tabdallah/capstone/1_Planning/Receipts/2018-02-15_CSI_3D_Printing.JPG

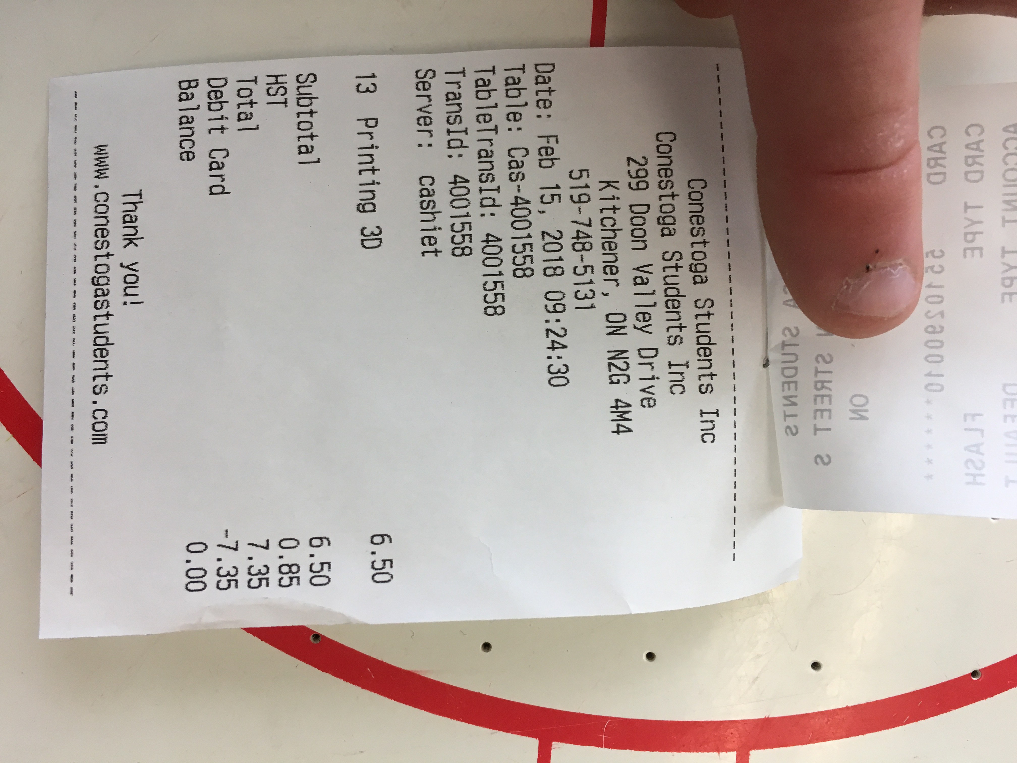
1_Planning/Receipts/2018-02-15_CSI_3D_Printing.JPG
