tabdallah/capstone/1_Planning/Receipts/2018-04-03_Sayal_Wiring_Terminals.JPG

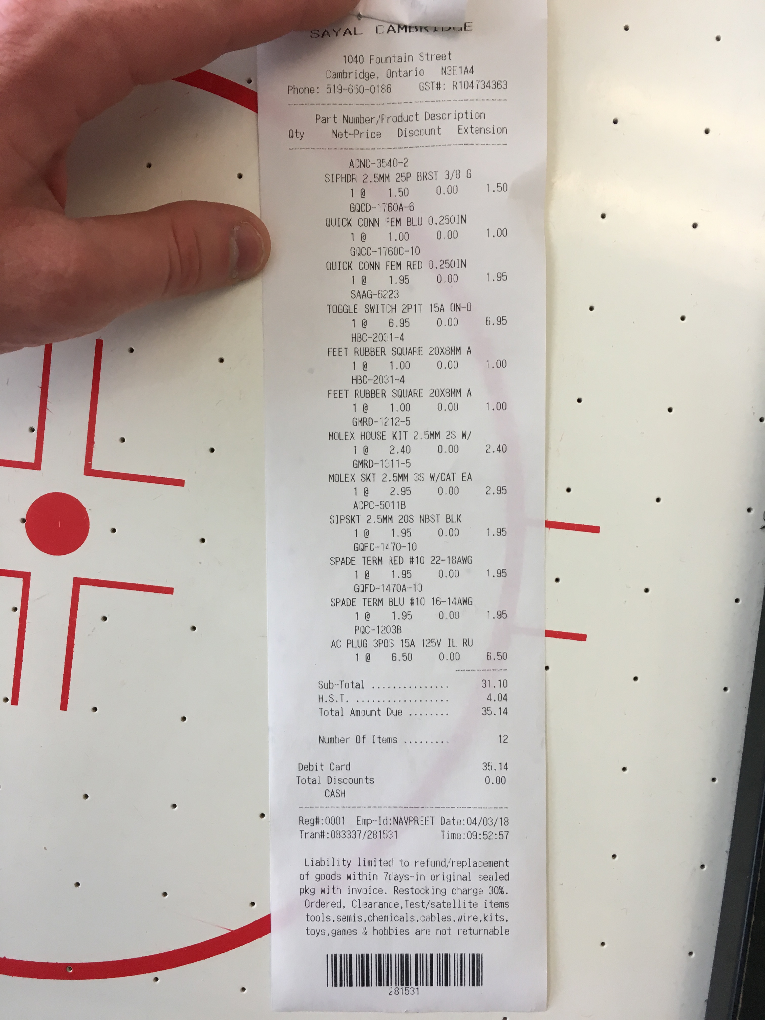
1_Planning/Receipts/2018-04-03_Sayal_Wiring_Terminals.JPG
