tabdallah/capstone/1_Planning/Week 30 Status Report.docx

Project Status Report – Week 30

2018-07-30

Project Name: ESE Capstone II Team Members: David Eelman, Stanislav Rashevskyi, Thomas Abdallah

Project Overall Status: Green

Status Overview:

Activity Title | Status (Last Week) | Status (This Week) | | Plan (Next Week)
| | Plan | Actual
Paddle Controller Prototyping Responsible: Thomas Due: Ongoing | Green | IR sensors installed. | IR sensors installed. | Install 24V-to-5V DCDC to replace 5V regulator
Puck Tracker Prototyping Responsible: David Due: Ongoing | Green | No activity planned | No activity | No activity planned
UI Prototyping Responsible: David Due: Ongoing | Yellow | Implement “Demo” for paddle controller. | Code cleanup | Implement “Demo” for paddle controller.
Master Controller Prototyping Responsible: Stan Due: Ongoing | Green | Refine new control strategies. | Refined new control strategies. | Code cleanup and full system testing.
