tabdallah/capstone/1_Planning/Week 26 Status Report.docx

Project Status Report – Week 26

2018-06-25

Project Name: ESE Capstone II Team Members: David Eelman, Stanislav Rashevskyi, Thomas Abdallah

Project Overall Status: Green

Status Overview:

Activity Title | Status (Last Week) | Status (This Week) | | Plan (Next Week)
| | Plan | Actual
Paddle Controller Prototyping Responsible: Thomas Due: Ongoing | Green | Finish PCB assembly Prototype motor control | Finished PCB assembly and prototyped motor control | Closed loop motor control
Puck Tracker Prototyping Responsible: David Due: Ongoing | Green | No activity planned | No activity | No activity planned
UI Prototyping Responsible: David Due: Ongoing | Green | Continue refinements to GUI “Goal Light” schematics & layout | Ordered mounting bracket for UI, completed goal light schematics, layout, and board soldered | Mount UI display, make second board for goal light
Master Controller Prototyping Responsible: Stan Due: Ongoing | Green | Finish supervisory control in the master controller | Almost finished supervisory control in the master controller | Error handling, PC communication
