tabdallah/capstone/1_Planning/Week 25 Status Report.docx

Project Status Report – Week 25

2018-06-18

Project Name: ESE Capstone II Team Members: David Eelman, Stanislav Rashevskyi, Thomas Abdallah

Project Overall Status: Green

Status Overview:

Activity Title | Status (Last Week) | Status (This Week) | | Plan (Next Week)
| | Plan | Actual
Paddle Controller Prototyping Responsible: Thomas Due: Ongoing | Yellow | Bring-up of PCB | One of each circuit tested | Finish PCB assembly Prototype motor control
Puck Tracker Prototyping Responsible: David Due: Ongoing | Green | Optimize calibration routine and mount fiducials | Optimized calibration routine | No activity planned
UI Prototyping Responsible: David Due: Ongoing | Green | Continue developing UI and investigated mounting solution for the touchscreen | Continued refinements to GUI Started “Goal Light” prototyping | Continue refinements to GUI “Goal Light” schematics & layout
Master Controller Prototyping Responsible: Stan Due: Ongoing | Yellow | Finish supervisory control in the master controller | Worked on supervisory control | Finish supervisory control in the master controller
