tabdallah/capstone/1_Planning/Week 20 Status Report.docx

Project Status Report – Week 20

2018-05-14

Project Name: ESE Capstone II Team Members: David Eelman, Stanislav Rashevskyi, Thomas Abdallah

Project Overall Status: Green

Status Overview:

Activity Title | Status (Last Week) | Status (This Week) | | Plan (Next Week)
| | Plan | Actual
Paddle Controller Prototyping Responsible: Thomas Due: Ongoing | Green | High power H-Bridge design. | Green | High power H-Bridge prototype spinning a motor. New encoder mounted.
Puck Tracker Prototyping Responsible: David Due: Ongoing | Green | No activity planned. | Green | No activity planned.
UI Prototyping Responsible: David Due: Ongoing | Green | Research touch screens. | Green | UI prototype bring-up.
Master Controller Prototyping Responsible: Stan Due: Ongoing | Green | Defense strategy implementation. | Green | Design state machines and error handling logic.
