tabdallah/capstone/1_Planning/Week 5 Status Report.docx

Project Status Report – Week 5

2018-02-16

Project Name: ESE Capstone I Team Members: David Eelman, Stanislav Rashevskyi, Thomas Abdallah

Project Overall Status: Green

Status Overview:

Activity Title | Status (Last Week) | Status (This Week) | | Plan (Next Week)
| | Plan | Actual
Specification and Plan Document Due: 2018-02-23 | Green | First draft of document complete. | Green | Final document complete.
Paddle Control Mechanical Prototyping Due: Ongoing Responsible: Thomas | Green | Start assembly | Yellow | All parts received. Assembly underway.
Puck Tracker Prototyping Due: Ongoing Responsible: All | Green | No activity planned | Green | No activity planned
