tabdallah/capstone/1_Planning/Semester 8 Capstone Final Presentation.pdf

# Capstone Project Final Presentation

# August 7, 2018 Electronic Systems Engineering (B.Eng) Conestoga College - Class of 2018

# Team

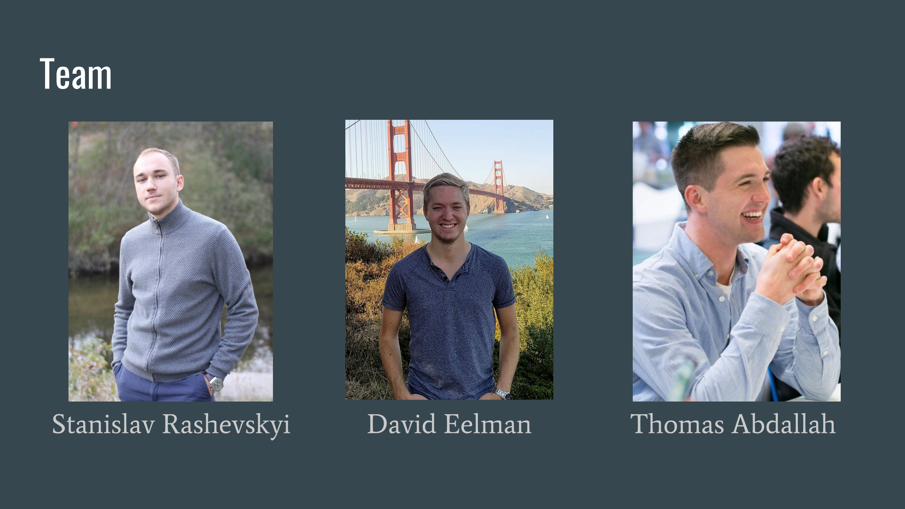
[picture p33: page 2]

Stanislav Rashevskyi | David Eelman | Thomas Abdallah

# Overview

# 1. Review Project Proposal 2. Project Status 3. Future Development 4. Demonstration

5. Q&A

# Project Proposal

# Project objective: Develop a robotic system capable of playing air hockey

against a human player.

# Air Hockey Robot Block Diagram - Proposal

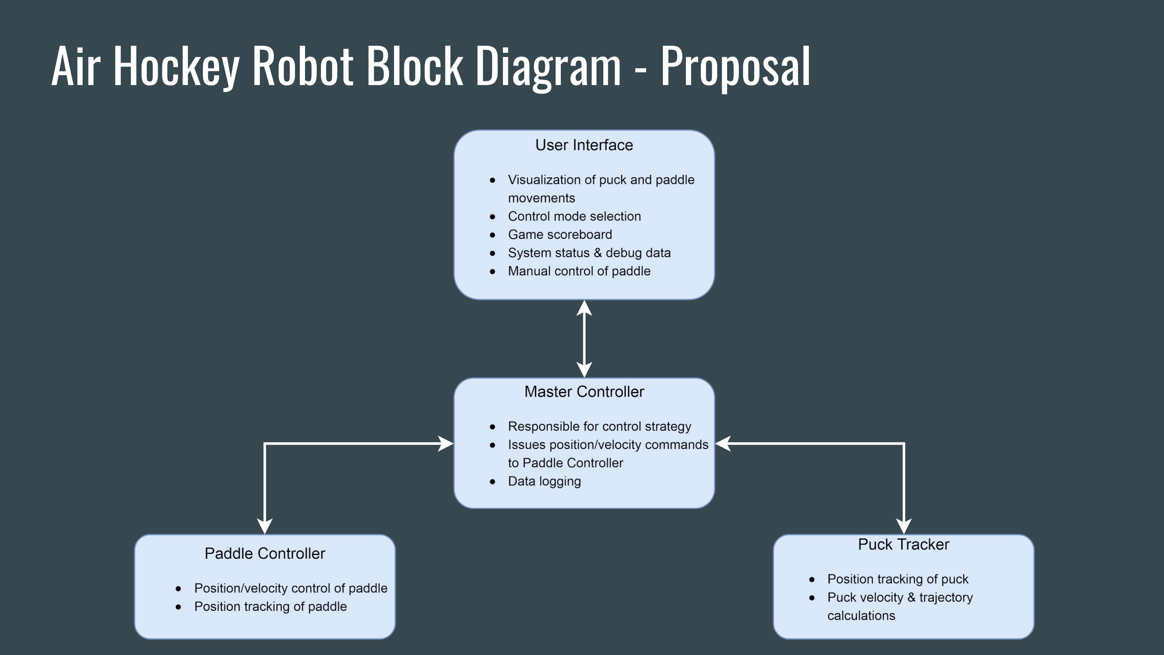
[picture p34: page 6]

# Project Plan

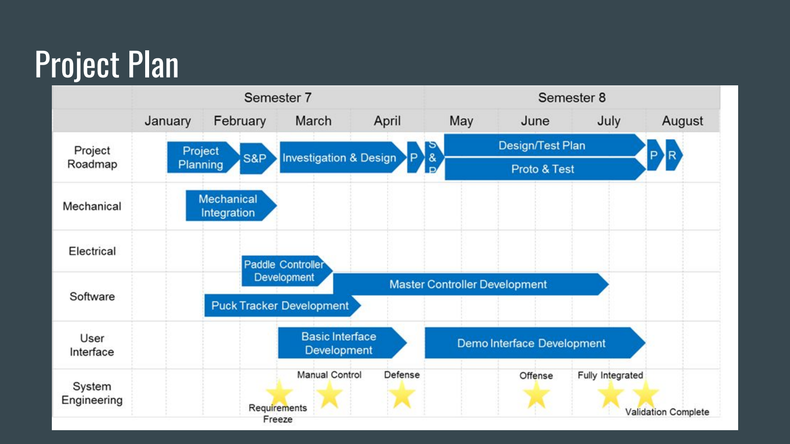
[picture p35: page 7]

# Project Status

# Project Status - Puck Tracker

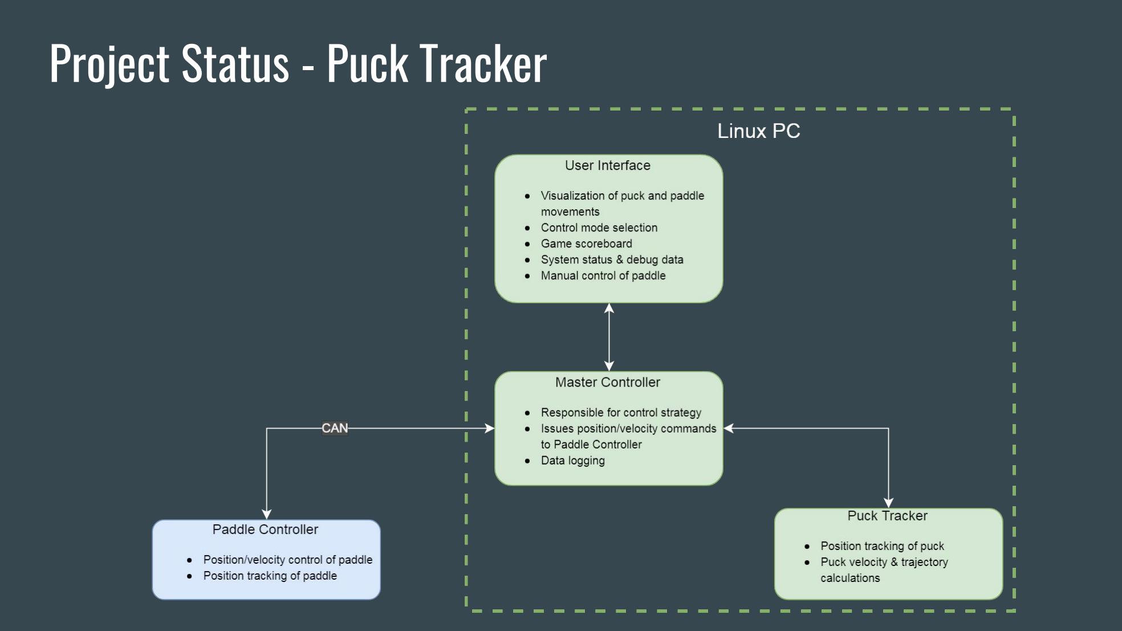
[picture p36: page 9]

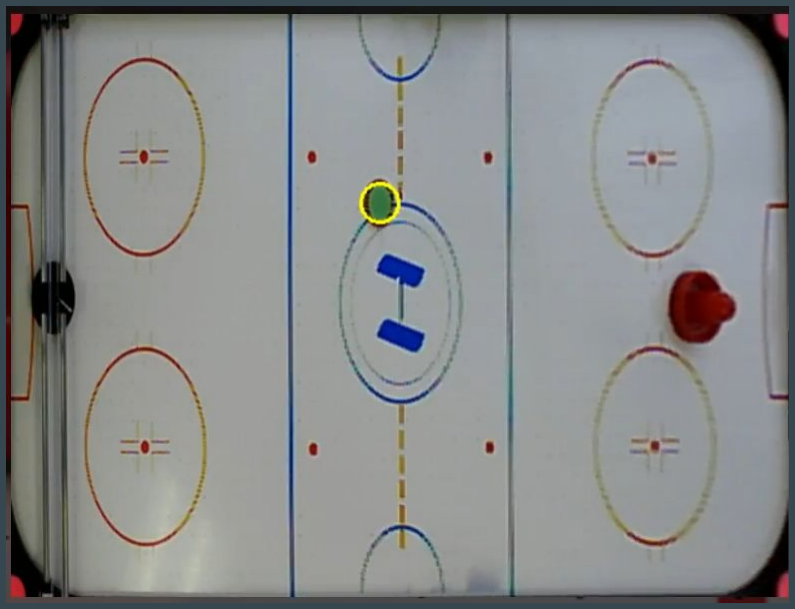
[picture p37: figure]

### - Vision based position tracking with OpenCV - Investigated alternatives (Magnets, Ultrasonic Sensors, etc.) - Key attributes for puck detection

- Color
- Area
- Radius

# Puck Tracker Implementation

# Puck Localization & Perspective Correction

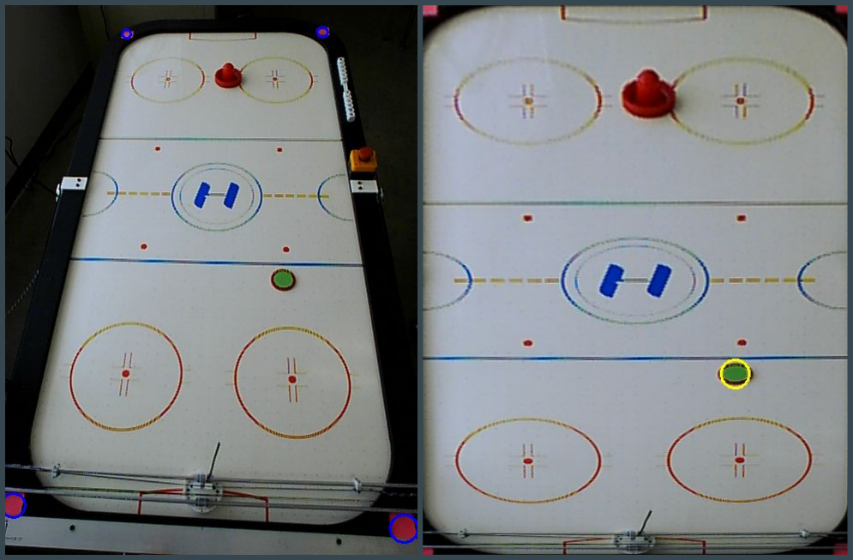
[picture p38: figure]

Goal

- Provide a “top down” view for consistent relative position detection
- Frame the playing surface

Methodology

- Identify 4 fiducials
- Calculate transformation matrix
- Warp image perspective
- Apply pixel to mm scaling factors for puck position
- Puck velocity = distance/time

# Adjusting for Varying Lighting Conditions

### - Ability to calibrate the computer vision system using UI sliders - Values saved to JSON file

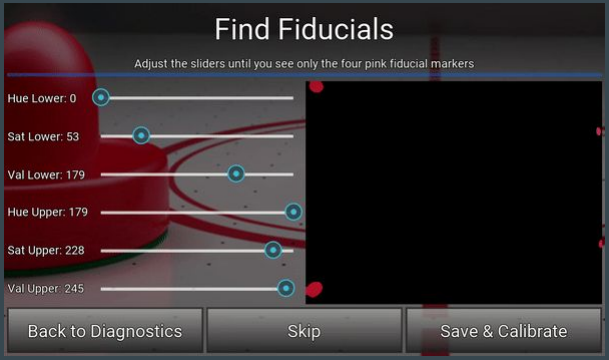
[picture p39: figure]

# Project Status - Paddle Controller

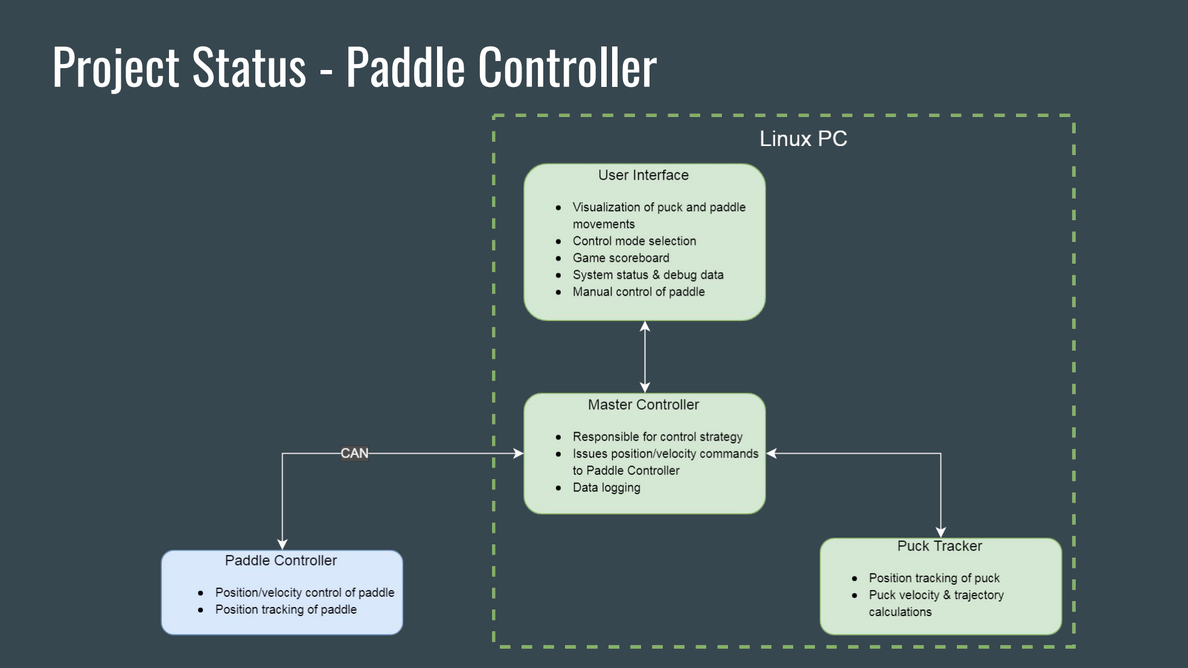
[picture p40: page 13]

# Paddle Controller High-Level Requirements

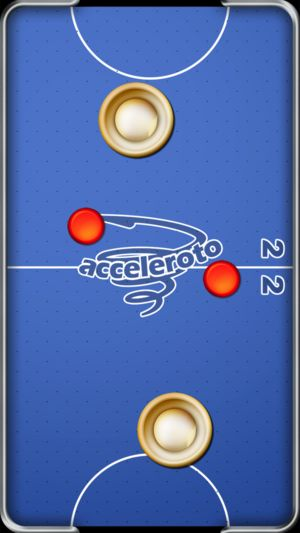
[picture p41: figure]

### 1. Accelerate the paddle to human-level speeds

### 2. Control paddle position to +/-5mm in two dimensions

### 3. Operate safely at high speeds in close proximity to humans

# System Modelling

### Step Response for High-Speed Prototype

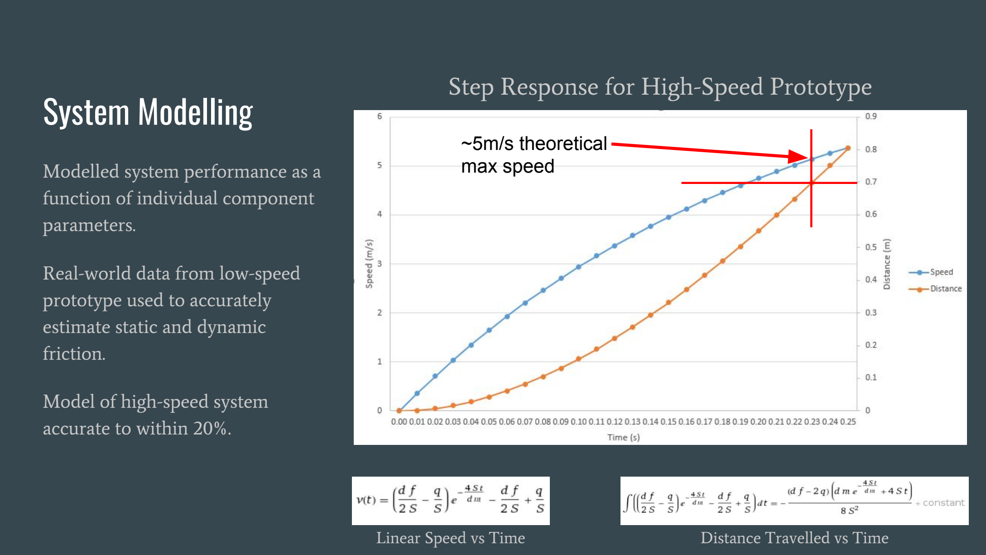
[picture p42: page 15]

Modelled system performance as a function of individual component parameters.

Real-world data from low-speed prototype used to accurately estimate static and dynamic friction.

Model of high-speed system accurate to within 20%.

Linear Speed vs Time | Distance Travelled vs Time

~5m/s theoretical
max speed

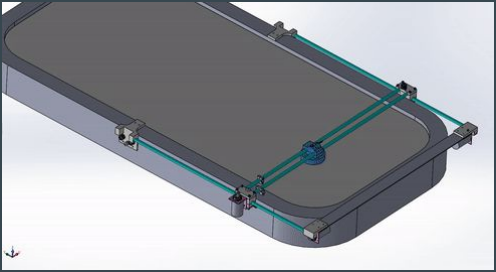
[picture p43: figure]

X-Axis Mechanism:

- 230W DC motor + encoder
- Linear rail + timing belt drive

Y-Axis Mechanism:

- 2 x 230W DC motors +
encoders
- Linear rail + timing belt drive
- Connecting rod to mechanically link left/right movement

# Mechanical Design

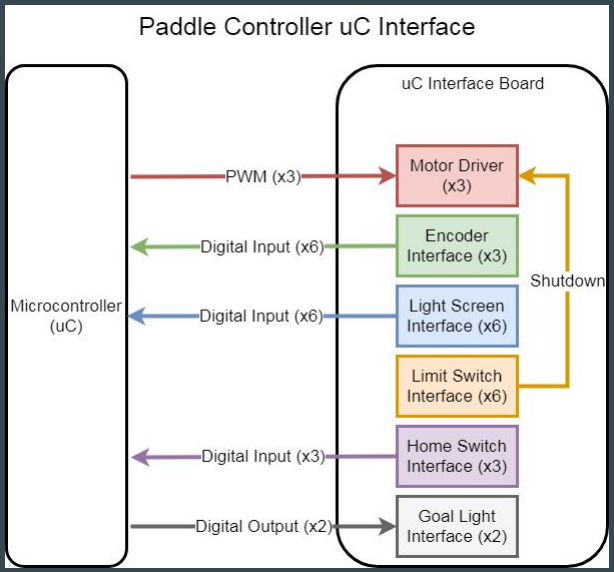
[picture p44: figure]

Off-the-shelf MicroController (HCS12)

- Communicates with Master Controller via CAN
- Closed-loop motor control with quadrature encoder feedback

Custom Circuit Board

- High-power motor drivers
- Sensor interfaces
- Hardware-based motor safety shutoff

# Electrical Design

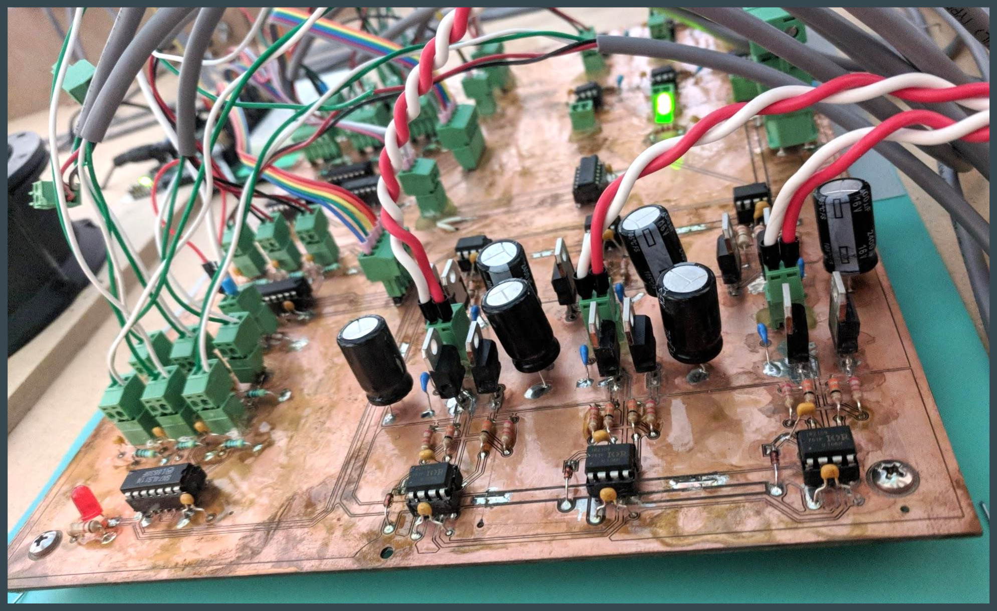
[picture p45: figure]

Off-the-shelf MicroController (HCS12)

- Communicates with Master Controller via CAN
- Closed-loop motor control with quadrature encoder feedback

Custom Circuit Board

- High-power motor drivers
- Sensor interfaces
- Hardware-based motor safety shutoff

# Electrical Design

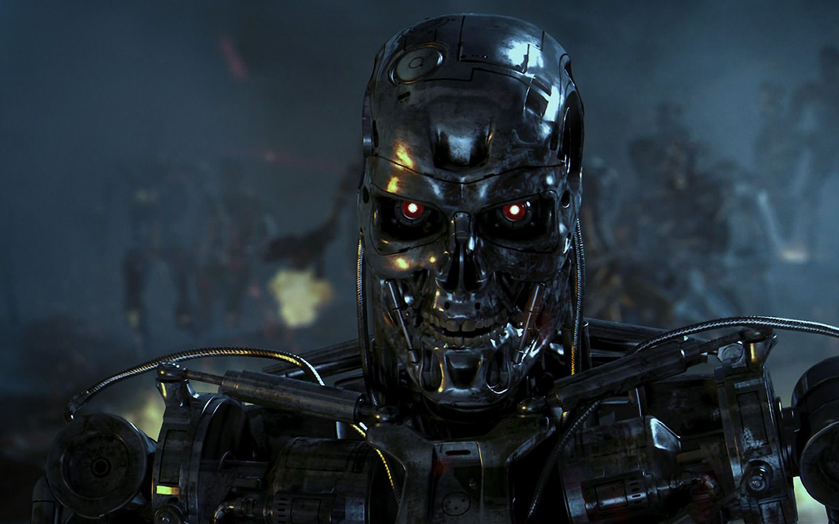
[picture p46: figure]

1. Software monitoring of motor torque
- Motors disabled if excessive resistance is detected
2. Light-screens surrounding robot
- Motors disabled if human enters robots playing area
3. Limit switches placed at end of robot travel
- Motors disabled in hardware if any limit switch pressed
4. Emergency-Stop mounted on human side of table
- Removes power to robot when pressed

# Safety Systems Design

# Implementation & Results

### Prototype constructed that meets

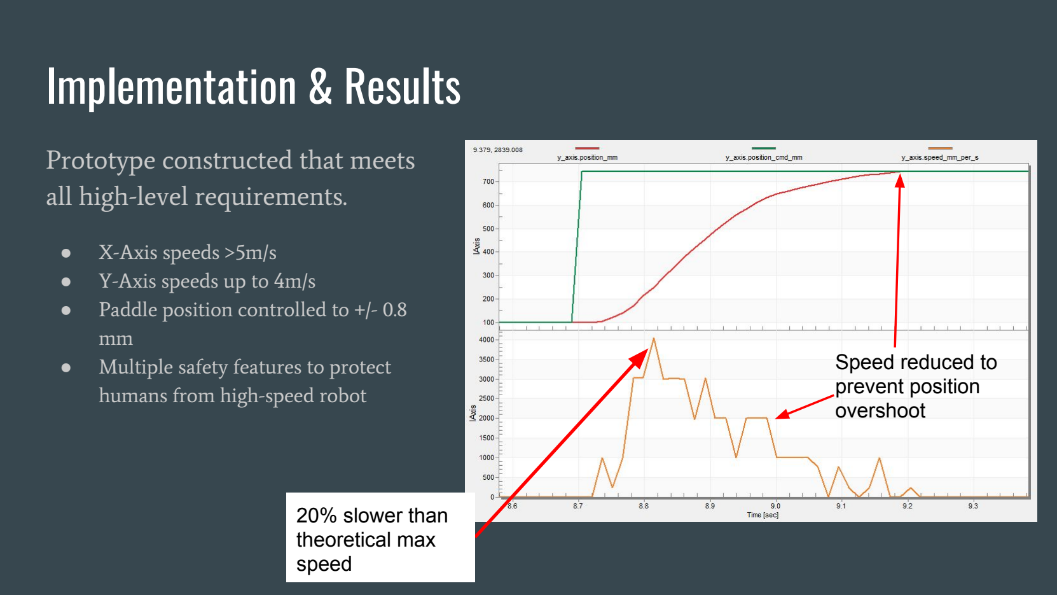
[picture p47: page 20]

all high-level requirements.

- X-Axis speeds >5m/s
- Y-Axis speeds up to 4m/s
- Paddle position controlled to +/- 0.8 mm
- Multiple safety features to protect humans from high-speed robot

20% slower than
theoretical max
speed

Speed reduced to
prevent position
overshoot

# Implementation & Results

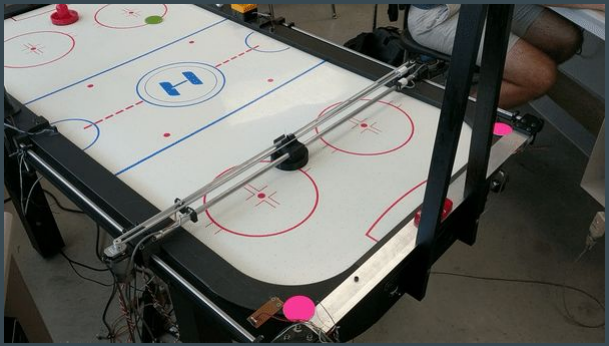
[picture p48: figure]

### Prototype constructed that meets

all high-level requirements.

- X-Axis speeds >5m/s
- Y-Axis speeds up to 4m/s
- Paddle position controlled to +/- 0.8 mm
- Multiple safety features to protect humans from high-speed robot

# Project Status - Master Controller

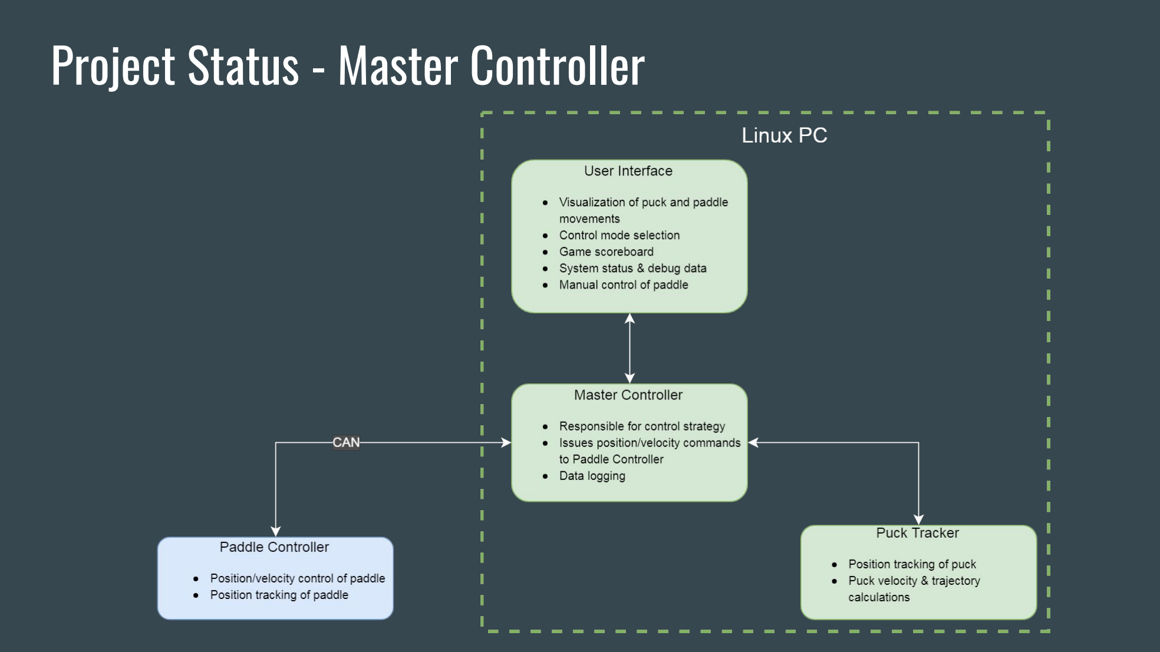
[picture p49: page 22]

# Master Controller Implementation

### - Central “brain” of the system

- Makes control decisions based on data from all other modules
- Issues movement commands to the robot

### - Multiple control strategies implemented

- User can select what strategy to play against

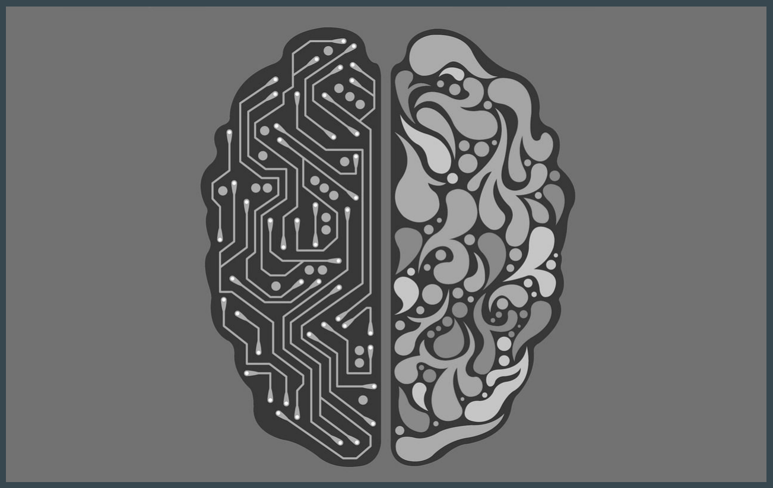
[picture p50: figure]

# Defense Control Strategy

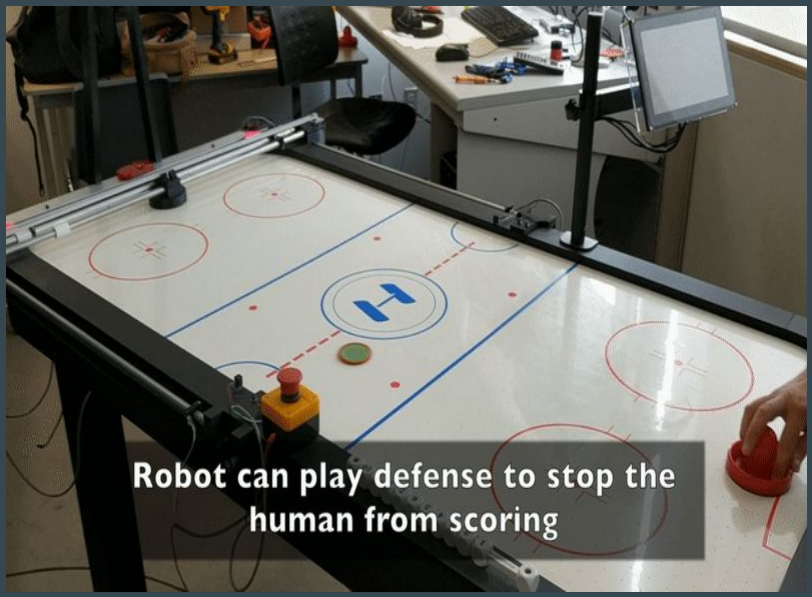
[picture p51: figure]

### - Objective: Do not let the human

score goals.

### - Puck trajectory calculated from position measurements

- Final position of puck predicted including bounces

### - Robot blocks puck at Y=0

- Returns puck to human if necessary

# Offense Control Strategy

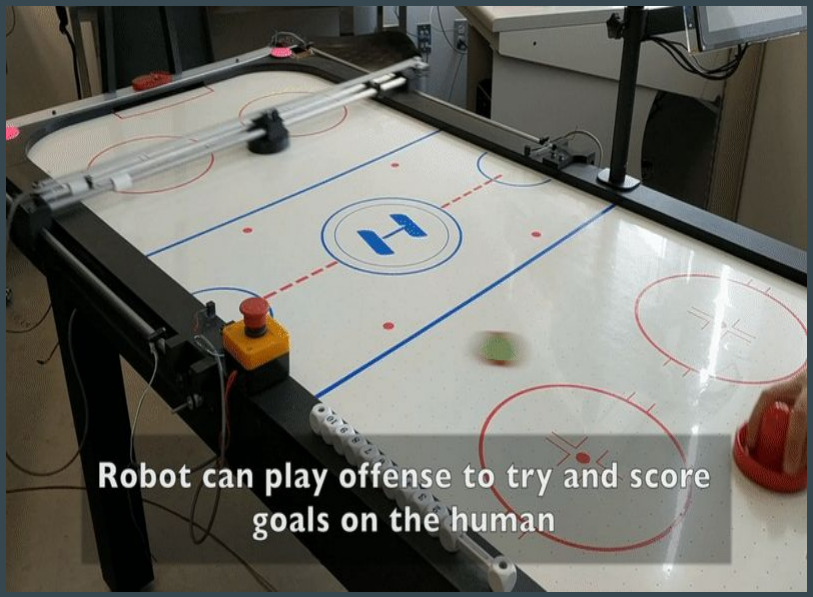
[picture p52: figure]

### - Objectives:

- Score goals on the human.
- Do not let the human score goals.

### - Robot attempts to hit the puck near the middle of the table

- Attempts to hit puck with max speed

### - Reverts to defensive movements if attack is not possible

# Master Controller Results

### - Robot can compete against human players - Robot is highly competent at defense

- Nearly impossible for humans to score when robot plays pure defense

### - Robot is capable of scoring goals

- More vulnerable on defense due to large distances travelled to attack puck

# Project Status - User Interface

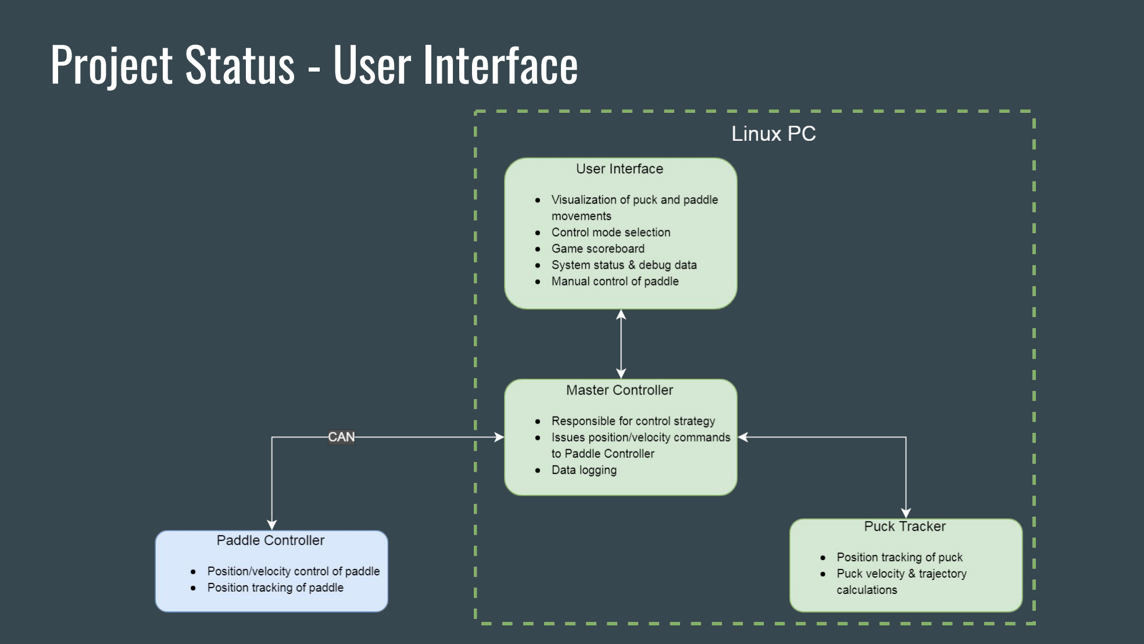
[picture p53: page 27]

# User Interface

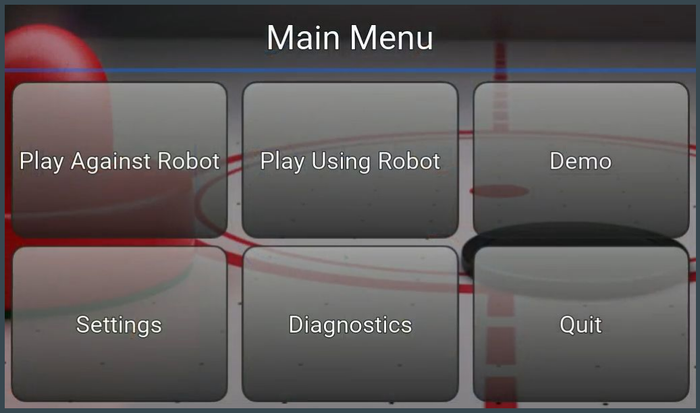
[picture p54: figure]

### - Kivy - Open source Python library - Implemented on 10.1” capacitive touchscreen - Provides user ability to:

- Control settings
- View system diagnostics
- Manually control robot
- Play against autonomous robot

# Visualizing the Robot

### - Provides a real time view of

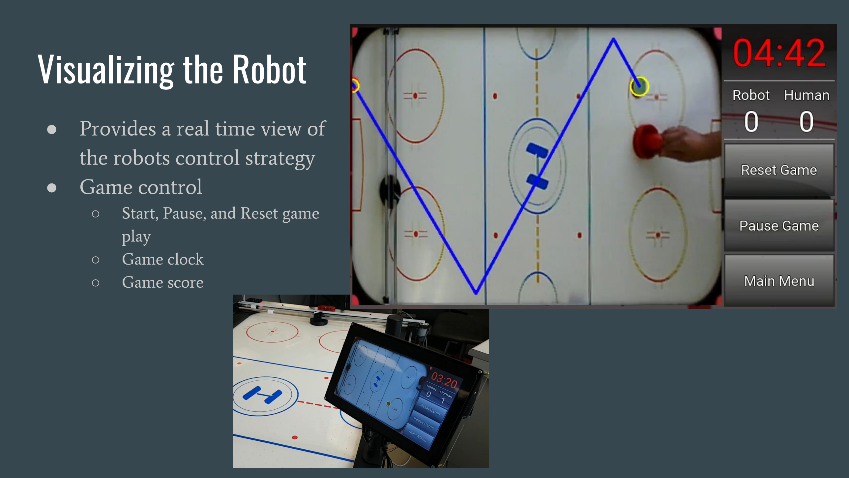
[picture p55: page 29]

### the robots control strategy - Game control

- Start, Pause, and Reset game play
- Game clock
- Game score

# Future Development

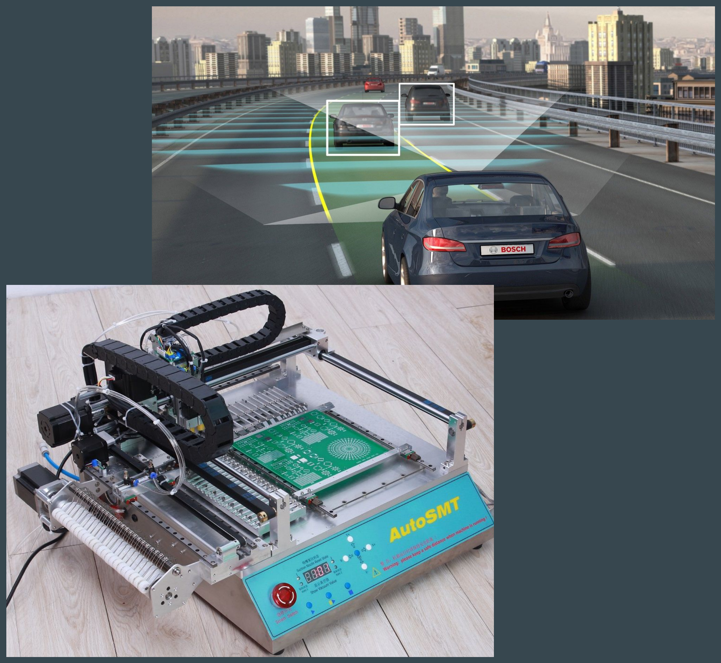
[picture p56: figure]

### - Autonomous vehicles

- Vision-based object detection and path prediction

### - Military defense

- Tracking and intercepting objects in motion

### - Advanced manufacturing

- High-speed position control
■ | Pick and place machines
■ | CNC machining
■ | 3D printing

# Future Development - Other Applications

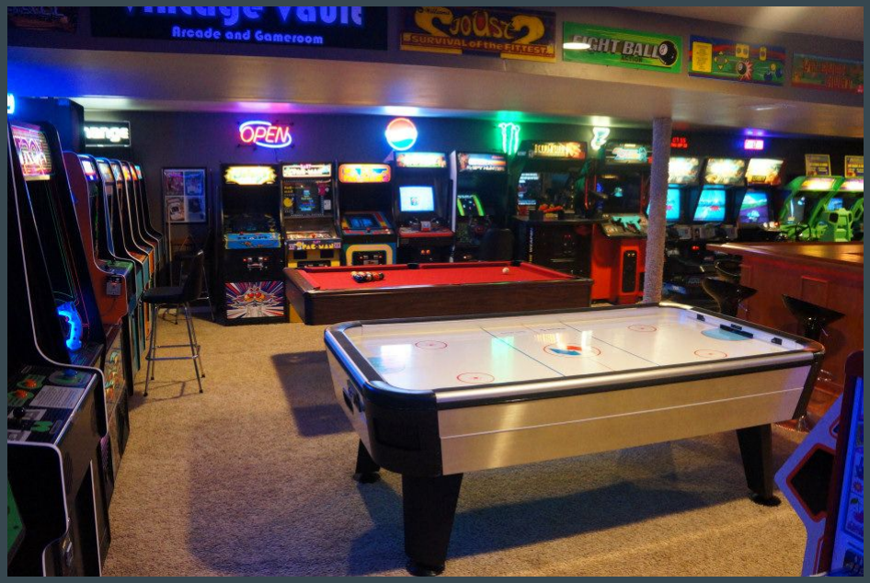
[picture p57: figure]

### - Prototype not designed for mass production

- Redesign needed reduce costs and further improve safety

### - Could be a popular game for arcades and bars

# Future Development - Air Hockey Robot

### Control strategy development:

# Future Development - AI

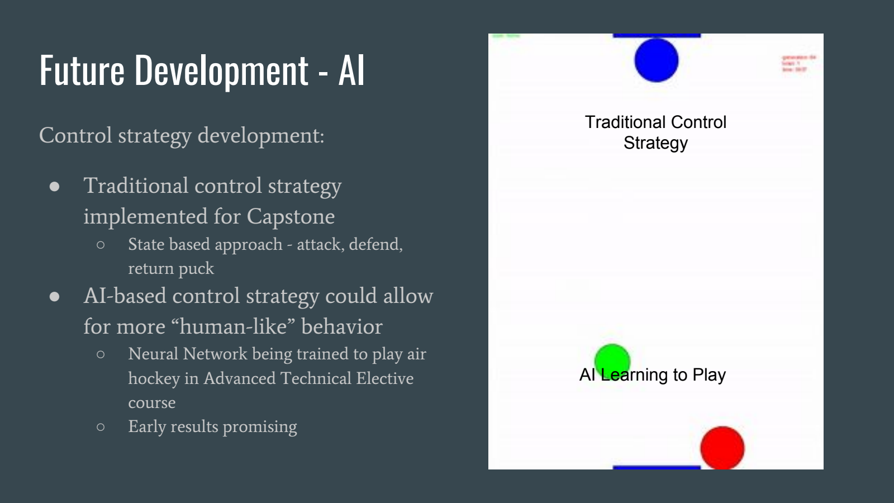
[picture p58: page 33]

### - Traditional control strategy implemented for Capstone

- State based approach - attack, defend, return puck

### - AI-based control strategy could allow for more “human-like” behavior

- Neural Network being trained to play air hockey in Advanced Technical Elective course
- Early results promising

Traditional Control
Strategy

AI Learning to Play

### Control strategy development:

# Future Development - AI

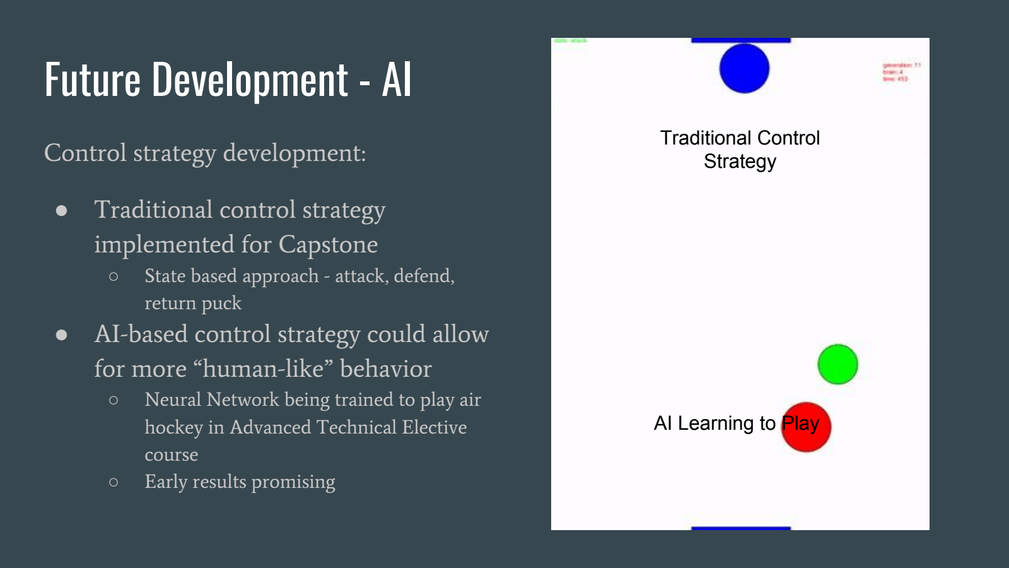
[picture p59: page 34]

### - Traditional control strategy implemented for Capstone

- State based approach - attack, defend, return puck

### - AI-based control strategy could allow for more “human-like” behavior

- Neural Network being trained to play air hockey in Advanced Technical Elective course
- Early results promising

Traditional Control
Strategy

AI Learning to Play

# Demonstration

# Project Demonstration Video

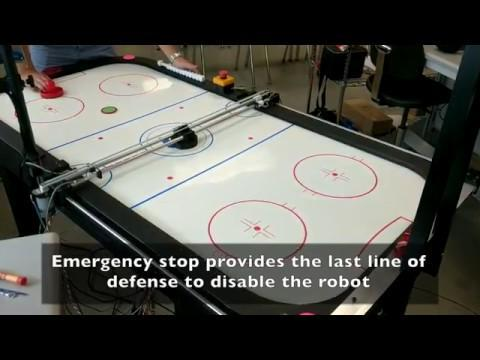
[picture p60: figure]

# Thank You!
