tabdallah/capstone/1_Planning/System_Interface_Design.xlsx

Sheet: Signal List
System Interface Design
PC = Paddle Controller |  | Note: MC receives all signals for logging purposes.
MC = Master Controller |  | All communication is routed through MC as a gateway. PC, PT, and UI do not directly communicate to each other.
PT = Puck Tracker
UI = User Interface
Signal | Transmitter | Receiver(s) | Comment
puck_position_mm_x | PT | MC, UI
puck_position_mm_y | PT | MC, UI
puck_velocity_mmps_x | PT | MC, UI
puck_velocity_mmps_y | PT | MC, UI
diagnostic_response | PT | MC, UI
pt_state_enum | PT | MC, UI
pt_error_enum | PT | MC, UI
signal_qualifier_placeholder | PT | MC, UI | i.e. confidence in signal accuracy
settings_placeholder | PT | MC, UI | Debug only
paddle_position_mm_x | PC | MC, UI
paddle_position_mm_y | PC | MC, UI
paddle_velocity_mmps_x | PC | MC, UI
paddle_velocity_mmps_y | PC | MC, UI
diagnostic_response | PC | MC, UI
motor_torque_units_x | PC | MC, UI | Debug only
motor_torque_units_y1 | PC | MC, UI | Debug only
motor_torque_units_y2 | PC | MC, UI | Debug only
limit_switch_state_x1 | PC | MC, UI | Debug only
limit_switch_state_x2 | PC | MC, UI | Debug only
limit_switch_state_y1 | PC | MC, UI | Debug only
limit_switch_state_y2 | PC | MC, UI | Debug only
limit_switch_state_y3 | PC | MC, UI | Debug only
limit_switch_state_y4 | PC | MC, UI | Debug only
light_screen_state_1 | PC | MC, UI | Debug only
light_screen_state_2 | PC | MC, UI | Debug only
light_screen_state_3 | PC | MC, UI | Debug only
light_screen_state_4 | PC | MC, UI | Debug only
pc_state_enum | PC | MC, UI
pc_error_enum | PC | MC, UI
settings_placeholder | PC | MC, UI | Debug only
manual_position_mm_x | UI | MC, PC | Direct position command to paddle controller
manual_position_mm_y | UI | MC, PC
control_mode_cmd_enum | UI | MC | Defense, offense, etc.
difficulty_cmd_enum | UI | MC | Easy, medium, hard.
diagnostic_request_pt | UI | MC, PT
diagnostic_request_pc | UI | MC, PC
diagnostic_request_mc | UI | MC
ui_state_enum | UI | MC
ui_error_enum | UI | MC
settings_placeholder | UI | MC | Debug only
mc_state_enum | MC | UI
mc_error_enum | MC | UI
settings_placeholder | MC | UI | Debug only
control_mode_enum | MC | UI | Defense, offense, etc.
difficulty_enum | MC | UI | Easy, medium, hard.
pc_state_cmd_enum | MC | PC
pt_state_cmd_enum | MC | PT
ui_state_cmd_enum | MC | UI
paddle_position_cmd_mm_x | MC | PC
paddle_position_cmd_mm_y | MC | PC
paddle_velocity_cmd_mmps_x | MC | PC
paddle_velocity_cmd_mmps_y | MC | PC

Sheet: CAN Messages
CAN Message Layout
Message Name | Transmitter | Receiver | Message ID (Hex) | DLC | Byte 7 |  |  |  |  |  |  |  | Byte 6 |  |  |  |  |  |  |  | Byte 5 |  |  |  |  |  |  |  | Byte 4 |  |  |  |  |  |  |  | Byte 3 |  |  |  |  |  |  |  | Byte 2 |  |  |  |  |  |  |  | Byte 1
 |  |  |  |  | 7 | 6 | 5 | 4 | 3 | 2 | 1 | 0 | 7 | 6 | 5 | 4 | 3 | 2 | 1 | 0 | 7 | 6 | 5 | 4 | 3 | 2 | 1 | 0 | 7 | 6 | 5 | 4 | 3 | 2 | 1 | 0 | 7 | 6 | 5 | 4 | 3 | 2 | 1 | 0 | 7 | 6 | 5 | 4 | 3 | 2 | 1 | 0 | 7 | 6 | 5 | 4 | 3 | 2 | 1
MC_Cmd_PC | MC | PC | 0x100 | 8 | mc_cmd_pc_debug |  |  |  |  |  |  |  | *(empty)* |  |  |  |  |  |  |  | state_cmd |  |  |  |  |  |  |  |  |  |  |  | motor_speed_cmd_y |  | motor_speed_cmd_x |  | pos_cmd_y_mm |  |  |  |  |  |  |  |  |  |  |  |  |  |  |  | pos_cmd_x_mm
PC_Status | PC | MC | 0x101 | 8 | pc_status_debug |  |  |  |  |  |  |  | error |  |  |  |  |  |  |  | state |  |  |  |  |  |  |  | goal_scored |  |  |  | motor_speed_y |  | motor_speed_x |  | pos_y_mm |  |  |  |  |  |  |  |  |  |  |  |  |  |  |  | pos_x_mm
 |  |  |  |  |  | NOTE: If you edit Messages/Signals here, make sure the changes match Enums in settings.JSON file \capstone\6_User_Interface\1_Software\4_Json\settings.json

Sheet: MC_Cmd_PC Signals
MC_Cmd_PC - Signal Descriptions
Signal Name | Length (Bits) | Values | Description
pos_cmd_x_mm | 16 | 0 to 65536 | MC signal that commands PC to change X-axis paddle position in mm
pos_cmd_x_mm | 16 | 0 to 65536 | MC signal that commands PC to change Y-axis paddle position in mm
motor_speed_cmd_x | 2 | 0 = Slow 1 = Medium 2 = Fast | MC signal that commands PC to change X-axis motor speed
motor_speed_cmd_y | 2 | 0 = Slow 1 = Medium 2 = Fast | MC signal that commands PC to change Y-axis motor speed
state_cmd | 4 | 0 = OFF 1 = Calibration 2 = ON 3 = Clear_Error | MC signal that commands PC to change state
NOTE: If you edit Messages/Signals here, make sure the changes match Enums in settings.JSON file \capstone\6_User_Interface\1_Software\4_Json\settings.json

Sheet: PC_Status Signals
PC_Status - Signal Descriptions
Signal Name | Length (Bits) | Values | Description
pos_x_mm | 16 | 0 to 65536 | PC signal with current X-axis paddle position in mm
pos_y_mm | 16 | 0 to 65536 | PC signal with current Y-axis paddle position in mm
motor_speed_x | 2 | 0 = Slow 1 = Medium 2 = Fast | PC signal with current X-axis motor speed
motor_speed_y | 2 | 0 = Slow 1 = Medium 2 = Fast | PC signal with current PC Y-axis motor speed
goal_scored | 4 | 0 = None 1 = Human scored 2 = Robot scored | PC signal describing who scored the goal
state | 4 | 0 = OFF 1 = Calibration 2 = ON 3 = Error | PC signal with its current state
error | 4 | 0 = none 1 = … | PC signal with its current error (if any)
NOTE: If you edit Messages/Signals here, make sure the changes match Enums in settings.JSON file \capstone\6_User_Interface\1_Software\4_Json\settings.json
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
