tabdallah/capstone/5_Master_Controller/2_Reference_Material/Shared_CAN_Protocol_Proposal.xlsx

Sheet: Network Nodes
Shared CAN Protocol - Network Nodes
ECU Name | Acronym | Functions
Supervisory Controller | SC | 1. Process messages from all nodes. 2. Command EC to move car to specific floor.
Elevator Controller | EC | 1. Process command from SC & move car to specific floor. 2. Report current car position to all nodes.
Car Controller | CC | 1. Report state of elevator car door. 2. Report requested floor from elevator car. 3. Display current elevator position.
Floor 1 Controller | F1 | 1. Request elevator car. 2. Display current elevator position.
Floor 2 Controller | F2 | 1. Request elevator car. 2. Display current elevator position.
Floor 3 Controller | F3 | 1. Request elevator car. 2. Display current elevator position.

Sheet: Message Layout
Shared CAN Protocol - Message Layout
Message Name | Transmitter | Receiver(s) | Message ID (Hex) | DLC
SC_Cmd_To_EC | SC | EC | 0x100 | 1
EC_Status | EC | All | 0x101 | 1
CC_Status | CC | SC | 0x200 | 1
F1_Status | F1 | SC | 0x201 | 1
F2_Status | F2 | SC | 0x202 | 1
F3_Status | F3 | SC | 0x203 | 1

Sheet: Signal Descriptions
Shared CAN Protocol - Signal Descriptions |  |  |  | Convention: All signal names start with the Transmitting node's acronymn.
Signal Name | # of Bits | Value Descriptions | Comment
SC_Enable | 1 | 0 = Disable Elevator 1 = Enable Elevator | SC command to enable/disable elevator.
SC_Floor_Cmd | 2 | 0 = Request None 1 = Request Floor 1 2 = Request Floor 2 3 = Request Floor 3 | SC command to EC for requested floor. Always init to 0 so elevator doesn't start moving right away.
EC_Status | 1 | 0 = Disable Elevator 1 = Enable Elevator | EC reporting to SC it's state (enabled/disabled).
EC_Car_Pos | 2 | 0 = Car is moving 1 = Floor 1 2 = Floor 2 3 = Floor 3 | EC reporting to all modules the current location of the elevator car.
CC_Door_State | 1 | 0 = Door Open 1 = Door Closed | CC reporting state of the elevator car door to the SC.
CC_Floor_Req | 2 | 0 = Request None 1 = Request Floor 1 2 = Request Floor 2 3 = Request Floor 3 | CC request to SC for desired floor.
F1_Call_Req | 1 | 0 = Door Open 1 = Request Car | Floor 1 requesting the elevator car.
F2_Call_Req | 1 | 0 = Door Open 1 = Request Car | Floor 2 requesting the elevator car.
F3_Call_Req | 1 | 0 = Door Open 1 = Request Car | Floor 3 requesting the elevator car.
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
