tabdallah/capstone/1_Planning/Week 29 Status Report.docx

Project Status Report – Week 29

2018-07-23

Project Name: ESE Capstone II Team Members: David Eelman, Stanislav Rashevskyi, Thomas Abdallah

Project Overall Status: Green

Status Overview:

Activity Title | Status (Last Week) | Status (This Week) | | Plan (Next Week)
| | Plan | Actual
Paddle Controller Prototyping Responsible: Thomas Due: Ongoing | Green | Upgraded mechanical design. IR sensors installed. | Upgraded mechanical design. Implemented new paddle control method. | IR sensors installed.
Puck Tracker Prototyping Responsible: David Due: Ongoing | Green | No activity planned | No activity | No activity planned
UI Prototyping Responsible: David Due: Ongoing | Green | Implement “Demo” for paddle controller. Work on UI robustness. Install goal lights. | Improved UI code | Implement “Demo” for paddle controller.
Master Controller Prototyping Responsible: Stan Due: Ongoing | Green | Improve offense control strategy | New offense & defense control strategies implemented | Refine new control strategies.
