tabdallah/capstone/7_Not_Capstone/Engineering Economics Course Project.pdf

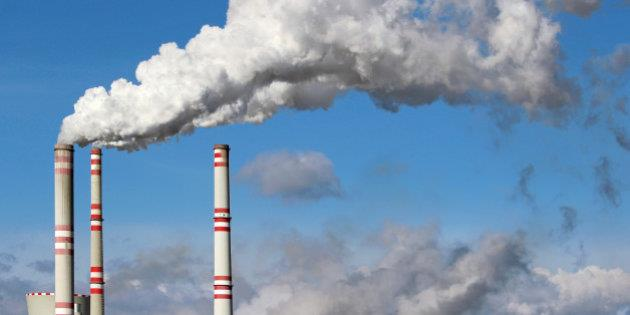
[picture p85: figure]

# Engineering Economics Course Project

### CARBON TAXES TO MINIMIZE CO2 EMISSIONS IN A MICRO-GRID

Prepared for ECON74000, Winter 2018 David Eelman (6365316)
Stanislav Rashevskyi (7028178) Thomas Abdallah (7141518)

ECON74000 Course Project | Eelman, Rashevskyi, Abdallah

## Contents

## Introduction

This report will identify the best energy production option and associated carbon

tax price to incent the adoption of renewable energy sources and minimize the use of

diesel fuel generation in a micro-grid application for a remote Northern Ontario

community. The analysis will consider four energy production options (Table 1) that

could be purchased and become operational in 2019. These options include a mix of wind,

solar, and diesel energy production. The analysis for this project will consider the present

worth, the incremental internal rate of return, and the equivalent annual cost for each

energy production option. A tax (dollar per kilogram of CO2 emissions) will be proposed

that shall minimize diesel fuel generation and increase the feasibility of the options that

include renewable energy sources. The same analysis will be performed using the tax rules

of the United Kingdom to provide comparison on the feasibility of the project in that

country.

Table 1 - Generation Options

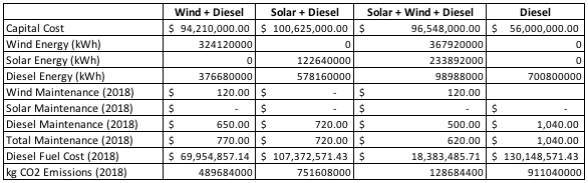
[picture p86: figure]

## Problem Statement

This report will determine an appropriate CO2 tax to be applied that will minimize

the use of diesel fuel generation in a theoretical micro-grid application in Northern

Ontario and compare the feasibility of this project to the same project if it were

undertaken in the United Kingdom.

Assumptions

1. Yearly maintenance cost increase is 5% of the previous year’s maintenance cost.
2. Yearly CO2 emissions increase is 2% of the previous year’s CO2 emissions.
3. Yearly diesel fuel cost increase is 2% of the previous year’s diesel fuel cost.
4. No tax credits or other government incentives for any generation option.
5. 100% utilization rate for all generation options, i.e. running at maximum power

output 24 hours a day, 365 days a year.

6. Same cost of financing for all generation options.

## Economic Analysis

Levelized Cost of Energy (LCOE)

The concept of LCOE represents the total cost per unit of energy of constructing

and operating a power plant over its lifetime (U.S. Energy Information Administration,

2018). LCOE provides a convenient mechanism for comparing the competitiveness of

different generation technologies. In this report we only consider the capital costs, fuel

costs, and maintenance costs when evaluating each generation option, although a full

LCOE analysis would include the cost of financing, operation, and utilization rates for

each generation option.

Present Worth Analysis

The present worth of each option from Table 1 was conducted utilizing the

corporate tax rate in Canada of 36.1% (Pearson Canada, Inc., 2017), a before-tax MARR of

20%, and a Capital Cost Allowance (CCA) of 20% (Class 8). After-tax MARR is calculated

to be 12.78% as shown below.

MARRafter−tax = MARRbefore−tax ∗ (1 − tax rate) = 20% ∗ (1 − 0.361) = 12.78%

The Capital Tax Factor (CTF) is calculated as shown below.

CTF = 1 −

(tax rate) ∗ (CCA) ∗ (1 +

MARRafter−tax
2

)

(MARRafter−tax + CCA) ∗ (1 + MARRafter−tax)

= 0.792

The present worth of the capital cost for each generation option is calculated as follows.

Present WortℎCapital Cost = CTF ∗ Capital Cost

Table 2 - Present worth of capital cost

The present worth for all annuities associated with each generation option are

calculated as follows. Table 3 shows the present worth of all annuities over a 20 year

period for each option. Appendix A shows the Excel calculations used to generate these

values.

Present WortℎAnnuities = (Income − Expenses) ∗ (1 − tax rate) ∗ (

P
F

, MARRafter−tax, 20)

| Wind + Diesel | Solar + Diesel | Solar + Wind + Diesel | Diesel
Capital Cost | $ (94,210,000.00) | $ (100,625,000.00) | $ (96,548,000.00) | $ (56,000,000.00)
CTF | 0.792 | 0.792 | 0.792 | 0.792
Present Worth | $ (74,614,320.00) | $ (79,695,000.00) | $ (76,466,016.00) | $ (44,352,000.00)

Table 3 - Present worth of annuities

The total present worth for each option is sum of the present worth of the

annuities and the present worth of the capital cost. Table 4 shows the total present worth

after taxes for each option with no carbon tax implemented.

Table 4 - Total Present Worth

The Wind + Solar + Diesel option as the highest total present worth even without

the inclusion of a carbon tax. When applying a carbon tax, the present worth of all

projects is reduced, but the Wind + Solar + Diesel project is still the most valuable.

Therefore, based on the present worth analysis no carbon tax is needed to incent the

adoption of a renewable energy project.

| Wind + Diesel | Solar + Diesel | Solar + Wind + Diesel | Diesel
Annuities Present Worth | $ 1,209,514,970.74 | $ 1,017,455,033.24 | $ 1,474,225,034.77 | $ 900,559,788.91

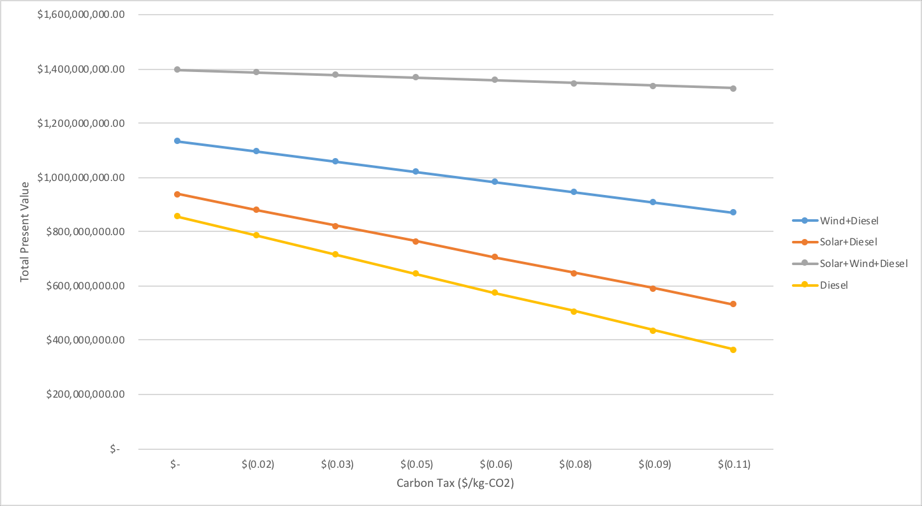
[picture p87: figure]

Figure 1 - Present Value vs Carbon Tax Rate

If we consider the same analysis conducted in the United Kingdom with a tax rate

of 28% (after-tax MARR of 14.4%) and using straight-line depreciation to determine the

tax savings on the capital investment we see the same results with no carbon tax being

required.

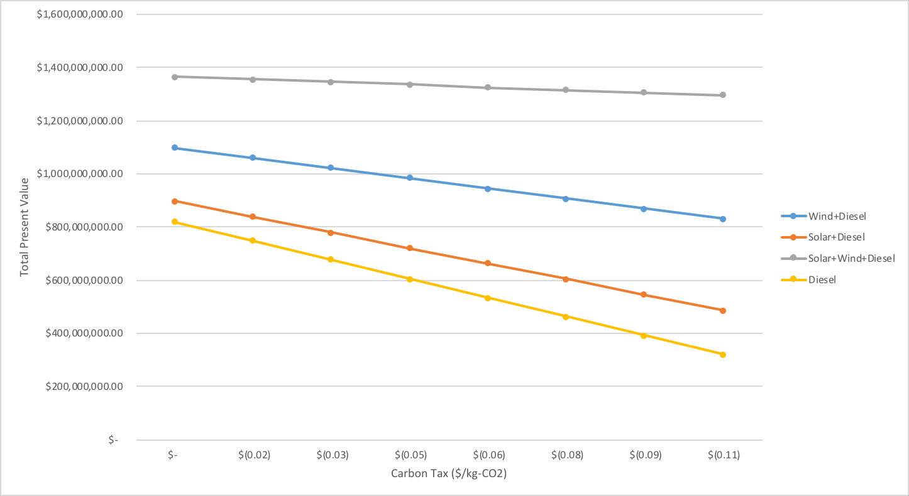
[picture p88: figure]

Figure 2 - Present Value versus Carbon Tax Rate in the United Kingdom

Incremental Internal Rate of Return Analysis

Analysis begins by calculating the incremental cash flows for each option without

a carbon tax implemented (Appendix B). The Diesel only option is selected to begin with

as it has the lowest capital cost. The option with the next lowest capital cost is Wind +

Diesel generation. The incremental IRR for this option over Diesel only is 200.9% which is

greater than the after-tax MARR so this option is chosen. The option with the next lowest

capital cost is Wind + Solar + Diesel generation. The incremental IRR for this option over

Wind + Diesel is $2787.10 which is much greater than the after-tax MARR so this option is chosen. The incremental cash flows for Solar + Diesel over Wind + Solar + Diesel are all

negative so this option is rejected. Therefore, by the incremental IRR method the Wind +

Solar + Diesel generation option should be selected and no carbon tax is necessary.

If we consider the same analysis conducted in the United Kingdom with a tax rate

of 28% (after-tax MARR of 14.4%) and using straight-line depreciation to determine the

tax savings on the capital investment we also find that no carbon tax is necessary to incent

the adoption of renewable generation options as the Wind + Solar + Diesel option is

chosen through the incremental IRR method with no carbon tax applied.

Equivalent Annual Cost Analysis

The equivalent annual cost (EAC) of each option from Table 1 was conducted

before-tax, with a MARR of 20%, for a 20-year period, including all assumptions stated

above in the Assumptions section of the report.

The general formula for EAC calculation is shown below.

EACtotal = EACcapital cost + EACmaintnance + EACdiesel cost + EACCO2 tax cost,

where:

EACcapital cost = Capital cost ∗ (A\P, MARR, 20)

EACmaintnance = Total maintnance + maintnance raise ∗ (A\G, MARR, 20)

EACdiesel cost = Diesel cost ∗ (P\A, diesel inflation, MARR, 20) ∗ (A\P, MARR, 20)

EACCO2 tax cost = CO2 tax cost ∗ (P\A, CO2 output raise, MARR, 20) ∗ (A\P, MARR, 20)

Table 5 shows the EAC results before taxes for each option with none and 0.20

$/kg of carbon tax. Appendix B shows the Excel calculations used to generate these values.

Table 5 - EAC calculations for each option

The Wind + Solar + Diesel option has the lowest equivalent annual cost even without the

inclusion of a carbon tax. When applying a carbon tax, the EACs of all projects is

increased, but the Wind + Solar + Diesel project is still the most valuable. Therefore,

based on the EAC analysis no carbon tax is needed to incent the adoption of a renewable

energy project.

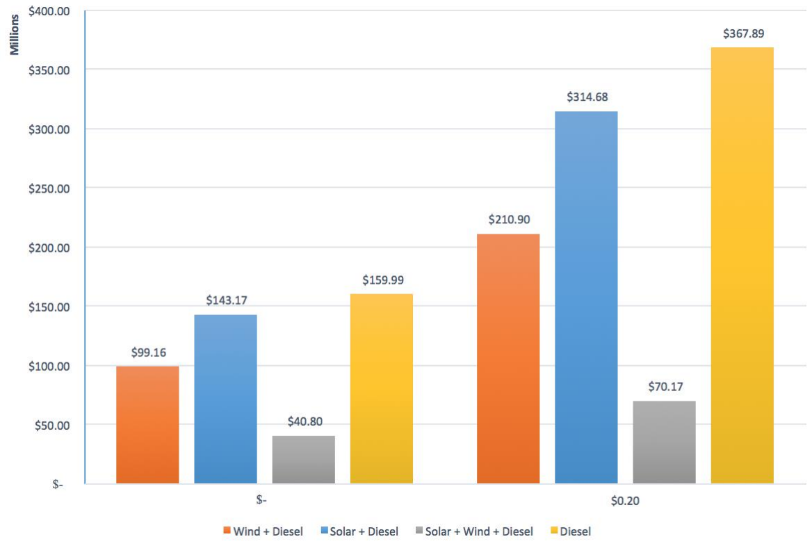
[picture p89: figure]

Figure 3 - EACs vs Carbon Tax

Factors Missing From Analysis

This analysis does not consider any government incentives for renewable projects

such as tax credits for renewable projects or discounted financing options which could

help to reduce the cost of the proposed carbon tax. This analysis only considers the

maintenance and fuel costs for each plant type but does not account for any other

operating costs which may impact the total cost of each plant. This analysis only

considers carbon produced during the operation of each plant type and does not account

for the carbon produced when manufacturing the plant.

## Recommendations & Conclusion

In conclusion, based on our analysis no carbon tax is necessary to incent the

adoption of renewable generation options for this project. Our assumptions of a 100%

utilization rate and no other government incentives simplify the analysis but may not be

representative of the conditions experienced during actual implementation.

## Appendix A – Present Worth Analysis Calculations

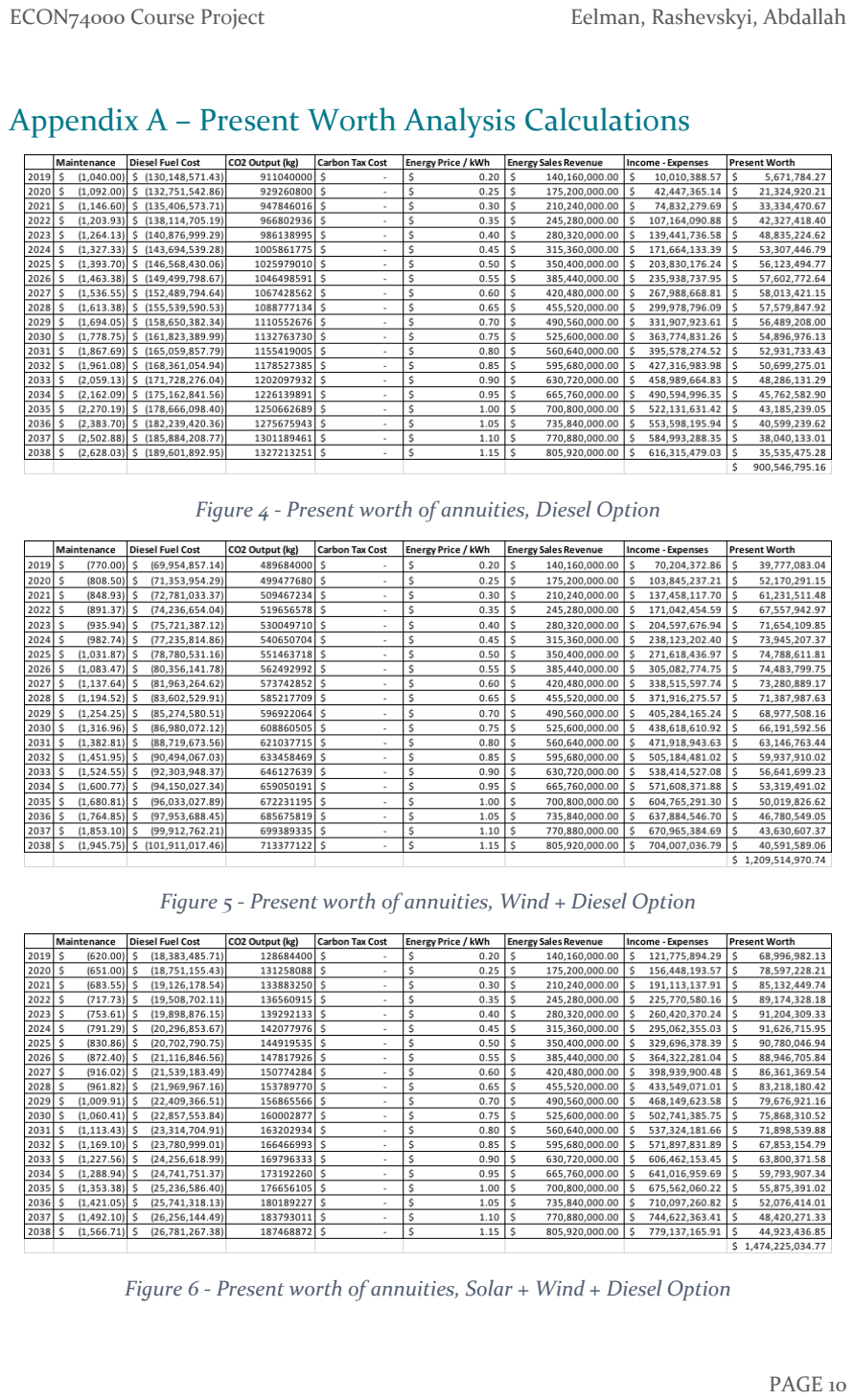
[picture p90: page 11]

Figure 4 - Present worth of annuities, Diesel Option

Figure 5 - Present worth of annuities, Wind + Diesel Option

Figure 6 - Present worth of annuities, Solar + Wind + Diesel Option

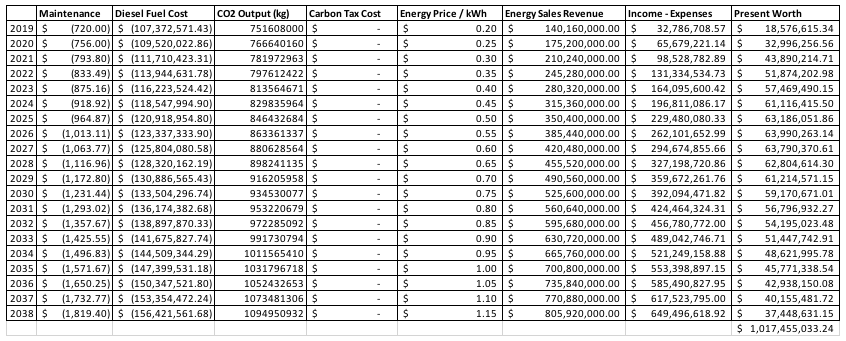
[picture p91: figure]

Figure 7 - Present worth of annuities, Solar + Diesel Option

## Appendix B – Equivalent Annual Cost Analysis Calculations

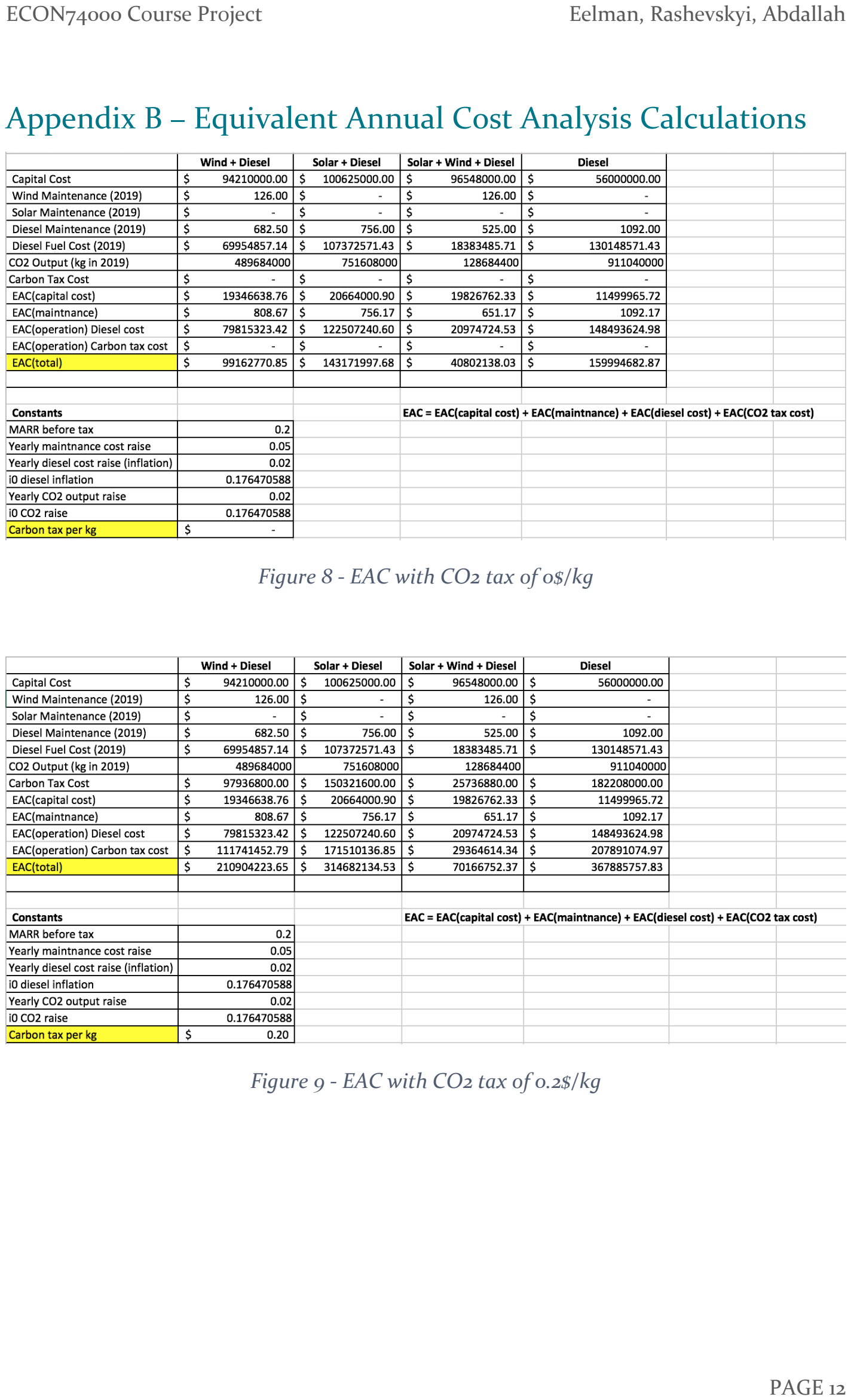
[picture p92: page 13]

Figure 8 - EAC with CO2 tax of 0$/kg

Figure 9 - EAC with CO2 tax of 0.2$/kg

## Appendix C – Incremental IRR Analysis Calculations

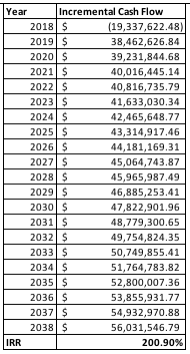
[picture p93: figure]

Figure 10 - Incremental IRR for Wind + Diesel vs. Diesel, No Carbon Tax

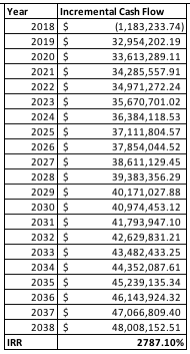
[picture p94: figure]

Figure 11 - Incremental IRR for Wind + Solar + Diesel vs. Wind + Diesel, No Carbon Tax

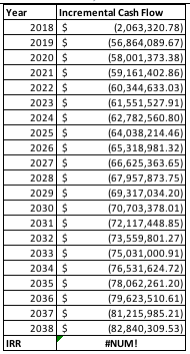
[picture p95: figure]

Figure 12 - Incremental IRR for Solar + Diesel vs. Wind + Solar + Diesel, No Carbon Tax

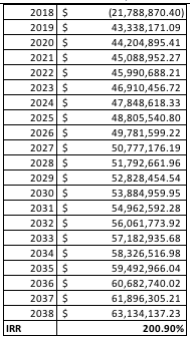
[picture p96: figure]

Figure 13 - Incremental IRR for Wind + Diesel vs. Diesel, No Carbon Tax, UK

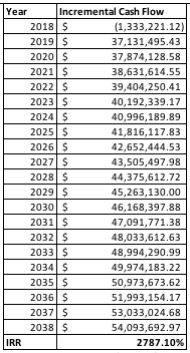
[picture p97: figure]

Figure 14 - Incremental IRR for Wind + Solar + Diesel vs. Wind + Diesel, No Carbon Tax, UK

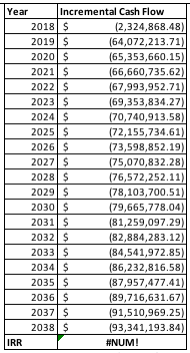
[picture p98: figure]

Figure 15 - Incremental IRR for Solar + Diesel vs Wind + Solar + Diesel, No Carbon Tax, UK

## Bibliography

Pearson Canada, Inc. (2017). Engineering Economics, Sixth Edition. Pearson Canada, Inc.

U.S. Energy Information Administration. (2018). Levelized Cost and Levelized Avoided Cost of New Generation Resources in the Annual Energy Outlook 2018. U.S. Energy Information Administration.
