tabdallah/capstone/1_Planning/Receipts/2018-03-26_Bolts_Plus_Low_Speed_Prototype_HW.JPG

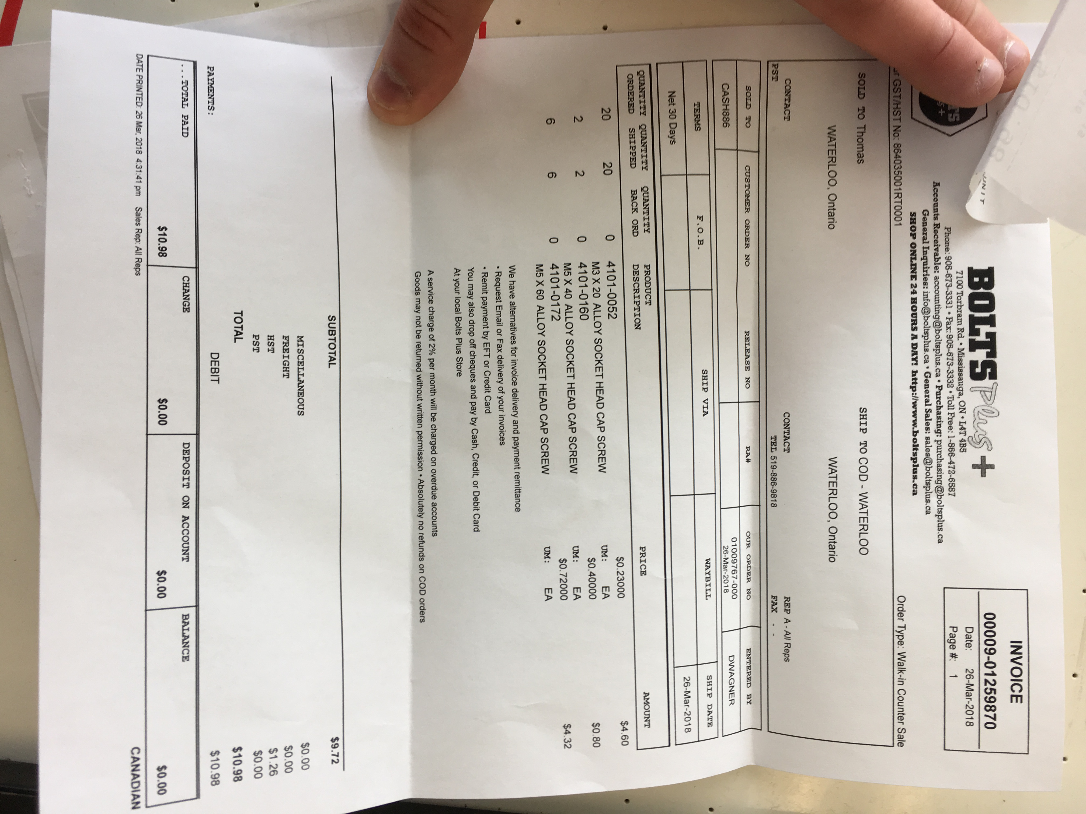
1_Planning/Receipts/2018-03-26_Bolts_Plus_Low_Speed_Prototype_HW.JPG
