tabdallah/capstone/1_Planning/Receipts/2018-04-03_Bolts_Plus_Limit_Switch_Mounting_HW.JPG

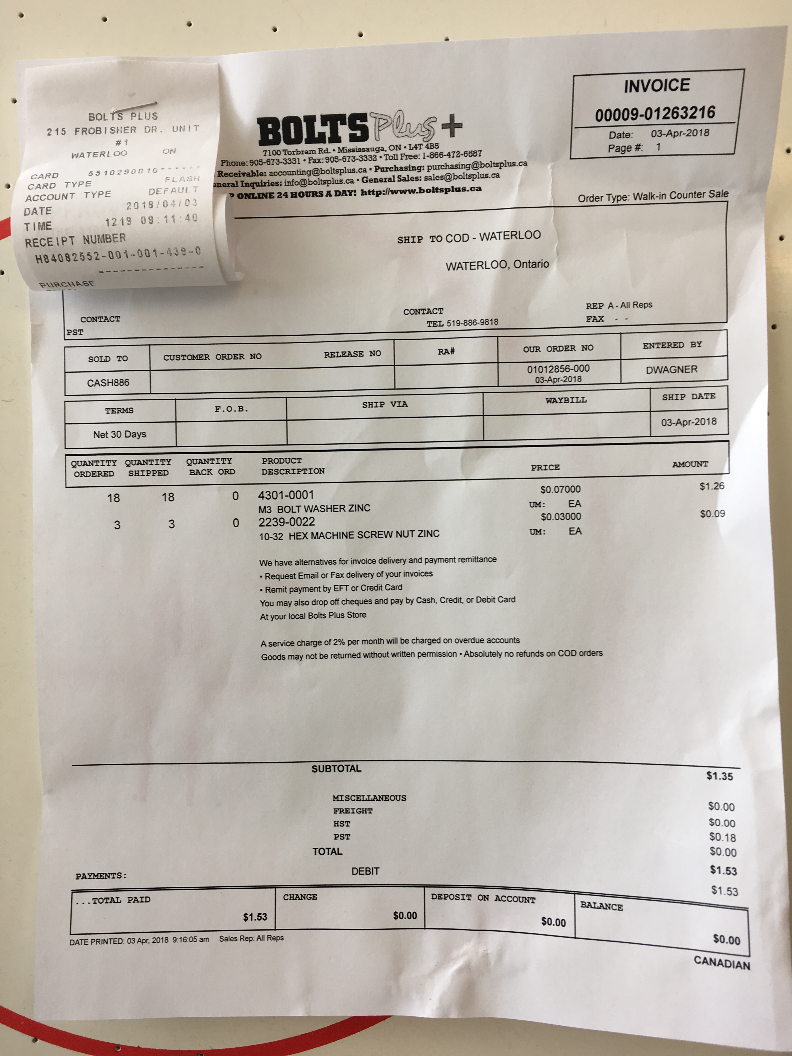
1_Planning/Receipts/2018-04-03_Bolts_Plus_Limit_Switch_Mounting_HW.JPG
