tabdallah/capstone/1_Planning/Receipts/2018-04-05_Sayal_Prototyping_Supplies.JPG

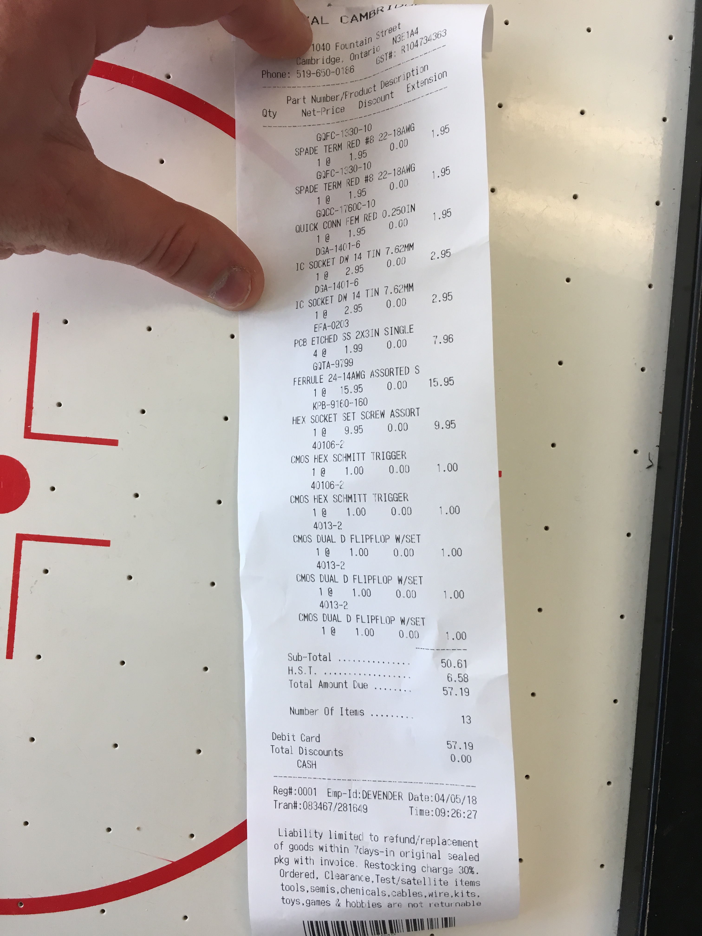
1_Planning/Receipts/2018-04-05_Sayal_Prototyping_Supplies.JPG
