tabdallah/capstone/1_Planning/System_Overview_Block_Diagram-Page-1.png

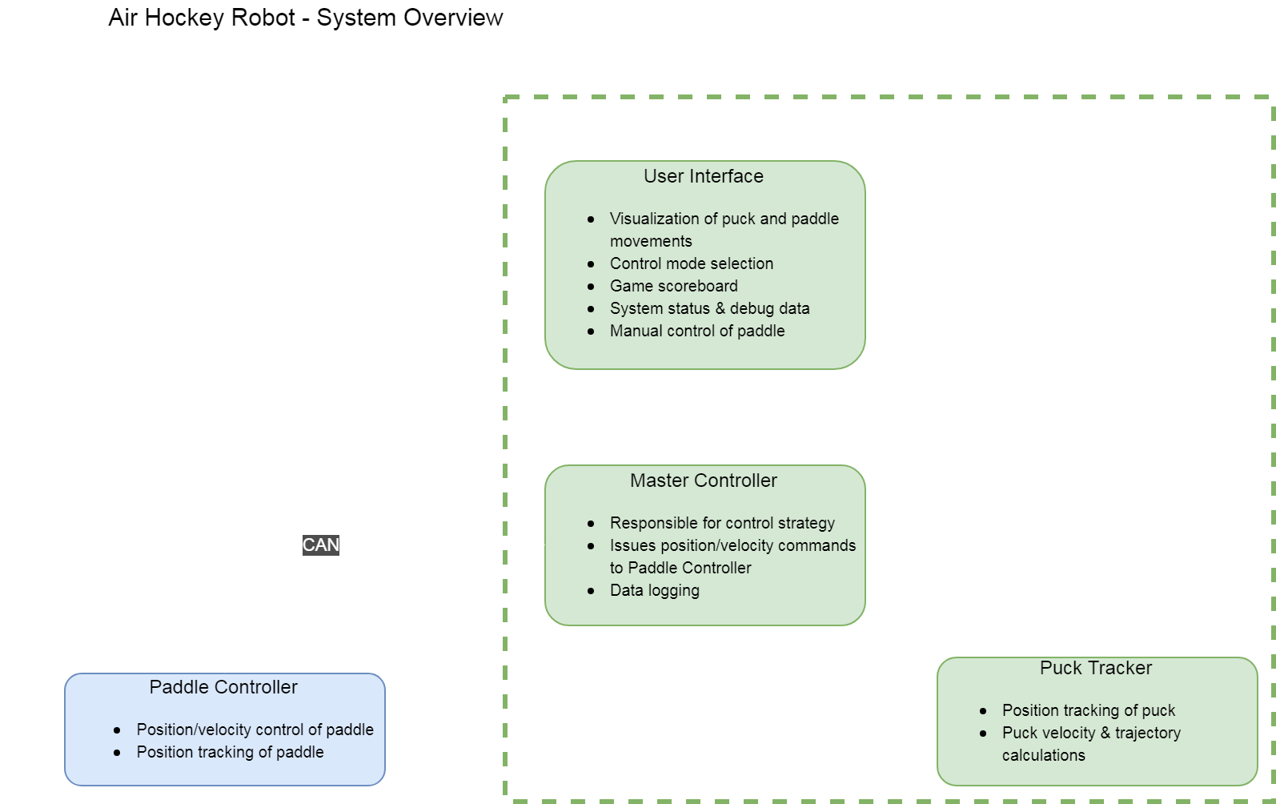
1_Planning/System_Overview_Block_Diagram-Page-1.png
