tabdallah/capstone/1_Planning/System_Overview_Block_Diagram.png

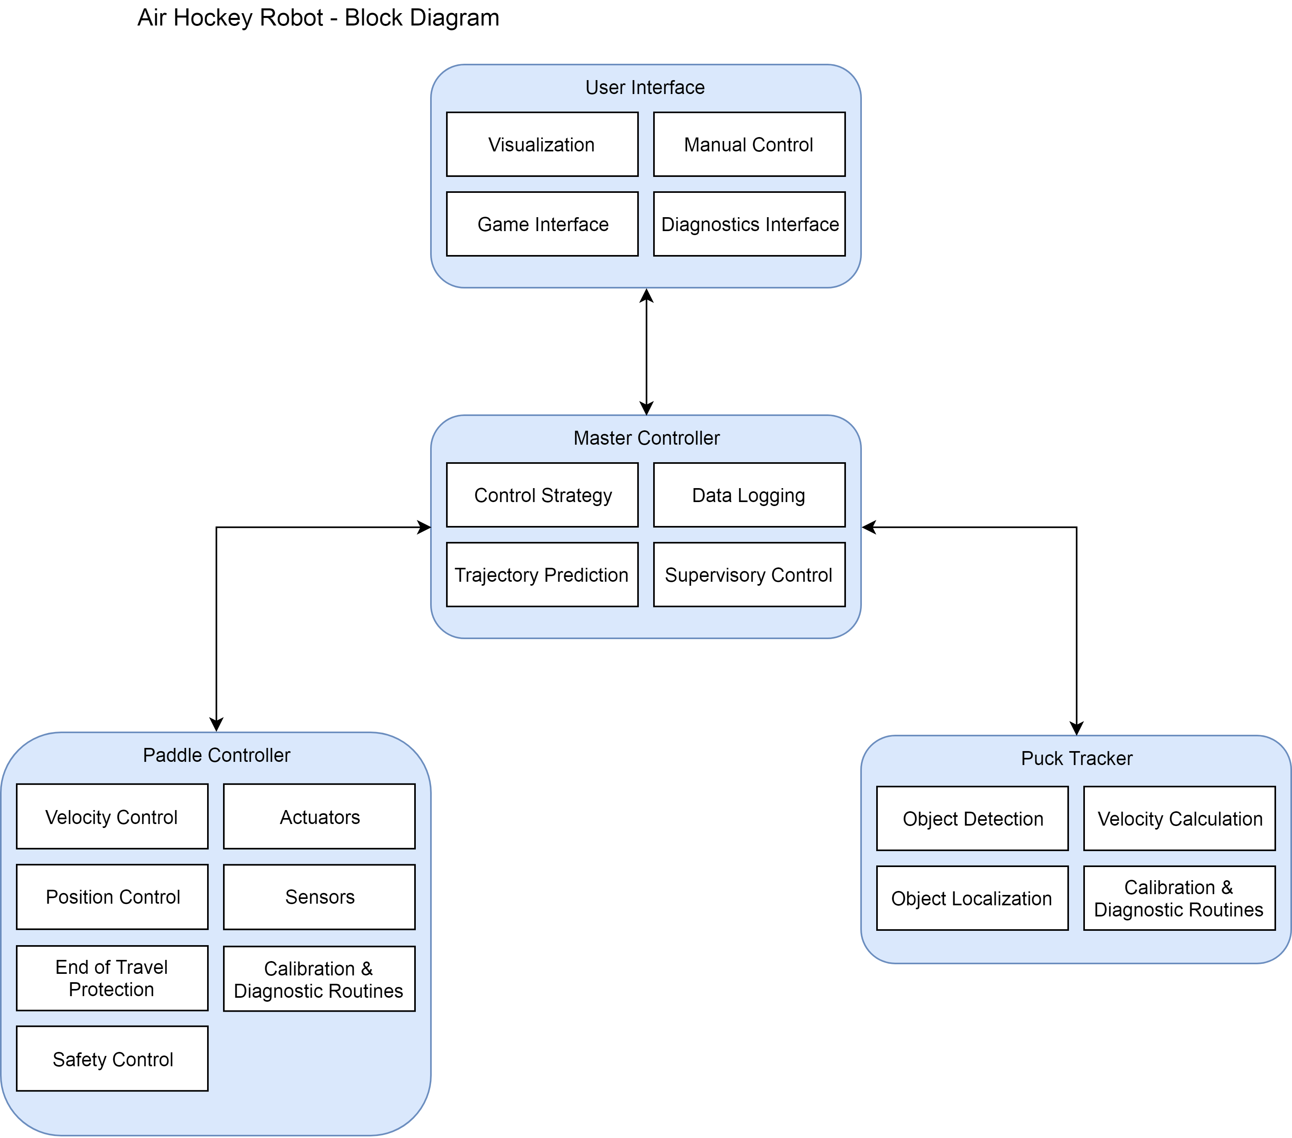
1_Planning/System_Overview_Block_Diagram.png
