tabdallah/capstone/3_Puck_Tracker/Puck_Tracker_Block_Diagram.png

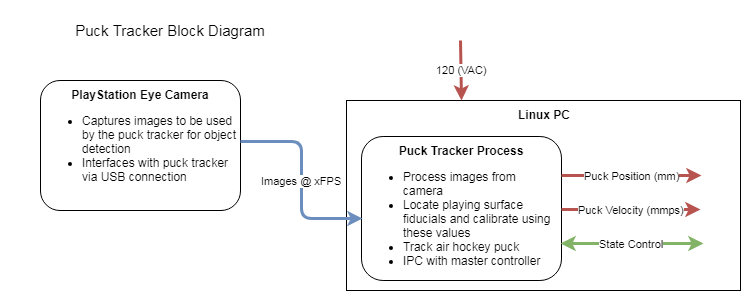
3_Puck_Tracker/Puck_Tracker_Block_Diagram.png
