tabdallah/capstone/4_Paddle_Controller/2_Software/motor_control_logic.png

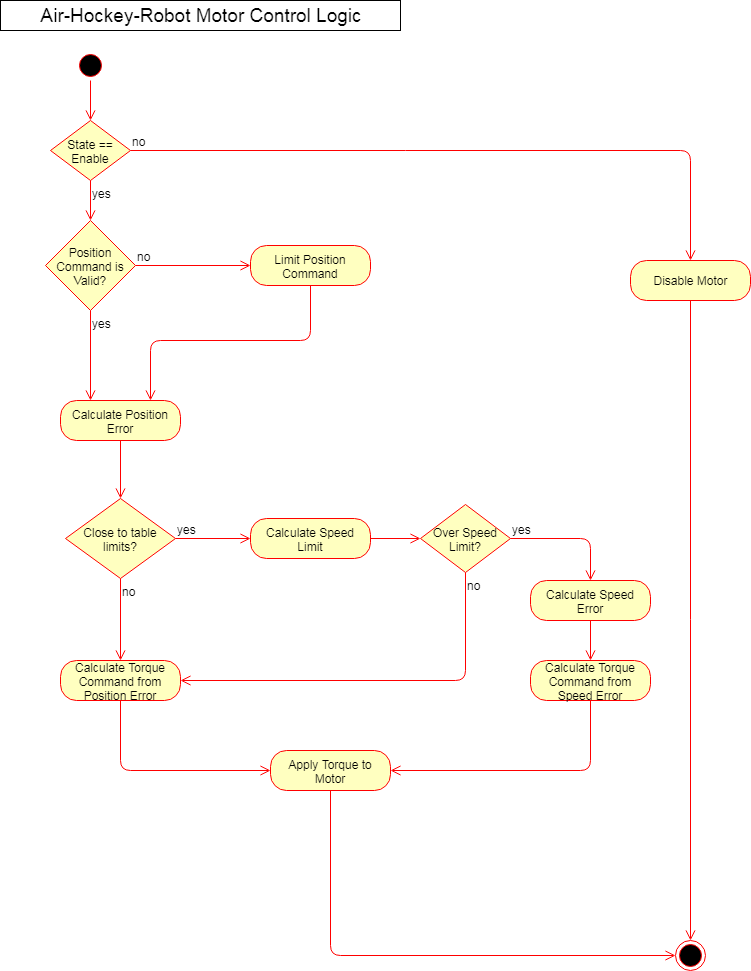
4_Paddle_Controller/2_Software/motor_control_logic.png
