tabdallah/capstone/4_Paddle_Controller/Paddle_Controller_Block_Diagram.png

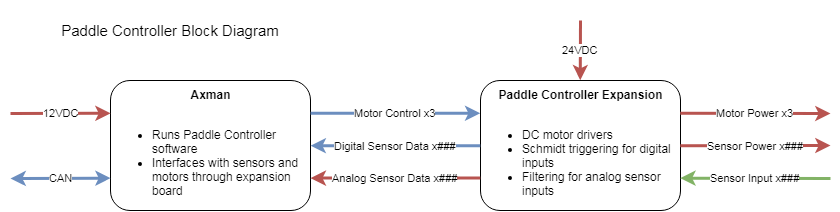
4_Paddle_Controller/Paddle_Controller_Block_Diagram.png
