tabdallah/capstone/5_Master_Controller/MC_Block_Diagram.png

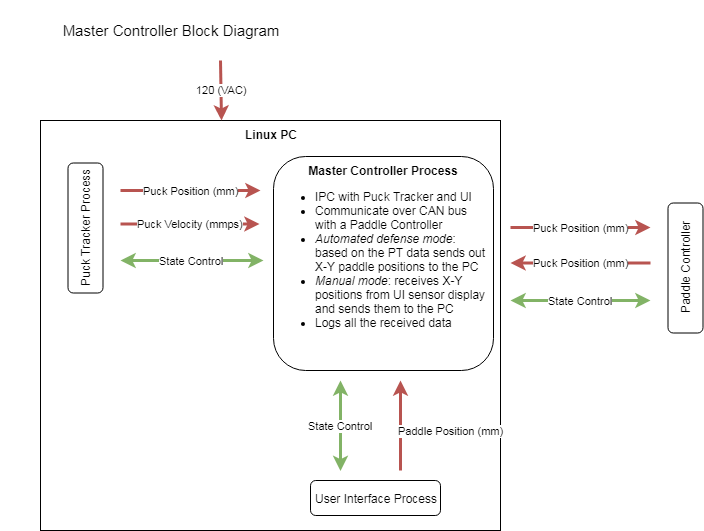
5_Master_Controller/MC_Block_Diagram.png
