tabdallah/capstone/5_Master_Controller/MC_Supervisory_algorithm.png

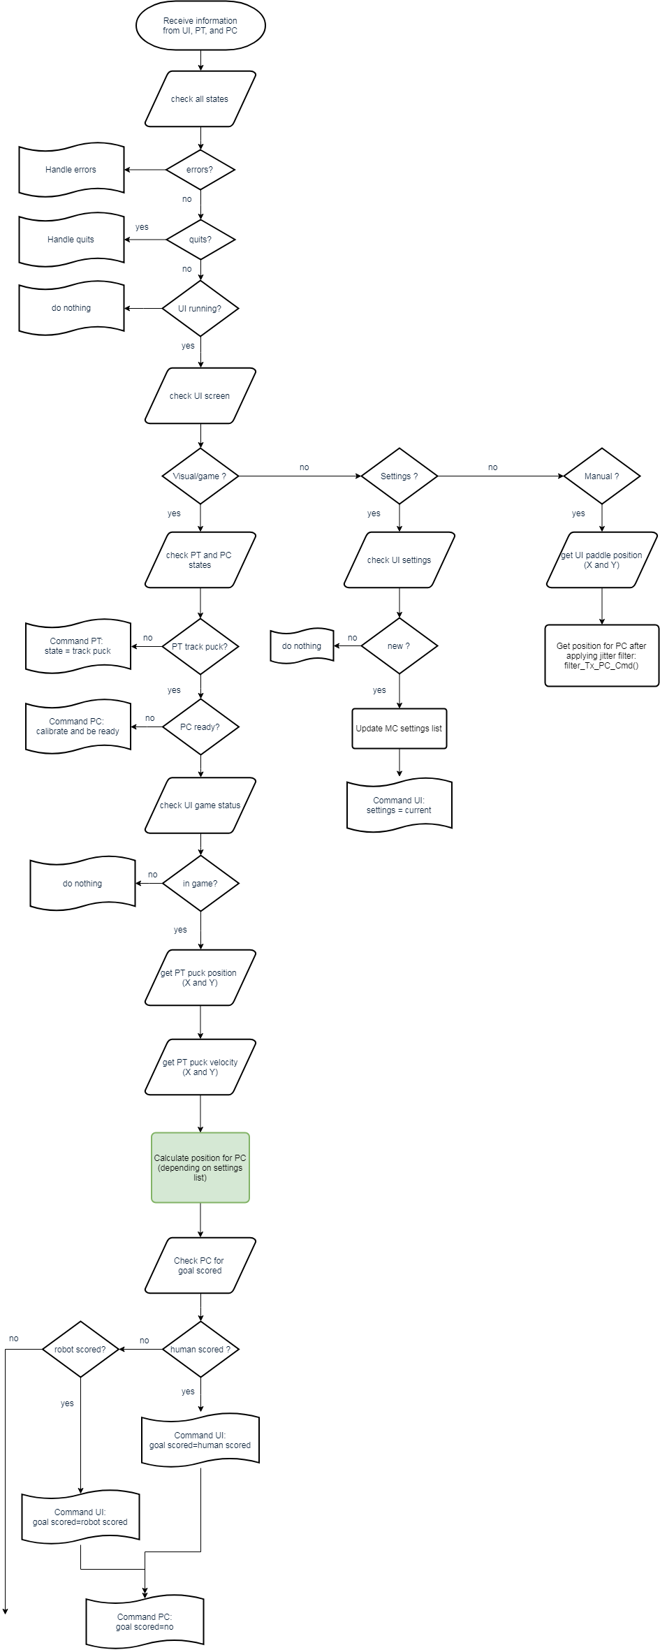
5_Master_Controller/MC_Supervisory_algorithm.png
