tabdallah/capstone/5_Master_Controller/Simple_Defense_Flowchart.png

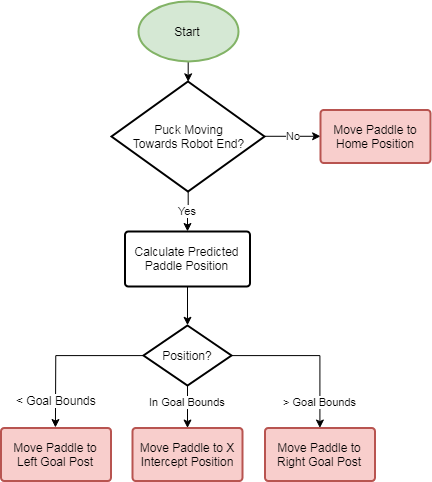
5_Master_Controller/Simple_Defense_Flowchart.png
