tabdallah/capstone/5_Master_Controller/Supervisory_Flowcharts/MC_init.jpg

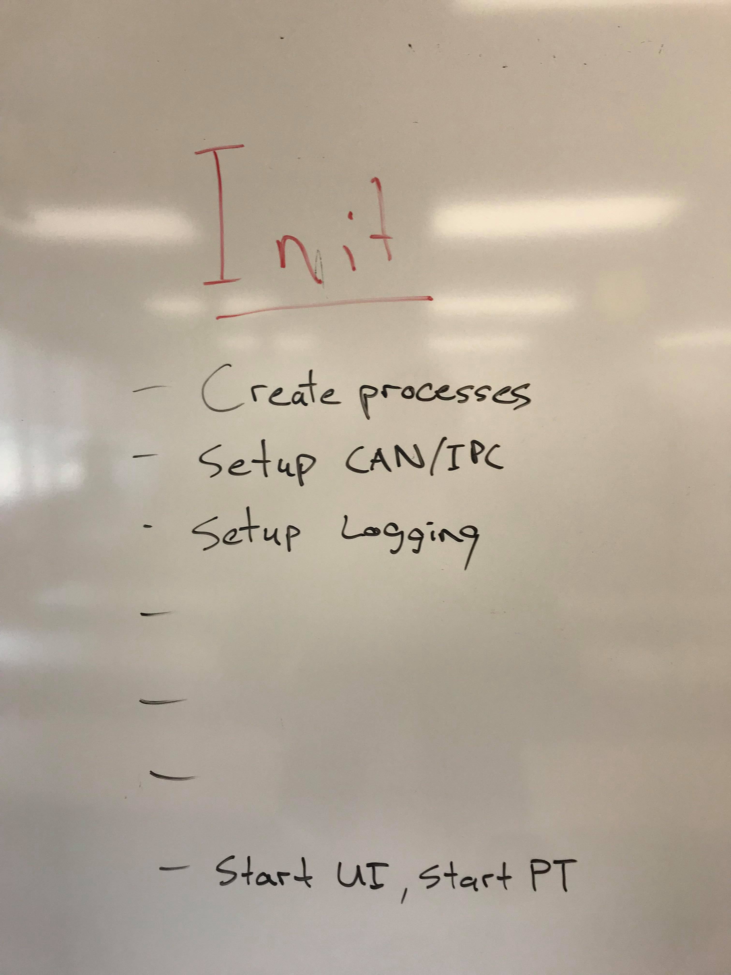
5_Master_Controller/Supervisory_Flowcharts/MC_init.jpg
