tabdallah/capstone/5_Master_Controller/Supervisory_Flowcharts/MC_Running_Flowchart.jpg

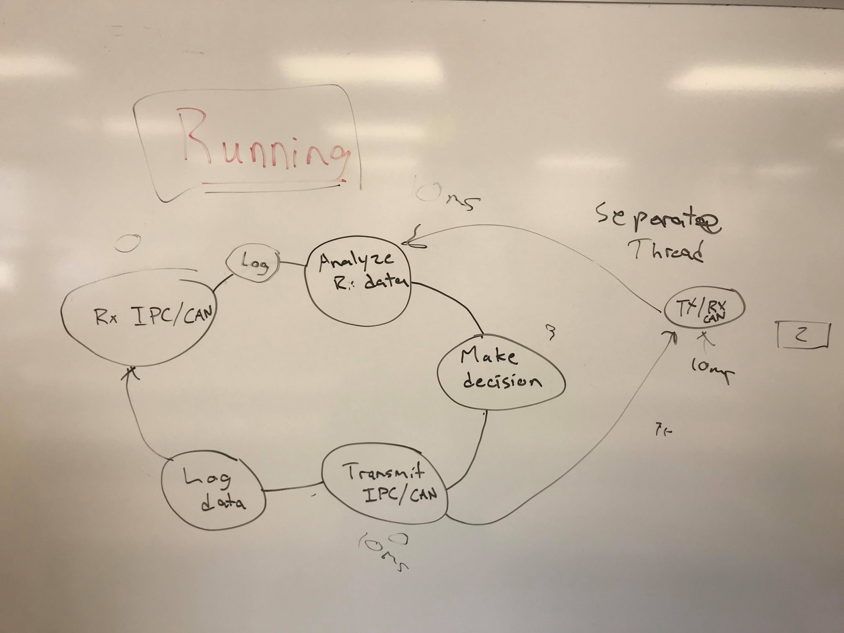
5_Master_Controller/Supervisory_Flowcharts/MC_Running_Flowchart.jpg
