tabdallah/capstone/5_Master_Controller/Supervisory_Flowcharts/PT_Tx_Rx_arrays.jpg

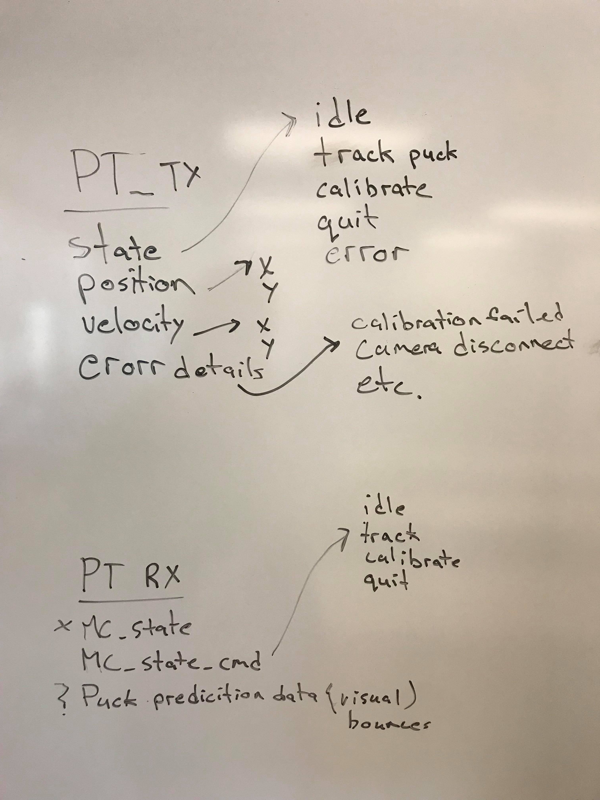
5_Master_Controller/Supervisory_Flowcharts/PT_Tx_Rx_arrays.jpg
