tabdallah/capstone/6_User_Interface/1_Software/2_Images/clicked.png

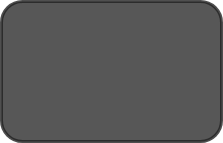
6_User_Interface/1_Software/2_Images/clicked.png
