tabdallah/capstone/6_User_Interface/1_Software/2_Images/hockeySurface.png

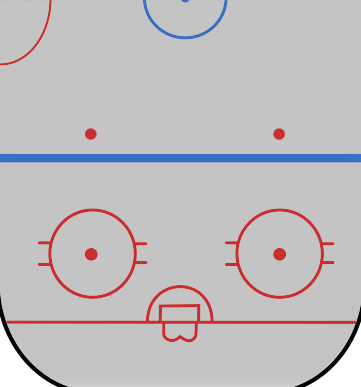
6_User_Interface/1_Software/2_Images/hockeySurface.png
