tabdallah/capstone/6_User_Interface/1_Software/2_Images/ice_background.jpg

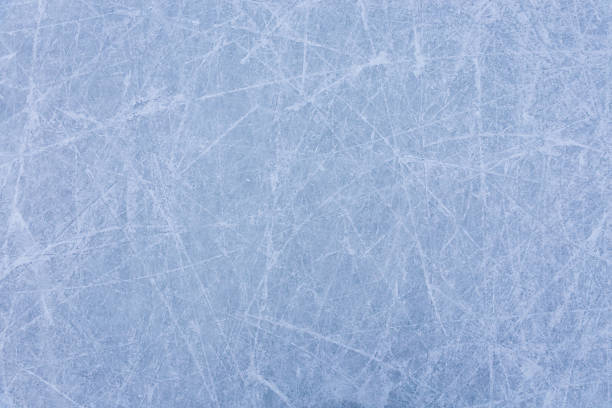
6_User_Interface/1_Software/2_Images/ice_background.jpg
