tabdallah/capstone/2_Mechanical/1_Solidworks_Model/Open_Source_Files/AMT103-V_Encoder/BOM.txt

3DX_CUI_Supplier: CUI, Inc
3DX_CUI_Description: AMT10 Axial, Adjustable Resolution, 512 PPR, Single Index Pulse, 5 mm Bore, Standard, Incremental, Capacitive Modular Encoder
3DX_CUI_Model Number: AMT103-D0512-I5000-S
