tabdallah/capstone/2_Mechanical/BOM_V1.0.xlsx

Bill of Materials
Project | Air Hockey Robot
Version | 1.0
Date | 2018-02-05
Author | Thomas Abdallah
Component Name | Part Number | Source | Quantity | Price | Total Price | Where Used
12V DC Motor 350rpm w/Encoder | FIT0493 | DFRobot (https://www.dfrobot.com/product-1462.html) | 3 | $29.00 | $87.00 | x-axis_motor_assy, y-axis_motor_assy_left, y-axis_motor_assy_right, spare
GT2 Timing Pulley - 30 Tooth | 200 | OpenBuilds Parts Store (http://openbuildspartstore.com/gt2-2m-timing-pulley-30-tooth/) | 3 | $8.57 | $25.71 | x-axis_motor_assy, y-axis_motor_assy_left, y-axis_motor_assy_right, spare
M3x8 Socket Head Cap Screw (Pack of 50) | 91274A103 | McMaster | 1 | $5.28 | $5.28 | x-axis_motor_assy, y-axis_motor_assy_left, y-axis_motor_assy_right, spare
M5x14 Socket Head Cap Screw (Pack of 25) | 95263A360 | McMaster | 1 | $5.22 | $5.22 | y-axis_motor_assy_left, y-axis_motor_assy_right, spare
M5 Wing Nut (Pack of 25) | 94300A320 | McMaster | 1 | $5.21 | $5.21 | x-axis_motor_assy, x-axis_idler_assy, y-axis_motor_assy_left, y-axis_motor_assy_right, spare
1/8" x 2" Aluminum Flat Bar (1inch) | AF6061/182 | Metal Supermarket | 1 | $20.94 | $20.94 | y-axis_motor_support
0.313" x 0.058 6061 Round Tube (146") |  | Metal Supermarket | 1 |  | $0.00 | 2 pcs 35.5", 2pcs 38"
Idler Pulley Wheel | 40 | OpenBuilds Parts Store (http://openbuildspartstore.com/smooth-idler-pulley-wheel/) | 3 | $3.29 | $9.87 | x-axis_idler_assy, y-axis_idler_assy_left, y-axis_idler_assy_right
Ball Bearing 5x16x5 | 30 | OpenBuilds Parts Store (http://openbuildspartstore.com/ball-bearing-625-2rs-5x16x5/) | 6 | $1.24 | $7.44 | x-axis_idler_assy, y-axis_idler_assy_left, y-axis_idler_assy_right
Slot Washer 15x2x2 | 185 | OpenBuilds Parts Store (http://openbuildspartstore.com/slot-washer-15x5x2mm/) | 6 | $0.25 | $1.50 | x-axis_idler_assy, y-axis_idler_assy_left, y-axis_idler_assy_right
M5x30 Socket Head Cap Screw (Pack of 50) | 91274A134 | McMaster | 1 | $6.15 | $6.15 | y-axis_idler_assy_left, y-axis_idler_assy_right
Tee Nut (Pack of 25) | 536 | OpenBuilds Parts Store (http://openbuildspartstore.com/tee-nuts-25-pack/) | 1 | $6.10 | $6.10 | y-axis_idler_assy_left, y-axis_idler_assy_right
M5x30 Low Profile Screws (Pack of 25) | 125 | OpenBuilds Parts Store (http://openbuildspartstore.com/low-profile-screws-m5/) | 1 | $4.97 | $4.97 | x-axis_motor_assy, x-axis_idler_assy
LM8UU Linear Bearing (Pack of 6) | LM8UU | Amazon (https://www.amazon.ca/HICTOP-Linear-Bearings-Printer-RepRap/dp/B01G5DG6JY) | 1 | $15.76 | $15.76 | x-axis_motor_assy, x-axis_idler_assy, pusher_assy
y-axis_motor_mount_left | Custom | 3D Printed | 1 |  | $0.00 | y-axis_motor_assy_left
y-axis_motor_mount_right | Custom | 3D Printed | 1 |  | $0.00 | y-axis_motor_assy_right
y-axis_idler_mount_left | Custom | 3D Printed | 1 |  | $0.00 | y-axis_idler_assy_left
y-axis_idler_mount_right | Custom | 3D Printed | 1 |  | $0.00 | y-axis_idler_assy_right
y-axis_carriage | Custom | 3D Printed | 2 |  | $0.00 | x-axis_motor_assy, x-axis_idler_assy
x-axis_motor_mount | Custom | 3D Printed | 1 |  | $0.00 | x-axis_motor_assy
x-axis_idler_spacer | Custom | 3D Printed | 1 |  | $0.00 | x-axis_idler_assy
AHR_x_carriage | Custom | 3D Printed | 1 |  | $0.00 | pusher_assy
AHR_x_carriage_belt | Custom | 3D Printed | 1 |  | $0.00 | pusher_assy
AHR_x_carriage_pusher | Custom | 3D Printed | 1 |  | $0.00 | pusher_assy
GT2 Timing Belt (1 foot) | 470 | OpenBuilds Parts Store (http://openbuildspartstore.com/gt2-2m-timing-belt/) | 14 | $3.08 | $43.12
 |  |  |  | Total | $244.27
