tabdallah/capstone/1_Planning/Receipts/Receipts.xlsx

Receipt | Description | Purchaser | Amount (CAD) | Notes
2018-02-05_Motors.pdf | Low speed prototype motors x3 | Thomas | $127.11
2018-02-05_OpenBuild_Parts_Store.pdf | Low speed prototype belts/pulleys/bearings | Thomas | $135.87
2018-02-06_Aluminum_Tube.pdf | Low speed ptototype 8mm aluminum tube | Thomas | $67.47
2018-02-08_DHL_Duty_Fees.pdf | Low speed prototype motors taxes and duty | Thomas | $33.36
2018-02-11_Amazon_LM8UU_Bearings.pdf | Low speed prototype 8mm linear bearings | Thomas | $16.38 | Removed cost of personal items (magnets)
2018-02-15_3D_Hubs.pdf | Low speed prototype 3D printing | Thomas | $20.53
2018-02-15_CSI_3D_Printing.JPG | Low speed prototype 3D printing | Thomas | $7.35
2018-02-21_Amazon_GT2_Belt.pdf | Extra GT2 belt | Thomas | $11.38
2018-03-19_AliExpress_Motors_x2.pdf | High speed motors x2 | Thomas | $49.09
2018-03-19_Amazon_Misc_Electrical.pdf | Power strip, e-stop, limit switches | Thomas | $41.24 | Removed cost of unnecessary butt connectors and personal items
2018-03-20_DelCity.pdf | Wiring and fusing | Thomas | $189.75
2018-03-26_Bolts_Plus_Low_Speed_Prototype_HW.JPG | Low speed prototype bolts | Thomas | $10.98
2018-03-26_Amazon_Power_Supply.pdf | 24V power supply | Thomas | $42.69
2018-04-02_AliExpress_60_tooth_pulleys.pdf | GT2 60 tooth pulleys | Thomas |  | Waiting for payment to hit account for CAD value
2018-04-03_Bolts_Plus_Limit_Switch_Mounting_HW.JPG | Limit switch mounting bolts | Thomas | $1.53
2018-04-03_Sayal_Wiring_Terminals.JPG | Wiring terminals, plugs, etc. | Thomas | $35.14
2018-04-05_Sayal_Prototyping_Supplies.JPG | Flip flops, schmidt triggers, protoboard, wire terminals | Thomas | $45.95 | Removed cost of unnecessary set screws
 | X-Axis high speed motor, more belt, more pulley | Thomas |  | Waiting for payment to hit account for CAD value
2018-06-07_Bearings_Canada.pdf | 1/2" Linear bearings for high speed system | Thomas | $99.99
2018-06-07_Metal_Supermarkets.pdf | 1/2" Linear rods for high speed system | Thomas | $40.91
2018-06-07_3D_Hubs.pdf | High speed system mounting brackets | Thomas | $72.15
 |  | Total | $1048.87
