tabdallah/capstone/4_Paddle_Controller/1_Electrical/uC_Interface_PCB/BOM_Digikey_uC_Interface_PCB.xlsx

MPN | PN | Quantity
PEC05SFAN | S1212E-05-ND | 1
5-146254-3 | A105155-ND | 1
UWX1H0R1MCL2GB | 493-2121-1-ND | 4
C0805C220J5GACTU | 399-1113-1-ND | 2
C0805C106K8PACTU | 399-4925-1-ND | 5
C0805C103K5RACTU | 399-1158-1-ND | 9
C0805C472K5RACTU | 399-1155-1-ND | 1
C0805C471K5RACTU | 399-1142-1-ND | 2
C1210C225K1RACTU | 399-5511-1-ND | 2
C1210C105K5RACTU | 399-3076-1-ND | 4
C0805C104K5RACTU | 399-1170-1-ND | 3
C0805C104K3RACTU | 399-1168-1-ND | 9
C0805C102J5RACTU | 399-1149-1-ND | 2
C1210C103J5GACTU | 399-1266-1-ND | 1
C0805C224K5RACTU | 399-3491-1-ND | 1
C0805C332K5RACTU | 399-1153-1-ND | 1
C0805C682K5RACTU | 399-1157-1-ND | 1
C1210C155K3RACTU | 399-3080-1-ND | 1
PPPC161LFBN-RC | S7049-ND | 2
ADF09A-KG-TASB3-R | AE10921-ND | 2
LTST-C191KGKT | 160-1446-1-ND | 5
1N4148WX-TP | 1N4148WXTPMSCT-ND | 3
B240A-13-F | B240A-FDICT-ND | 2
0022112032 | WM2701-ND | 2
PEC16SFAN | S1212E-16-ND | 1
SRN8040-330M | SRN8040-330MCT-ND | 2
SPM0408LE5H-TB | 423-1129-1-ND | 1
PEC02SFAN | S1212E-02-ND | 2
0022112022 | WM2700-ND | 2
BC846B,215 | 568-1632-1-ND | 2
CRCW0805464KFKEA | 541-464KCCT-ND | 1
3352T-1-103LF | 3352T-103LF-ND | 1
CRCW0805249RFKEA | 541-249CCT-ND | 7
CRCW08050000Z0EA | 541-0.0ACT-ND | 15
CRCW080510K0FKEA | 541-10.0KCCT-ND | 10
CRCW080510M0FKEA | 541-10.0MCCT-ND | 1
CRCW08055K11FKEA | 541-5.11KCCT-ND | 1
CRCW08051K00FKEA | 541-1.00KCCT-ND | 4
CRCW08052K87FKEA | 541-2.87KCCT-ND | 2
CRCW08054K64FKEA | 541-4.64KCCT-ND | 1
CRCW0805121RFKEA | 541-121CCT-ND | 1
CRCW08054K75FKEA | 541-4.75KCCT-ND | 4
CRCW0805100RFKEA | 541-100CCT-ND | 3
CRCW080535K7FKEA | 541-35.7KCCT-ND | 1
CRCW080524K3FKEA | 541-24.3KCCT-ND | 1
CRCW080520K0FKEA | 541-20.0KCCT-ND | 1
CRCW08059K09FKEA | 541-9.09KCCT-ND | 2
CRCW08058K87FKEA | 541-8.87KCCT-ND | 1
CRCW080522K1FKEA | 541-22.1KCCT-ND | 1
PTS645SH50SMTR92 LFS | CKN9085CT-ND | 1
PEC03SFAN | S1212E-03-ND | 1
PEC07SFAN | S1212E-07-ND | 1
74ACT14SCX | 74ACT14SCXCT-ND | 1
MC74AC00DR2G | MC74AC00DR2GOSCT-ND | 1
MC9S12C32CFUE25 | MC9S12C32CFUE25-ND | 1
DS1813R-5+T&R | DS1813R-5+CT-ND | 1
LM22675MRE-ADJ/NOPB | LM22675MRE-ADJ/NOPBCT-ND | 2
MAX3232CSE+ | MAX3232CSE+-ND | 1
MCP2551T-E/SN | MCP2551T-E/SNCT-ND | 1
L293DD013TR | 497-2937-1-ND | 1
L6225PDTR | 497-5345-1-ND | 1
MAX5513EUA+ | MAX5513EUA+-ND | 1
LMC6484IMX/NOPB | LMC6484IMX/NOPBCT-ND | 1
ECS-160-20-5PX-TR | XC1282CT-ND | 1
