tabdallah/capstone/2_Mechanical/1_Solidworks_Model/Open_Source_Files/OpenBuilds Library/Assemblies/Wheels/Delrin Mini V Wheel.SLDASM

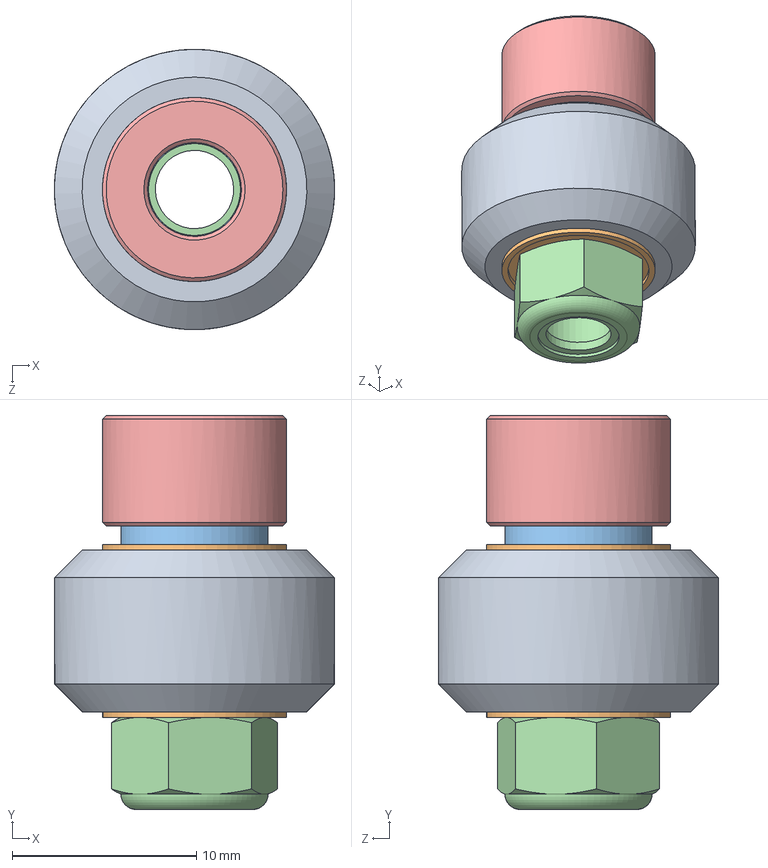
[picture p119: CAD file, 2018-03-15]
2_Mechanical/1_Solidworks_Model/Open_Source_Files/OpenBuilds Library/Assemblies/Wheels/Delrin Mini V Wheel.SLDASM
15.2 x 21.4 x 15.2 mm
Delrin Mini V Wheel
Ball Bearing 5 x 10 x 4.2 x 2
Precision Shim 8 x 5 x 1 x 2
Nylon Insert Lock Nut M5
Aluminum Spacer 6mm
