tabdallah/capstone/2_Mechanical/1_Solidworks_Model/V2.0_Design/2_Assemblies/Assembly_X-Axis_Carriage.SLDASM

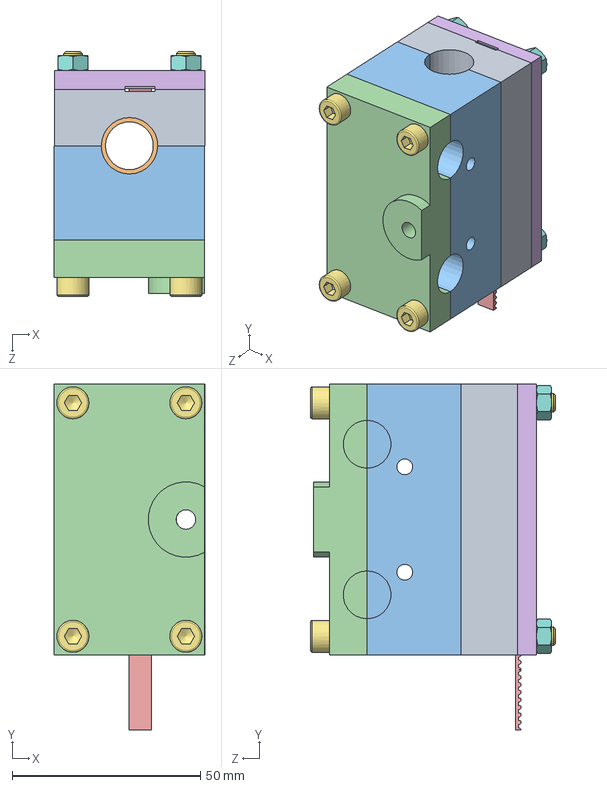
[picture p120: CAD file, 2018-07-24]
2_Mechanical/1_Solidworks_Model/V2.0_Design/2_Assemblies/Assembly_X-Axis_Carriage.SLDASM
40.0 x 91.9 x 65.0 mm
X-Axis_Carriage_Bottom
LBB8UU
X-Axis_Carriage_Middle
X-Axis_Carriage_Top
GT2 Belt 6mm x 40mm
X-Axis_Carriage_Belt_Clamp
M5x60_SKU_11103335 x 4
M5_Hex_Nut_SKU_40150 x 4
