tabdallah/capstone/2_Mechanical/1_Solidworks_Model/Open_Source_Files/OpenBuilds Library/Assemblies/Mini V Linear Actuator/Mini V Linear Actuator 500mm.SLDASM

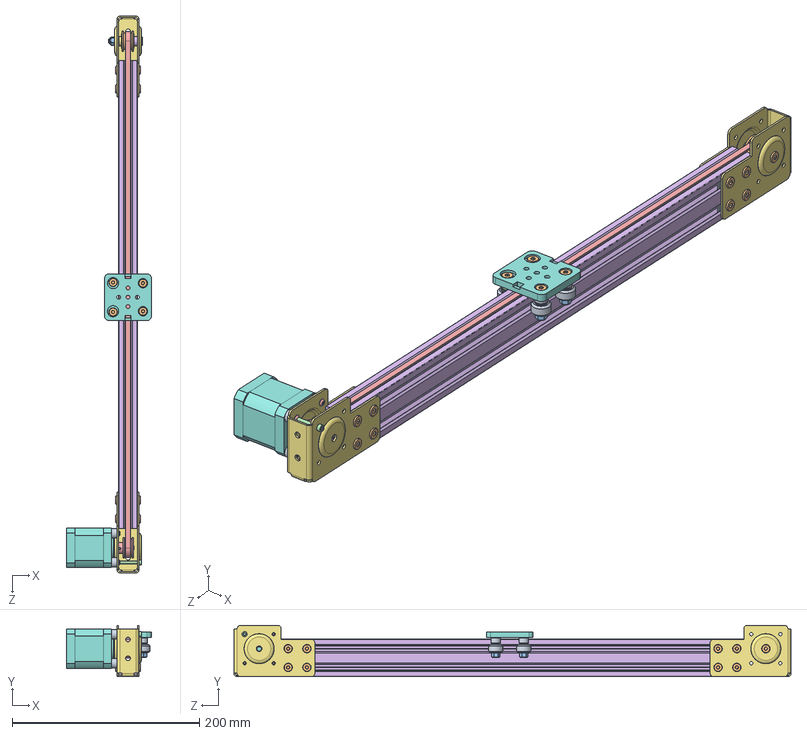
[picture p122: CAD file, 2018-02-02]
2_Mechanical/1_Solidworks_Model/Open_Source_Files/OpenBuilds Library/Assemblies/Mini V Linear Actuator/Mini V Linear Actuator 500mm.SLDASM
90.6 x 54.9 x 594.7 mm
Double Tee Nut x 8
Low Profile Screw M5 x 21
Nylon Insert Lock Nut M5 x 5
Button Head Socket Cap Screw M3 x 4
V-Slot 20x40x500 Linear Rail
Linear Actuator End Mount x 2
Nema 17 Stepper Motor
Aluminum Spacer 6mm x 6
Smooth Idler Pulley Wheel
Ball Bearing 5 x 16 x 5 x 2
Nylon Spacer 0.125in
GT2 Timing Pulley 30 Tooth
Aluminum Spacer .25in
Aluminum Spacer .125in
Mini V Wheel Plate
Delrin Mini V Wheel x 4
Ball Bearing 5 x 10 x 4.2 x 8
Precision Shim 8 x 5 x 1 x 8
Mini Eccentric Spacer 6mm x 2
GT2 Belt 1140mm
