tabdallah/capstone/2_Mechanical/1_Solidworks_Model/Open_Source_Files/OpenBuilds Library/Assemblies/Wheels/Smooth Idler.SLDASM

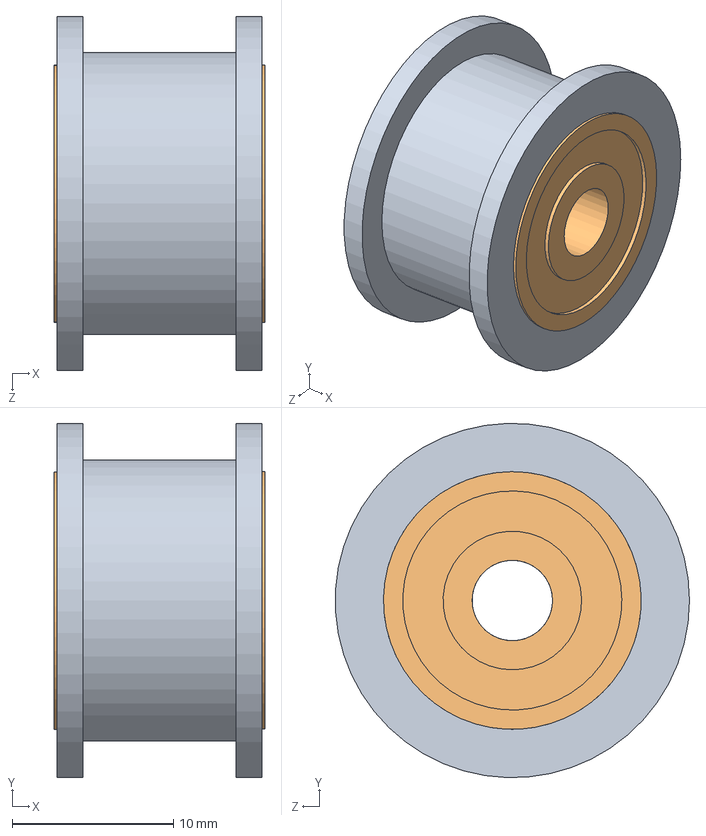
[picture p124: CAD file, 2018-03-15]
2_Mechanical/1_Solidworks_Model/Open_Source_Files/OpenBuilds Library/Assemblies/Wheels/Smooth Idler.SLDASM
13.1 x 22.0 x 22.0 mm
Smooth Idler Pulley Wheel
Ball Bearing 5 x 16 x 5 x 2
Nylon Spacer 0.125in
