tabdallah/capstone/2_Mechanical/1_Solidworks_Model/V2.0_Design/2_Assemblies/Assembly_X-Axis_Paddle.SLDASM

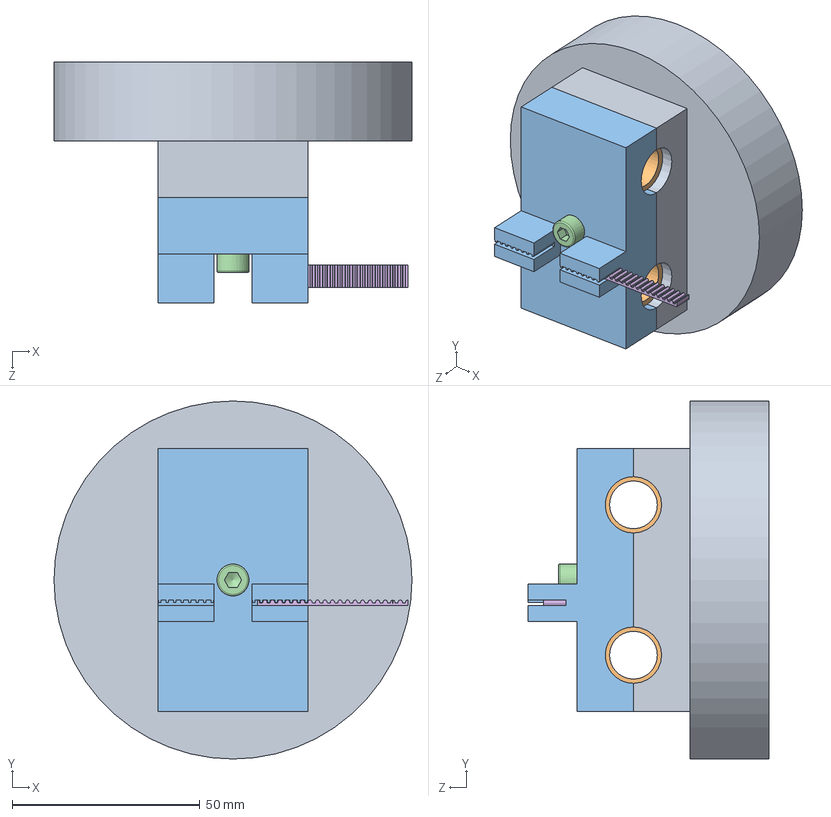
[picture p125: CAD file, 2018-07-24]
2_Mechanical/1_Solidworks_Model/V2.0_Design/2_Assemblies/Assembly_X-Axis_Paddle.SLDASM
95.2 x 95.2 x 64.0 mm
X-Axis_Paddle_Bottom
LBB8UU x 2
X-Axis_Paddle_Top
M5x50_SKU_1139553
M5_Hex_Nut_SKU_40150
GT2 Belt 6mm x 40mm
