tabdallah/capstone/2_Mechanical/1_Solidworks_Model/V2.0_Design/2_Assemblies/Assembly_Limit_Switch.SLDASM

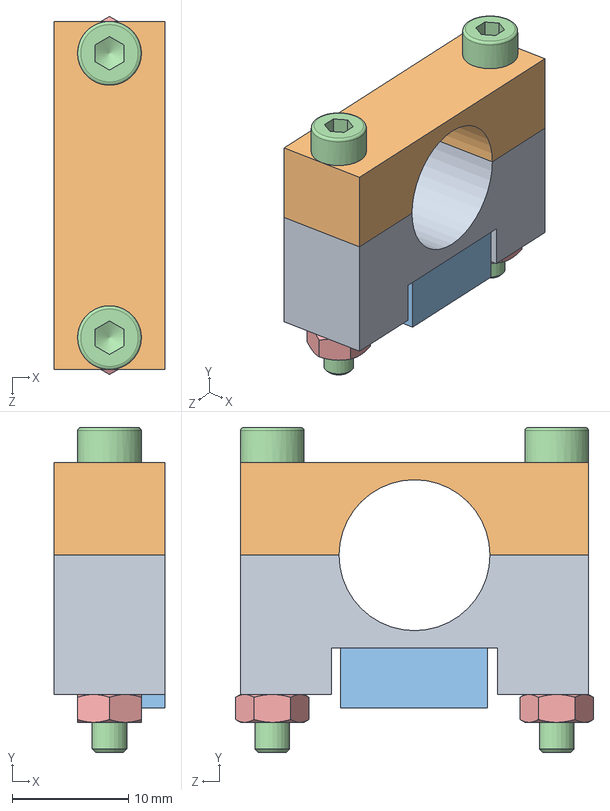
[picture p128: CAD file, 2018-07-24]
2_Mechanical/1_Solidworks_Model/V2.0_Design/2_Assemblies/Assembly_Limit_Switch.SLDASM
9.53 x 28.0 x 30.9 mm
limit_switch_mount_bottom
limit_switch_mount_top
limit_switch
M3x25_SKU_39508 x 2
M3_Hex_Nut_SKU_40326 x 2
