tabdallah/capstone/2_Mechanical/1_Solidworks_Model/Open_Source_Files/OpenBuilds Library/Assemblies/Wheels/Xtreme V Wheel.SLDASM

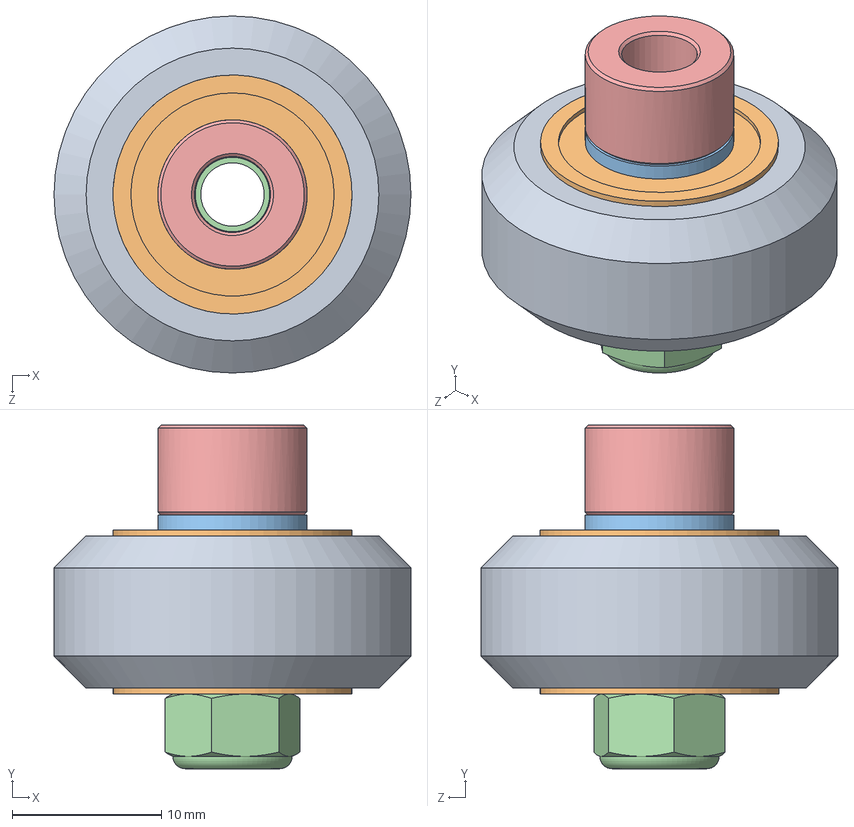
[picture p130: CAD file, 2018-02-02]
2_Mechanical/1_Solidworks_Model/Open_Source_Files/OpenBuilds Library/Assemblies/Wheels/Xtreme V Wheel.SLDASM
23.9 x 23.0 x 23.9 mm
Xtreme Solid V Wheel
Ball Bearing 5 x 16 x 5 x 2
Precision Shim 10 x 5 x 1 x 2
Nylon Insert Lock Nut M5
Aluminum Spacer 6mm
