tabdallah/capstone/2_Mechanical/1_Solidworks_Model/V2.0_Design/2_Assemblies/Assembly_Y-Axis_Connecting_Rod_Mount.SLDASM

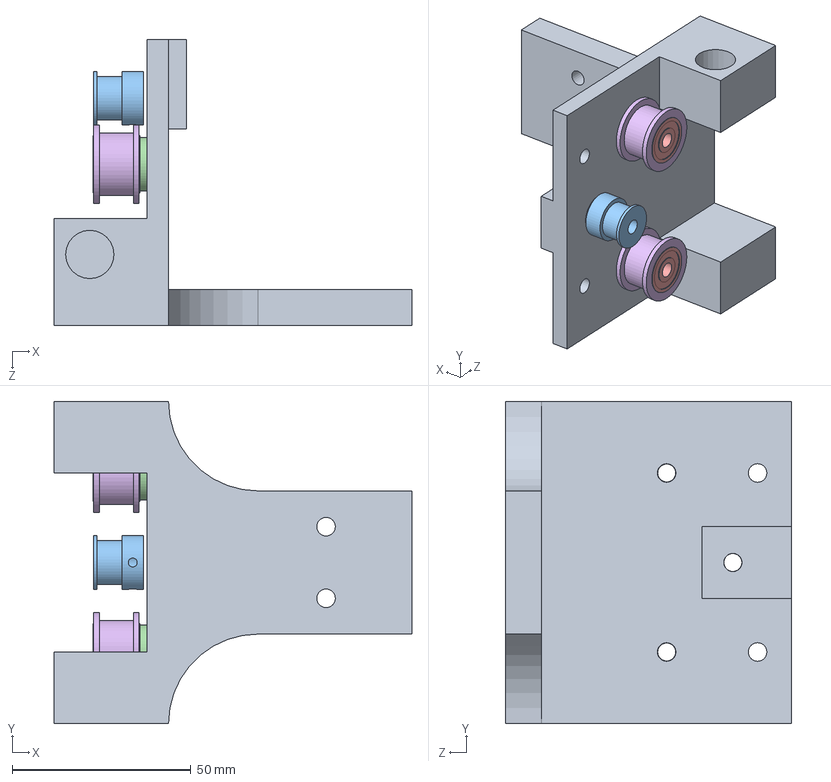
[picture p131: CAD file, 2018-07-24]
2_Mechanical/1_Solidworks_Model/V2.0_Design/2_Assemblies/Assembly_Y-Axis_Connecting_Rod_Mount.SLDASM
100.0 x 90.0 x 79.8 mm
Y-Axis_Connecting_Rod_Mount
Y-Axis_Connecting_Rod_Bearing
GT2 Timing Pulley 20 Tooth
Slot Washer 15 x 5 x 2 x 2
Ball Bearing 5 x 16 x 5 x 4
Smooth Idler Pulley Wheel x 2
