tabdallah/capstone/2_Mechanical/1_Solidworks_Model/V2.0_Design/2_Assemblies/Assembly_Table.SLDASM

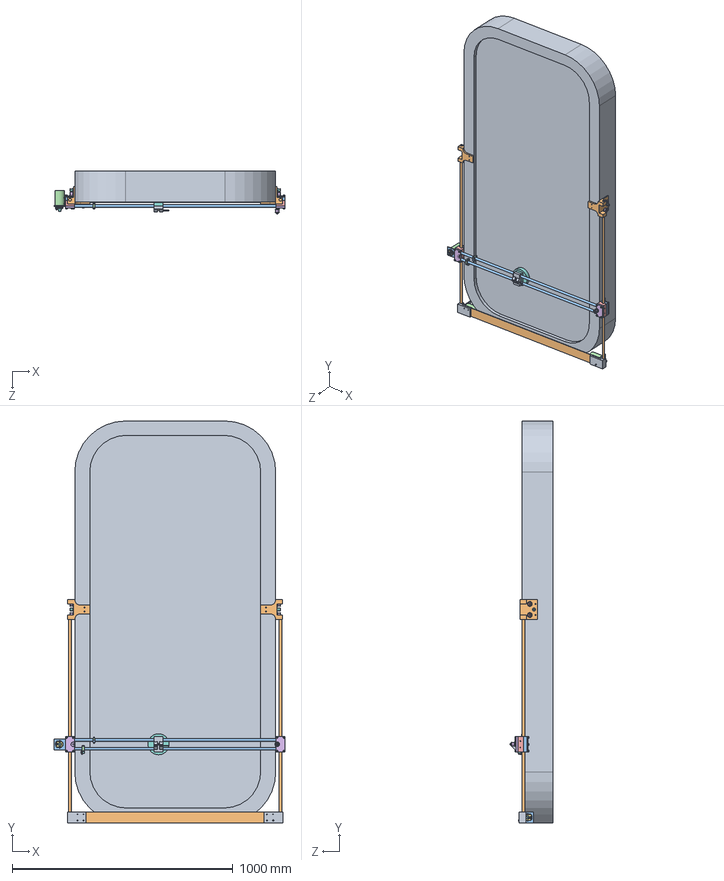
[picture p133: CAD file, 2018-07-24]
2_Mechanical/1_Solidworks_Model/V2.0_Design/2_Assemblies/Assembly_Table.SLDASM
1046.9 x 1822.3 x 194.2 mm
Table
y-axis_motor_support
Motor_Mount_795 x 3
Motor_795 x 3
M4_Hex_Nut x 12
M4x8_Low_Profile_SKU_90564 x 6
CUI_amt-sleeve-rev-d(5 mm) x 3
CUI_amt-hub-top-rev-d1 x 3
CUI_amt-hub-bottom-rev-b x 3
CUI_amt10x-shaft-adaptor-rev-e x 3
CUI_receiver-board x 3
CUI_rotor-board-rev f x 3
CUI_transmitter-board amt10(amt-103) x 3
CUI_amt-103-base-rev-k(default) x 3
CUI_amt-103-top-cover-rev-h x 3
GT2 Timing Pulley 20 Tooth x 5
Y-Axis_Rod_Mount x 2
Y-Axis_Rod x 2
X-Axis_Carriage_Bottom x 2
LBB8UU x 4
X-Axis_Carriage_Middle x 2
X-Axis_Carriage_Top x 2
GT2 Belt 6mm x 40mm x 3
X-Axis_Carriage_Belt_Clamp x 2
M5x60_SKU_11103335 x 8
M5_Hex_Nut_SKU_40150 x 10
X-Axis_Rod x 2
Slot Washer 15 x 5 x 2 x 6
Ball Bearing 5 x 16 x 5 x 10
Smooth Idler Pulley Wheel x 5
M5x80_SKU_0163627
X-Axis_Paddle_Bottom
X-Axis_Paddle_Top
M5x50_SKU_1139553
limit_switch_mount_bottom
limit_switch_mount_top x 2
limit_switch x 2
M3x25_SKU_39508 x 2
M3_Hex_Nut_SKU_40326 x 2
limit_switch_mount_alt_bottom
M4x18_SKU_39519
Y-Axis_Connecting_Rod_Mount x 2
Y-Axis_Connecting_Rod_Bearing x 2
