tabdallah/capstone/2_Mechanical/1_Solidworks_Model/Open_Source_Files/OpenBuilds Library/Assemblies/V Slot Belt and Pinion Actuator/Solid V Wheel assy.SLDASM

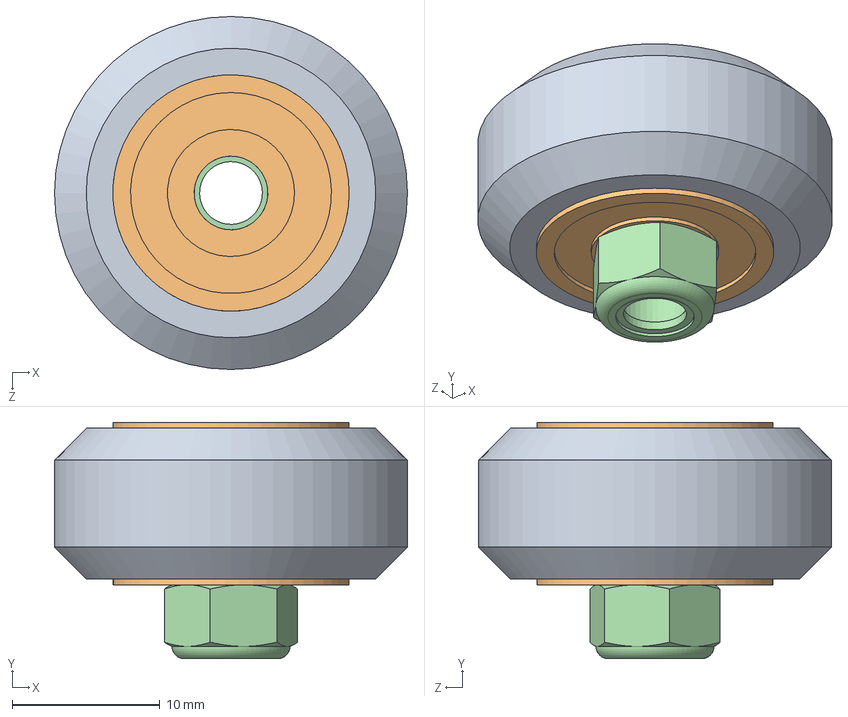
[picture p134: CAD file, 2018-02-02]
2_Mechanical/1_Solidworks_Model/Open_Source_Files/OpenBuilds Library/Assemblies/V Slot Belt and Pinion Actuator/Solid V Wheel assy.SLDASM
23.9 x 16.0 x 23.9 mm
Solid V Wheel
Ball Bearing 5 x 16 x 5 x 2
Precision Shim 10 x 5 x 1
Nylon Insert Lock Nut M5
