tabdallah/capstone/2_Mechanical/1_Solidworks_Model/V2.0_Design/2_Assemblies/Assembly_Limit_Switch_Alt.SLDASM

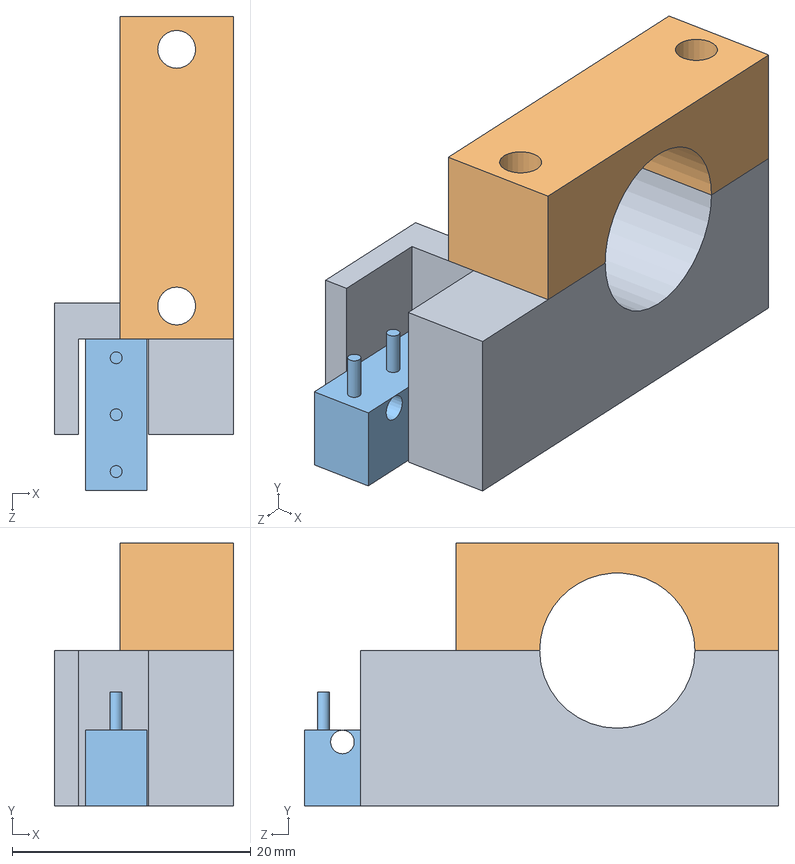
[picture p135: CAD file, 2018-07-24]
2_Mechanical/1_Solidworks_Model/V2.0_Design/2_Assemblies/Assembly_Limit_Switch_Alt.SLDASM
15.0 x 22.0 x 39.7 mm
limit_switch_mount_alt_bottom
limit_switch_mount_top
limit_switch
