tabdallah/capstone/2_Mechanical/1_Solidworks_Model/V2.0_Design/2_Assemblies/Assembly_Motor_795.SLDASM

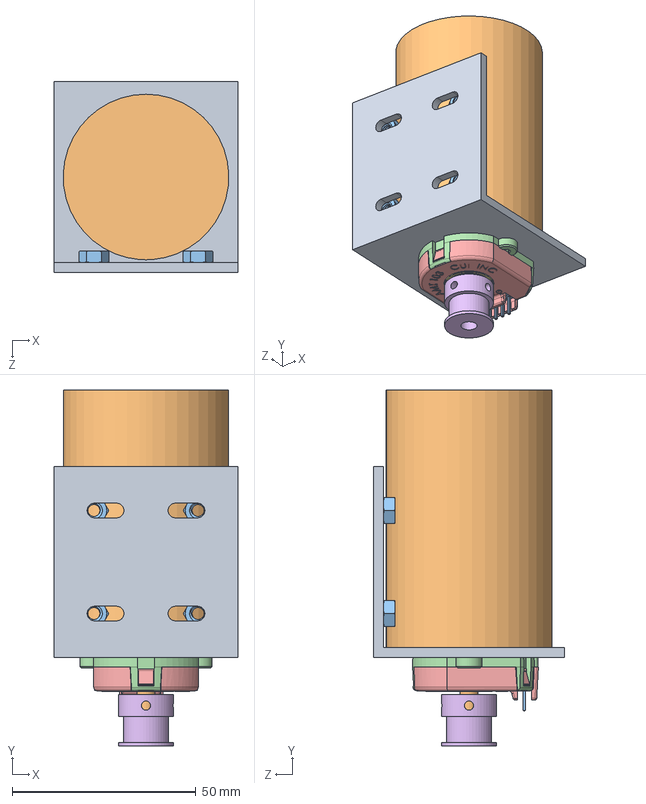
[picture p136: CAD file, 2018-06-01]
2_Mechanical/1_Solidworks_Model/V2.0_Design/2_Assemblies/Assembly_Motor_795.SLDASM
50.0 x 96.8 x 52.0 mm
Motor_Mount_795
Motor_795
M4_Hex_Nut x 4
M4x8_Low_Profile_SKU_90564 x 2
CUI_amt-sleeve-rev-d(5 mm)
CUI_amt-hub-top-rev-d1
CUI_amt-hub-bottom-rev-b
CUI_amt10x-shaft-adaptor-rev-e
CUI_receiver-board
CUI_rotor-board-rev f
CUI_transmitter-board amt10(amt-103)
CUI_amt-103-base-rev-k(default)
CUI_amt-103-top-cover-rev-h
GT2 Timing Pulley 20 Tooth
