tabdallah/capstone/2_Mechanical/1_Solidworks_Model/V2.0_Design/2_Assemblies/Assembly_IR_Sensor.SLDASM

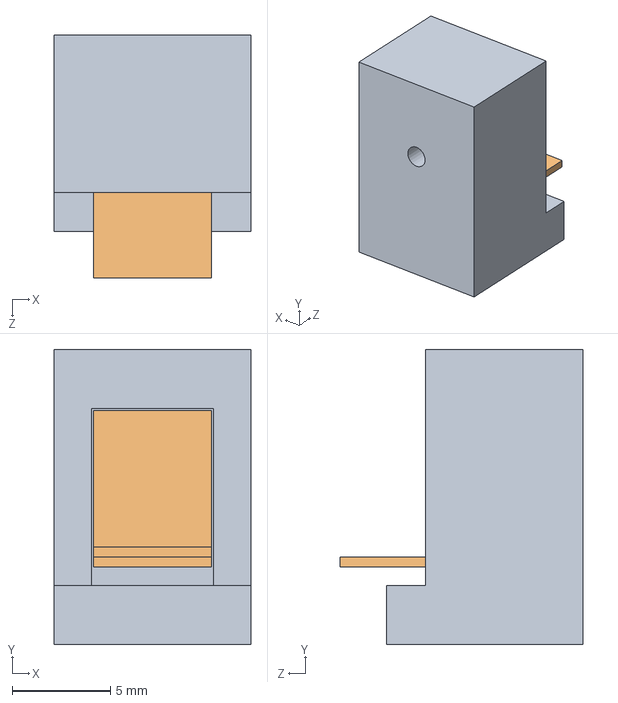
[picture p137: CAD file, 2018-06-01]
2_Mechanical/1_Solidworks_Model/V2.0_Design/2_Assemblies/Assembly_IR_Sensor.SLDASM
10.0 x 15.0 x 12.4 mm
tssp40_mount
TSSP40
