tabdallah/capstone/2_Mechanical/1_Solidworks_Model/V2.0_Design/2_Assemblies/Assembly_IR_LED.SLDASM

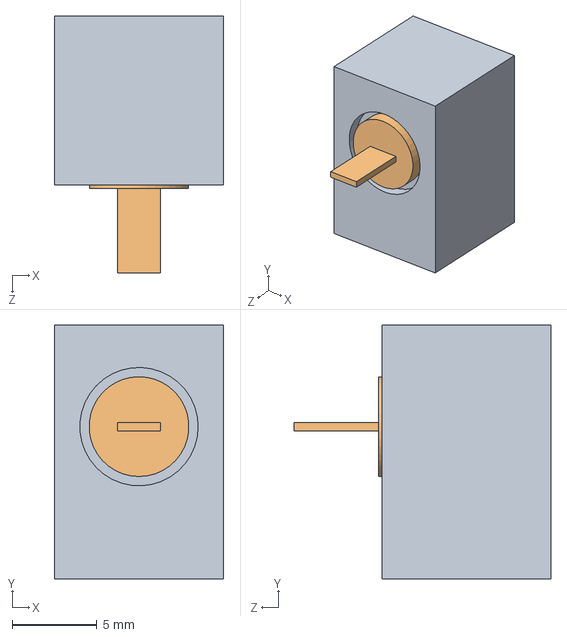
[picture p139: CAD file, 2018-06-01]
2_Mechanical/1_Solidworks_Model/V2.0_Design/2_Assemblies/Assembly_IR_LED.SLDASM
10.0 x 15.0 x 15.2 mm
tsal6200_mount
TSAL6200
