tabdallah/capstone/2_Mechanical/1_Solidworks_Model/V2.0_Design/2_Assemblies/Assembly_Y_Axis_Idler.SLDASM

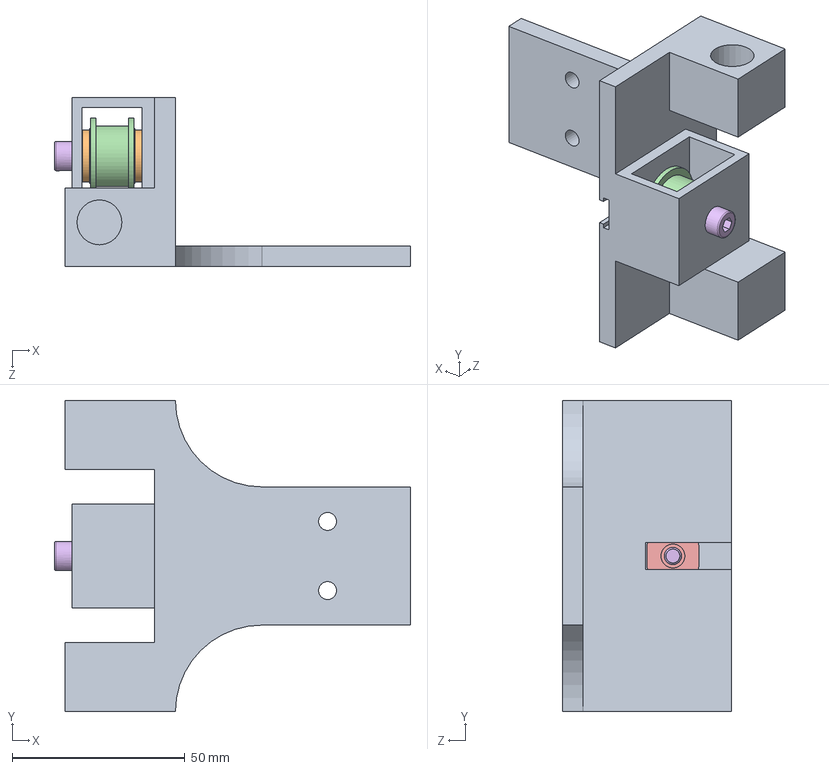
[picture p140: CAD file, 2018-06-01]
2_Mechanical/1_Solidworks_Model/V2.0_Design/2_Assemblies/Assembly_Y_Axis_Idler.SLDASM
103.0 x 90.0 x 49.0 mm
Y-Axis_Idler_Mount
Slot Washer 15 x 5 x 2 x 2
Ball Bearing 5 x 16 x 5 x 2
Smooth Idler Pulley Wheel
Tee Nut
M5x30_SKU_11103330
