tabdallah/capstone/2_Mechanical/1_Solidworks_Model/Open_Source_Files/AHR_x_carriage_pusher.SLDPRT

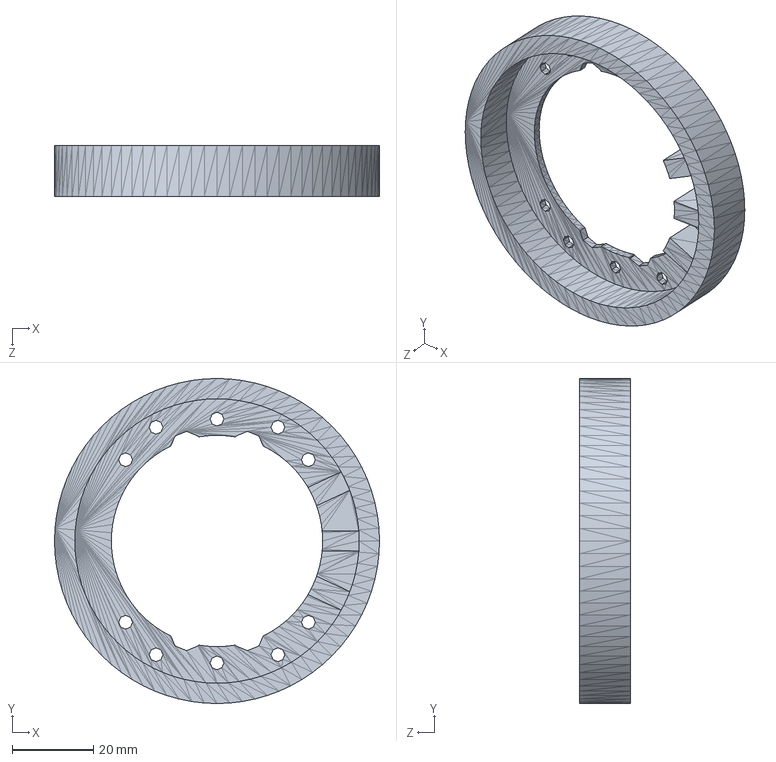
[picture p141: CAD file, 2018-03-15]
2_Mechanical/1_Solidworks_Model/Open_Source_Files/AHR_x_carriage_pusher.SLDPRT
80.0 x 80.0 x 12.5 mm
