tabdallah/capstone/2_Mechanical/1_Solidworks_Model/Open_Source_Files/OpenBuilds Library/1 - Linear Rail/Open Rail 1000mm.SLDPRT

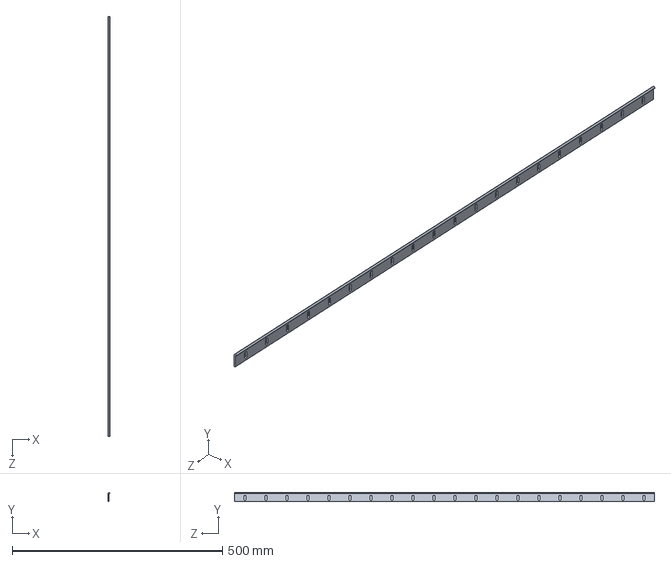
[picture p142: CAD file, 2018-03-28]
2_Mechanical/1_Solidworks_Model/Open_Source_Files/OpenBuilds Library/1 - Linear Rail/Open Rail 1000mm.SLDPRT
4.75 x 22.5 x 1000.0 mm
