tabdallah/capstone/2_Mechanical/1_Solidworks_Model/Open_Source_Files/OpenBuilds Library/2 - Wheels/Delrin Mini V Wheel.SLDPRT

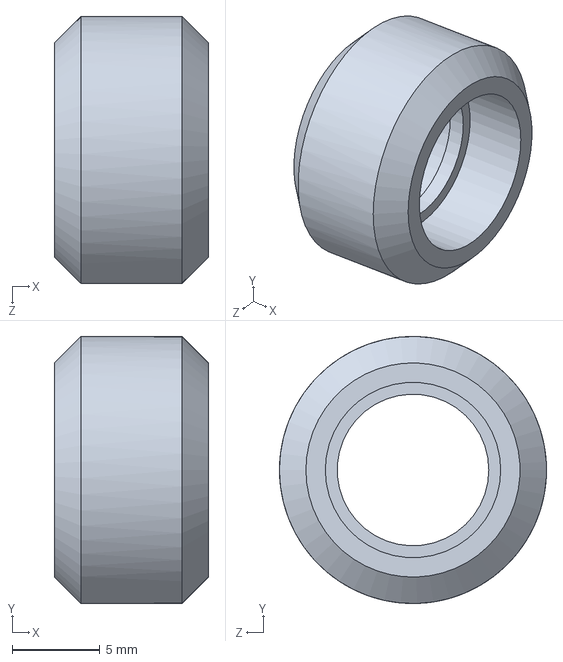
[picture p143: CAD file, 2018-03-15]
2_Mechanical/1_Solidworks_Model/Open_Source_Files/OpenBuilds Library/2 - Wheels/Delrin Mini V Wheel.SLDPRT
8.80 x 15.2 x 15.2 mm
