tabdallah/capstone/2_Mechanical/1_Solidworks_Model/Open_Source_Files/OpenBuilds Library/3 - Bearings/Ball Bearing 5 x 10 x 4.2.SLDPRT

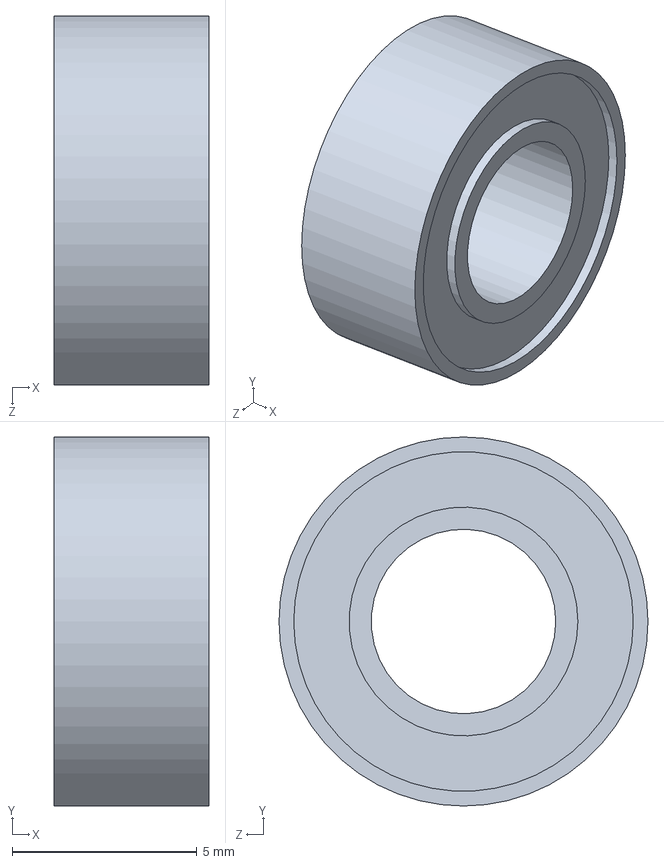
[picture p144: CAD file, 2018-03-15]
2_Mechanical/1_Solidworks_Model/Open_Source_Files/OpenBuilds Library/3 - Bearings/Ball Bearing 5 x 10 x 4.2.SLDPRT
4.20 x 10.0 x 10.0 mm
