tabdallah/capstone/2_Mechanical/1_Solidworks_Model/Open_Source_Files/OpenBuilds Library/4 - Pulleys/GT2 Timing Pulley 20 Tooth.SLDPRT

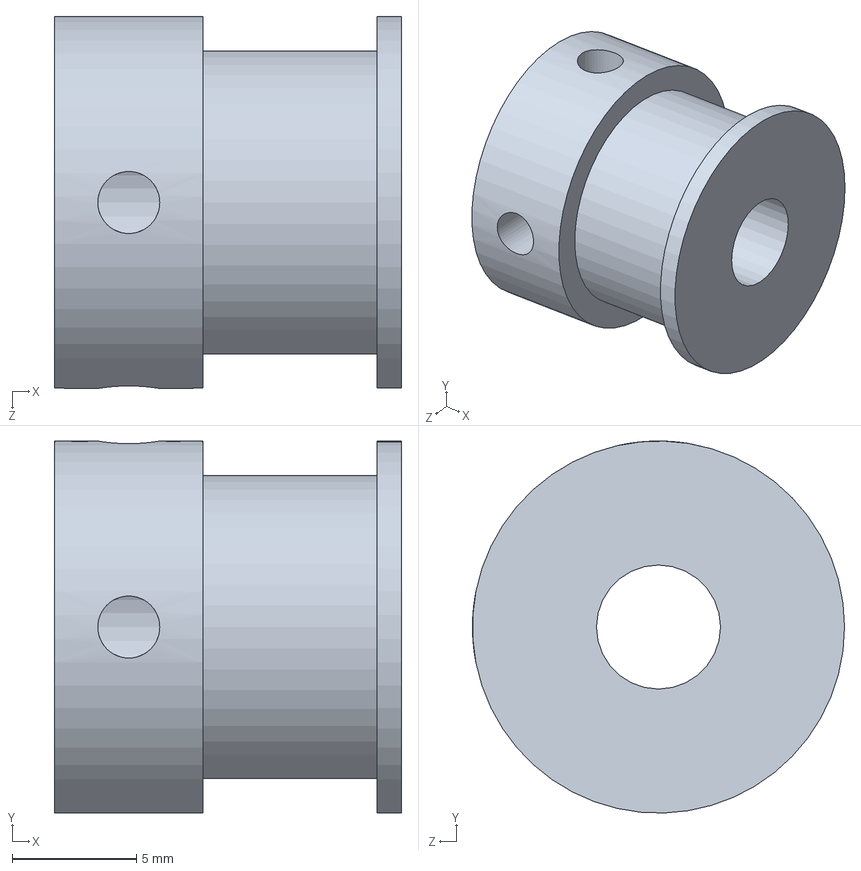
[picture p145: CAD file, 2018-04-12]
2_Mechanical/1_Solidworks_Model/Open_Source_Files/OpenBuilds Library/4 - Pulleys/GT2 Timing Pulley 20 Tooth.SLDPRT
14.0 x 15.0 x 15.0 mm
