tabdallah/capstone/2_Mechanical/1_Solidworks_Model/Open_Source_Files/OpenBuilds Library/5 - Brackets/Linear Actuator End Mount.SLDPRT

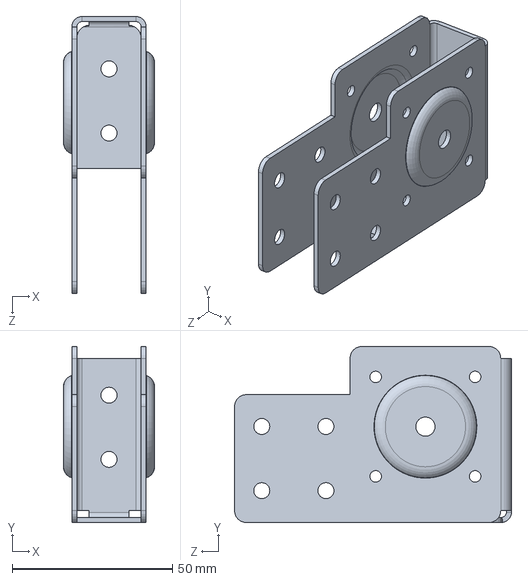
[picture p146: CAD file, 2018-03-15]
2_Mechanical/1_Solidworks_Model/Open_Source_Files/OpenBuilds Library/5 - Brackets/Linear Actuator End Mount.SLDPRT
28.4 x 54.9 x 86.3 mm
