tabdallah/capstone/2_Mechanical/1_Solidworks_Model/Open_Source_Files/OpenBuilds Library/6 - Electronics/Nema 17 Stepper Motor.SLDPRT

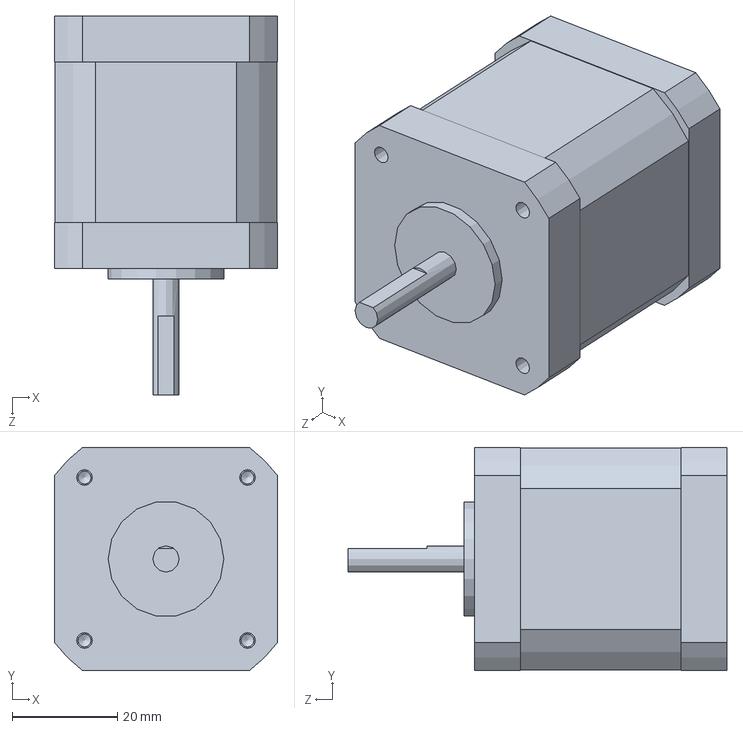
[picture p147: CAD file, 2018-03-15]
2_Mechanical/1_Solidworks_Model/Open_Source_Files/OpenBuilds Library/6 - Electronics/Nema 17 Stepper Motor.SLDPRT
42.4 x 42.4 x 72.0 mm
