tabdallah/capstone/2_Mechanical/1_Solidworks_Model/Open_Source_Files/OpenBuilds Library/8 - Plates/Idler Pulley Plate.SLDPRT

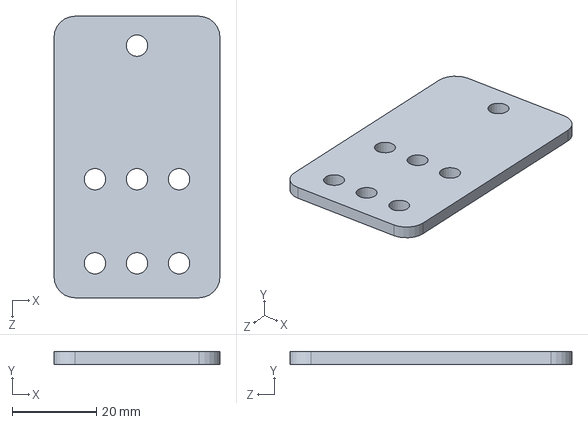
[picture p148: CAD file, 2018-03-28]
2_Mechanical/1_Solidworks_Model/Open_Source_Files/OpenBuilds Library/8 - Plates/Idler Pulley Plate.SLDPRT
39.5 x 3.00 x 67.0 mm
