tabdallah/capstone/2_Mechanical/1_Solidworks_Model/Open_Source_Files/OpenBuilds Library/Assemblies/Mini V Linear Actuator/GT2 Belt 1140mm.SLDPRT

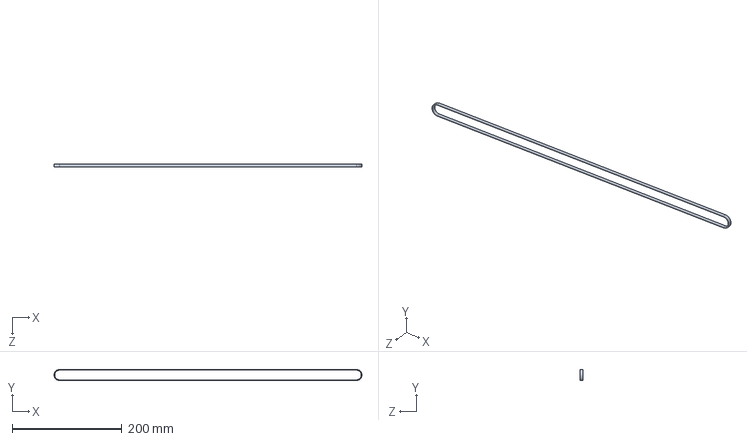
[picture p149: CAD file, 2018-03-15]
2_Mechanical/1_Solidworks_Model/Open_Source_Files/OpenBuilds Library/Assemblies/Mini V Linear Actuator/GT2 Belt 1140mm.SLDPRT
561.3 x 20.3 x 5.00 mm
