tabdallah/capstone/2_Mechanical/1_Solidworks_Model/Open_Source_Files/OpenBuilds Library/Assemblies/V Slot Belt and Pinion Actuator/GT2 Belt 530mm.SLDPRT

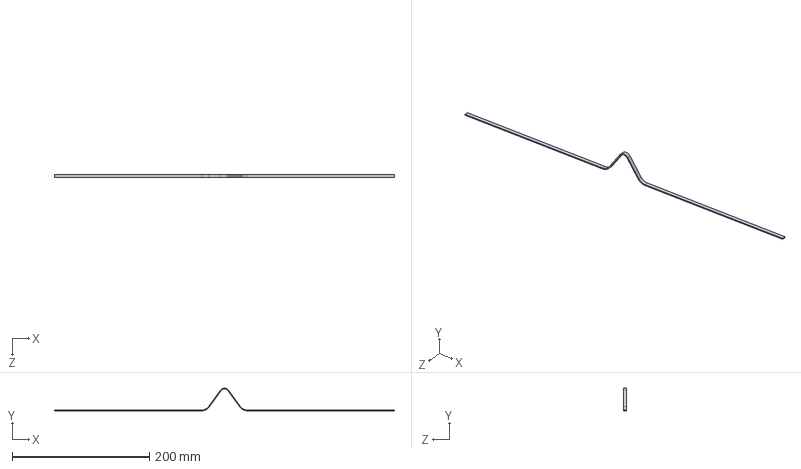
[picture p150: CAD file, 2018-02-02]
2_Mechanical/1_Solidworks_Model/Open_Source_Files/OpenBuilds Library/Assemblies/V Slot Belt and Pinion Actuator/GT2 Belt 530mm.SLDPRT
496.0 x 33.2 x 5.00 mm
