tabdallah/capstone/2_Mechanical/1_Solidworks_Model/V2.0_Design/1_Parts/Y-Axis_Connecting_Rod_Mount.SLDPRT

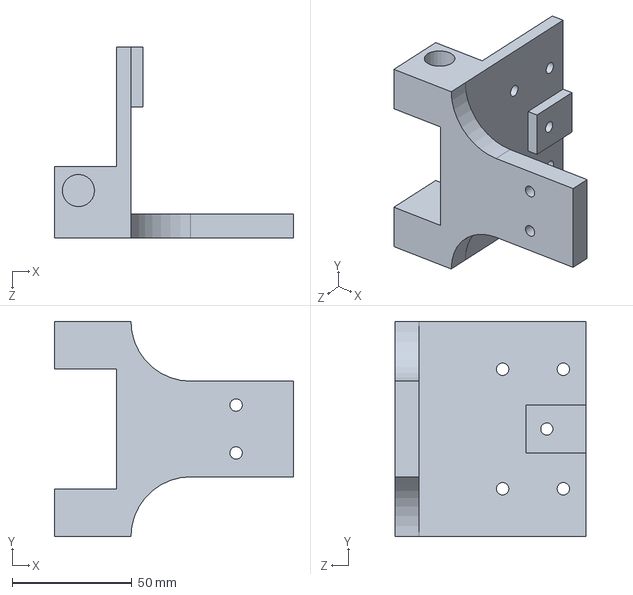
[picture p151: CAD file, 2018-07-24]
2_Mechanical/1_Solidworks_Model/V2.0_Design/1_Parts/Y-Axis_Connecting_Rod_Mount.SLDPRT
100.0 x 90.0 x 79.8 mm
