tabdallah/capstone/2_Mechanical/1_Solidworks_Model/Open_Source_Files/AHR_x_carriage_belt.SLDPRT

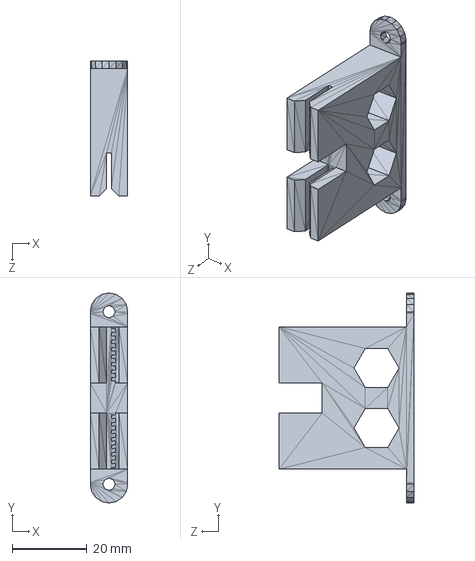
[picture p152: CAD file, 2018-03-15]
2_Mechanical/1_Solidworks_Model/Open_Source_Files/AHR_x_carriage_belt.SLDPRT
10.0 x 56.0 x 36.0 mm
