tabdallah/capstone/2_Mechanical/1_Solidworks_Model/Open_Source_Files/OpenBuilds Library/1 - Linear Rail/V-Slot 20x20x1000 Linear Rail.SLDPRT

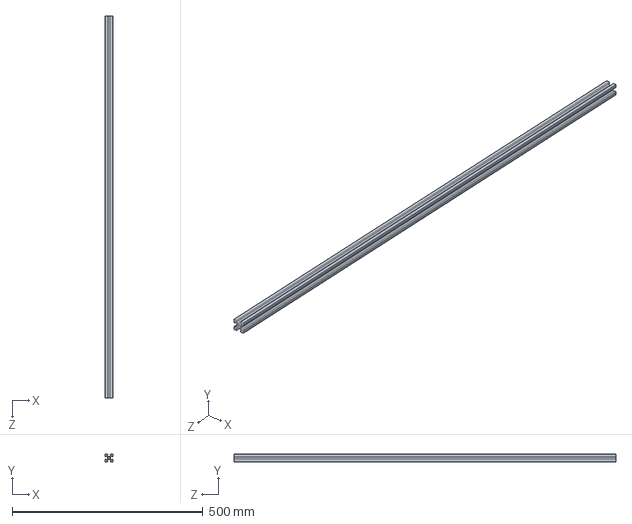
[picture p153: CAD file, 2018-03-28]
2_Mechanical/1_Solidworks_Model/Open_Source_Files/OpenBuilds Library/1 - Linear Rail/V-Slot 20x20x1000 Linear Rail.SLDPRT
20.0 x 20.0 x 1000.0 mm
