tabdallah/capstone/2_Mechanical/1_Solidworks_Model/Open_Source_Files/OpenBuilds Library/10 - Shims and Spacers/Nylon Spacer 0.125in.SLDPRT

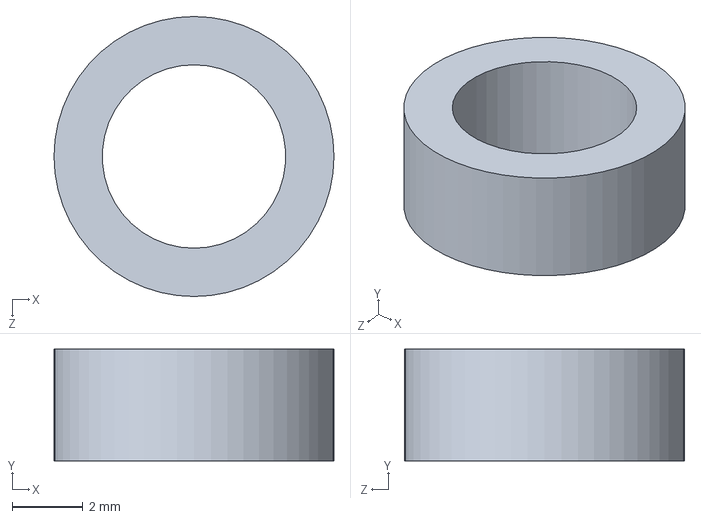
[picture p154: CAD file, 2018-03-15]
2_Mechanical/1_Solidworks_Model/Open_Source_Files/OpenBuilds Library/10 - Shims and Spacers/Nylon Spacer 0.125in.SLDPRT
7.94 x 3.17 x 7.94 mm
