tabdallah/capstone/2_Mechanical/1_Solidworks_Model/Open_Source_Files/OpenBuilds Library/2 - Wheels/Xtreme Solid V Wheel.SLDPRT

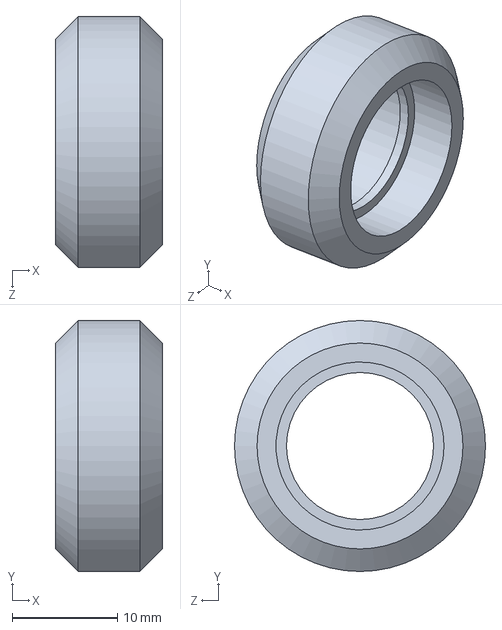
[picture p155: CAD file, 2018-02-02]
2_Mechanical/1_Solidworks_Model/Open_Source_Files/OpenBuilds Library/2 - Wheels/Xtreme Solid V Wheel.SLDPRT
10.2 x 23.9 x 23.9 mm
