tabdallah/capstone/2_Mechanical/1_Solidworks_Model/Open_Source_Files/OpenBuilds Library/3 - Bearings/Ball Bearing 5 x 16 x 5.SLDPRT

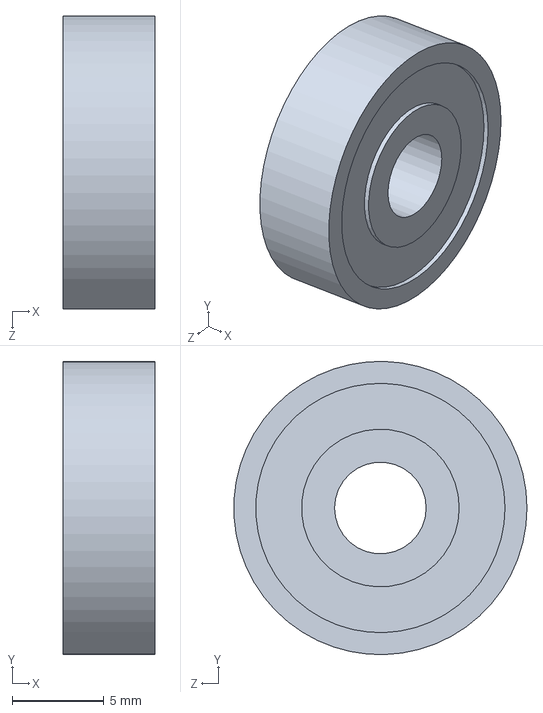
[picture p156: CAD file, 2018-03-15]
2_Mechanical/1_Solidworks_Model/Open_Source_Files/OpenBuilds Library/3 - Bearings/Ball Bearing 5 x 16 x 5.SLDPRT
5.00 x 16.0 x 16.0 mm
