tabdallah/capstone/2_Mechanical/1_Solidworks_Model/Open_Source_Files/OpenBuilds Library/4 - Pulleys/GT2 Timing Pulley 30 Tooth.SLDPRT

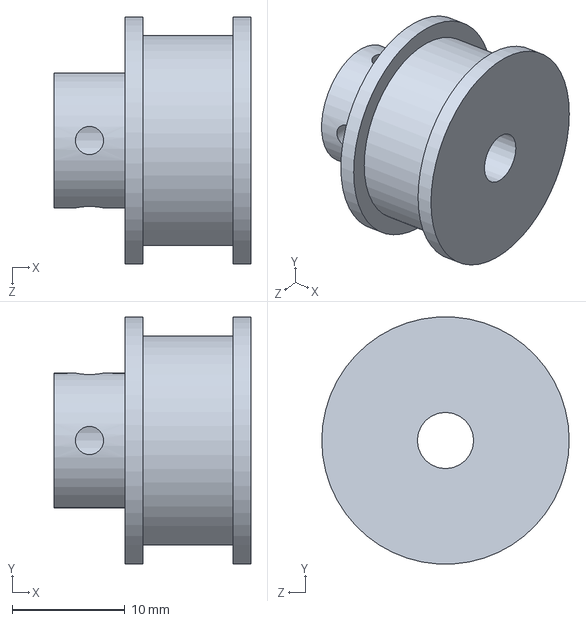
[picture p157: CAD file, 2018-03-15]
2_Mechanical/1_Solidworks_Model/Open_Source_Files/OpenBuilds Library/4 - Pulleys/GT2 Timing Pulley 30 Tooth.SLDPRT
17.5 x 22.0 x 22.0 mm
