tabdallah/capstone/2_Mechanical/1_Solidworks_Model/Open_Source_Files/OpenBuilds Library/5 - Brackets/End Cap.SLDPRT

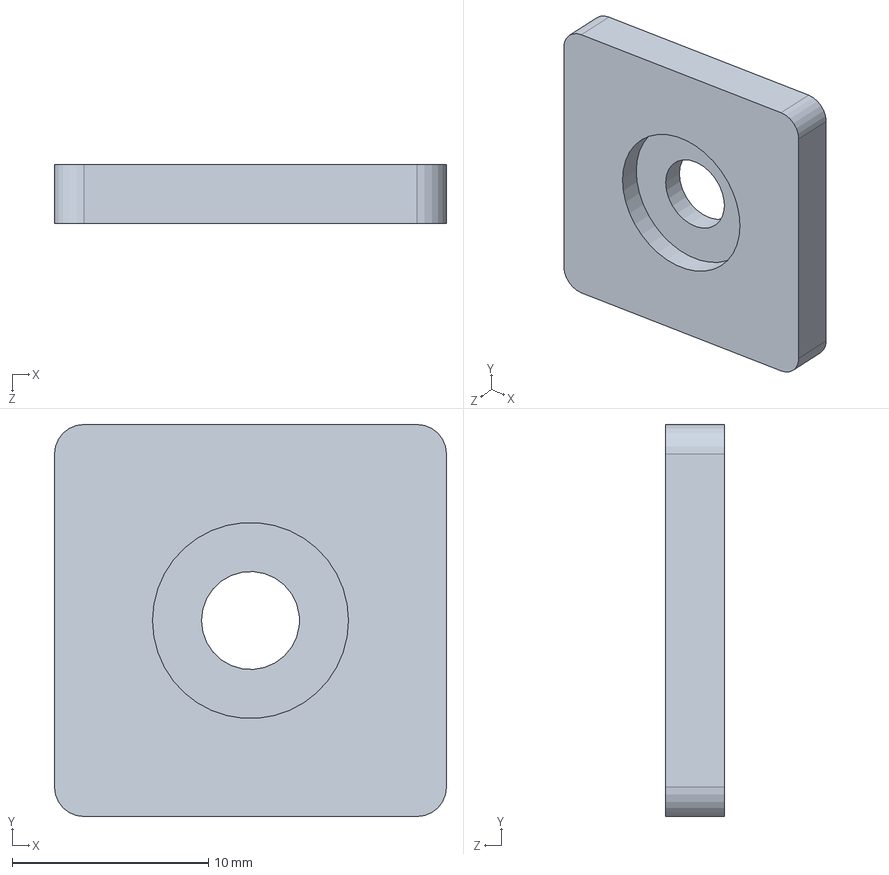
[picture p158: CAD file, 2018-02-02]
2_Mechanical/1_Solidworks_Model/Open_Source_Files/OpenBuilds Library/5 - Brackets/End Cap.SLDPRT
20.0 x 20.0 x 3.00 mm
