tabdallah/capstone/2_Mechanical/1_Solidworks_Model/Open_Source_Files/OpenBuilds Library/6 - Electronics/Mini Heated Bed.SLDPRT

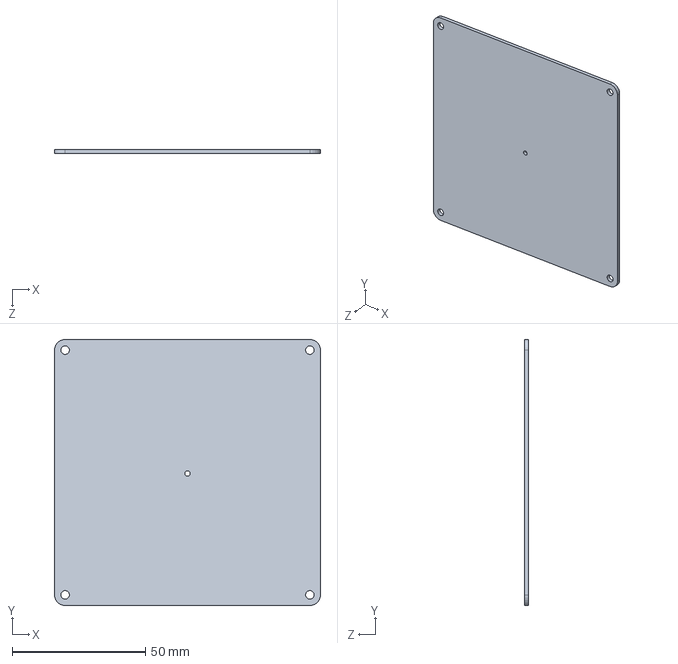
[picture p159: CAD file, 2018-02-02]
2_Mechanical/1_Solidworks_Model/Open_Source_Files/OpenBuilds Library/6 - Electronics/Mini Heated Bed.SLDPRT
100.0 x 100.0 x 1.60 mm
