tabdallah/capstone/2_Mechanical/1_Solidworks_Model/Open_Source_Files/OpenBuilds Library/8 - Plates/Mini V Wheel Plate.SLDPRT

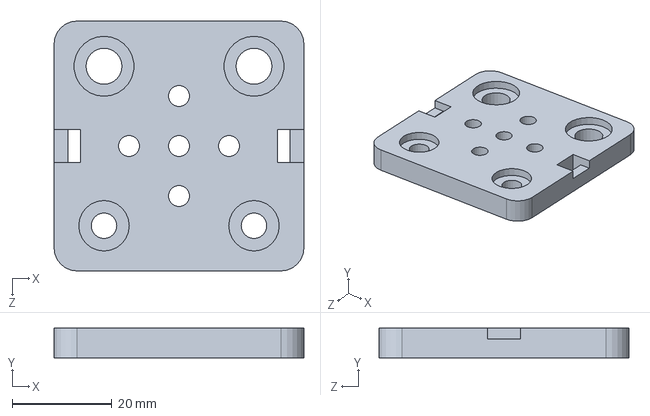
[picture p160: CAD file, 2018-03-15]
2_Mechanical/1_Solidworks_Model/Open_Source_Files/OpenBuilds Library/8 - Plates/Mini V Wheel Plate.SLDPRT
50.0 x 6.00 x 50.0 mm
