tabdallah/capstone/2_Mechanical/1_Solidworks_Model/Open_Source_Files/OpenBuilds Library/Assemblies/V Slot Belt and Pinion Actuator/V-Slot 20x40x80 Linear Rail.SLDPRT

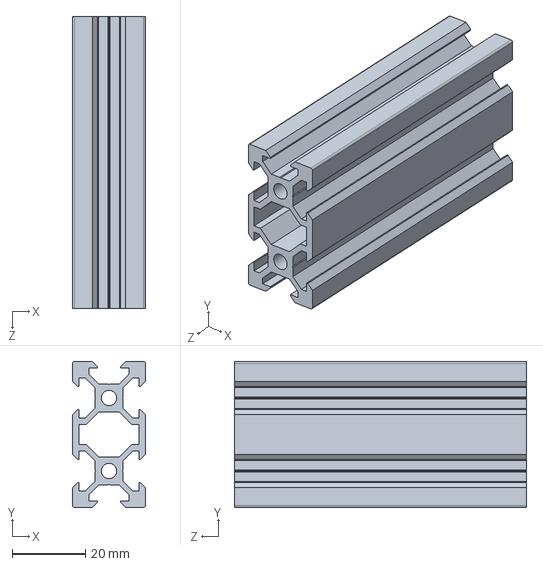
[picture p161: CAD file, 2018-02-02]
2_Mechanical/1_Solidworks_Model/Open_Source_Files/OpenBuilds Library/Assemblies/V Slot Belt and Pinion Actuator/V-Slot 20x40x80 Linear Rail.SLDPRT
20.0 x 40.0 x 80.0 mm
