tabdallah/capstone/2_Mechanical/1_Solidworks_Model/V2.0_Design/1_Parts/Y-Axis_Connecting_Rod_Bearing.SLDPRT

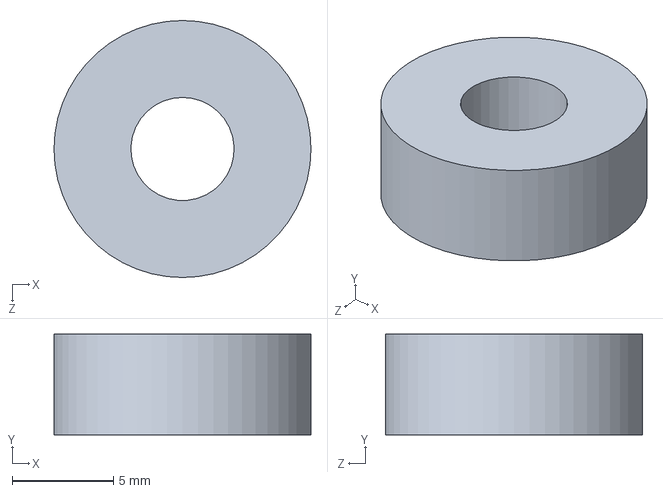
[picture p162: CAD file, 2018-07-24]
2_Mechanical/1_Solidworks_Model/V2.0_Design/1_Parts/Y-Axis_Connecting_Rod_Bearing.SLDPRT
12.7 x 4.98 x 12.7 mm
