tabdallah/capstone/2_Mechanical/1_Solidworks_Model/V2.0_STL/LB8UU_3D_Printed.STL

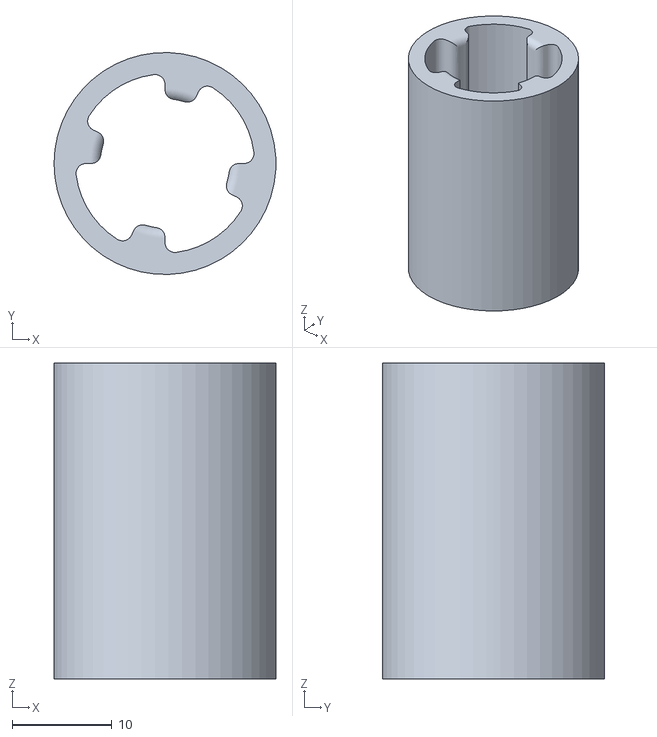
[picture p163: CAD file, 2018-07-16]
2_Mechanical/1_Solidworks_Model/V2.0_STL/LB8UU_3D_Printed.STL
22.3 x 22.3 x 31.7
