tabdallah/capstone/2_Mechanical/1_Solidworks_Model/Open_Source_Files/LM8UU.SLDPRT

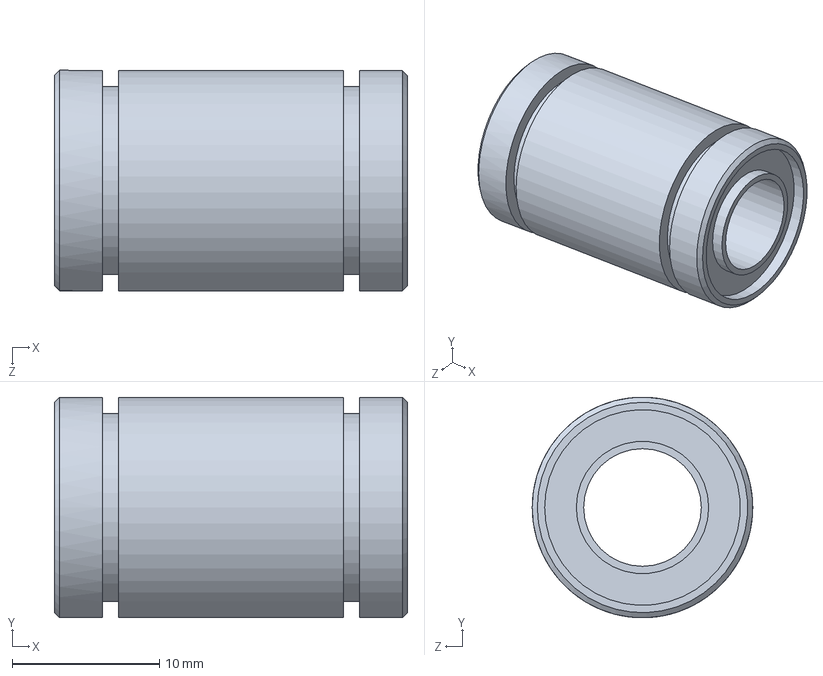
[picture p164: CAD file, 2018-03-15]
2_Mechanical/1_Solidworks_Model/Open_Source_Files/LM8UU.SLDPRT
24.0 x 15.0 x 15.0 mm
