tabdallah/capstone/2_Mechanical/1_Solidworks_Model/Open_Source_Files/OpenBuilds Library/1 - Linear Rail/V-Slot 20x40x500 Linear Rail.SLDPRT

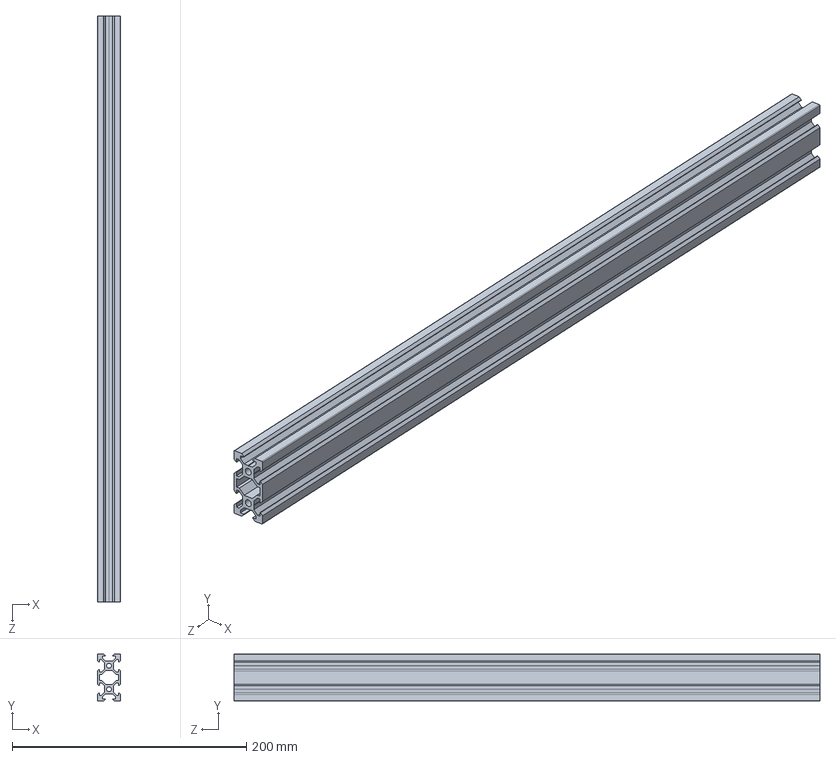
[picture p165: CAD file, 2018-03-15]
2_Mechanical/1_Solidworks_Model/Open_Source_Files/OpenBuilds Library/1 - Linear Rail/V-Slot 20x40x500 Linear Rail.SLDPRT
20.0 x 40.0 x 500.0 mm
