tabdallah/capstone/2_Mechanical/1_Solidworks_Model/Open_Source_Files/OpenBuilds Library/10 - Shims and Spacers/Precision Shim 8 x 5 x 1.SLDPRT

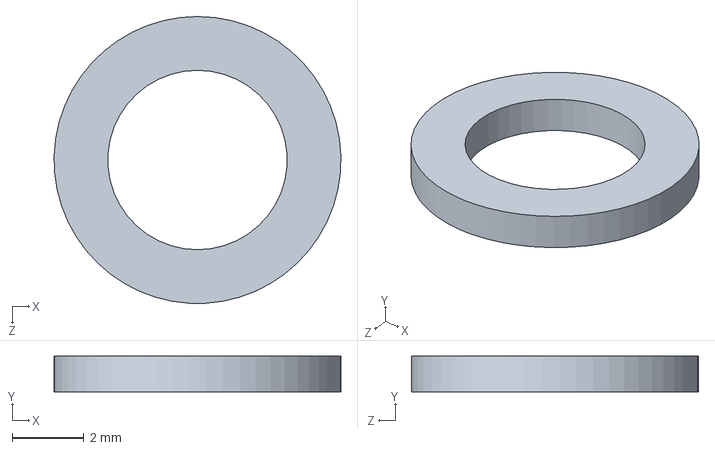
[picture p166: CAD file, 2018-03-15]
2_Mechanical/1_Solidworks_Model/Open_Source_Files/OpenBuilds Library/10 - Shims and Spacers/Precision Shim 8 x 5 x 1.SLDPRT
8.00 x 1.00 x 8.00 mm
