tabdallah/capstone/2_Mechanical/1_Solidworks_Model/Open_Source_Files/OpenBuilds Library/4 - Pulleys/Smooth Idler Pulley Wheel.SLDPRT

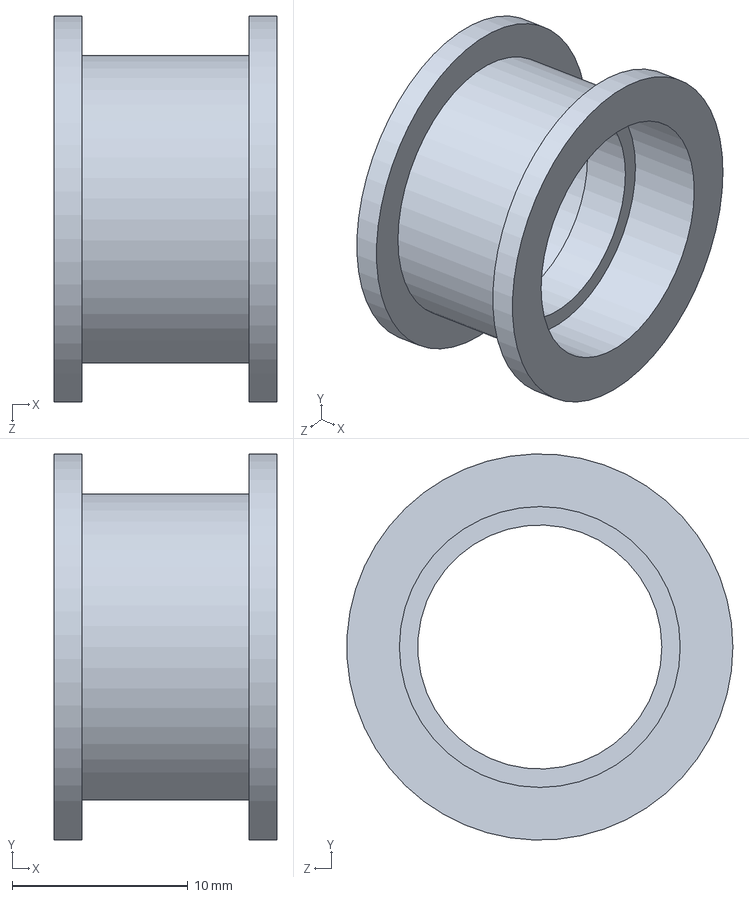
[picture p169: CAD file, 2018-03-15]
2_Mechanical/1_Solidworks_Model/Open_Source_Files/OpenBuilds Library/4 - Pulleys/Smooth Idler Pulley Wheel.SLDPRT
12.7 x 22.0 x 22.0 mm
