tabdallah/capstone/2_Mechanical/1_Solidworks_Model/Open_Source_Files/OpenBuilds Library/5 - Brackets/L Bracket Triple.SLDPRT

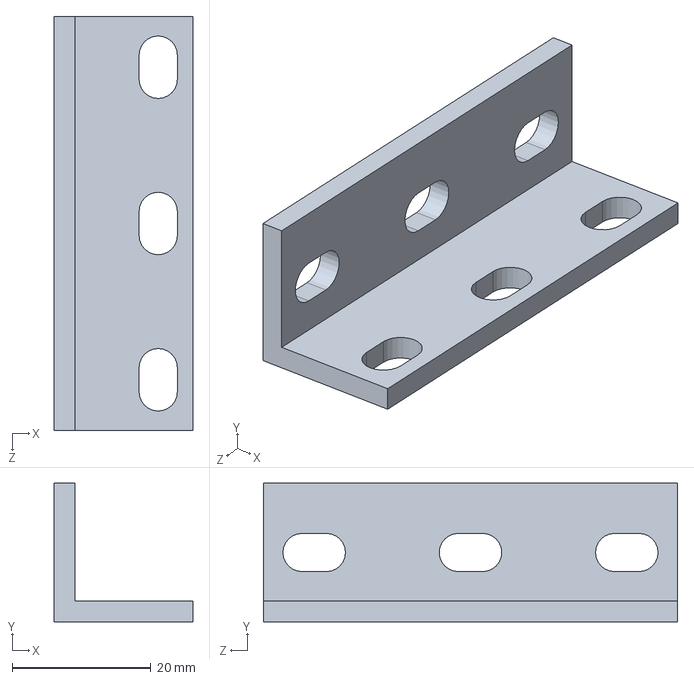
[picture p170: CAD file, 2018-02-02]
2_Mechanical/1_Solidworks_Model/Open_Source_Files/OpenBuilds Library/5 - Brackets/L Bracket Triple.SLDPRT
20.0 x 20.0 x 59.6 mm
