tabdallah/capstone/2_Mechanical/1_Solidworks_Model/Open_Source_Files/OpenBuilds Library/6 - Electronics/Nema 23 High Torque Stepper Motor.SLDPRT

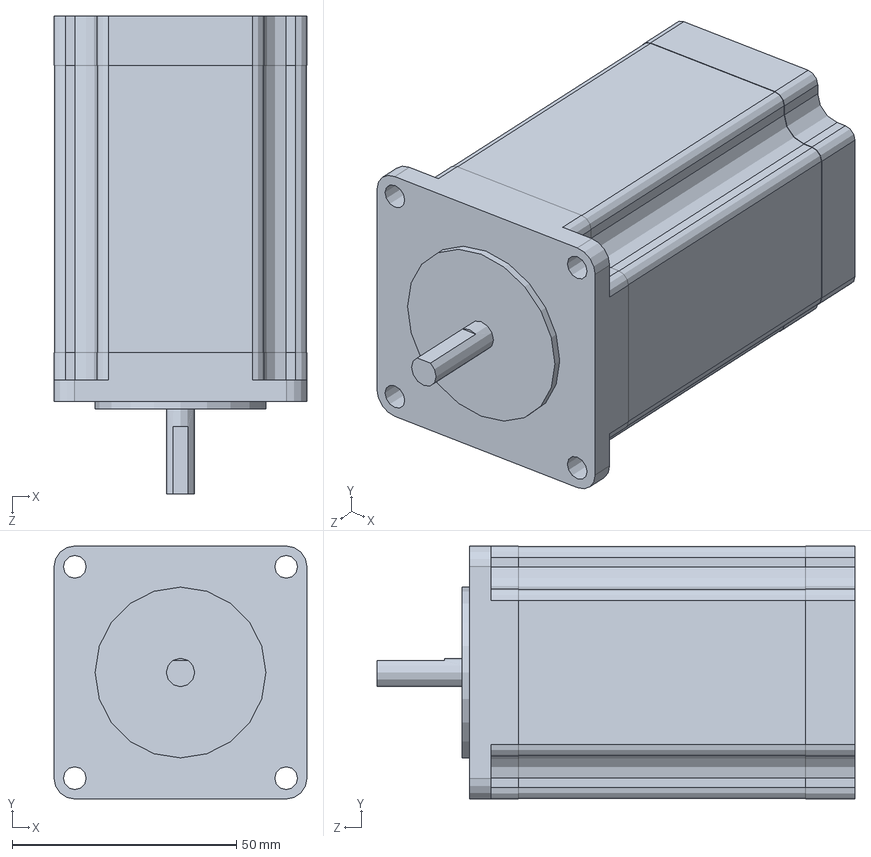
[picture p171: CAD file, 2018-02-02]
2_Mechanical/1_Solidworks_Model/Open_Source_Files/OpenBuilds Library/6 - Electronics/Nema 23 High Torque Stepper Motor.SLDPRT
56.4 x 56.4 x 106.6 mm
