tabdallah/capstone/2_Mechanical/1_Solidworks_Model/Open_Source_Files/OpenBuilds Library/8 - Plates/Threaded Rod Plate Nema 23.SLDPRT

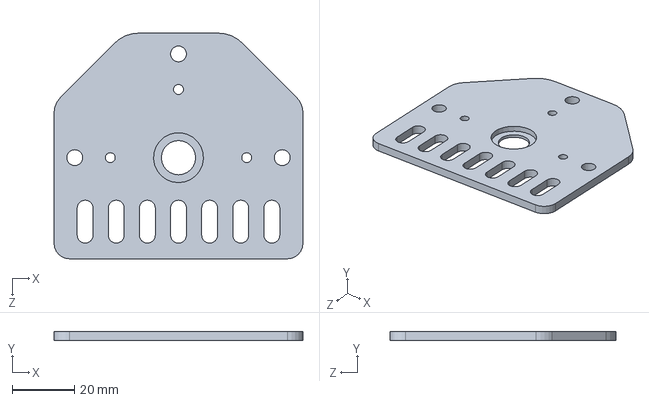
[picture p172: CAD file, 2018-02-02]
2_Mechanical/1_Solidworks_Model/Open_Source_Files/OpenBuilds Library/8 - Plates/Threaded Rod Plate Nema 23.SLDPRT
80.0 x 3.00 x 72.5 mm
