tabdallah/capstone/2_Mechanical/1_Solidworks_Model/Open_Source_Files/OpenBuilds Library/Assemblies/V Slot Belt Driven Actuator/GT3 Belt 1160mm.SLDPRT

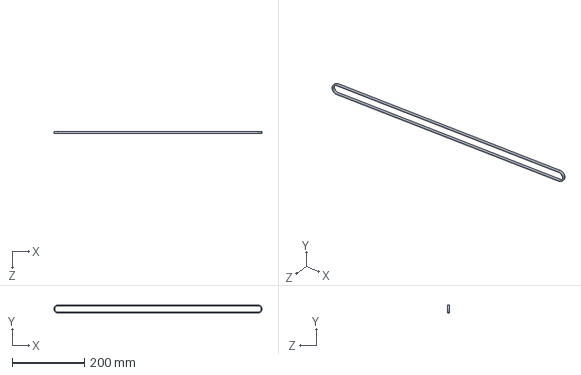
[picture p173: CAD file, 2018-02-02]
2_Mechanical/1_Solidworks_Model/Open_Source_Files/OpenBuilds Library/Assemblies/V Slot Belt Driven Actuator/GT3 Belt 1160mm.SLDPRT
574.1 x 22.3 x 5.00 mm
