tabdallah/capstone/2_Mechanical/1_Solidworks_Model/V2.0_Design/1_Parts/X-Axis_Rod.SLDPRT

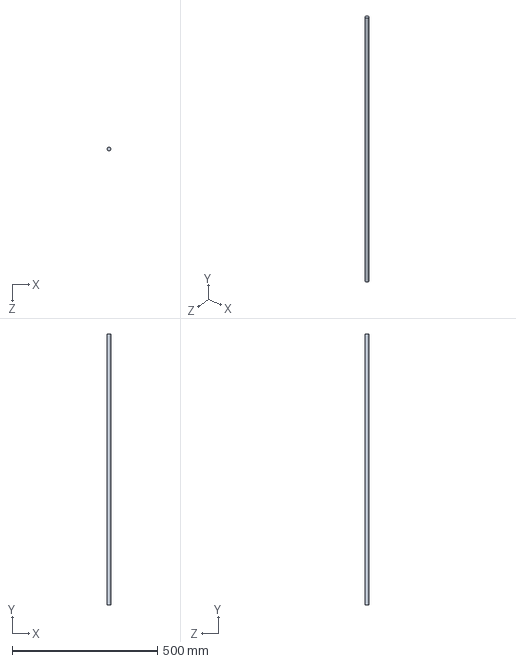
[picture p174: CAD file, 2018-07-24]
2_Mechanical/1_Solidworks_Model/V2.0_Design/1_Parts/X-Axis_Rod.SLDPRT
12.7 x 934.4 x 12.7 mm
