tabdallah/capstone/2_Mechanical/1_Solidworks_Model/V2.0_STL/limit_switch_mount_top.STL

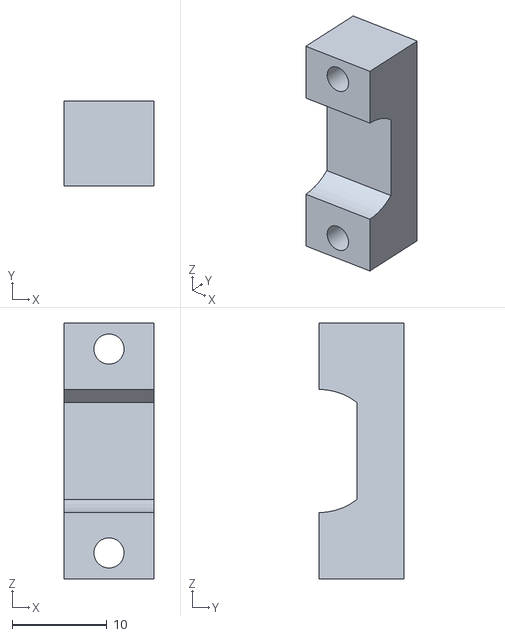
[picture p175: CAD file, 2018-07-13]
2_Mechanical/1_Solidworks_Model/V2.0_STL/limit_switch_mount_top.STL
9.53 x 9.00 x 27.0
