tabdallah/capstone/2_Mechanical/1_Solidworks_Model/Open_Source_Files/AHR_x_carriage.SLDPRT

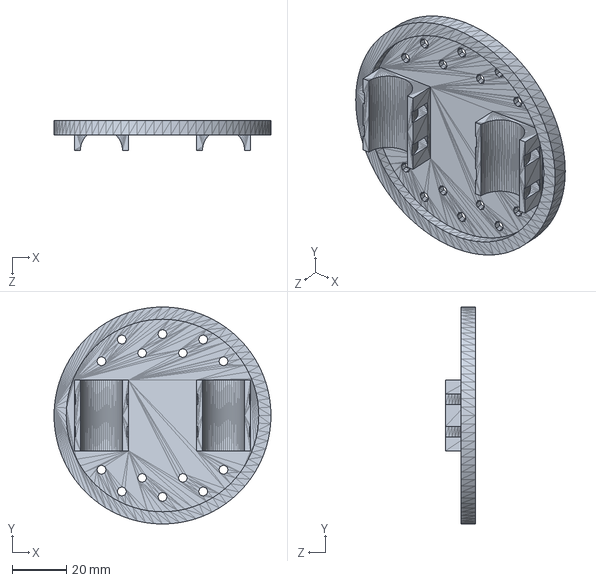
[picture p176: CAD file, 2018-03-15]
2_Mechanical/1_Solidworks_Model/Open_Source_Files/AHR_x_carriage.SLDPRT
80.0 x 80.0 x 11.0 mm
