tabdallah/capstone/2_Mechanical/1_Solidworks_Model/Open_Source_Files/OpenBuilds Library/10 - Shims and Spacers/Aluminum Spacer .125in.SLDPRT

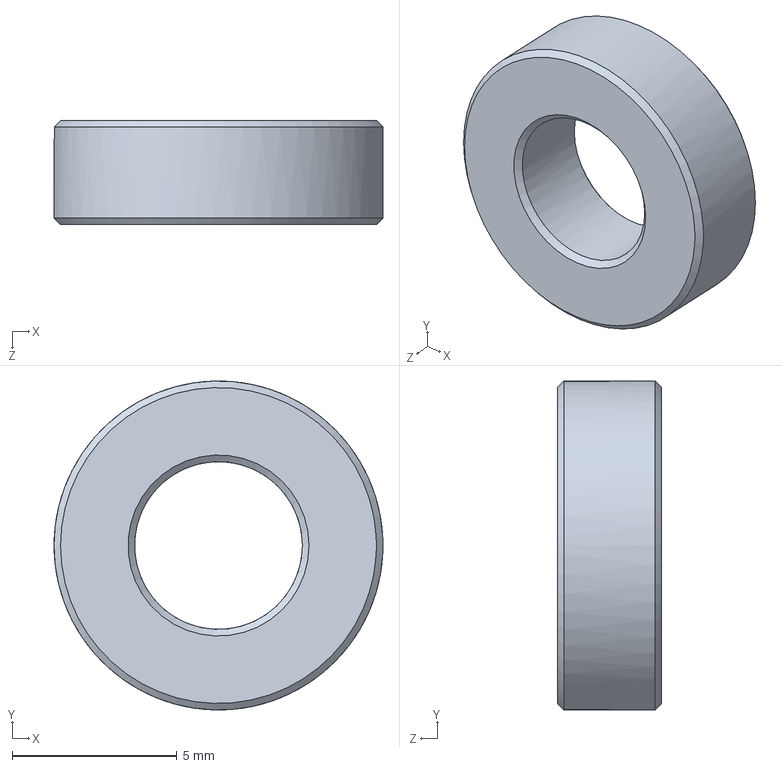
[picture p178: CAD file, 2018-03-15]
2_Mechanical/1_Solidworks_Model/Open_Source_Files/OpenBuilds Library/10 - Shims and Spacers/Aluminum Spacer .125in.SLDPRT
10.0 x 10.00 x 3.17 mm
