tabdallah/capstone/2_Mechanical/1_Solidworks_Model/Open_Source_Files/OpenBuilds Library/5 - Brackets/V-Slot Door Handle.SLDPRT

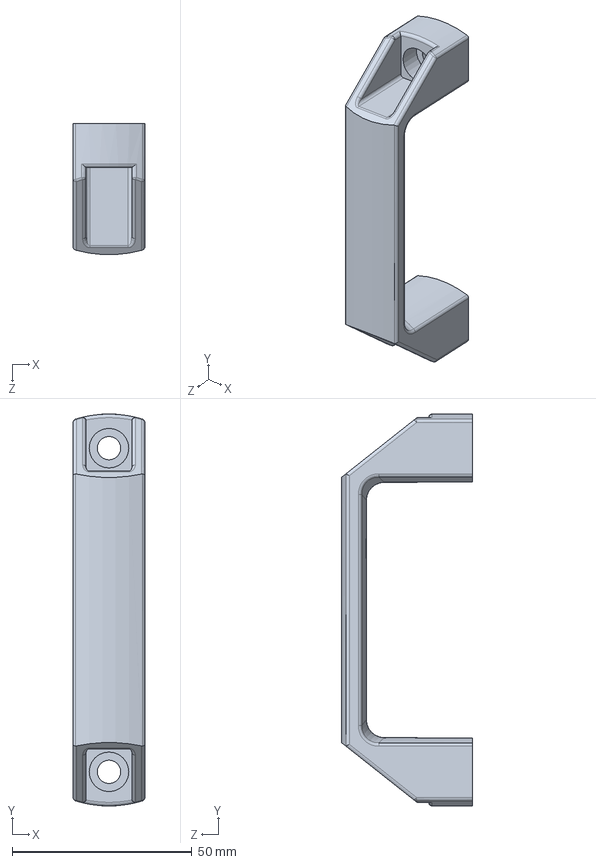
[picture p180: CAD file, 2018-02-02]
2_Mechanical/1_Solidworks_Model/Open_Source_Files/OpenBuilds Library/5 - Brackets/V-Slot Door Handle.SLDPRT
20.0 x 109.0 x 36.4 mm
