tabdallah/capstone/2_Mechanical/1_Solidworks_Model/Open_Source_Files/OpenBuilds Library/6 - Electronics/Micro Limit Switch.SLDPRT

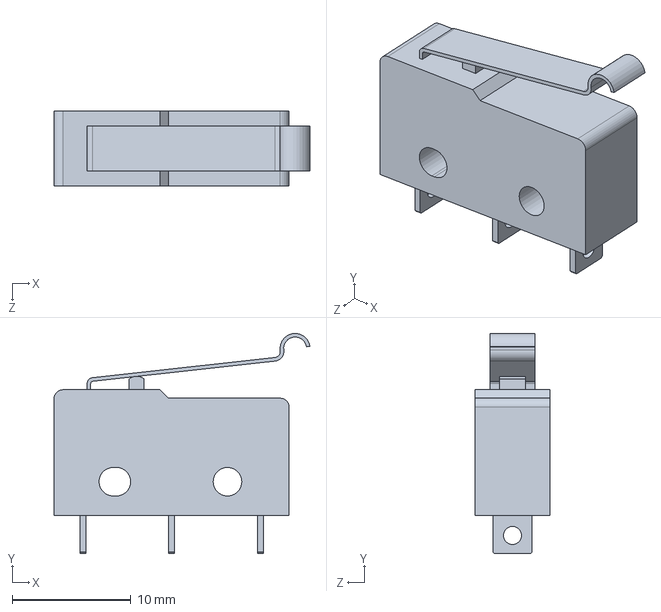
[picture p181: CAD file, 2018-02-02]
2_Mechanical/1_Solidworks_Model/Open_Source_Files/OpenBuilds Library/6 - Electronics/Micro Limit Switch.SLDPRT
21.6 x 18.6 x 6.35 mm
