tabdallah/capstone/2_Mechanical/1_Solidworks_Model/Open_Source_Files/OpenBuilds Library/8 - Plates/Universal Build Plate.SLDPRT

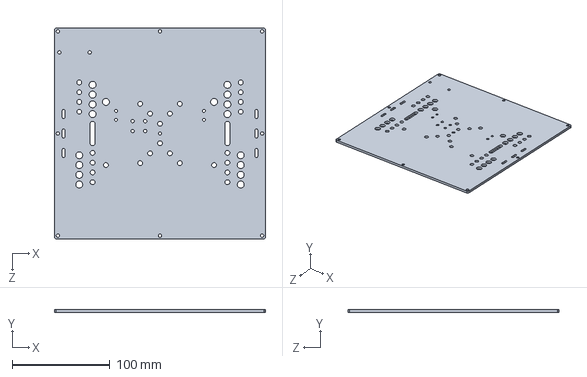
[picture p182: CAD file, 2018-02-02]
2_Mechanical/1_Solidworks_Model/Open_Source_Files/OpenBuilds Library/8 - Plates/Universal Build Plate.SLDPRT
216.0 x 3.00 x 216.0 mm
