tabdallah/capstone/2_Mechanical/1_Solidworks_Model/Open_Source_Files/OpenBuilds Library/Assemblies/V Slot Belt Driven Actuator/GT2 Belt 1120mm.SLDPRT

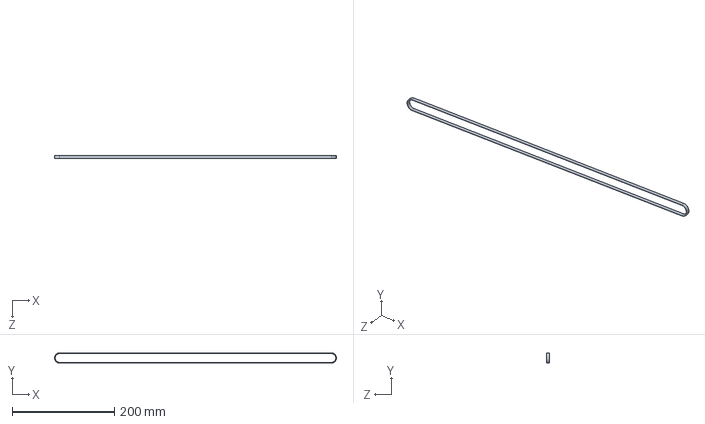
[picture p183: CAD file, 2018-02-02]
2_Mechanical/1_Solidworks_Model/Open_Source_Files/OpenBuilds Library/Assemblies/V Slot Belt Driven Actuator/GT2 Belt 1120mm.SLDPRT
552.3 x 20.3 x 5.00 mm
