tabdallah/capstone/2_Mechanical/1_Solidworks_Model/V2.0_Design/1_Parts/LBB8UU.SLDPRT

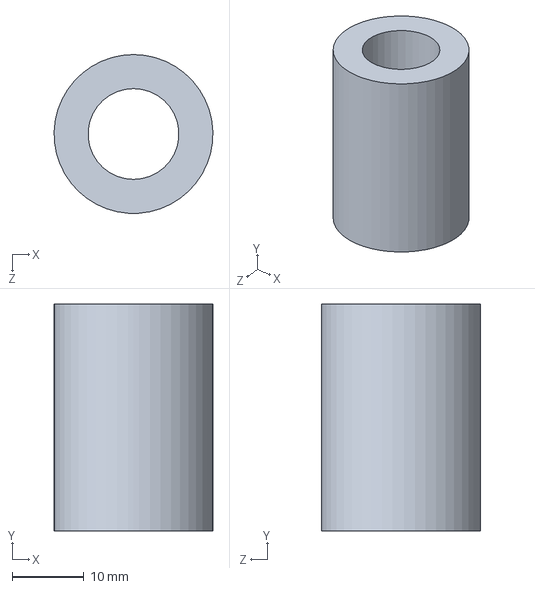
[picture p184: CAD file, 2018-07-16]
2_Mechanical/1_Solidworks_Model/V2.0_Design/1_Parts/LBB8UU.SLDPRT
22.2 x 31.8 x 22.2 mm
