tabdallah/capstone/2_Mechanical/1_Solidworks_Model/V2.0_STL/X-Axis_Paddle_Top.STL

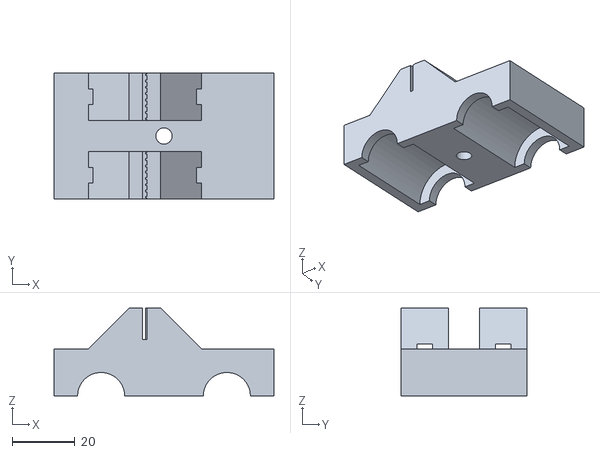
[picture p185: CAD file, 2018-07-13]
2_Mechanical/1_Solidworks_Model/V2.0_STL/X-Axis_Paddle_Top.STL
70.0 x 40.0 x 28.0
