tabdallah/capstone/2_Mechanical/1_Solidworks_Model/Open_Source_Files/OpenBuilds Library/10 - Shims and Spacers/Mini Eccentric Spacer 6mm.SLDPRT

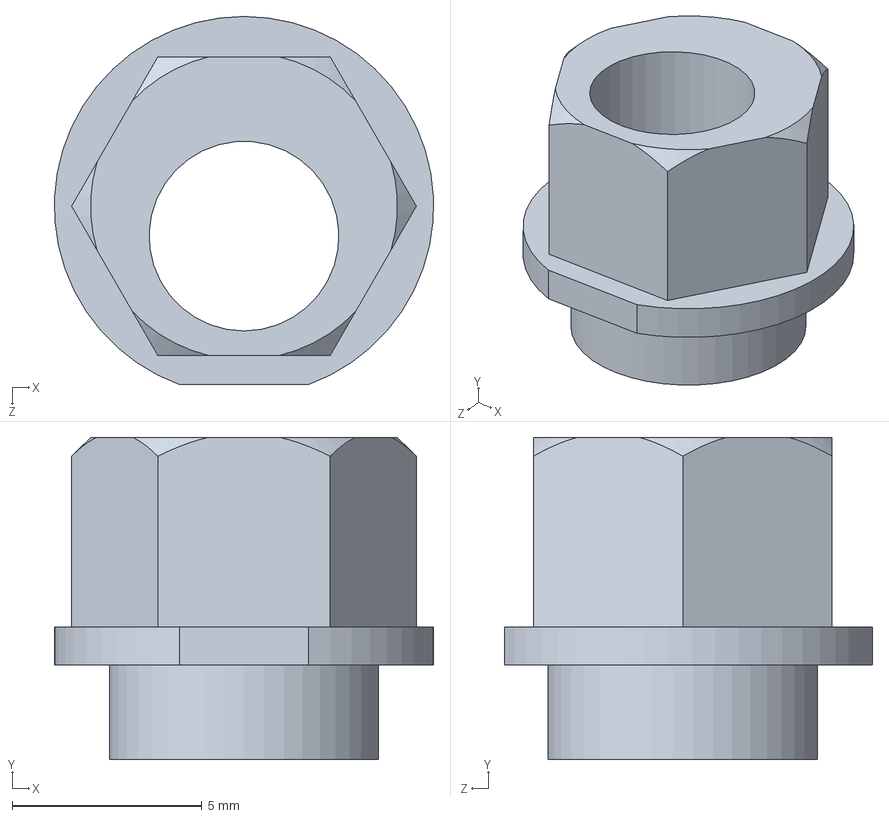
[picture p187: CAD file, 2018-03-15]
2_Mechanical/1_Solidworks_Model/Open_Source_Files/OpenBuilds Library/10 - Shims and Spacers/Mini Eccentric Spacer 6mm.SLDPRT
9.99 x 8.50 x 9.70 mm
