tabdallah/capstone/2_Mechanical/1_Solidworks_Model/Open_Source_Files/OpenBuilds Library/4 - Pulleys/GT3 Timing Pulley 20 Tooth 9mm Belt.SLDPRT

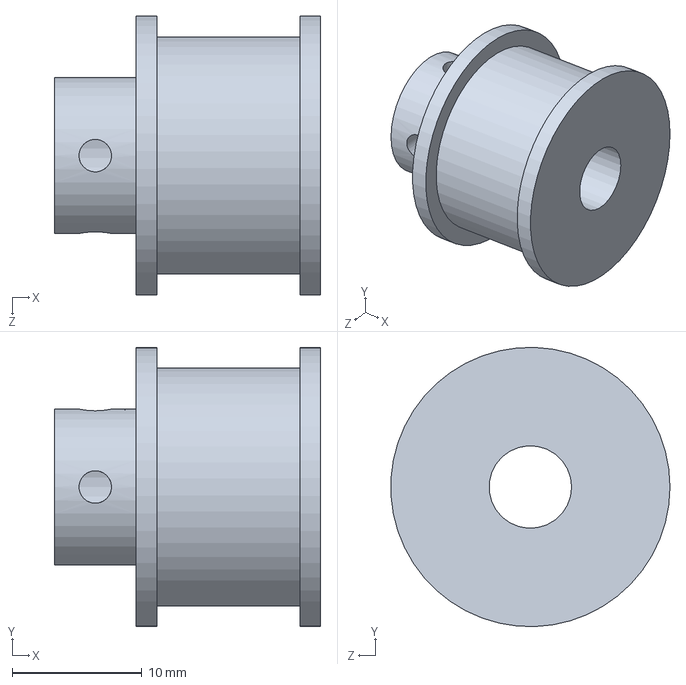
[picture p188: CAD file, 2018-02-02]
2_Mechanical/1_Solidworks_Model/Open_Source_Files/OpenBuilds Library/4 - Pulleys/GT3 Timing Pulley 20 Tooth 9mm Belt.SLDPRT
20.5 x 21.5 x 21.5 mm
