tabdallah/capstone/2_Mechanical/1_Solidworks_Model/Open_Source_Files/OpenBuilds Library/5 - Brackets/Router Spindle Mount.SLDPRT

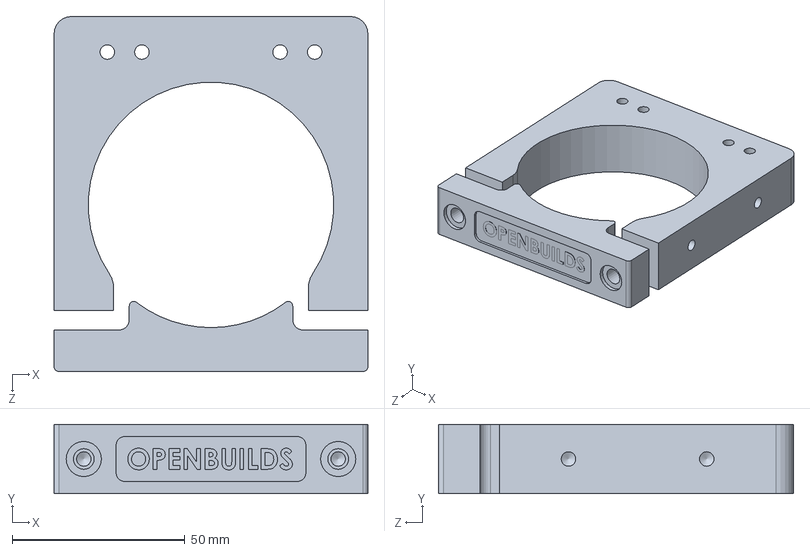
[picture p189: CAD file, 2018-02-02]
2_Mechanical/1_Solidworks_Model/Open_Source_Files/OpenBuilds Library/5 - Brackets/Router Spindle Mount.SLDPRT
90.8 x 20.0 x 102.7 mm
