tabdallah/capstone/2_Mechanical/1_Solidworks_Model/Open_Source_Files/OpenBuilds Library/7 - Hardware/Lock Collar 8mm.SLDPRT

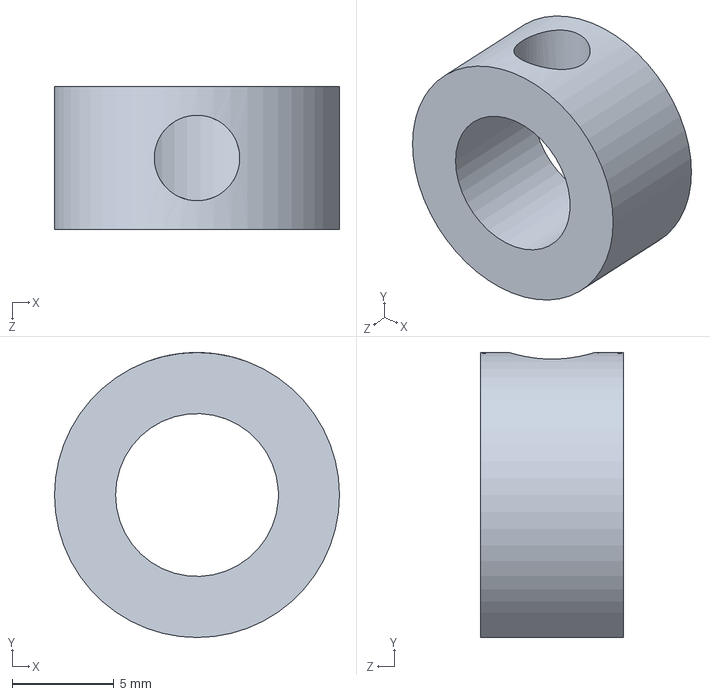
[picture p191: CAD file, 2018-02-02]
2_Mechanical/1_Solidworks_Model/Open_Source_Files/OpenBuilds Library/7 - Hardware/Lock Collar 8mm.SLDPRT
14.0 x 14.0 x 7.00 mm
