tabdallah/capstone/2_Mechanical/1_Solidworks_Model/Open_Source_Files/OpenBuilds Library/8 - Plates/C-Beam Shield 250mm.SLDPRT

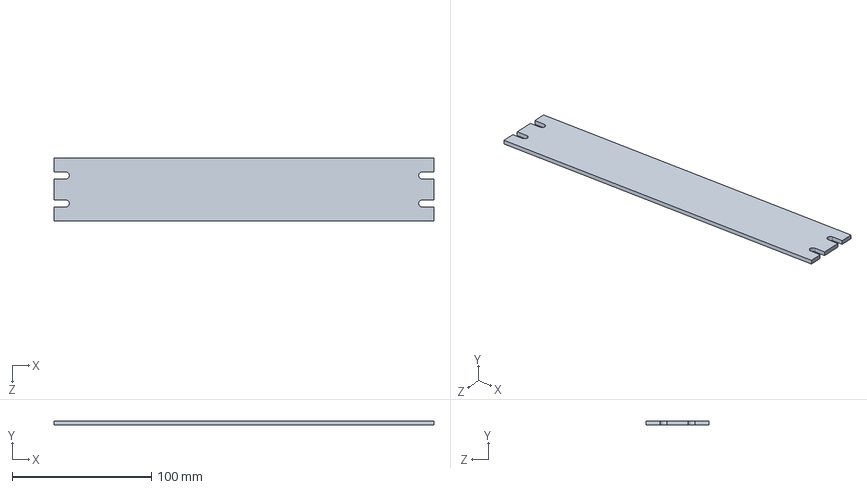
[picture p192: CAD file, 2018-02-02]
2_Mechanical/1_Solidworks_Model/Open_Source_Files/OpenBuilds Library/8 - Plates/C-Beam Shield 250mm.SLDPRT
273.0 x 3.00 x 45.0 mm
