tabdallah/capstone/2_Mechanical/1_Solidworks_Model/Open_Source_Files/puck_v2.stl

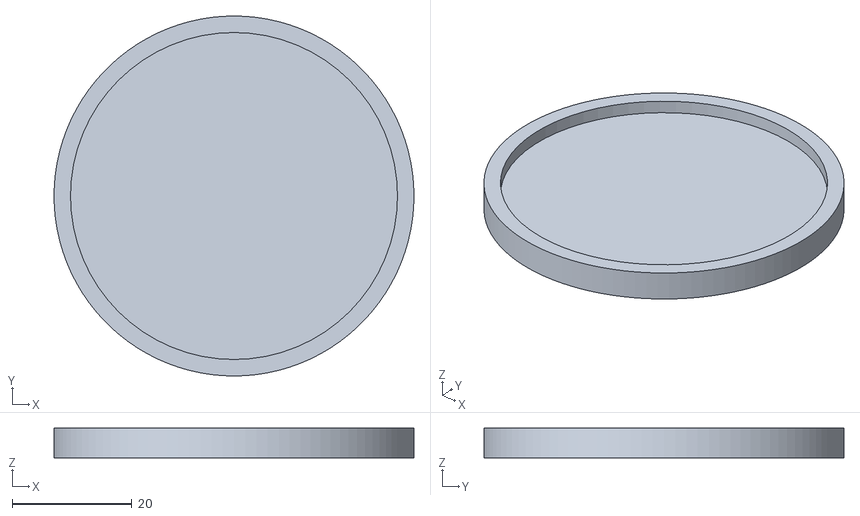
[picture p194: CAD file, 2018-02-02]
2_Mechanical/1_Solidworks_Model/Open_Source_Files/puck_v2.stl
60.0 x 60.0 x 5.00
