tabdallah/capstone/2_Mechanical/1_Solidworks_Model/V2.0_STL/Y-Axis_Rod_Mount.STL

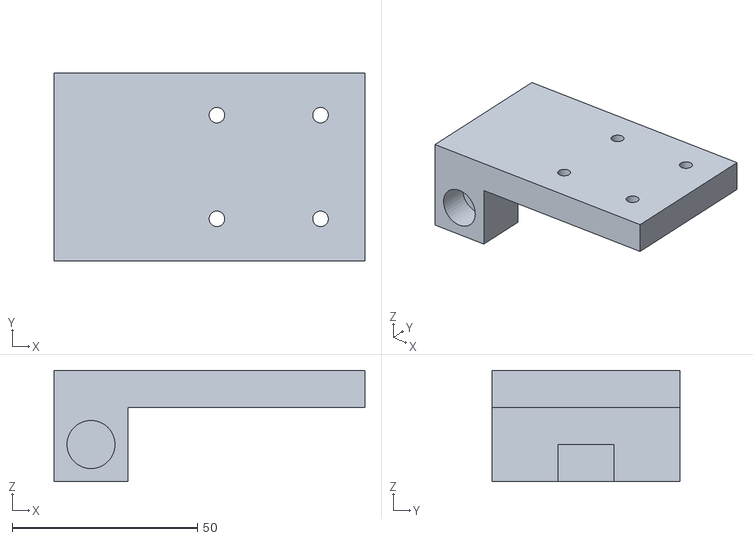
[picture p195: CAD file, 2018-07-13]
2_Mechanical/1_Solidworks_Model/V2.0_STL/Y-Axis_Rod_Mount.STL
84.0 x 50.8 x 30.0
