tabdallah/capstone/2_Mechanical/1_Solidworks_Model/Open_Source_Files/AHR_y_carriage.SLDPRT

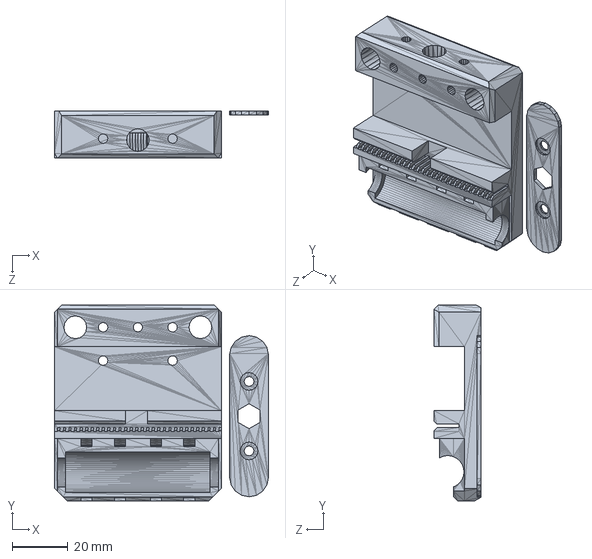
[picture p196: CAD file, 2018-02-02]
2_Mechanical/1_Solidworks_Model/Open_Source_Files/AHR_y_carriage.SLDPRT
77.0 x 70.5 x 17.0 mm
