tabdallah/capstone/2_Mechanical/1_Solidworks_Model/Open_Source_Files/OpenBuilds Library/4 - Pulleys/GT3 Timing Pulley 20 Tooth 9mm Belt 8mm Clamp Bore.SLDPRT

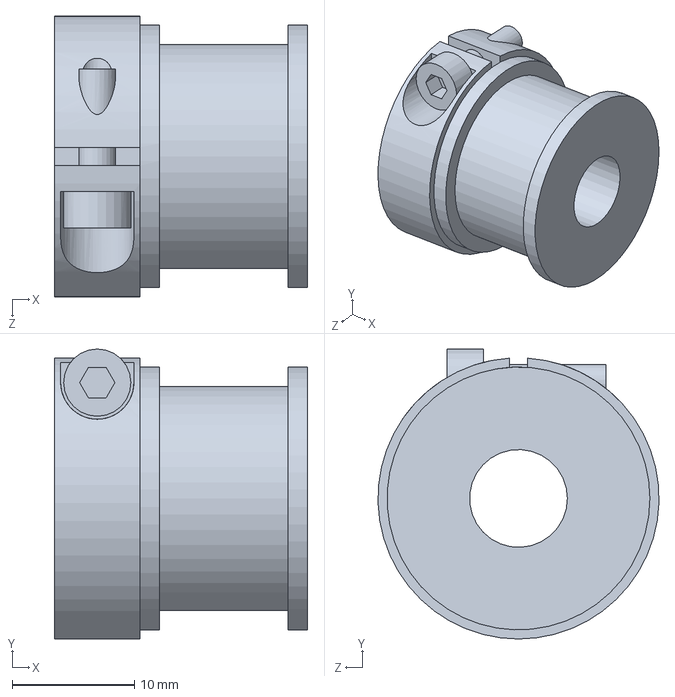
[picture p199: CAD file, 2018-02-02]
2_Mechanical/1_Solidworks_Model/Open_Source_Files/OpenBuilds Library/4 - Pulleys/GT3 Timing Pulley 20 Tooth 9mm Belt 8mm Clamp Bore.SLDPRT
20.7 x 23.7 x 23.0 mm
