tabdallah/capstone/2_Mechanical/1_Solidworks_Model/Open_Source_Files/OpenBuilds Library/5 - Brackets/Black Angle Corner Connector.SLDPRT

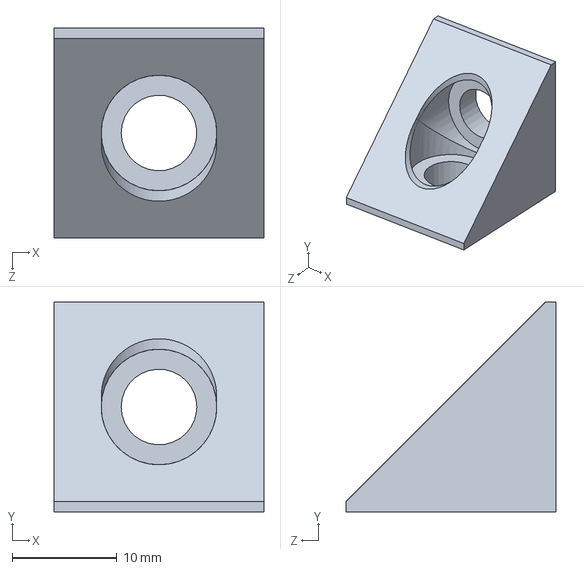
[picture p200: CAD file, 2018-02-02]
2_Mechanical/1_Solidworks_Model/Open_Source_Files/OpenBuilds Library/5 - Brackets/Black Angle Corner Connector.SLDPRT
20.0 x 20.0 x 20.0 mm
