tabdallah/capstone/2_Mechanical/1_Solidworks_Model/Open_Source_Files/OpenBuilds Library/6 - Electronics/DQ542MA Stepper Motor Driver.SLDPRT

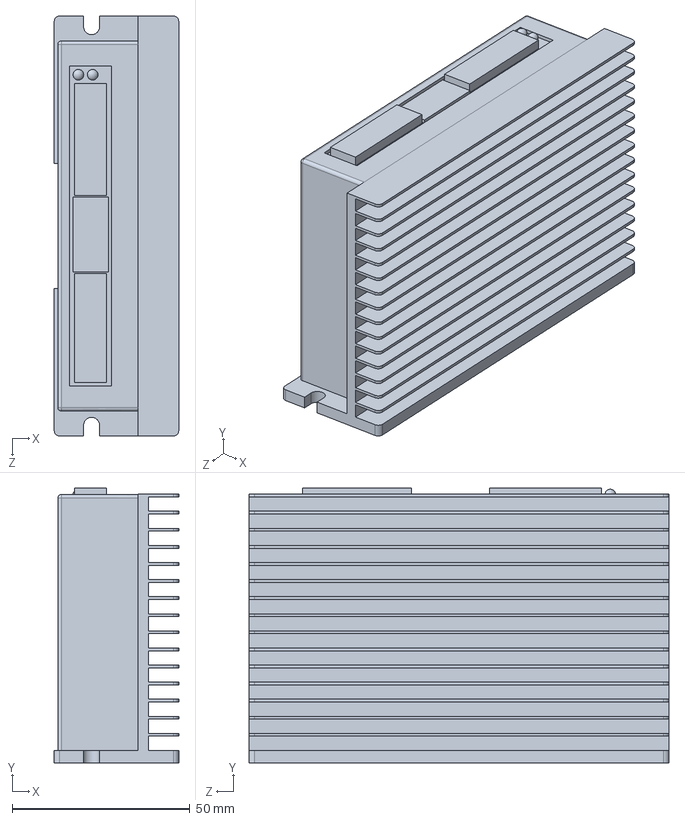
[picture p201: CAD file, 2018-02-02]
2_Mechanical/1_Solidworks_Model/Open_Source_Files/OpenBuilds Library/6 - Electronics/DQ542MA Stepper Motor Driver.SLDPRT
35.0 x 77.2 x 118.0 mm
