tabdallah/capstone/2_Mechanical/1_Solidworks_Model/Open_Source_Files/OpenBuilds Library/8 - Plates/V-Slot Gantry Plate 20mm.SLDPRT

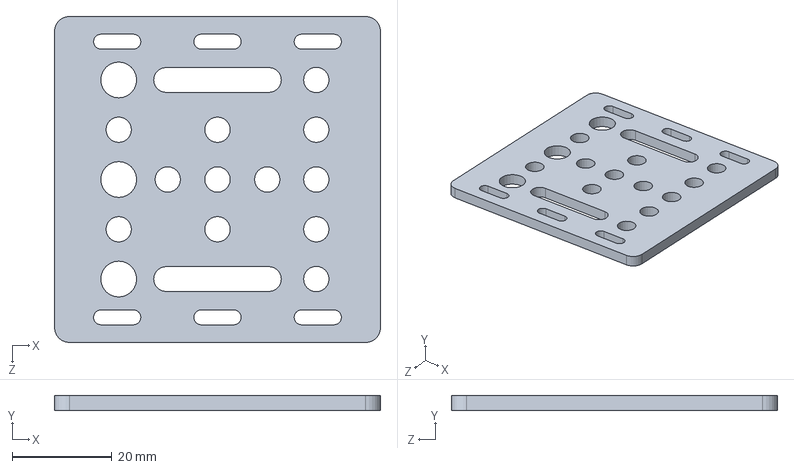
[picture p202: CAD file, 2018-02-02]
2_Mechanical/1_Solidworks_Model/Open_Source_Files/OpenBuilds Library/8 - Plates/V-Slot Gantry Plate 20mm.SLDPRT
65.5 x 3.00 x 65.5 mm
