tabdallah/capstone/2_Mechanical/1_Solidworks_Model/V2.0_STL/tssp40_mount.STL

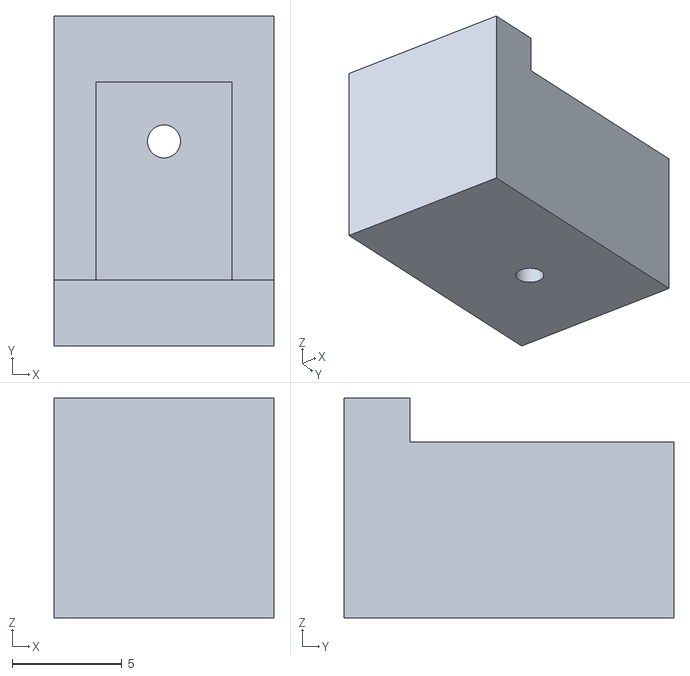
[picture p203: CAD file, 2018-06-19]
2_Mechanical/1_Solidworks_Model/V2.0_STL/tssp40_mount.STL
10.0 x 15.0 x 10.0
