tabdallah/capstone/2_Mechanical/1_Solidworks_Model/Open_Source_Files/AHR_y_axis_v2.SLDPRT

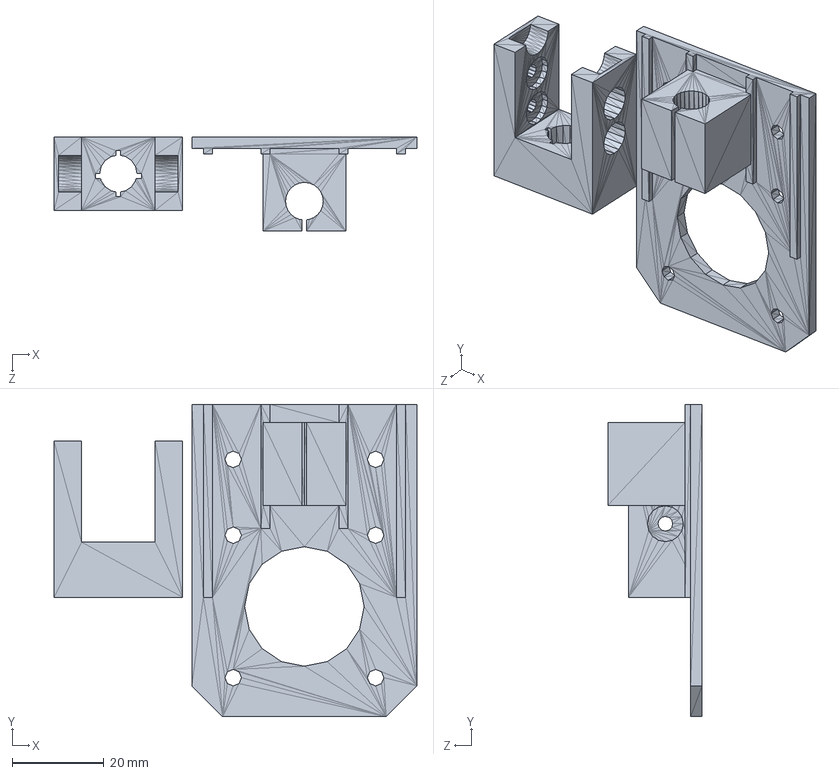
[picture p204: CAD file, 2018-02-02]
2_Mechanical/1_Solidworks_Model/Open_Source_Files/AHR_y_axis_v2.SLDPRT
79.0 x 68.0 x 20.5 mm
