tabdallah/capstone/2_Mechanical/1_Solidworks_Model/Open_Source_Files/OpenBuilds Library/10 - Shims and Spacers/Aluminum Spacer 6mm.SLDPRT

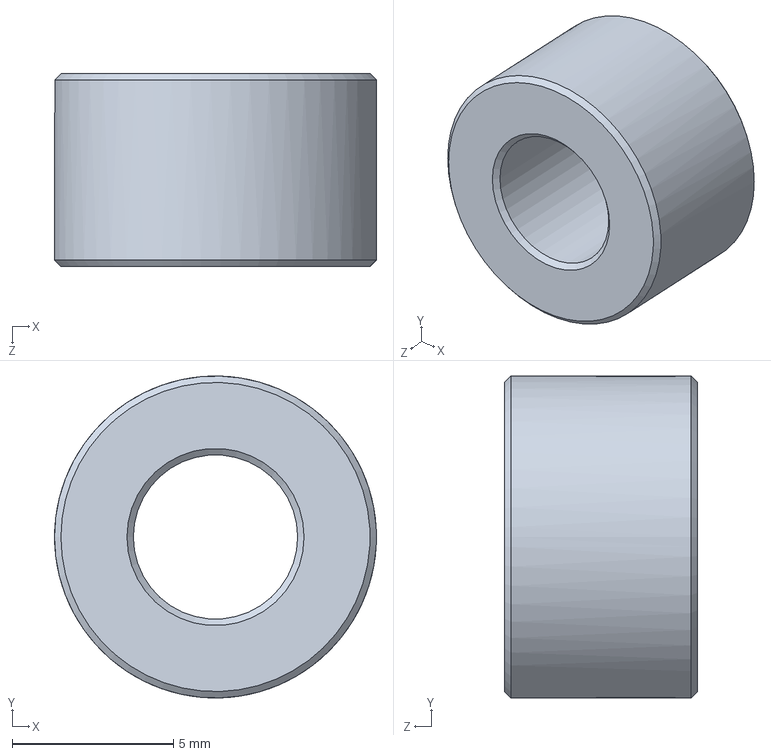
[picture p206: CAD file, 2018-03-15]
2_Mechanical/1_Solidworks_Model/Open_Source_Files/OpenBuilds Library/10 - Shims and Spacers/Aluminum Spacer 6mm.SLDPRT
10.0 x 10.00 x 6.00 mm
