tabdallah/capstone/2_Mechanical/1_Solidworks_Model/Open_Source_Files/OpenBuilds Library/4 - Pulleys/GT2 Timing Pulley 14 Tooth.SLDPRT

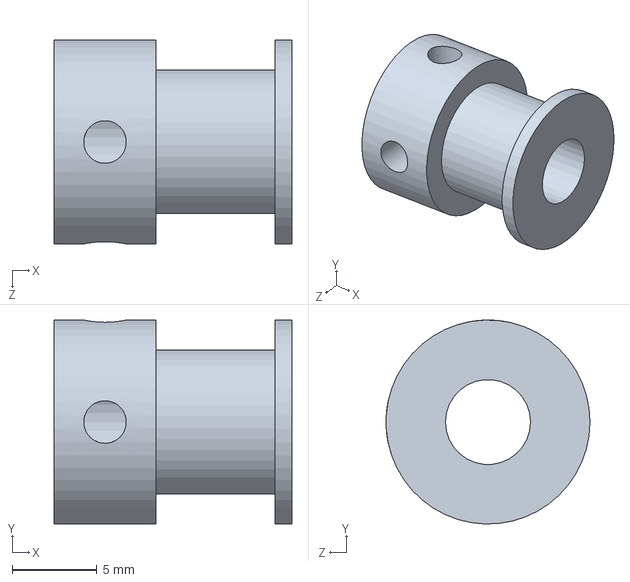
[picture p207: CAD file, 2018-02-02]
2_Mechanical/1_Solidworks_Model/Open_Source_Files/OpenBuilds Library/4 - Pulleys/GT2 Timing Pulley 14 Tooth.SLDPRT
14.0 x 12.0 x 12.0 mm
