tabdallah/capstone/2_Mechanical/1_Solidworks_Model/Open_Source_Files/OpenBuilds Library/5 - Brackets/L Bracket Double.SLDPRT

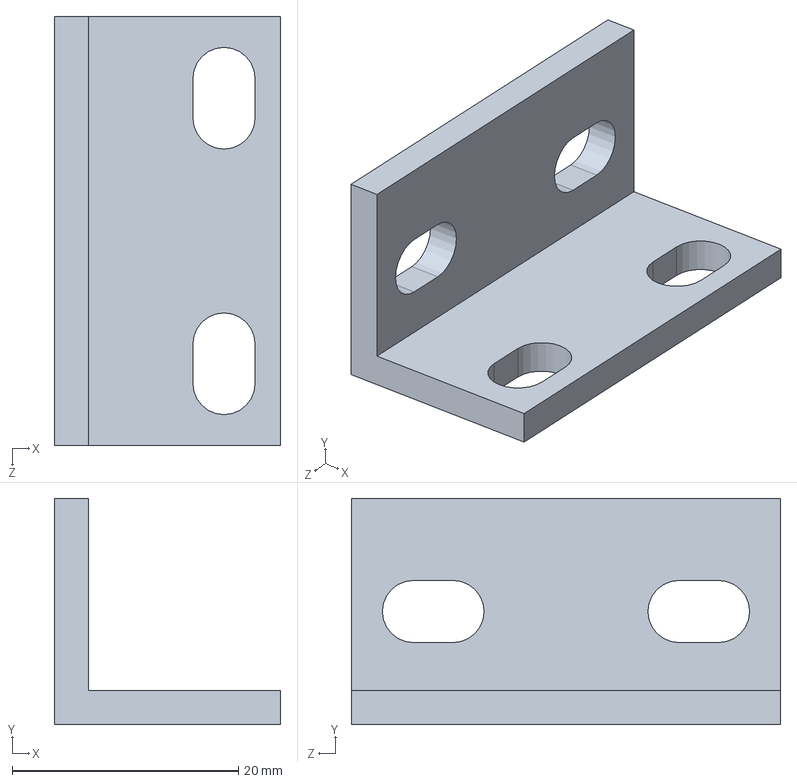
[picture p208: CAD file, 2018-02-02]
2_Mechanical/1_Solidworks_Model/Open_Source_Files/OpenBuilds Library/5 - Brackets/L Bracket Double.SLDPRT
20.0 x 20.0 x 38.0 mm
