tabdallah/capstone/2_Mechanical/1_Solidworks_Model/Open_Source_Files/OpenBuilds Library/8 - Plates/NEMA 23 Reduction Stand Off Plate.SLDPRT

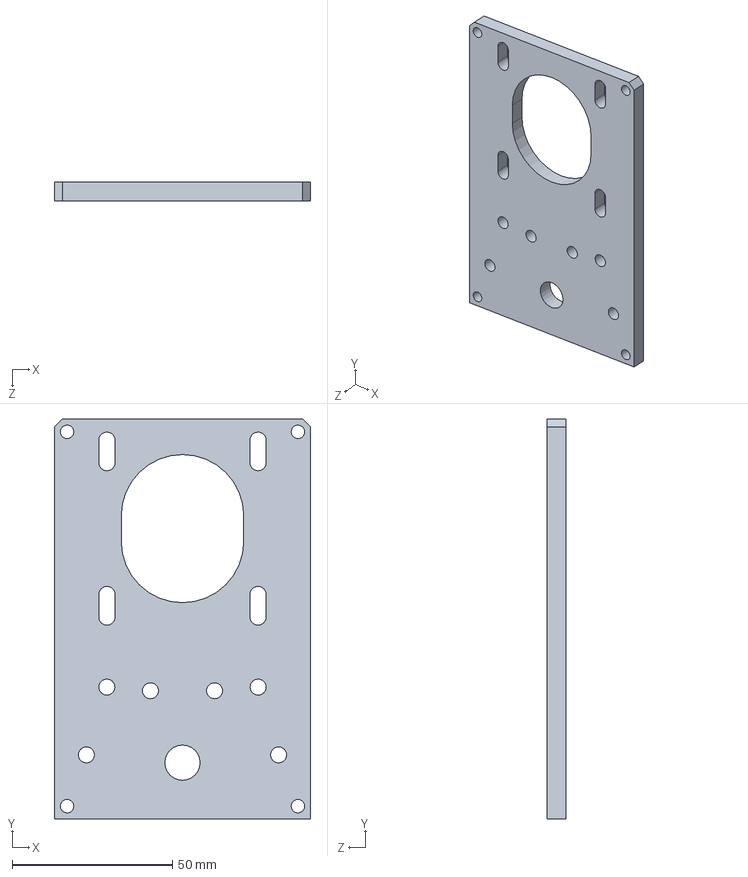
[picture p209: CAD file, 2018-02-02]
2_Mechanical/1_Solidworks_Model/Open_Source_Files/OpenBuilds Library/8 - Plates/NEMA 23 Reduction Stand Off Plate.SLDPRT
80.0 x 124.8 x 6.00 mm
