tabdallah/capstone/2_Mechanical/1_Solidworks_Model/Open_Source_Files/OpenBuilds Library/10 - Shims and Spacers/Aluminum Spacer 9mm.SLDPRT

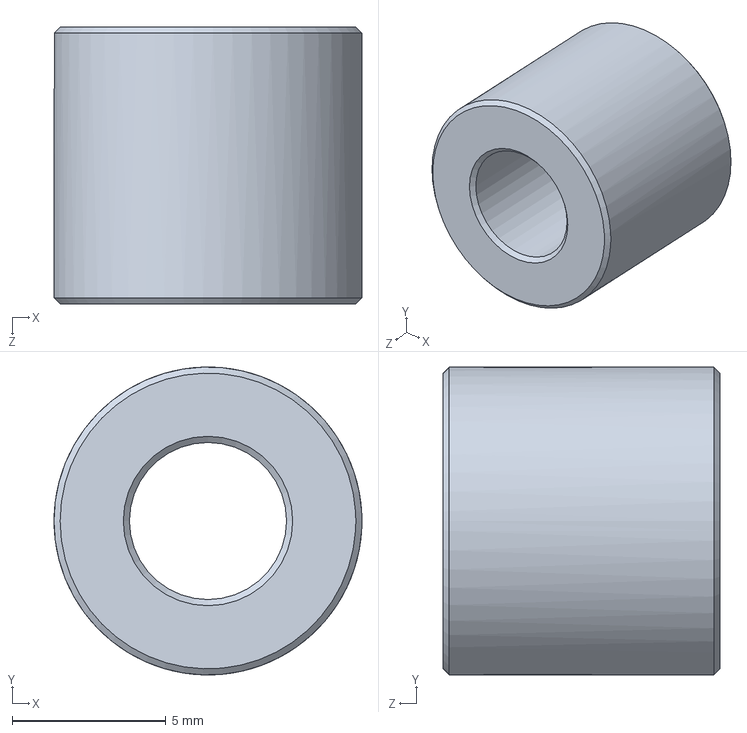
[picture p212: CAD file, 2018-02-02]
2_Mechanical/1_Solidworks_Model/Open_Source_Files/OpenBuilds Library/10 - Shims and Spacers/Aluminum Spacer 9mm.SLDPRT
10.0 x 9.99 x 9.00 mm
