tabdallah/capstone/2_Mechanical/1_Solidworks_Model/Open_Source_Files/OpenBuilds Library/5 - Brackets/Inside Hidden Corner Bracket.SLDPRT

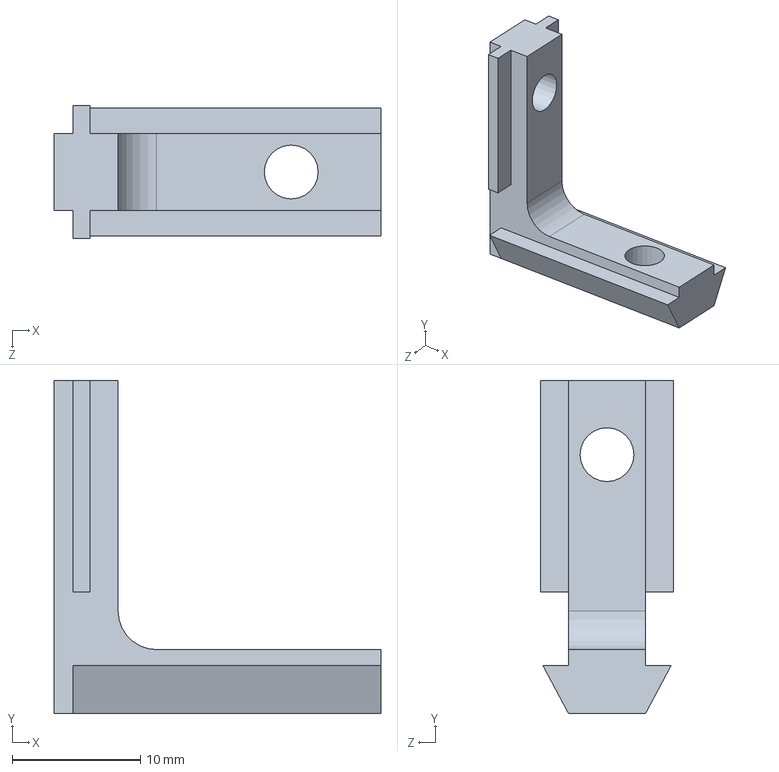
[picture p213: CAD file, 2018-02-02]
2_Mechanical/1_Solidworks_Model/Open_Source_Files/OpenBuilds Library/5 - Brackets/Inside Hidden Corner Bracket.SLDPRT
25.5 x 26.0 x 10.4 mm
