tabdallah/capstone/2_Mechanical/1_Solidworks_Model/Open_Source_Files/OpenBuilds Library/7 - Hardware/Jog Knob.SLDPRT

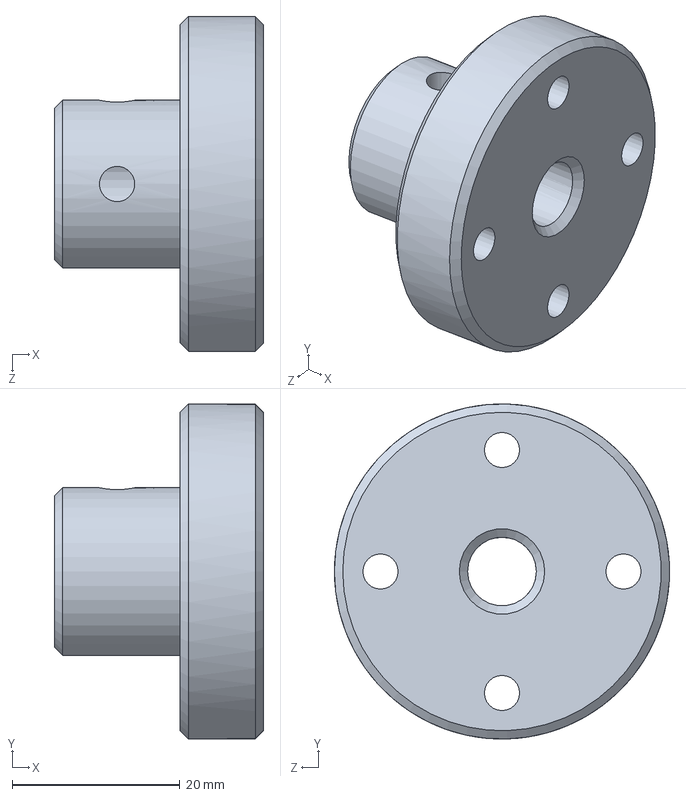
[picture p214: CAD file, 2018-02-02]
2_Mechanical/1_Solidworks_Model/Open_Source_Files/OpenBuilds Library/7 - Hardware/Jog Knob.SLDPRT
25.0 x 40.0 x 40.0 mm
