tabdallah/capstone/2_Mechanical/1_Solidworks_Model/Open_Source_Files/OpenBuilds Library/8 - Plates/Joining Strip Plate 3 Hole.SLDPRT

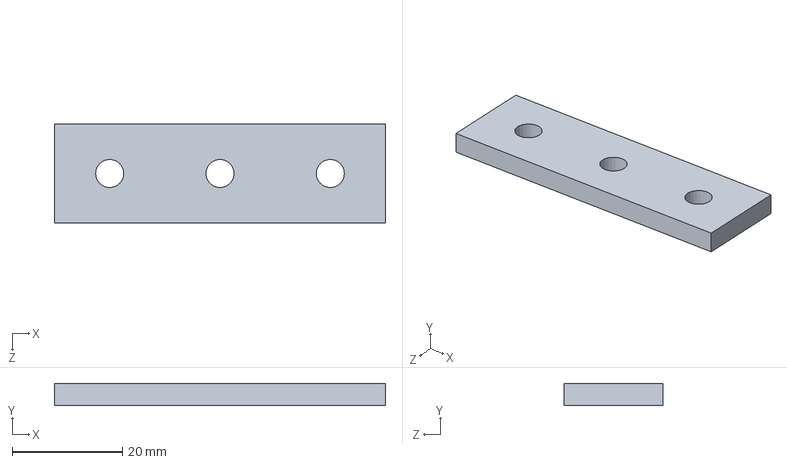
[picture p215: CAD file, 2018-02-02]
2_Mechanical/1_Solidworks_Model/Open_Source_Files/OpenBuilds Library/8 - Plates/Joining Strip Plate 3 Hole.SLDPRT
60.0 x 4.00 x 18.0 mm
