tabdallah/capstone/2_Mechanical/1_Solidworks_Model/Open_Source_Files/pusher.stl

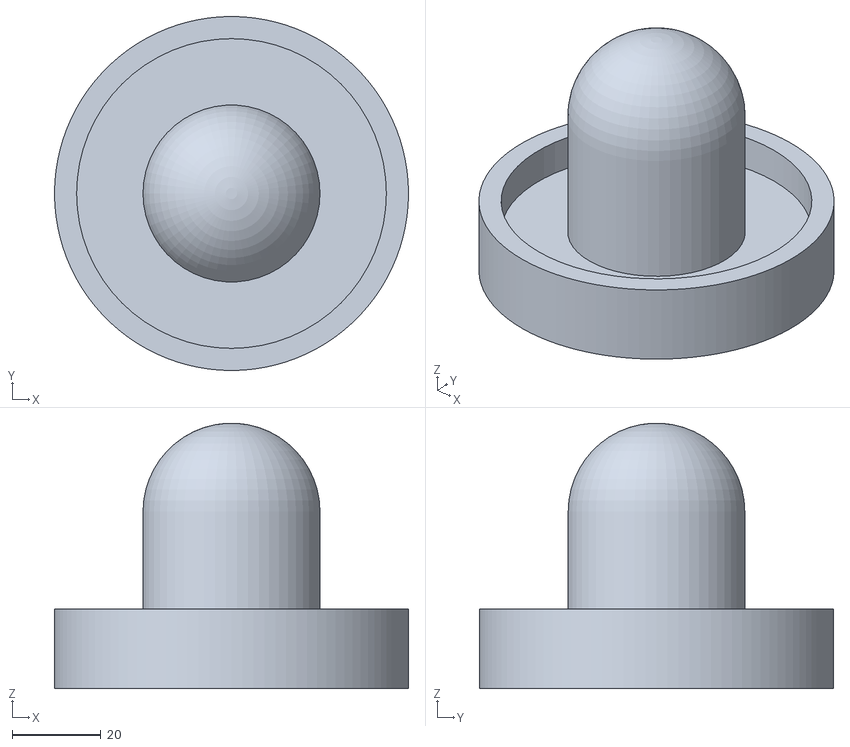
[picture p216: CAD file, 2018-02-02]
2_Mechanical/1_Solidworks_Model/Open_Source_Files/pusher.stl
80.0 x 80.0 x 60.0
