tabdallah/capstone/2_Mechanical/1_Solidworks_Model/V2.0_STL/limit_switch_mount_alt_bottom.STL

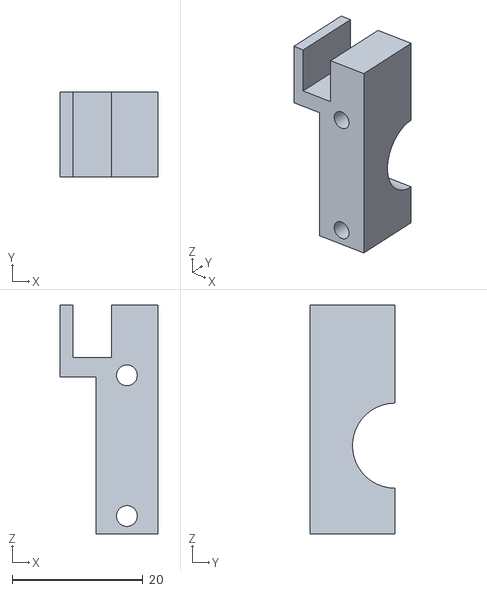
[picture p217: CAD file, 2018-06-01]
2_Mechanical/1_Solidworks_Model/V2.0_STL/limit_switch_mount_alt_bottom.STL
15.0 x 13.0 x 35.0
