tabdallah/capstone/2_Mechanical/1_Solidworks_Model/Open_Source_Files/AHR_PS3Camera_holder.stl

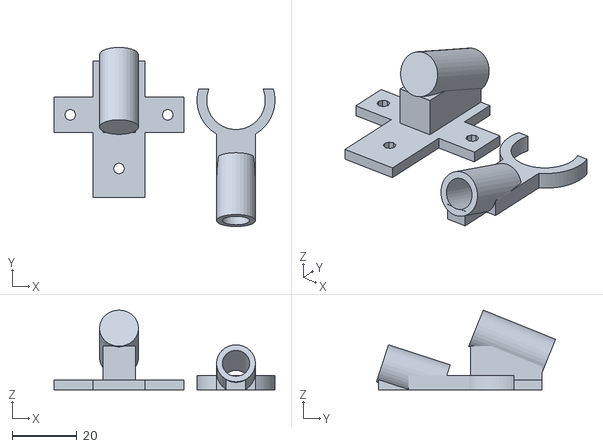
[picture p218: CAD file, 2018-02-02]
2_Mechanical/1_Solidworks_Model/Open_Source_Files/AHR_PS3Camera_holder.stl
68.0 x 55.1 x 24.6
