tabdallah/capstone/2_Mechanical/1_Solidworks_Model/Open_Source_Files/OpenBuilds Library/1 - Linear Rail/V-Slot 20x20x1500 Linear Rail.SLDPRT

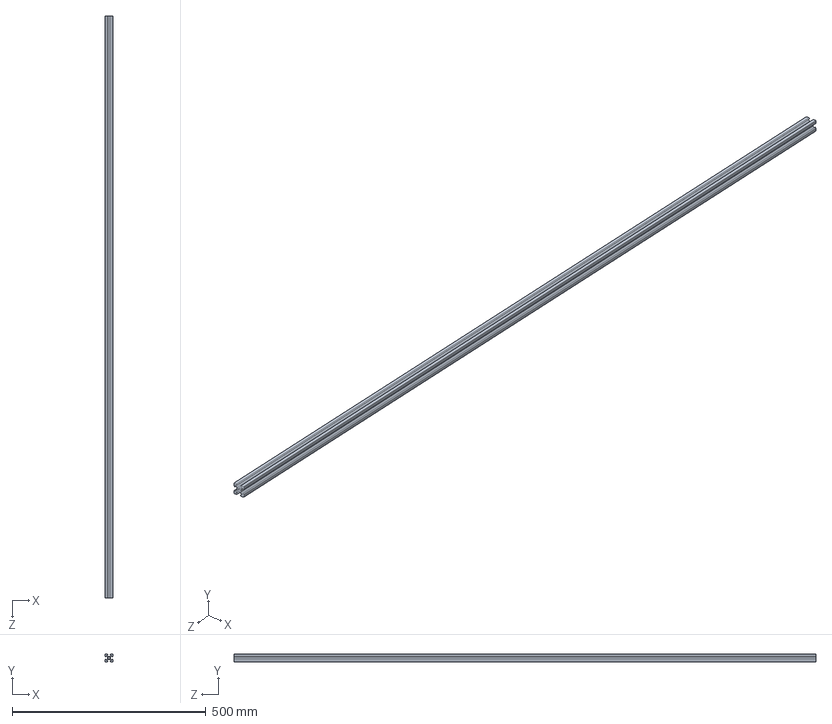
[picture p219: CAD file, 2018-02-02]
2_Mechanical/1_Solidworks_Model/Open_Source_Files/OpenBuilds Library/1 - Linear Rail/V-Slot 20x20x1500 Linear Rail.SLDPRT
20.0 x 20.0 x 1500.0 mm
