tabdallah/capstone/2_Mechanical/1_Solidworks_Model/Open_Source_Files/OpenBuilds Library/10 - Shims and Spacers/Eccentric Spacer 0.25in.SLDPRT

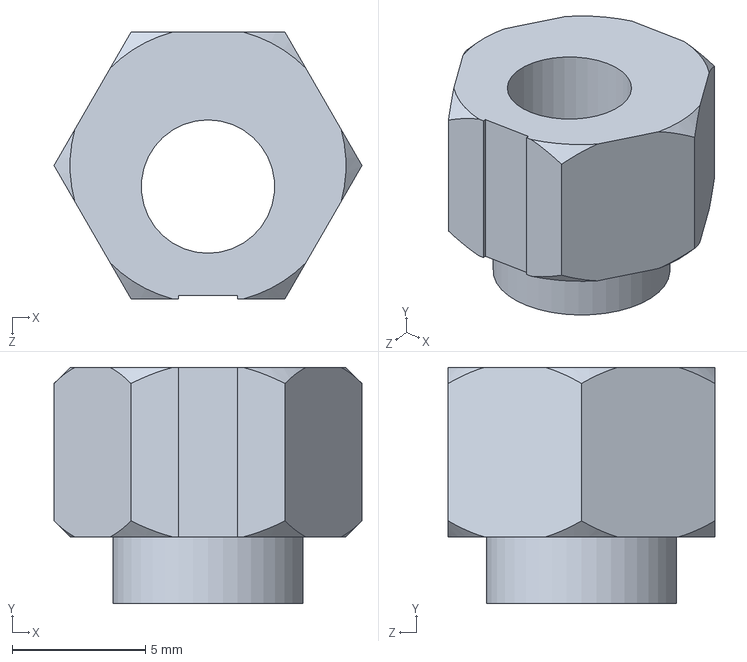
[picture p220: CAD file, 2018-02-02]
2_Mechanical/1_Solidworks_Model/Open_Source_Files/OpenBuilds Library/10 - Shims and Spacers/Eccentric Spacer 0.25in.SLDPRT
11.5 x 8.85 x 10.0 mm
