tabdallah/capstone/2_Mechanical/1_Solidworks_Model/Open_Source_Files/OpenBuilds Library/5 - Brackets/Cast Corner Bracket.SLDPRT

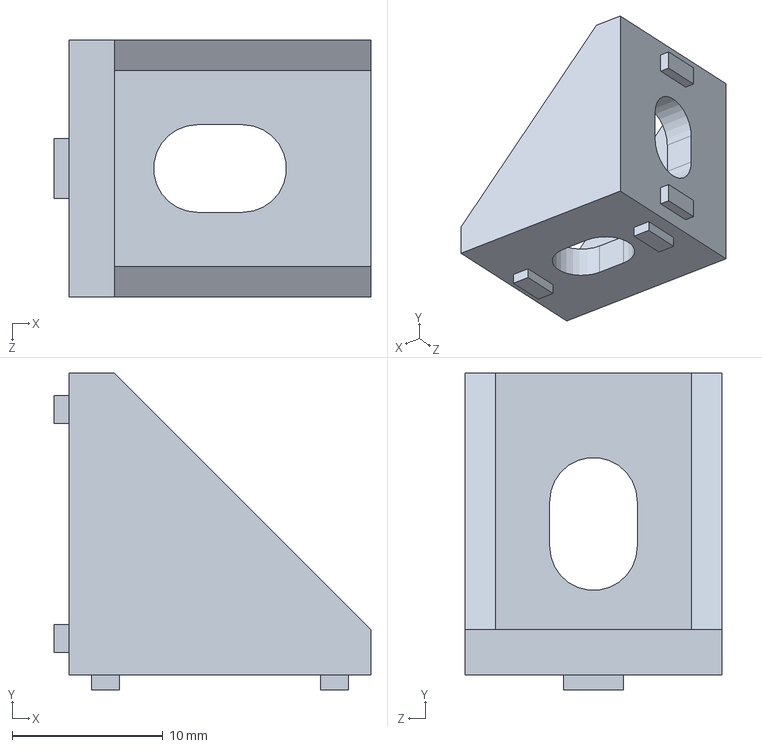
[picture p221: CAD file, 2018-02-02]
2_Mechanical/1_Solidworks_Model/Open_Source_Files/OpenBuilds Library/5 - Brackets/Cast Corner Bracket.SLDPRT
21.0 x 21.0 x 17.0 mm
