tabdallah/capstone/2_Mechanical/1_Solidworks_Model/Open_Source_Files/OpenBuilds Library/8 - Plates/C-Beam Shield 500mm.SLDPRT

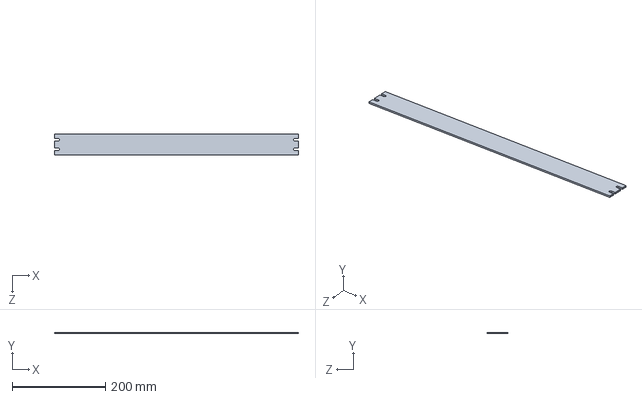
[picture p222: CAD file, 2018-02-02]
2_Mechanical/1_Solidworks_Model/Open_Source_Files/OpenBuilds Library/8 - Plates/C-Beam Shield 500mm.SLDPRT
523.0 x 3.00 x 45.0 mm
