tabdallah/capstone/2_Mechanical/1_Solidworks_Model/V2.0_Design/1_Parts/X-Axis_Rod_Extension.SLDPRT

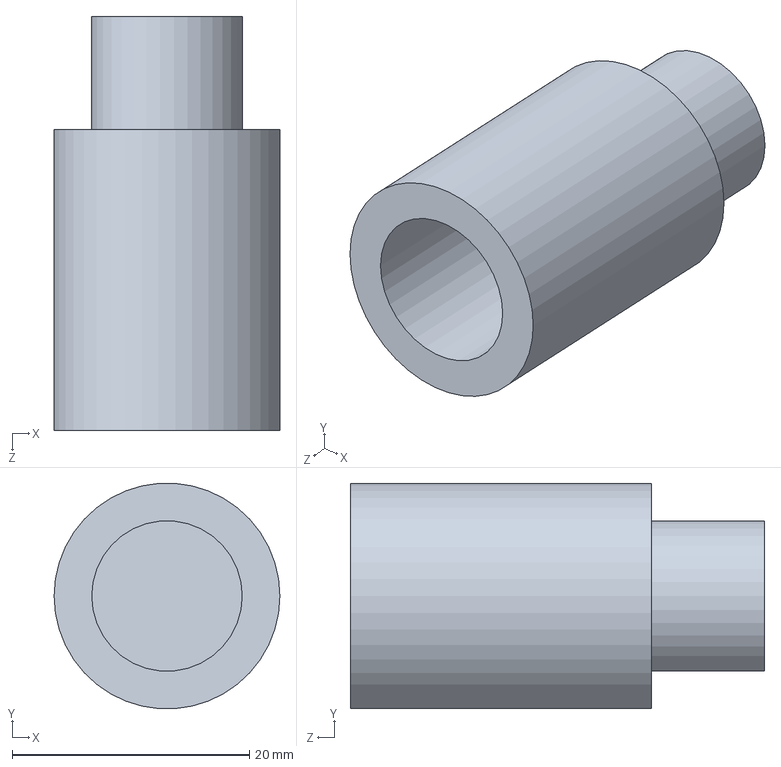
[picture p223: CAD file, 2018-06-29]
2_Mechanical/1_Solidworks_Model/V2.0_Design/1_Parts/X-Axis_Rod_Extension.SLDPRT
19.1 x 19.0 x 34.9 mm
