tabdallah/capstone/2_Mechanical/1_Solidworks_Model/V2.0_STL/X-Axis_Paddle_Bottom.STL

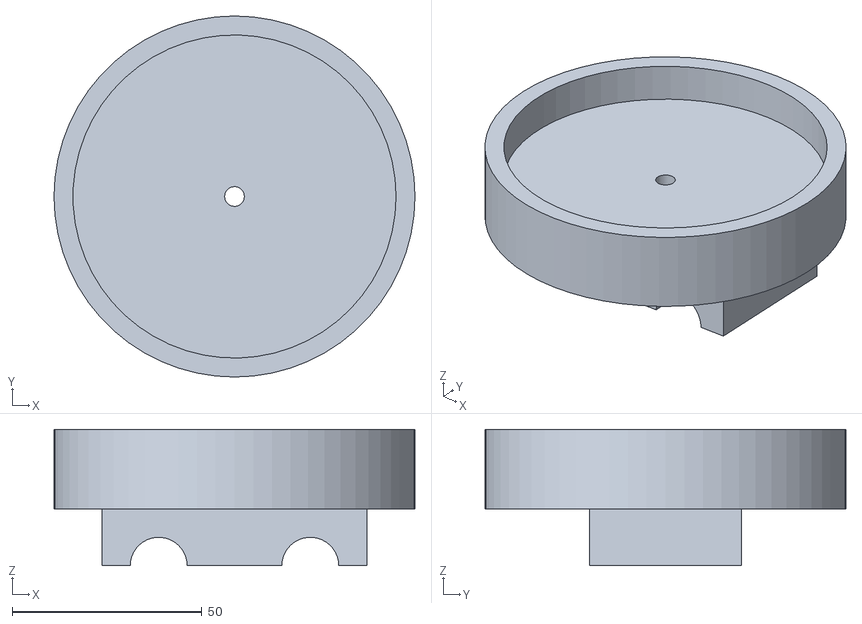
[picture p224: CAD file, 2018-06-01]
2_Mechanical/1_Solidworks_Model/V2.0_STL/X-Axis_Paddle_Bottom.STL
95.2 x 95.2 x 36.0
