tabdallah/capstone/2_Mechanical/1_Solidworks_Model/Open_Source_Files/GT2 Belt 6mm x 40mm.stp

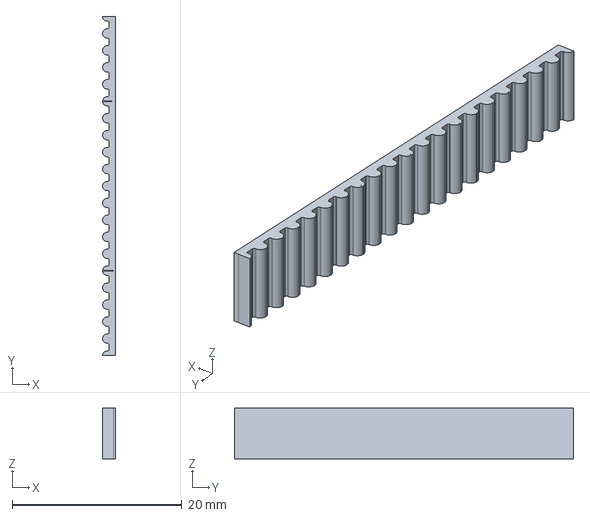
[picture p225: CAD file, 2018-02-02]
2_Mechanical/1_Solidworks_Model/Open_Source_Files/GT2 Belt 6mm x 40mm.stp
1.52 x 40.0 x 6.00 mm
