tabdallah/capstone/2_Mechanical/1_Solidworks_Model/Open_Source_Files/OpenBuilds Library/8 - Plates/V-Slot Gantry Plate 20-80mm.SLDPRT

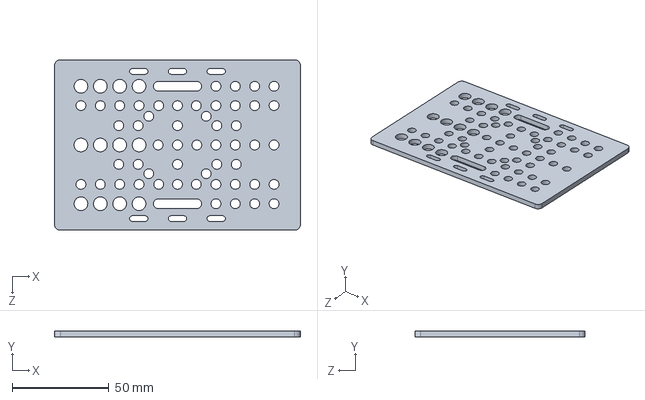
[picture p230: CAD file, 2018-02-02]
2_Mechanical/1_Solidworks_Model/Open_Source_Files/OpenBuilds Library/8 - Plates/V-Slot Gantry Plate 20-80mm.SLDPRT
127.0 x 3.00 x 88.0 mm
