tabdallah/capstone/2_Mechanical/1_Solidworks_Model/V2.0_Design/1_Parts/Y-Axis_Rod.SLDPRT

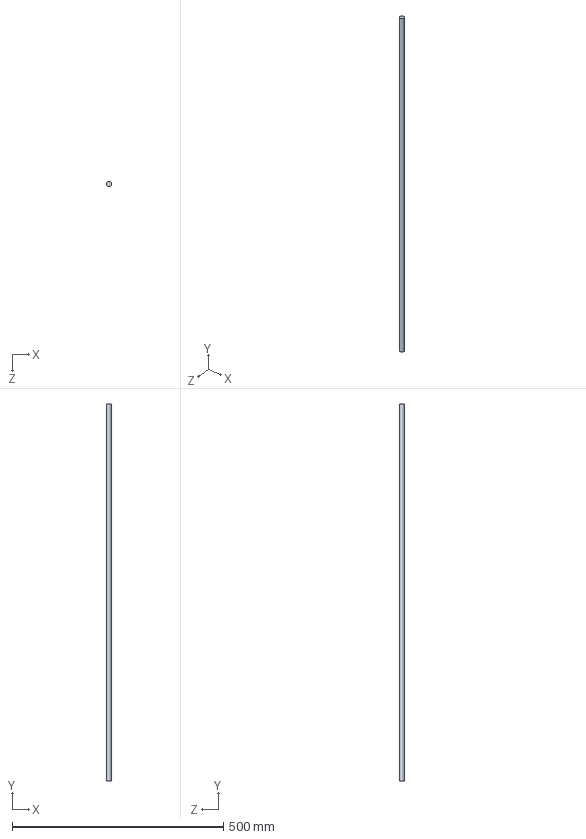
[picture p231: CAD file, 2018-06-01]
2_Mechanical/1_Solidworks_Model/V2.0_Design/1_Parts/Y-Axis_Rod.SLDPRT
12.7 x 892.0 x 12.7 mm
