tabdallah/capstone/2_Mechanical/1_Solidworks_Model/V2.0_STL/X-Axis_Carriage_Bottom.STL

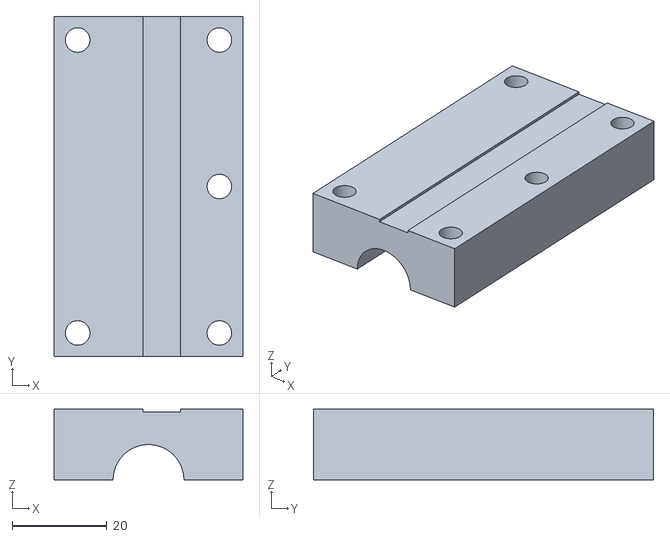
[picture p232: CAD file, 2018-06-01]
2_Mechanical/1_Solidworks_Model/V2.0_STL/X-Axis_Carriage_Bottom.STL
40.0 x 72.0 x 15.0
