tabdallah/capstone/2_Mechanical/1_Solidworks_Model/Open_Source_Files/OpenBuilds Library/1 - Linear Rail/C-Beam 40x80x1000 Linear Rail.SLDPRT

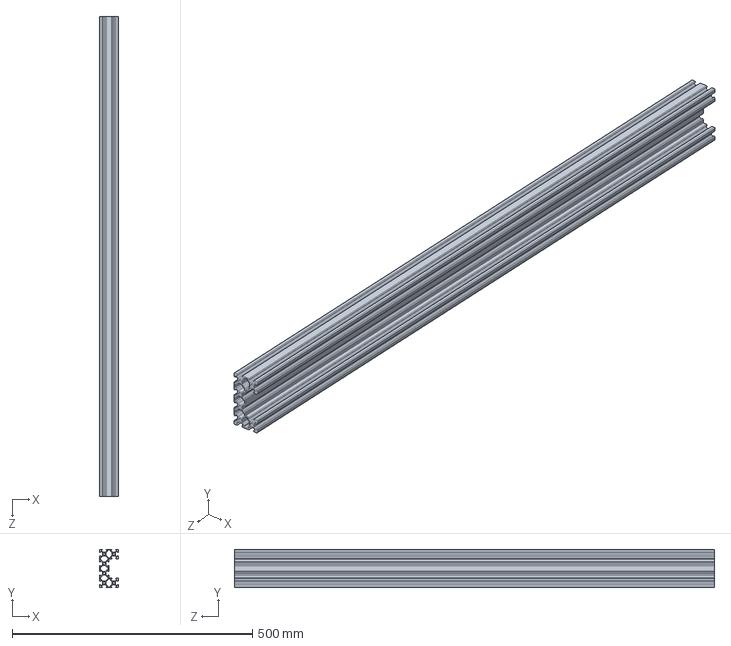
[picture p233: CAD file, 2018-02-02]
2_Mechanical/1_Solidworks_Model/Open_Source_Files/OpenBuilds Library/1 - Linear Rail/C-Beam 40x80x1000 Linear Rail.SLDPRT
40.0 x 80.0 x 1000.0 mm
