tabdallah/capstone/2_Mechanical/1_Solidworks_Model/Open_Source_Files/OpenBuilds Library/10 - Shims and Spacers/Nylon Spacer 0.25in.SLDPRT

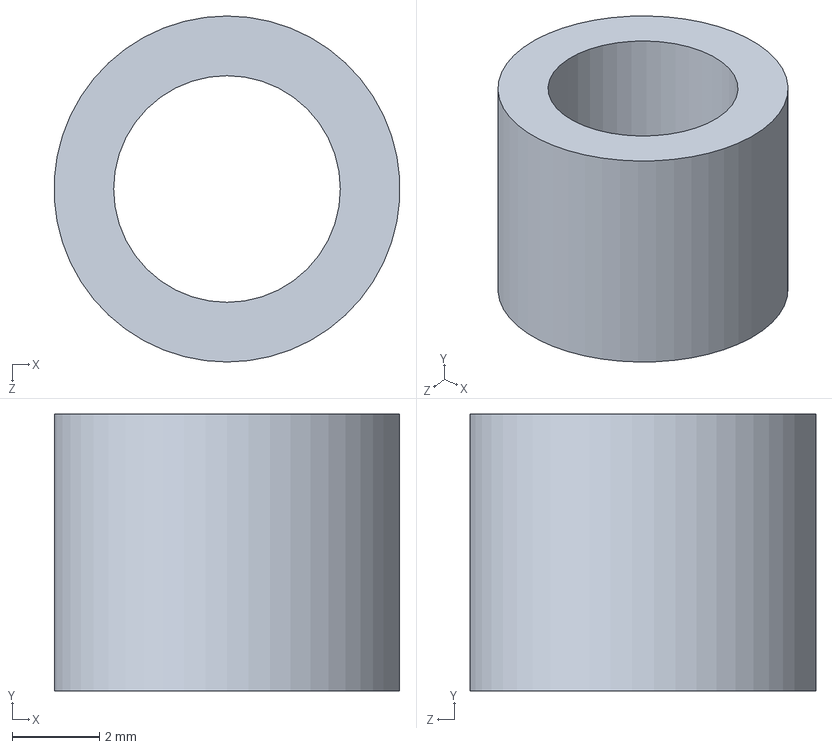
[picture p234: CAD file, 2018-02-02]
2_Mechanical/1_Solidworks_Model/Open_Source_Files/OpenBuilds Library/10 - Shims and Spacers/Nylon Spacer 0.25in.SLDPRT
7.92 x 6.35 x 7.94 mm
