tabdallah/capstone/2_Mechanical/1_Solidworks_Model/Open_Source_Files/OpenBuilds Library/7 - Hardware/Flexible Coupling 5mm x 8mm.SLDPRT

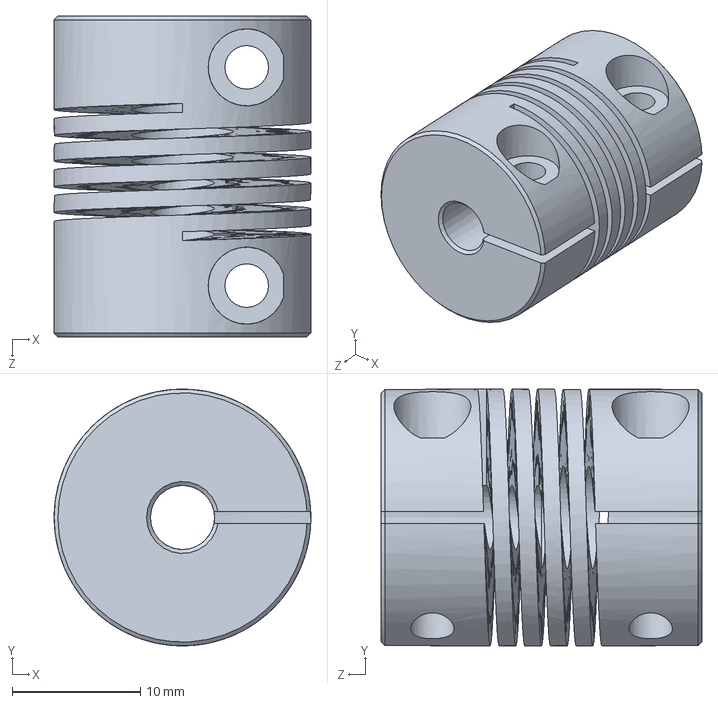
[picture p236: CAD file, 2018-02-02]
2_Mechanical/1_Solidworks_Model/Open_Source_Files/OpenBuilds Library/7 - Hardware/Flexible Coupling 5mm x 8mm.SLDPRT
20.0 x 20.0 x 25.0 mm
