tabdallah/capstone/2_Mechanical/1_Solidworks_Model/Open_Source_Files/OpenBuilds Library/8 - Plates/C-Beam Gantry Plate XLarge.SLDPRT

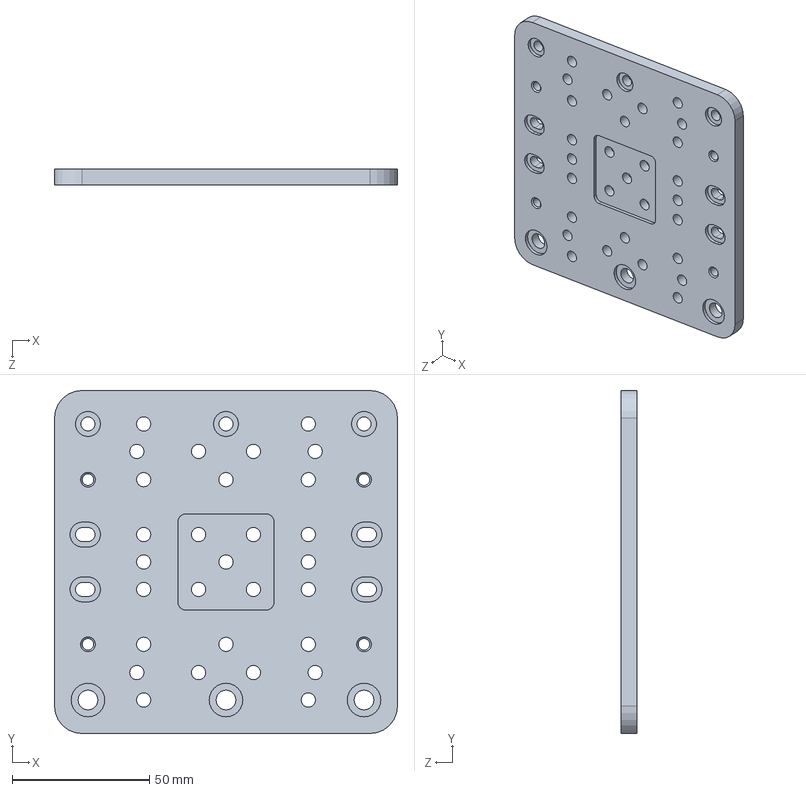
[picture p237: CAD file, 2018-02-02]
2_Mechanical/1_Solidworks_Model/Open_Source_Files/OpenBuilds Library/8 - Plates/C-Beam Gantry Plate XLarge.SLDPRT
125.0 x 125.0 x 6.00 mm
