tabdallah/capstone/2_Mechanical/1_Solidworks_Model/Open_Source_Files/PrintableBearing.SLDPRT

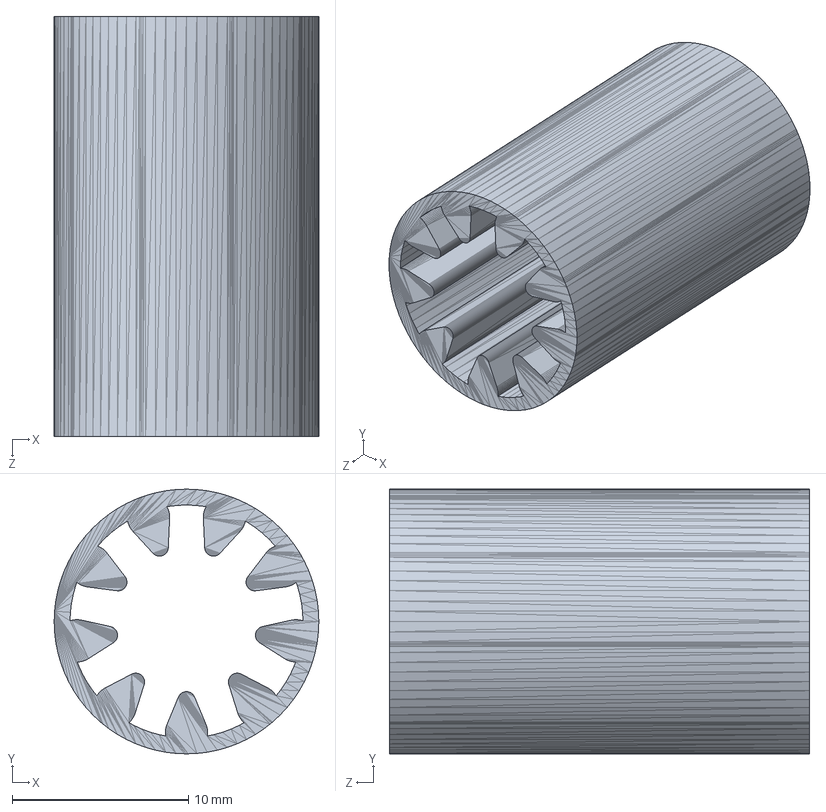
[picture p238: CAD file, 2018-02-02]
2_Mechanical/1_Solidworks_Model/Open_Source_Files/PrintableBearing.SLDPRT
15.0 x 15.0 x 23.8 mm
