tabdallah/capstone/2_Mechanical/1_Solidworks_Model/V2.0_Design/1_Parts/y-axis_motor_support.SLDPRT

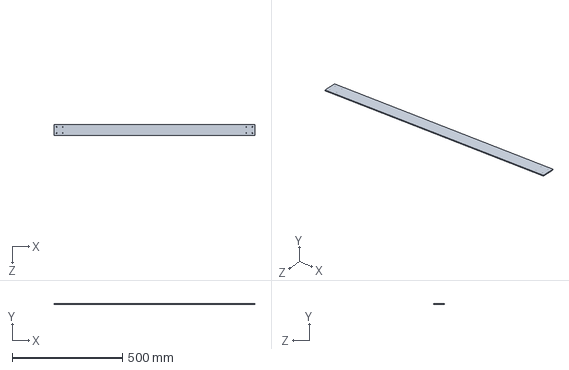
[picture p239: CAD file, 2018-06-01]
2_Mechanical/1_Solidworks_Model/V2.0_Design/1_Parts/y-axis_motor_support.SLDPRT
910.9 x 3.17 x 50.8 mm
