tabdallah/capstone/2_Mechanical/1_Solidworks_Model/V2.0_STL/X-Axis_Carriage_Top.STL

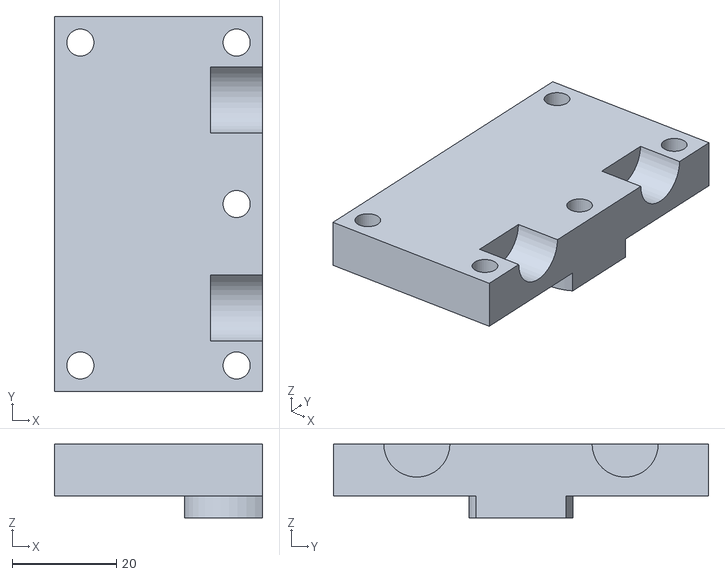
[picture p240: CAD file, 2018-06-01]
2_Mechanical/1_Solidworks_Model/V2.0_STL/X-Axis_Carriage_Top.STL
40.0 x 72.0 x 14.2
