tabdallah/capstone/2_Mechanical/1_Solidworks_Model/Open_Source_Files/AHR_x_motor_mount.SLDPRT

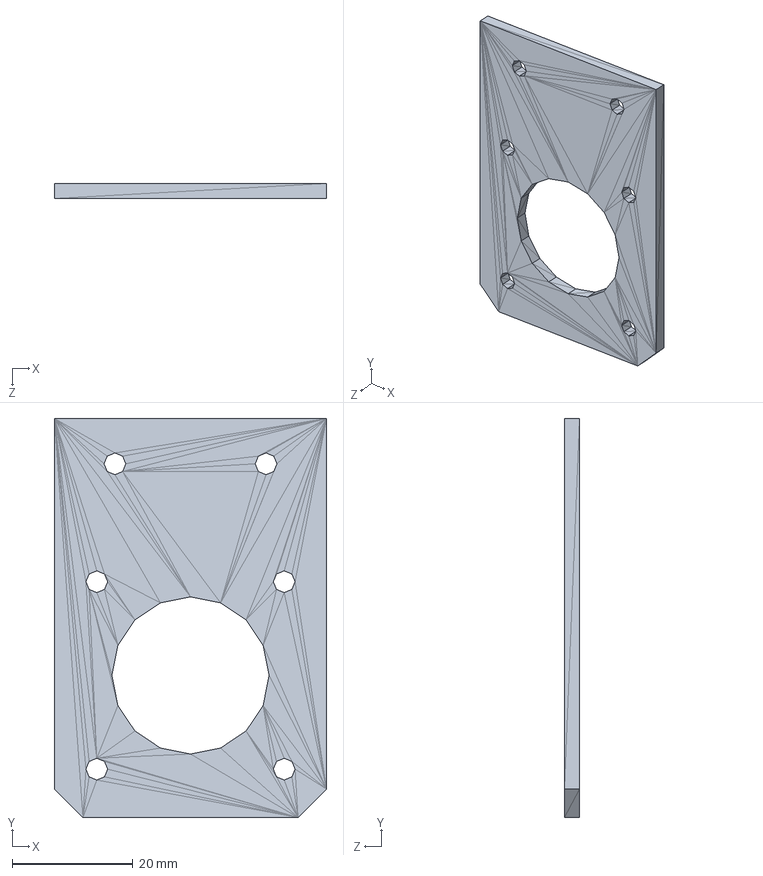
[picture p241: CAD file, 2018-02-02]
2_Mechanical/1_Solidworks_Model/Open_Source_Files/AHR_x_motor_mount.SLDPRT
45.0 x 66.0 x 2.50 mm
