tabdallah/capstone/2_Mechanical/1_Solidworks_Model/Open_Source_Files/OpenBuilds Library/1 - Linear Rail/Open Rail 1500mm.SLDPRT

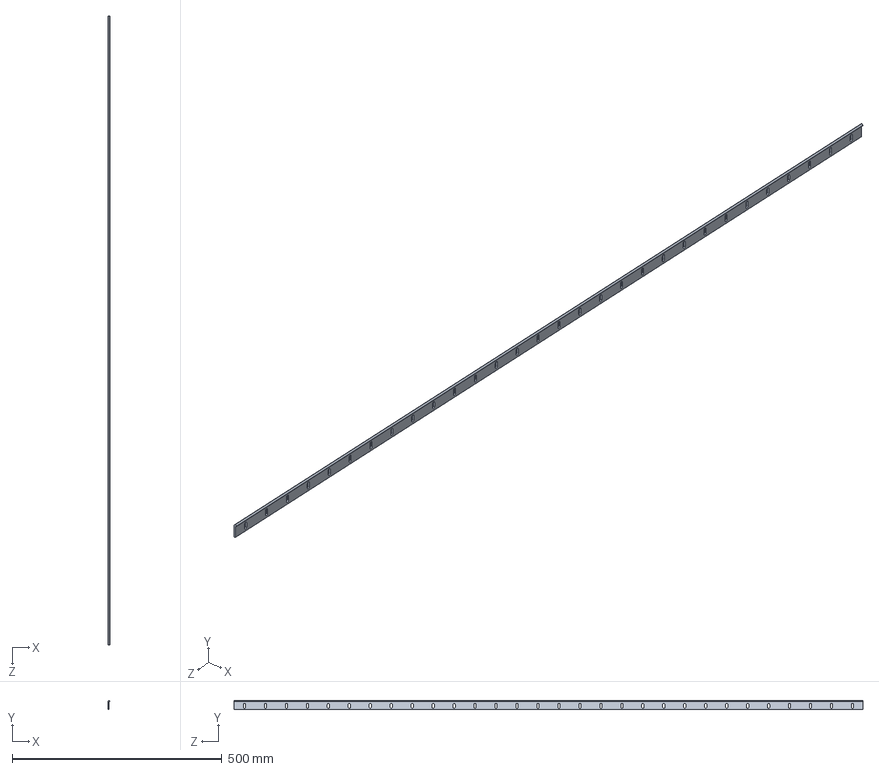
[picture p242: CAD file, 2018-02-02]
2_Mechanical/1_Solidworks_Model/Open_Source_Files/OpenBuilds Library/1 - Linear Rail/Open Rail 1500mm.SLDPRT
4.75 x 22.5 x 1500.0 mm
