tabdallah/capstone/2_Mechanical/1_Solidworks_Model/Open_Source_Files/OpenBuilds Library/10 - Shims and Spacers/Eccentric Spacer 6mm.SLDPRT

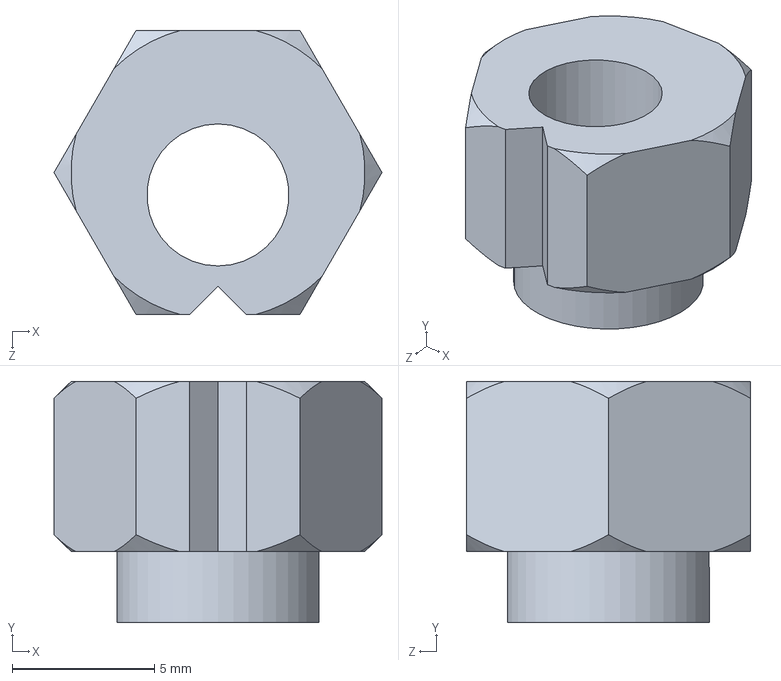
[picture p243: CAD file, 2018-02-02]
2_Mechanical/1_Solidworks_Model/Open_Source_Files/OpenBuilds Library/10 - Shims and Spacers/Eccentric Spacer 6mm.SLDPRT
11.5 x 8.50 x 10.0 mm
