tabdallah/capstone/2_Mechanical/1_Solidworks_Model/Open_Source_Files/OpenBuilds Library/8 - Plates/Open Rail Gantry Plate 60mm.SLDPRT

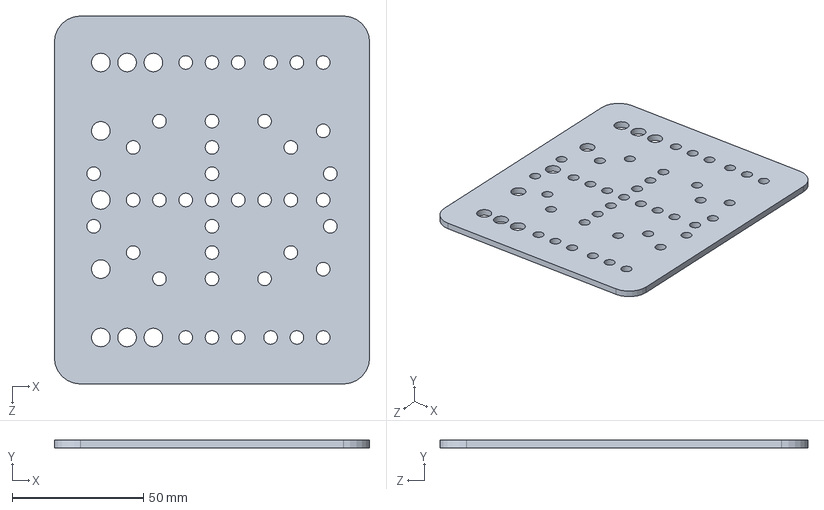
[picture p245: CAD file, 2018-02-02]
2_Mechanical/1_Solidworks_Model/Open_Source_Files/OpenBuilds Library/8 - Plates/Open Rail Gantry Plate 60mm.SLDPRT
120.0 x 3.00 x 140.0 mm
