tabdallah/capstone/2_Mechanical/1_Solidworks_Model/V2.0_Design/1_Parts/Motor_Shield_Y_Left_795.SLDPRT

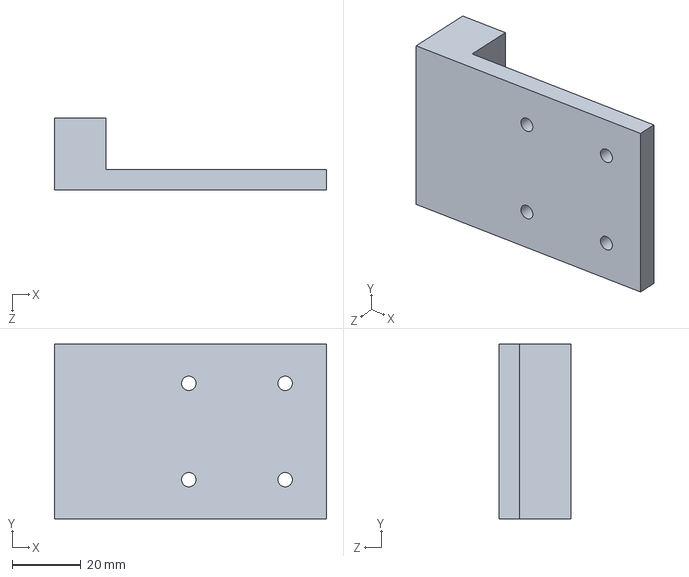
[picture p246: CAD file, 2018-06-01]
2_Mechanical/1_Solidworks_Model/V2.0_Design/1_Parts/Motor_Shield_Y_Left_795.SLDPRT
79.0 x 50.8 x 21.0 mm
