tabdallah/capstone/2_Mechanical/1_Solidworks_Model/Open_Source_Files/AMT103-V_Encoder/CUI_cui_amt103-d0048-i5000-s.sldasm

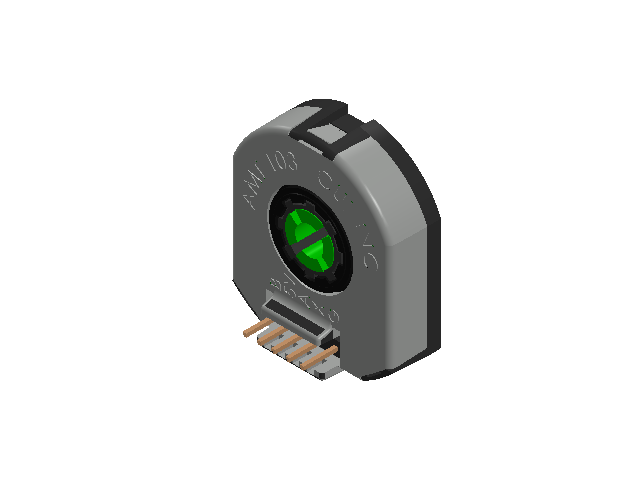
[picture p247: CAD file, 2018-06-01]
2_Mechanical/1_Solidworks_Model/Open_Source_Files/AMT103-V_Encoder/CUI_cui_amt103-d0048-i5000-s.sldasm
CUI_amt-sleeve-rev-d(5 mm)
CUI_amt-hub-top-rev-d1
CUI_amt-hub-bottom-rev-b
CUI_amt10x-shaft-adaptor-rev-e
CUI_receiver-board
CUI_rotor-board-rev f
CUI_transmitter-board amt10(amt-103)
CUI_amt-103-base-rev-k(default)
CUI_amt-103-top-cover-rev-h
