tabdallah/capstone/(list of files, cad)

Other CAD files:
2_Mechanical/1_Solidworks_Model/Open_Source_Files/OpenBuilds Library/Assemblies/Wheels/Xtreme Mini V Wheel.SLDASM
2_Mechanical/1_Solidworks_Model/Open_Source_Files/OpenBuilds Library/Assemblies/Wheels/Solid V Wheel.SLDASM
2_Mechanical/1_Solidworks_Model/Open_Source_Files/AMT103-V_Encoder/CUI_amt-103-top-cover-rev-h.sldprt
2_Mechanical/1_Solidworks_Model/V2.0_STL/Y-Axis_Connecting_Rod_Mount.STL
2_Mechanical/1_Solidworks_Model/Open_Source_Files/AMT103-V_Encoder/CUI_receiver-board.sldprt
2_Mechanical/1_Solidworks_Model/Open_Source_Files/AMT103-V_Encoder/CUI_amt-hub-bottom-rev-b.sldprt
2_Mechanical/1_Solidworks_Model/Open_Source_Files/OpenBuilds Library/2 - Wheels/Xtreme Mini V Wheel.SLDPRT
2_Mechanical/1_Solidworks_Model/Open_Source_Files/OpenBuilds Library/3 - Bearings/Ball Bearing 0.25 x 0.625 x 0.196.SLDPRT
2_Mechanical/1_Solidworks_Model/Open_Source_Files/AMT103-V_Encoder/CUI_rotor-board-rev f.sldprt
2_Mechanical/1_Solidworks_Model/Open_Source_Files/OpenBuilds Library/2 - Wheels/Solid V Wheel.SLDPRT
2_Mechanical/1_Solidworks_Model/V2.0_Design/1_Parts/LB8UU_3D_Printed.SLDPRT
2_Mechanical/1_Solidworks_Model/Open_Source_Files/AMT103-V_Encoder/CUI_amt10x-shaft-adaptor-rev-e.sldprt
2_Mechanical/1_Solidworks_Model/Open_Source_Files/OpenBuilds Library/2 - Wheels/Delrin V Wheel.SLDPRT
2_Mechanical/1_Solidworks_Model/V2.0_Design/1_Parts/Y-Axis_Rod_Mount.SLDPRT
2_Mechanical/1_Solidworks_Model/Open_Source_Files/AMT103-V_Encoder/CUI_transmitter-board amt10(amt-103).sldprt
2_Mechanical/1_Solidworks_Model/V2.0_Design/1_Parts/limit_switch_mount_top.SLDPRT
2_Mechanical/1_Solidworks_Model/Open_Source_Files/AMT103-V_Encoder/CUI_amt-hub-top-rev-d1.sldprt
2_Mechanical/1_Solidworks_Model/V2.0_Design/1_Parts/X-Axis_Paddle_Top.SLDPRT
2_Mechanical/1_Solidworks_Model/Open_Source_Files/AMT103-V_Encoder/CUI_amt-103-base-rev-k(default).sldprt
2_Mechanical/1_Solidworks_Model/Open_Source_Files/AMT103-V_Encoder/CUI_amt-sleeve-rev-d(5 mm).sldprt
2_Mechanical/1_Solidworks_Model/Open_Source_Files/AHR_Pulley_1.SLDPRT
2_Mechanical/1_Solidworks_Model/Open_Source_Files/AHR_Pulley_1.stl
2_Mechanical/1_Solidworks_Model/Open_Source_Files/AHR_Pulley_2.SLDPRT
2_Mechanical/1_Solidworks_Model/Open_Source_Files/AHR_Pulley_2.stl
2_Mechanical/1_Solidworks_Model/Open_Source_Files/AHR_x_motor_mount.stl
2_Mechanical/1_Solidworks_Model/Open_Source_Files/AHR_y_axis_v2.stl
2_Mechanical/1_Solidworks_Model/Open_Source_Files/AHR_y_carriage.stl
2_Mechanical/1_Solidworks_Model/Open_Source_Files/Fastenal/M3_Hex_Nut_SKU_40326.SLDPRT
2_Mechanical/1_Solidworks_Model/Open_Source_Files/Fastenal/M3x25_SKU_39508.SLDPRT
2_Mechanical/1_Solidworks_Model/Open_Source_Files/Fastenal/M4x18_SKU_39519.SLDPRT
2_Mechanical/1_Solidworks_Model/Open_Source_Files/Fastenal/M4x8_Low_Profile_SKU_90564.SLDPRT
2_Mechanical/1_Solidworks_Model/Open_Source_Files/Fastenal/M5_Hex_Nut_SKU_40150.SLDPRT
2_Mechanical/1_Solidworks_Model/Open_Source_Files/Fastenal/M5x25_SKU_11103329.SLDPRT
2_Mechanical/1_Solidworks_Model/Open_Source_Files/Fastenal/M5x30_SKU_11103330.SLDPRT
2_Mechanical/1_Solidworks_Model/Open_Source_Files/Fastenal/M5x50_SKU_1139553.SLDPRT
2_Mechanical/1_Solidworks_Model/Open_Source_Files/Fastenal/M5x55_SKU_86034.SLDPRT
2_Mechanical/1_Solidworks_Model/Open_Source_Files/Fastenal/M5x60_SKU_11103335.SLDPRT
2_Mechanical/1_Solidworks_Model/Open_Source_Files/Fastenal/M5x80_SKU_0163627.SLDPRT
2_Mechanical/1_Solidworks_Model/Open_Source_Files/GT2 Belt 6mm x 40mm.SLDPRT
2_Mechanical/1_Solidworks_Model/Open_Source_Files/McMaster/91274A103_COATED ALLOY STEEL SOCKET HEAD CAP SCREW.SLDPRT
2_Mechanical/1_Solidworks_Model/Open_Source_Files/McMaster/91274A134_COATED ALLOY STEEL SOCKET HEAD CAP SCREW.SLDPRT
2_Mechanical/1_Solidworks_Model/Open_Source_Files/McMaster/92095A218_18-8 SS BUTTON-HEAD SOCKET CAP SCREW.SLDPRT
2_Mechanical/1_Solidworks_Model/Open_Source_Files/McMaster/92095A222_18-8 SS BUTTON-HEAD SOCKET CAP SCREW.SLDPRT
2_Mechanical/1_Solidworks_Model/Open_Source_Files/McMaster/92095A223_18-8 SS BUTTON-HEAD SOCKET CAP SCREW.SLDPRT
2_Mechanical/1_Solidworks_Model/Open_Source_Files/McMaster/94300A320_ZNC-PLTD STL AND IRON WING NUTS.SLDPRT
2_Mechanical/1_Solidworks_Model/Open_Source_Files/OpenBuilds Library/1 - Linear Rail/C-Beam 40x80x500 Linear Rail.SLDPRT
2_Mechanical/1_Solidworks_Model/Open_Source_Files/OpenBuilds Library/1 - Linear Rail/V-Slot 20x40x1000 Linear Rail.SLDPRT
2_Mechanical/1_Solidworks_Model/Open_Source_Files/OpenBuilds Library/1 - Linear Rail/V-Slot 20x40x1500 Linear Rail.SLDPRT
2_Mechanical/1_Solidworks_Model/Open_Source_Files/OpenBuilds Library/1 - Linear Rail/V-Slot 20x60x1500 Linear Rail.SLDPRT
2_Mechanical/1_Solidworks_Model/Open_Source_Files/OpenBuilds Library/1 - Linear Rail/V-Slot 20x60x500 Linear Rail.SLDPRT
2_Mechanical/1_Solidworks_Model/Open_Source_Files/OpenBuilds Library/1 - Linear Rail/V-Slot 20x80x500 Linear Rail.SLDPRT
2_Mechanical/1_Solidworks_Model/Open_Source_Files/OpenBuilds Library/1 - Linear Rail/V-Slot 40x40x1000 Linear Rail.SLDPRT
2_Mechanical/1_Solidworks_Model/Open_Source_Files/OpenBuilds Library/1 - Linear Rail/V-Slot 40x40x1500 Linear Rail.SLDPRT
2_Mechanical/1_Solidworks_Model/Open_Source_Files/OpenBuilds Library/1 - Linear Rail/V-Slot 40x40x500 Linear Rail.SLDPRT
2_Mechanical/1_Solidworks_Model/Open_Source_Files/OpenBuilds Library/10 - Shims and Spacers/Aluminum Spacer 1.5in.SLDPRT
2_Mechanical/1_Solidworks_Model/Open_Source_Files/OpenBuilds Library/10 - Shims and Spacers/Aluminum Spacer 20mm.SLDPRT
2_Mechanical/1_Solidworks_Model/Open_Source_Files/OpenBuilds Library/10 - Shims and Spacers/Aluminum Spacer 3mm.SLDPRT
2_Mechanical/1_Solidworks_Model/Open_Source_Files/OpenBuilds Library/10 - Shims and Spacers/Aluminum Spacer 40mm.SLDPRT
2_Mechanical/1_Solidworks_Model/Open_Source_Files/OpenBuilds Library/10 - Shims and Spacers/Flat Washer 0.25in.SLDPRT
2_Mechanical/1_Solidworks_Model/Open_Source_Files/OpenBuilds Library/10 - Shims and Spacers/Mini Eccentric Spacer 0.25in.SLDPRT
2_Mechanical/1_Solidworks_Model/Open_Source_Files/OpenBuilds Library/10 - Shims and Spacers/Precision Shim 10 x 5 x 1.SLDPRT
2_Mechanical/1_Solidworks_Model/Open_Source_Files/OpenBuilds Library/10 - Shims and Spacers/Shim Washer 8mm.SLDPRT
2_Mechanical/1_Solidworks_Model/Open_Source_Files/OpenBuilds Library/10 - Shims and Spacers/Slot Washer 15 x 5 x 2.SLDPRT
2_Mechanical/1_Solidworks_Model/Open_Source_Files/OpenBuilds Library/11- Makerlink/120 Angle Tee Nut.SLDPRT
2_Mechanical/1_Solidworks_Model/Open_Source_Files/OpenBuilds Library/11- Makerlink/135 Angle Tee Nut.SLDPRT
2_Mechanical/1_Solidworks_Model/Open_Source_Files/OpenBuilds Library/11- Makerlink/2 Way Tee Nut.SLDPRT
2_Mechanical/1_Solidworks_Model/Open_Source_Files/OpenBuilds Library/11- Makerlink/3 Way Tee Nut.SLDPRT
2_Mechanical/1_Solidworks_Model/Open_Source_Files/OpenBuilds Library/11- Makerlink/4 Way Tee Nut.SLDPRT
2_Mechanical/1_Solidworks_Model/Open_Source_Files/OpenBuilds Library/11- Makerlink/60 Angle Tee Nut.SLDPRT
2_Mechanical/1_Solidworks_Model/Open_Source_Files/OpenBuilds Library/11- Makerlink/90 Angle Tee Nut.SLDPRT
2_Mechanical/1_Solidworks_Model/Open_Source_Files/OpenBuilds Library/11- Makerlink/90 Hidden Tee Nut.SLDPRT
2_Mechanical/1_Solidworks_Model/Open_Source_Files/OpenBuilds Library/11- Makerlink/Quad Tee Nut.SLDPRT
2_Mechanical/1_Solidworks_Model/Open_Source_Files/OpenBuilds Library/7 - Hardware/8mm Acme Anti Backlash Nut Block.SLDPRT
2_Mechanical/1_Solidworks_Model/Open_Source_Files/OpenBuilds Library/7 - Hardware/8mm Acme Nut Block.SLDPRT
2_Mechanical/1_Solidworks_Model/Open_Source_Files/OpenBuilds Library/7 - Hardware/8mm Acme Nut Plate.SLDPRT
2_Mechanical/1_Solidworks_Model/Open_Source_Files/OpenBuilds Library/7 - Hardware/Double Tee Nut.SLDPRT
2_Mechanical/1_Solidworks_Model/Open_Source_Files/OpenBuilds Library/7 - Hardware/Flexible Coupling 5mm x 0.25in.SLDPRT
2_Mechanical/1_Solidworks_Model/Open_Source_Files/OpenBuilds Library/7 - Hardware/Lock Collar 0.25 in.SLDPRT
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
