tabdallah/capstone/4_Paddle_Controller/Paddle_Controller_Hardware_Options_Evaluation.xlsx

Paddle Controller Hardware Options Evaluation
Criteria | Weight | Option A | Option B | Option C
Meets technical requirements | 10 | 0 | 2 | 2
Cost | 5 | 2 | 0 | 1
Complexity | 5 | 1 | 2 | 1
Lead Time | 10 | 2 | 0 | 1
Ease of Manufacturing & Rework | 10 | 0 | 0 | 2
Design Effort | 2 | 2 | 1 | 1
Score |  | 39 | 32 | 62
