tabdallah/capstone/5_Master_Controller/2_Reference_Material/thomas_abdallah_log_book.html

# Weekly Log Book - Thomas Abdallah

Image of Thomas

## Week 1

- Worked with Stan and David to develop project plan
- Developed CAN firmware for HCS12 microcontroller
- Debugged issues with CAN Rx ISR causing 'illegal bp' (unresolved)

## Week 2

- Developed CAN network layout (https://github.com/eelmand/S6Project/blob/master/Project%20Plan/Elevator_CAN_Network.pdf) and protocol proposal (https://github.com/eelmand/S6Project/blob/master/Project%20Plan/Shared_CAN_Protocol_Proposal.xlsx) with Stan and David
- Reviewed proposal with class - agreed to all use same protocol and network layout at 125kBaud
- Fixed issues with CAN Rx ISR causing 'illegal bp'
  - Was caused by initializing the timer module with overflow interrupts enabled, but forgot to include the interrupt handler in the project
- Implemented a FIFO library for storing Rx CAN messages
  - Using dynamic memory allocation on the HCS12 (i.e. malloc) requires rebuilding the libraries with a sensible heap size
  - Default heap size is 2000 bytes which is more than the available amount of RAM on our chip - this causes errors during linking
  - Instructions for rebuilding the libraries (https://community.nxp.com/thread/388977)
- Started implementing "Elevator Controller" module
  - Using my own project board from Semester 4 as it already has a Scmitt trigger and a DAC
  - Ultrasonic sensor implementation complete
    - Using OC to send the 'trigger' pulse (10uS @20mS period) to the sensor
    - Using IC to measure the 'echo' waveform pulse width
      - Distance (cm) = Pulse Width (uS) / 58
      - IC is messy without a Schmitt trigger to clean up the input signal
      - Using the encoder input on my board as it already has this
    - Using LCD to display the current distance measurement in cm
  - Motor control implementation started
    - Using SPI controlled DAC to send analog voltage to servo-amp
    - Working on closed-loop control today (2017-05-19)

## Week 3

- Finished elevator controller implementation
  - Using input-capture to measure ultrasonic sensor distance and convert to 'floor number'
  - Using SPI controlled DAC to control motor voltage
  - Closed loop (PI) controller implemented based on floor request
  - Fully validated - code frozen and ready for entire class to use
- Installed PCAN Linux drivers
  - This is not straight forward (http://www.peak-system.com/forum/viewtopic.php?f=59&t=256)
  - Drivers do not stay installed after rebooting Virtual Machine - okay for now
- Installed PCAN Basic API (Python and C++ support)
- Started playing with PCAN Basic API in Python to initialize and Tx/Rx messages
- Implemented a basic "SC" Python script that just sends commands to EC and prints out status stuff
- Designed state machine for SC (https://eelmand.github.io/S6Project/Website/about.html#sc_state_machine)
- Implemented State Machine in Python - Supervisory Controller fully functional
- Worked with David to build 2 more floor controllers and set up a table for our CAN network testing
- Started testing complete CAN network (simulating Car Controller with USB to CAN device)

## Week 4

- Finished system integration with addition of Car Controller
- Filmed video of complete system functionality
- Revamped my logbook page using the new shared bootstrap theme and header
- Developed test plans for Elevator Controller, Supervisory Controller, and complete system
- Completed System Testing

## Week 5

- Skeched out Web UI design ideas with David and Stan
- Started prototyping Debug UI pages
- Played around with JS integration
- Set up an ngrok server to host our website (http://adequateelevators.com)

## Week 6

- Finished prototyping of Debug UI pages
- Implemented CAN Viewer page which will show live CAN signal values (simulated values for now)
- Implemented CAN Visualizer page which will show live representation of CAN nodes (simulated values for now)

## Week 7

- Created a SQL database on my Linux VM - to be used for the project website
- Created a simple table with signal names, raw and physical values, and timestamps
- Entered some fake data in the table to play around with Queries in PHP
- Wrote PHP script to query most recent value of each signal in the table and display on a page
- Implemented database querying for the CAN viewer page
- Improved PHP x Javascript interaction by using JSON to pass data rather than separate variables
- Working on using an AJAX request (https://stackoverflow.com/questions/32241639/run-php-script-every-10-seconds) to refresh signal values from the database every second

Structure of our Database as of Week 7

- SCHEMA name: 'elevator'
- TABLES: 'signals'
  - 'signals' table will store all CAN signals and their values with timestamps

Image of our database

## Week 8

- Installed python-mysqldb library
- Added basic MySQL functionality to supervisory controller (dumping Tx and Rx signals to DB)
- Basic MySQL integration in Python (https://stackoverflow.com/questions/372885/how-do-i-connect-to-a-mysql-database-in-python)
- Debug CAN Signal Viewer now shows remote request signal from database
- Supervisory Controller now dumps CAN signals into database as they are received
- Supervisory Controller now dumps State Machine signals into database as they are generated
- Supervisory Controller now reads 'REMOTE_REQ' signal from database as it is generated

## Week 9 - 10

- Worked on "Request Access" page features
- On submission the user info is added to a table "new_users" (username, password, first_name, last_name)
- On submisison an email is sent to the site administrators notifying them of the access request
- To do: Add "grant access" button in that email which will move that users info from "new_users" table to the "users" table

## Week 11

- Migrating site hosting to godaddy.com
- Added specific directive (https://stackoverflow.com/questions/24214106/php-code-written-in-html-file-doesnt-work-on-1and1-hosting-but-works-on-000webh)to .htaccess file to enable php on html pages
- How to perform a sparse checkout on GIT (https://stackoverflow.com/questions/600079/how-do-i-clone-a-subdirectory-only-of-a-git-repository)
- Finished implementation of request/grant access scheme
- Started working on migrating SC functionality to Raspberry Pi

## Week 12

- Migrated Supervisory Controller to Raspberry Pi
- Recorded video of completed system including Website (link soon)
- Added more Admin functionality for user management
  - Grant/revoke access
  - User last login time

Copyright © 2017 ESE Team
