tabdallah/capstone/2_Mechanical/1_Solidworks_Model/Open_Source_Files/OpenBuilds Library/PDF Drawings/8mm Acme Anti Backlash Nut Block.PDF

M5X0.8 THRU
Tr 8X8-2 THRU ALL

TITLE: 8mm Acme Anti Backlash Nut Block

PART# 1055 | MATERIAL: PTFE filled Delrin
