tabdallah/capstone/2_Mechanical/1_Solidworks_Model/Open_Source_Files/OpenBuilds Library/PDF Drawings/8mm Acme Nut Block.PDF

Tr 8X8-2 THRU ALL

TITLE: 8mm Acme Nut Block

PART# 740 | MATERIAL: PTFE filled Delrin
