tabdallah/capstone/2_Mechanical/1_Solidworks_Model/Open_Source_Files/OpenBuilds Library/PDF Drawings/8mm Acme Nut Plate.PDF

TITLE: 8mm Acme Nut Plate

PART# 855 | MATERIAL: PTFE Filled Delrin

Tr 8X8-2 THRU ALL
