tabdallah/capstone/2_Mechanical/1_Solidworks_Model/Open_Source_Files/OpenBuilds Library/PDF Drawings/Aluminum Spacers.PDF

Length | Part#
1/8" | 825
1/4" | 15
1-1/2" | 80
3mm | 175
6mm | 90
9mm | 225
20mm | 65
35mm | 1040
40mm | 95

TITLE: Aluminum Spacers

PART# | MATERIAL: Aluminum
