tabdallah/capstone/2_Mechanical/1_Solidworks_Model/Open_Source_Files/OpenBuilds Library/PDF Drawings/C-Beam Gantry Plate.PDF

8X M5X0.8 THRU ALL; 17X 5.10 THRU; SECTION A-A

TITLE: C-Beam Gantry Plate

PART# 970 | MATERIAL: Aluminum
