tabdallah/capstone/2_Mechanical/1_Solidworks_Model/Open_Source_Files/OpenBuilds Library/PDF Drawings/Eccentric Spacer 0.25in.PDF

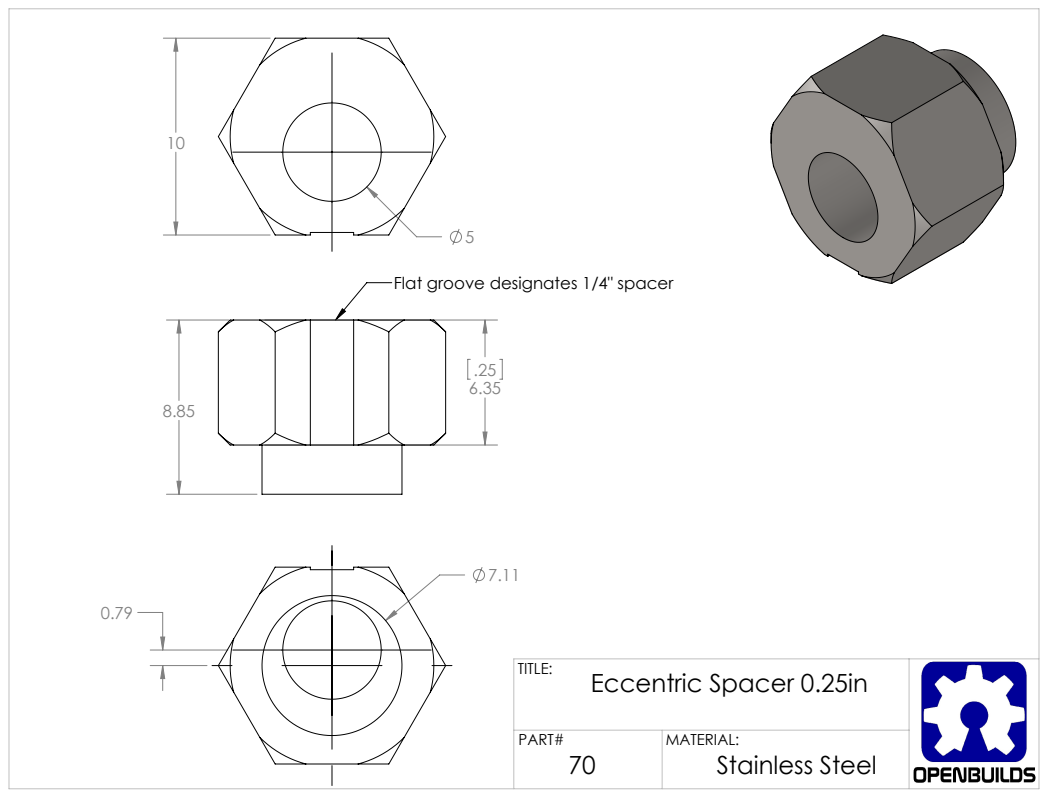
[picture p271: page 1]

Flat groove designates 1/4" spacer

TITLE: Eccentric Spacer 0.25in

PART# 70 | MATERIAL: Stainless Steel
