tabdallah/capstone/2_Mechanical/1_Solidworks_Model/Open_Source_Files/OpenBuilds Library/PDF Drawings/Eccentric Spacer 6mm.PDF

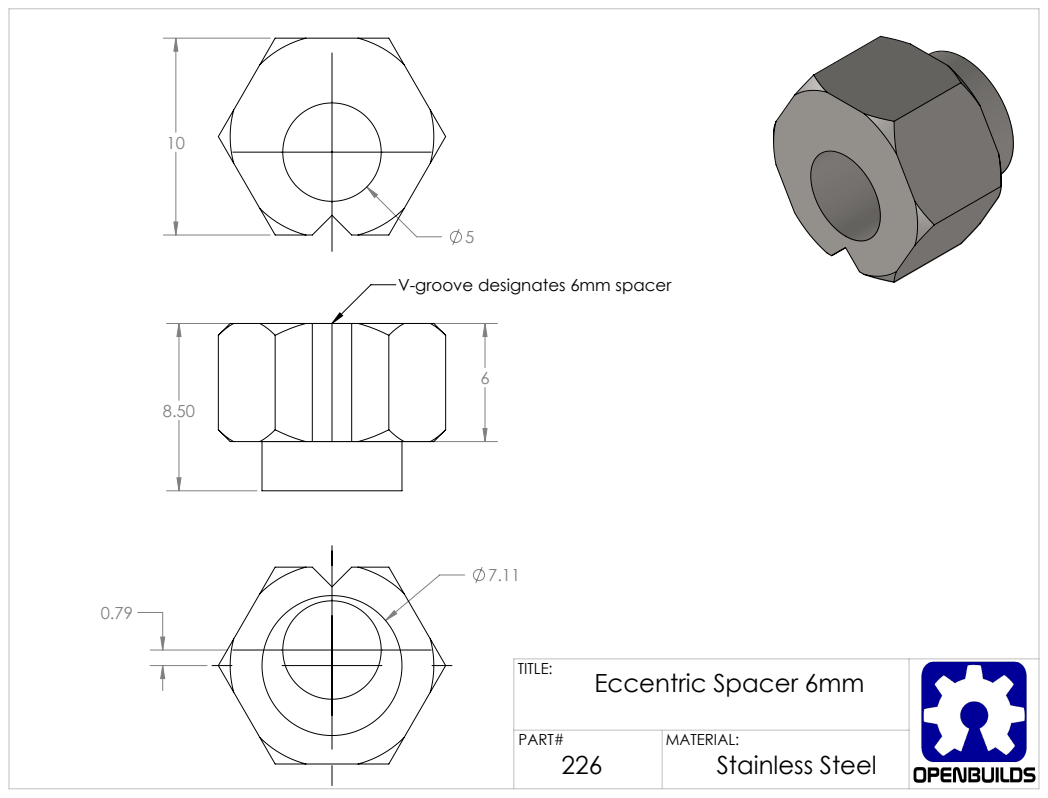
[picture p272: page 1]

V-groove designates 6mm spacer

TITLE: Eccentric Spacer 6mm

PART# 226 | MATERIAL: Stainless Steel
