tabdallah/capstone/2_Mechanical/1_Solidworks_Model/Open_Source_Files/OpenBuilds Library/PDF Drawings/Idler Pulley Plate.PDF

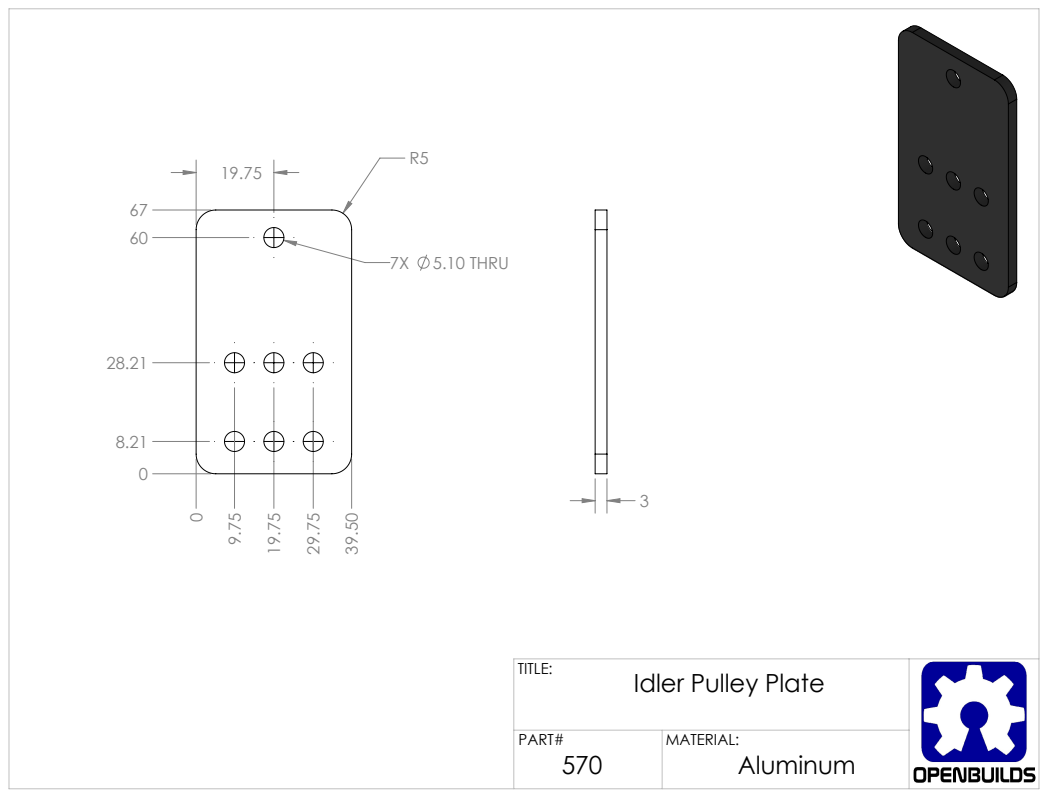
[picture p273: page 1]
7X 5.10 THRU

TITLE: Idler Pulley Plate

PART# 570 | MATERIAL: Aluminum
