tabdallah/capstone/2_Mechanical/1_Solidworks_Model/Open_Source_Files/OpenBuilds Library/PDF Drawings/Joining Strip Plate 2 Hole.PDF

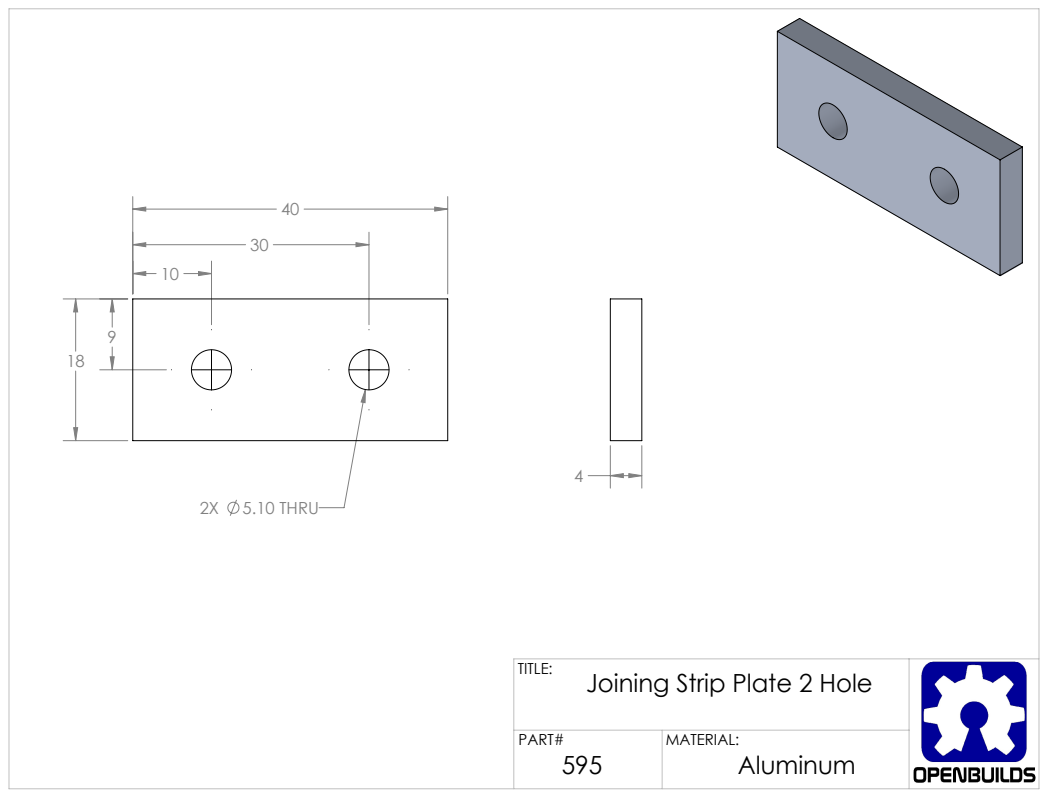
[picture p274: page 1]
2X 5.10 THRU

TITLE: Joining Strip Plate 2 Hole

PART# 595 | MATERIAL: Aluminum
