tabdallah/capstone/2_Mechanical/1_Solidworks_Model/Open_Source_Files/OpenBuilds Library/PDF Drawings/Joining Strip Plate 3 Hole.PDF

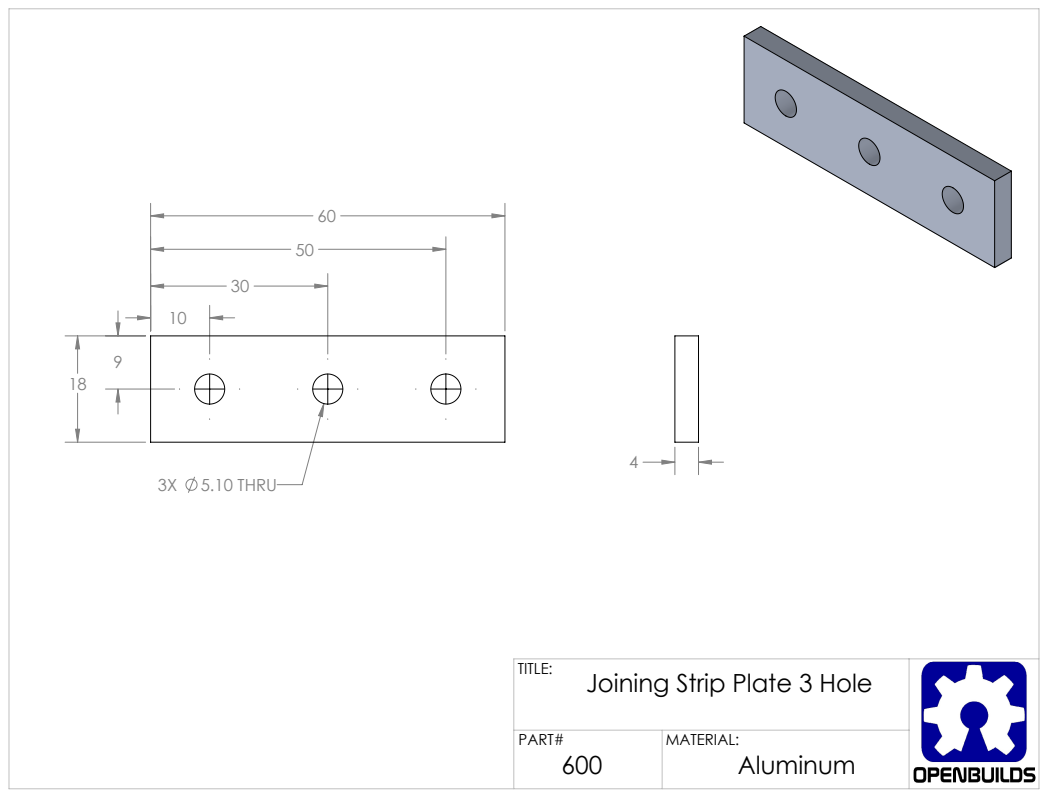
[picture p275: page 1]
3X 5.10 THRU

TITLE: Joining Strip Plate 3 Hole

PART# 600 | MATERIAL: Aluminum
