tabdallah/capstone/2_Mechanical/1_Solidworks_Model/Open_Source_Files/OpenBuilds Library/PDF Drawings/Linear Actuator End Mount.PDF

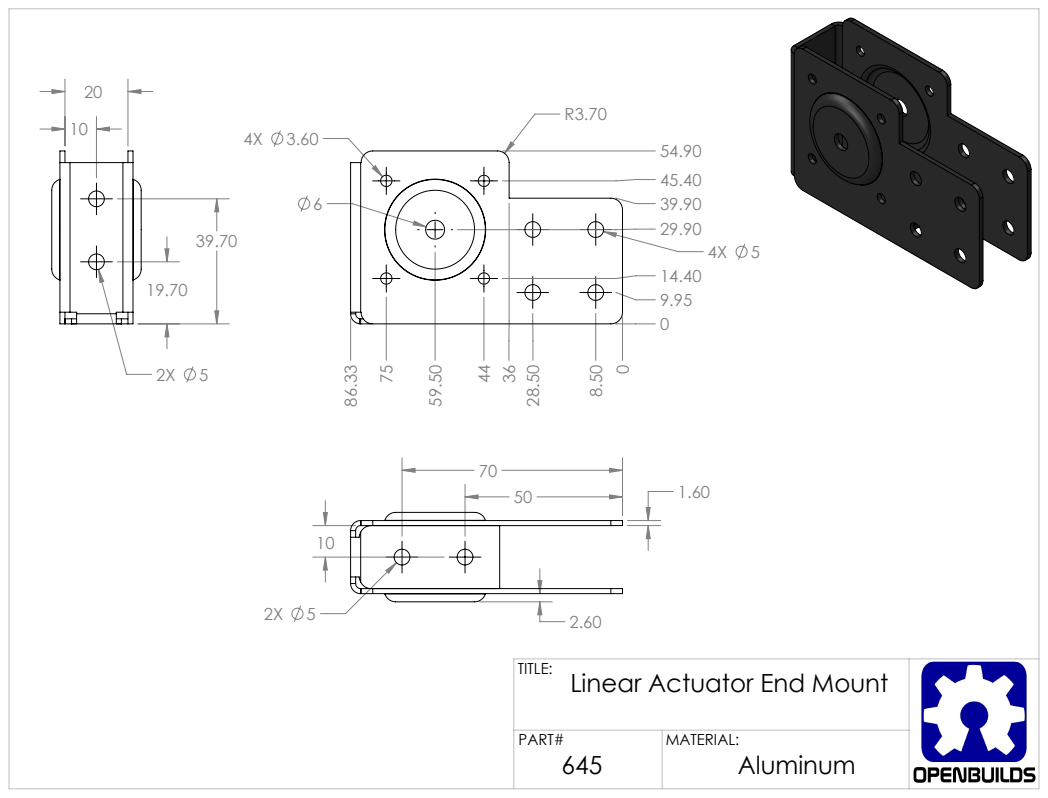
[picture p276: page 1]

TITLE: Linear Actuator End Mount

PART# 645 | MATERIAL: Aluminum
