tabdallah/capstone/2_Mechanical/1_Solidworks_Model/Open_Source_Files/OpenBuilds Library/PDF Drawings/Micro Limit Switch Plate.PDF

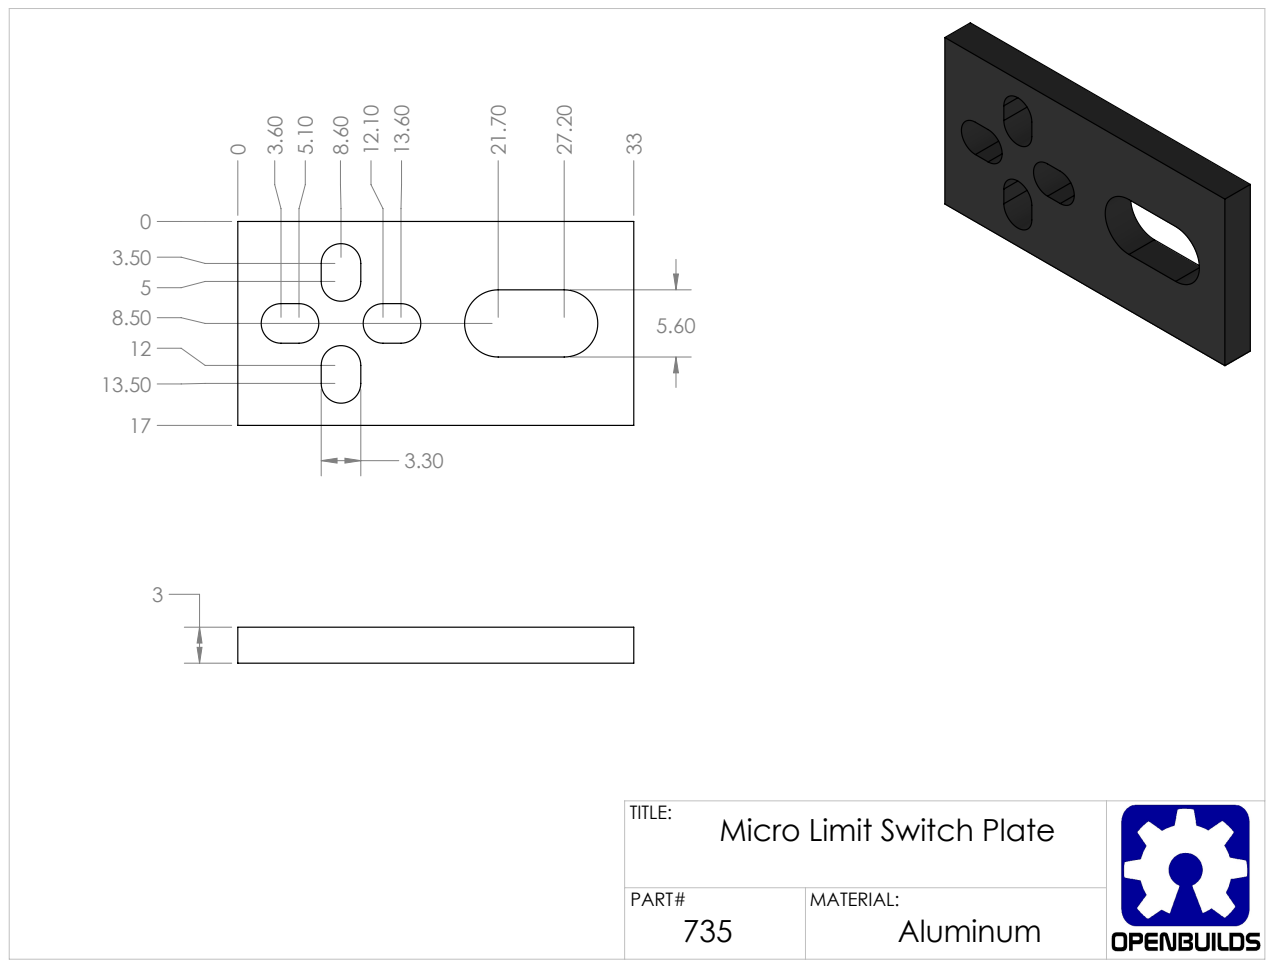
[picture p277: page 1]

TITLE: Micro Limit Switch Plate

PART# 735 | MATERIAL: Aluminum
