tabdallah/capstone/2_Mechanical/1_Solidworks_Model/Open_Source_Files/OpenBuilds Library/PDF Drawings/Mini Eccentric Spacer 0.25in.PDF

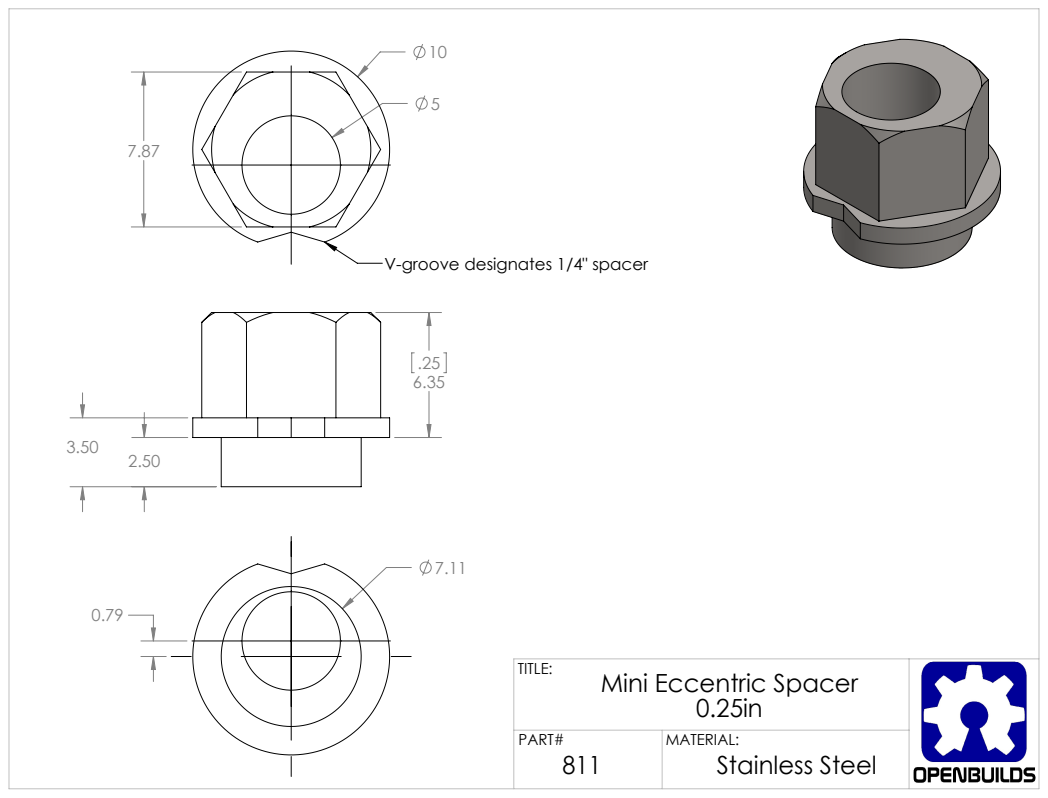
[picture p278: page 1]

V-groove designates 1/4" spacer

TITLE: Mini Eccentric Spacer 0.25in

PART# 811 | MATERIAL: Stainless Steel
