tabdallah/capstone/2_Mechanical/1_Solidworks_Model/Open_Source_Files/OpenBuilds Library/PDF Drawings/Mini Eccentric Spacer 6mm.PDF

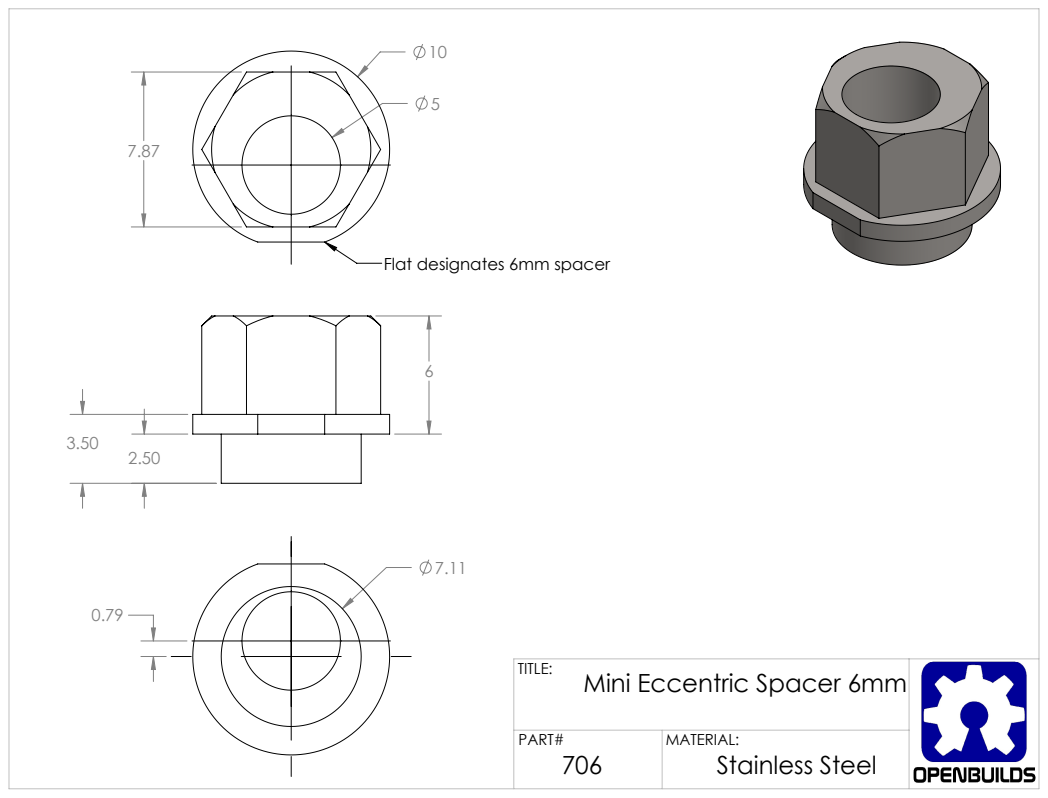
[picture p279: page 1]

Flat designates 6mm spacer

TITLE: Mini Eccentric Spacer 6mm

PART# 706 | MATERIAL: Stainless Steel
