tabdallah/capstone/2_Mechanical/1_Solidworks_Model/Open_Source_Files/OpenBuilds Library/PDF Drawings/Mini V Wheel Plate.PDF

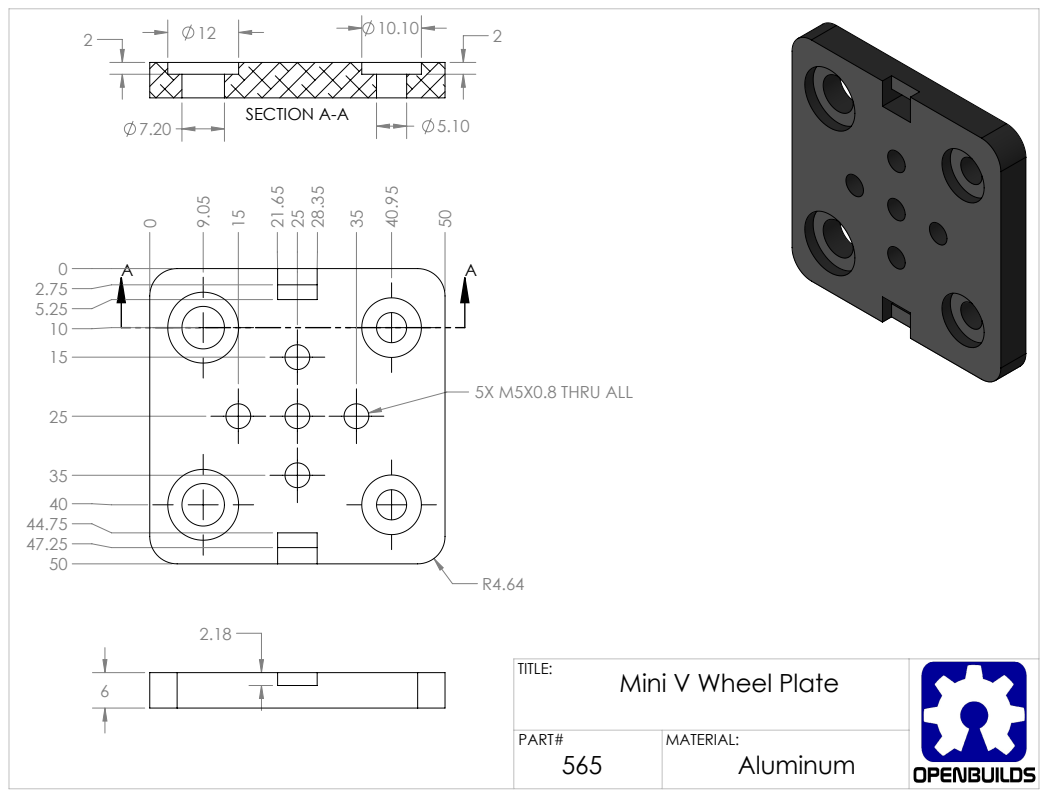
[picture p280: page 1]
5X M5X0.8 THRU ALL; 5.10 SECTION A-A

TITLE: Mini V Wheel Plate

PART# 565 | MATERIAL: Aluminum
