tabdallah/capstone/2_Mechanical/1_Solidworks_Model/Open_Source_Files/OpenBuilds Library/PDF Drawings/Mini V Wheel.PDF

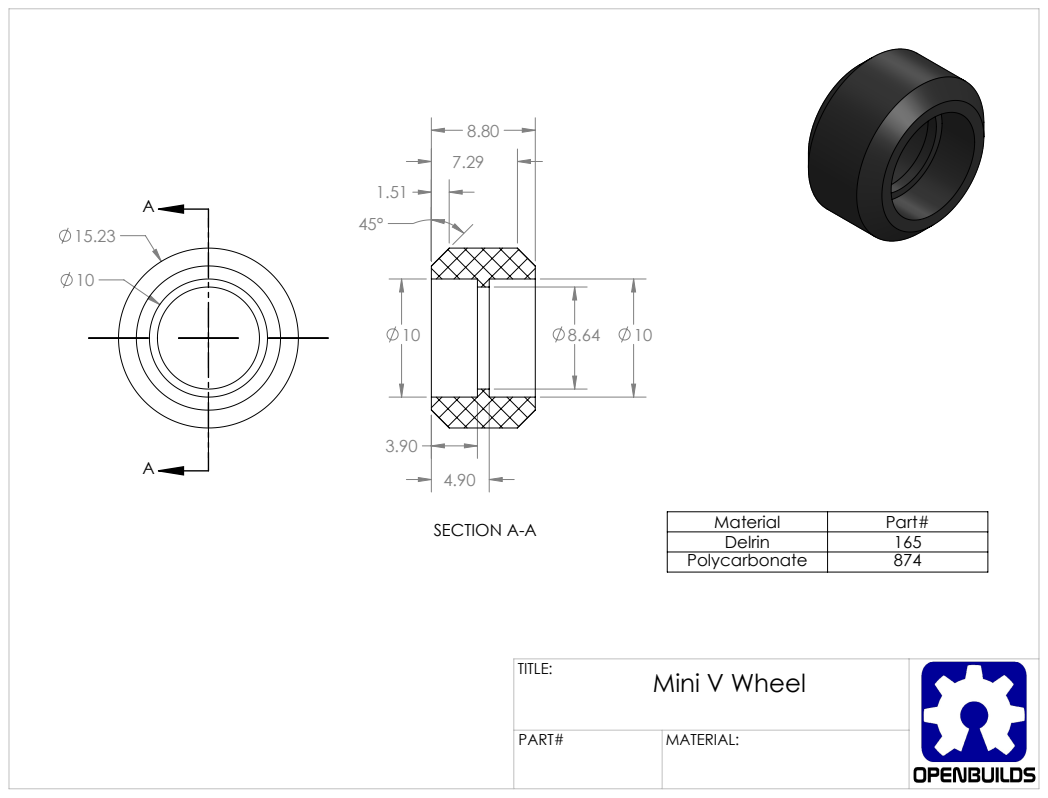
[picture p281: page 1]
SECTION A-A; Material; Part#

Delrin | 165
Polycarbonate | 874

TITLE: Mini V Wheel

PART# | MATERIAL:
