tabdallah/capstone/2_Mechanical/1_Solidworks_Model/Open_Source_Files/OpenBuilds Library/PDF Drawings/Motor Mount Plate Nema 17.PDF

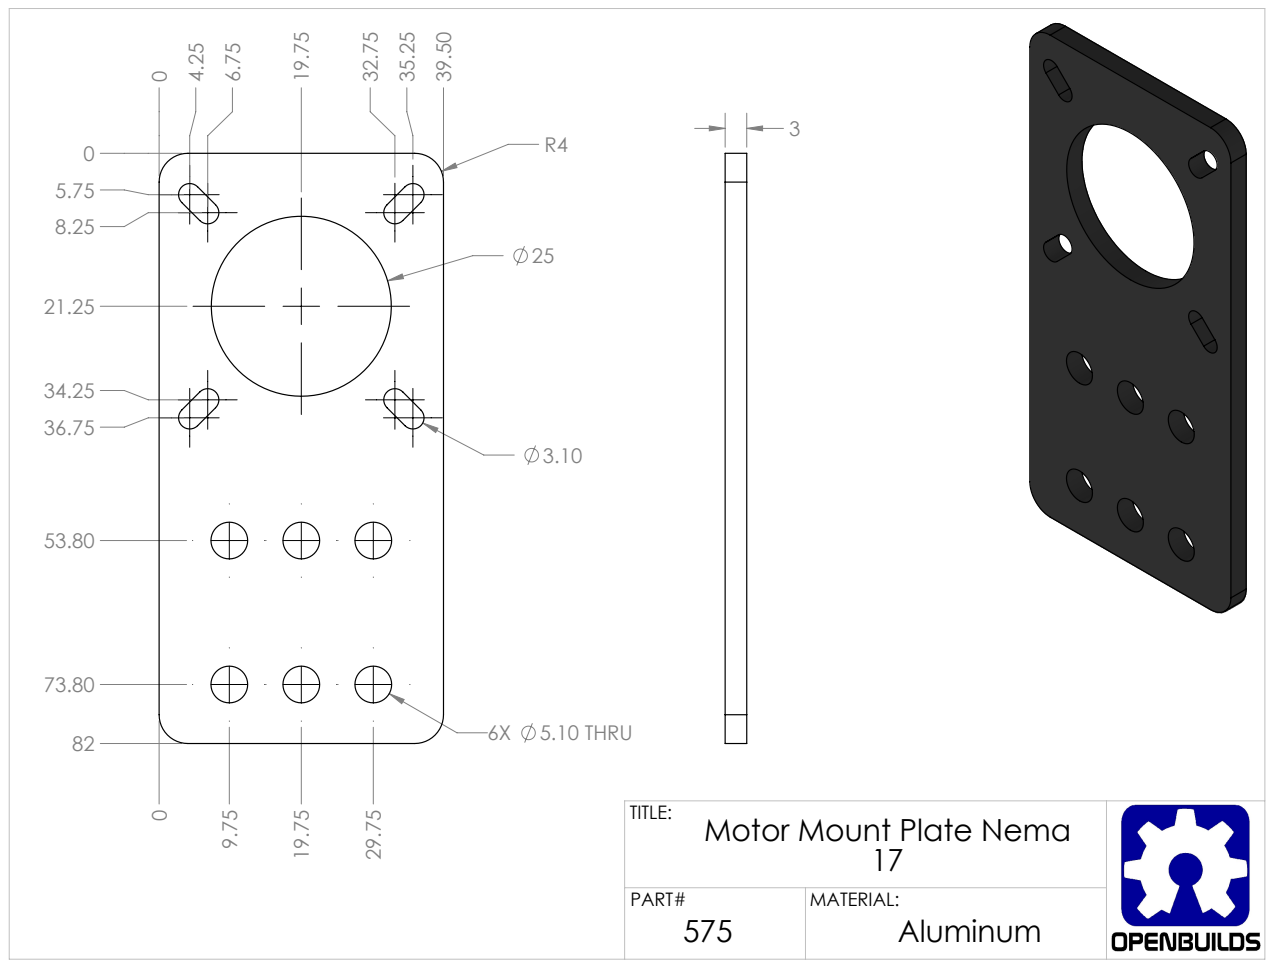
[picture p282: page 1]
6X 5.10 THRU

TITLE: Motor Mount Plate Nema 17

PART# 575 | MATERIAL: Aluminum
