tabdallah/capstone/2_Mechanical/1_Solidworks_Model/Open_Source_Files/OpenBuilds Library/PDF Drawings/Motor Mount Plate Nema 23.PDF

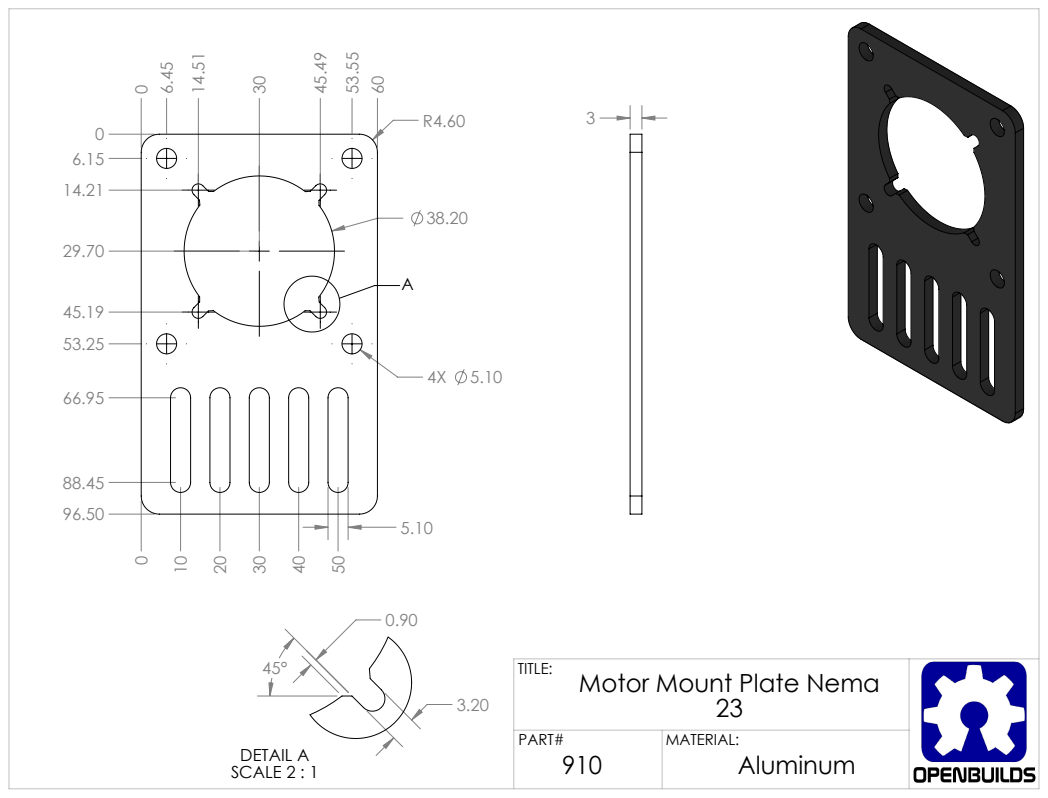
[picture p283: page 1]
DETAIL A SCALE 2 : 1

TITLE: Motor Mount Plate Nema 23

PART# 910 | MATERIAL: Aluminum
