tabdallah/capstone/2_Mechanical/1_Solidworks_Model/Open_Source_Files/OpenBuilds Library/PDF Drawings/Mounting Hub 5mm.PDF

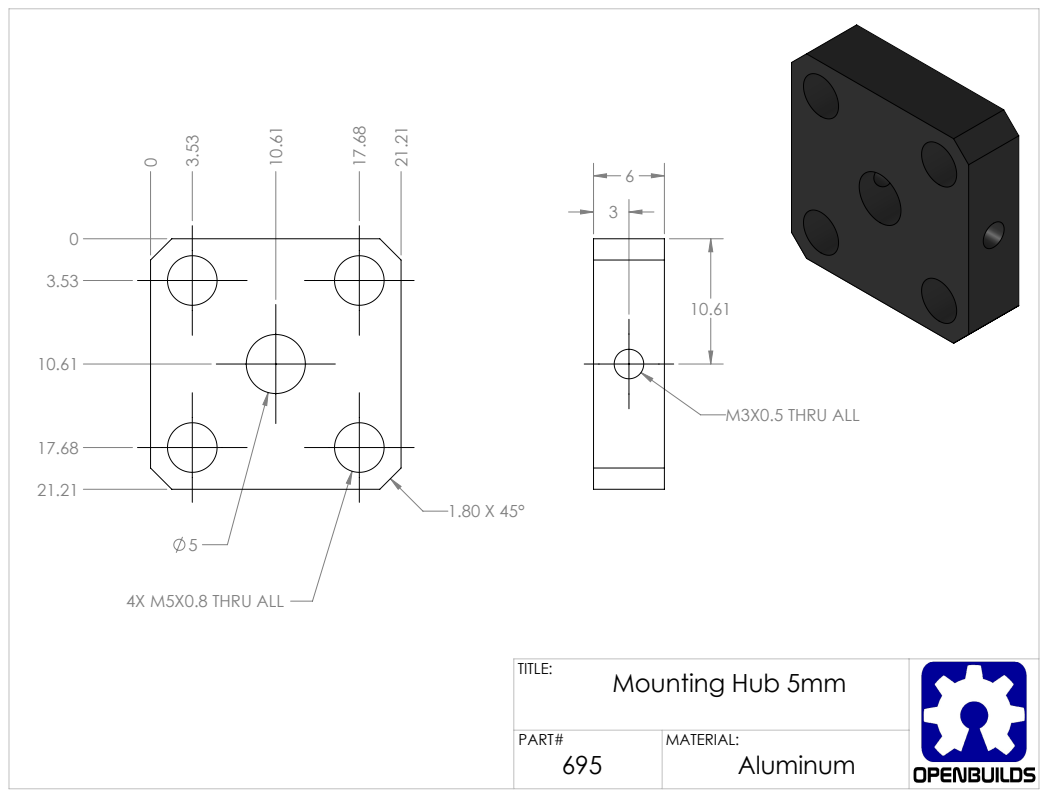
[picture p284: page 1]
4X M5X0.8 THRU ALL; M3X0.5 THRU ALL

TITLE: Mounting Hub 5mm

PART# 695 | MATERIAL: Aluminum
