tabdallah/capstone/2_Mechanical/1_Solidworks_Model/Open_Source_Files/OpenBuilds Library/PDF Drawings/Open Rail Gantry Plate 20mm.PDF

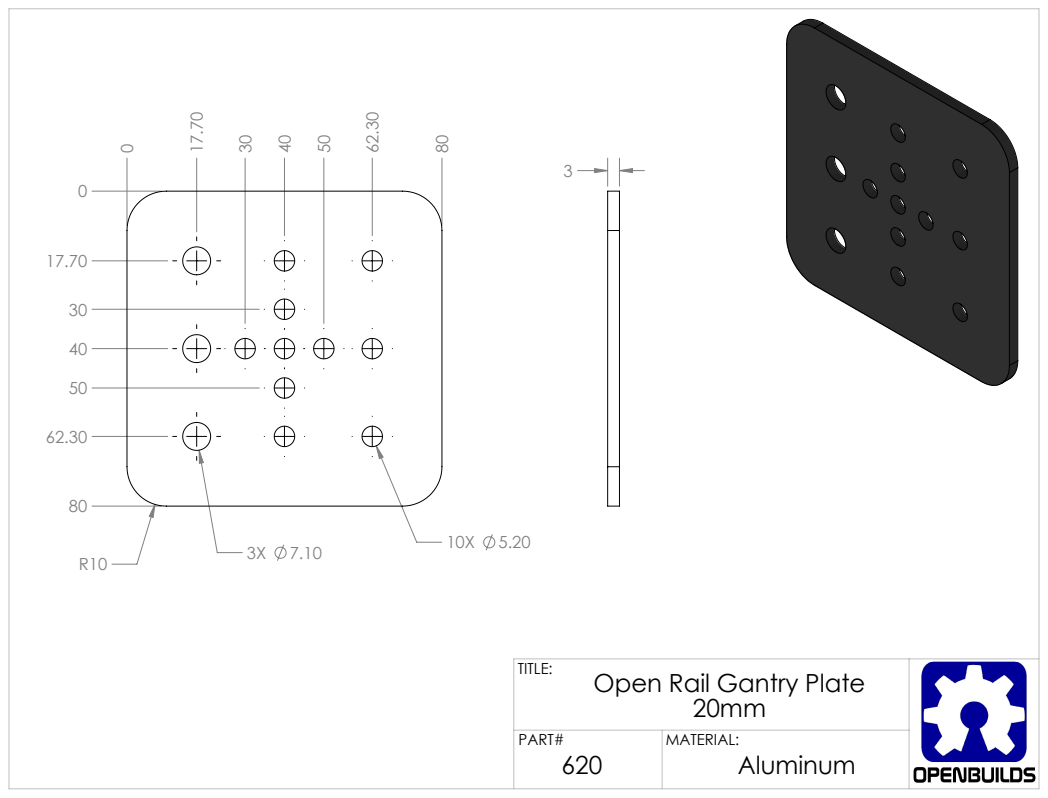
[picture p285: page 1]

TITLE: Open Rail Gantry Plate 20mm

PART# 620 | MATERIAL: Aluminum
