tabdallah/capstone/2_Mechanical/1_Solidworks_Model/Open_Source_Files/OpenBuilds Library/PDF Drawings/Open Rail Gantry Plate 40mm.PDF

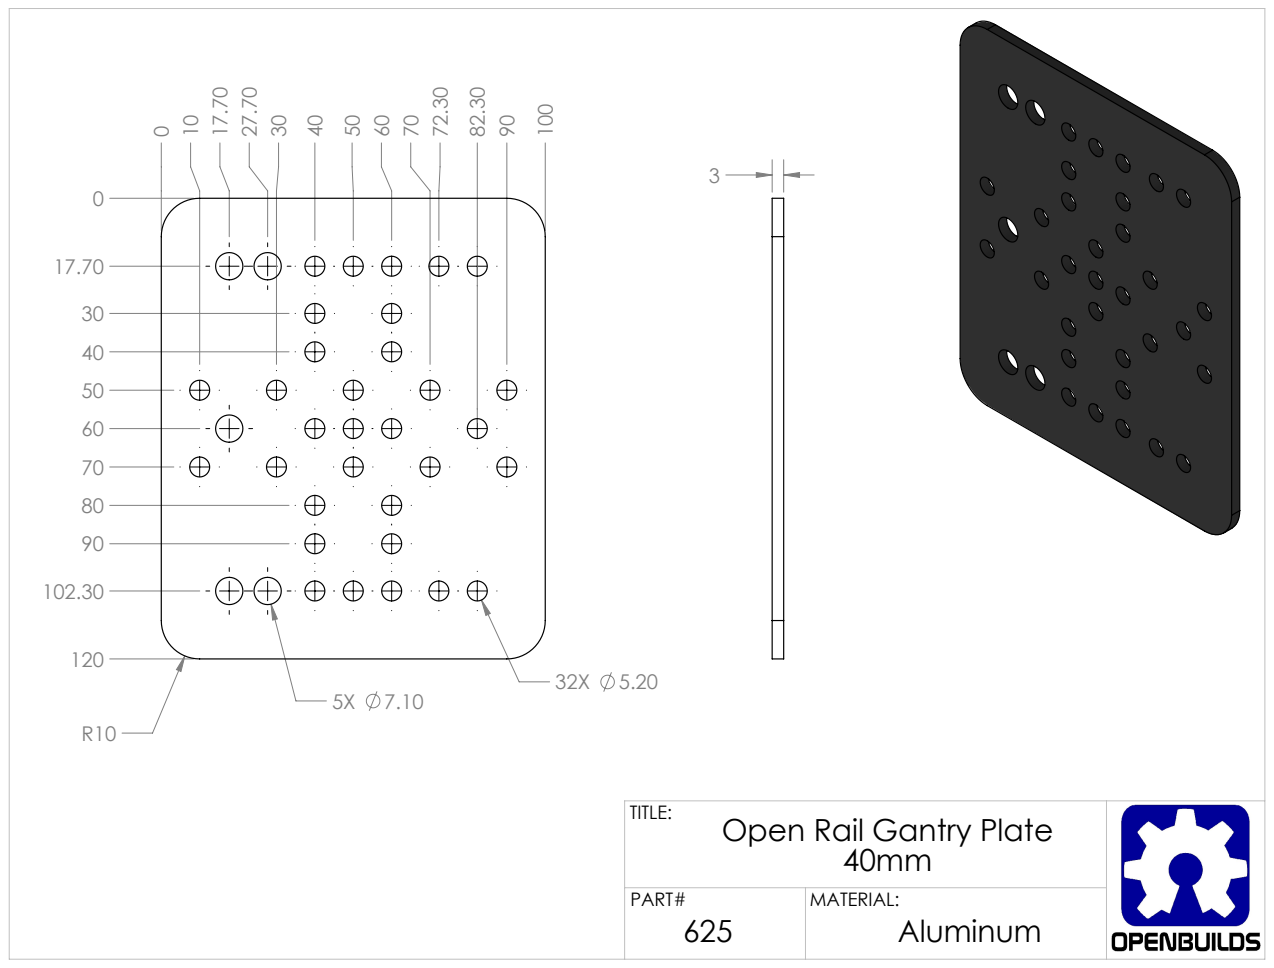
[picture p286: page 1]

TITLE: Open Rail Gantry Plate 40mm

PART# 625 | MATERIAL: Aluminum
