tabdallah/capstone/2_Mechanical/1_Solidworks_Model/Open_Source_Files/OpenBuilds Library/PDF Drawings/Open Rail Gantry Plate 60mm.PDF

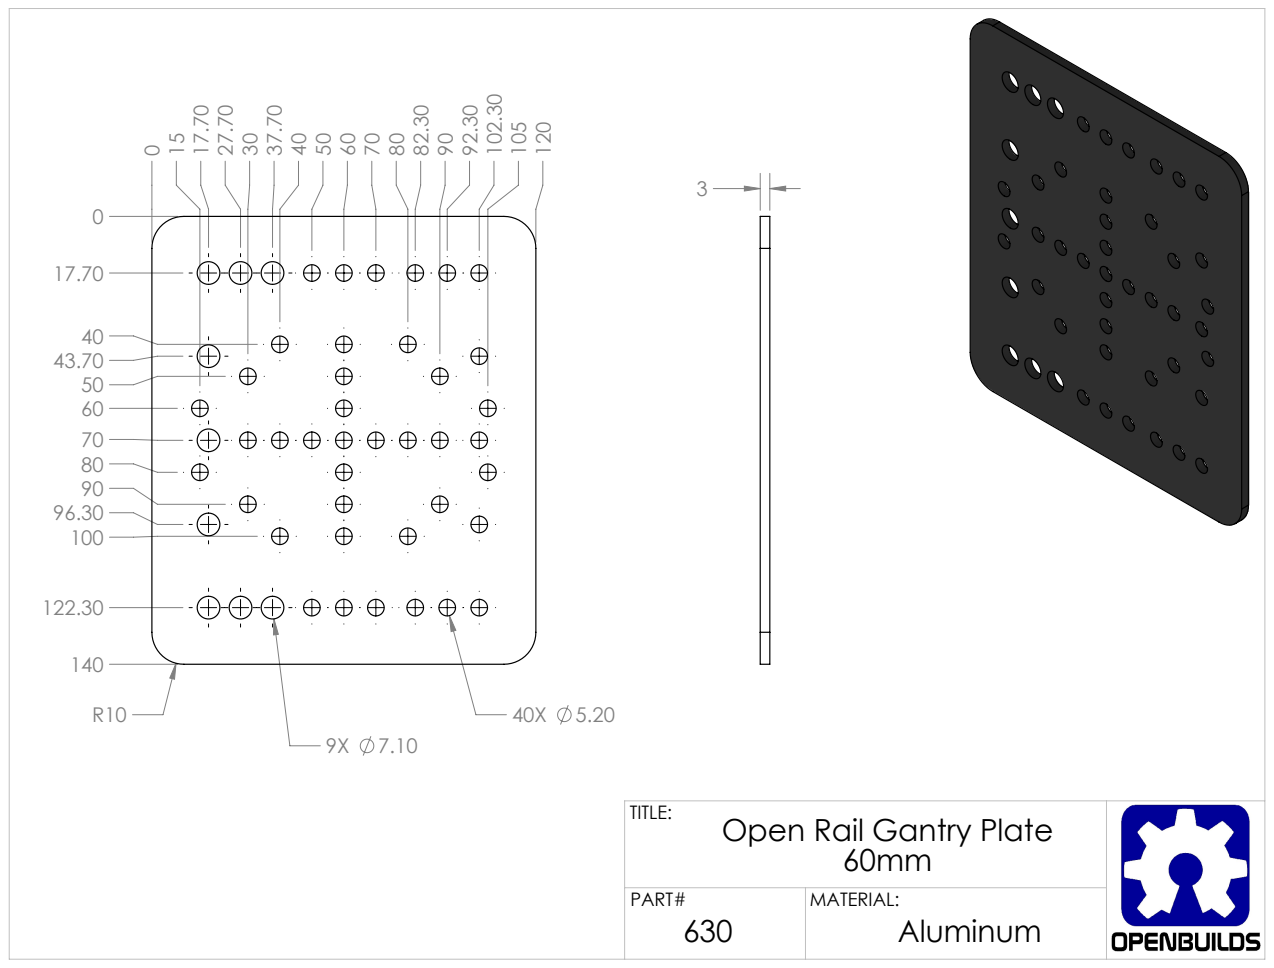
[picture p287: page 1]

TITLE: Open Rail Gantry Plate 60mm

PART# 630 | MATERIAL: Aluminum
