tabdallah/capstone/2_Mechanical/1_Solidworks_Model/Open_Source_Files/OpenBuilds Library/PDF Drawings/Open Rail Gantry Plate 80mm.PDF

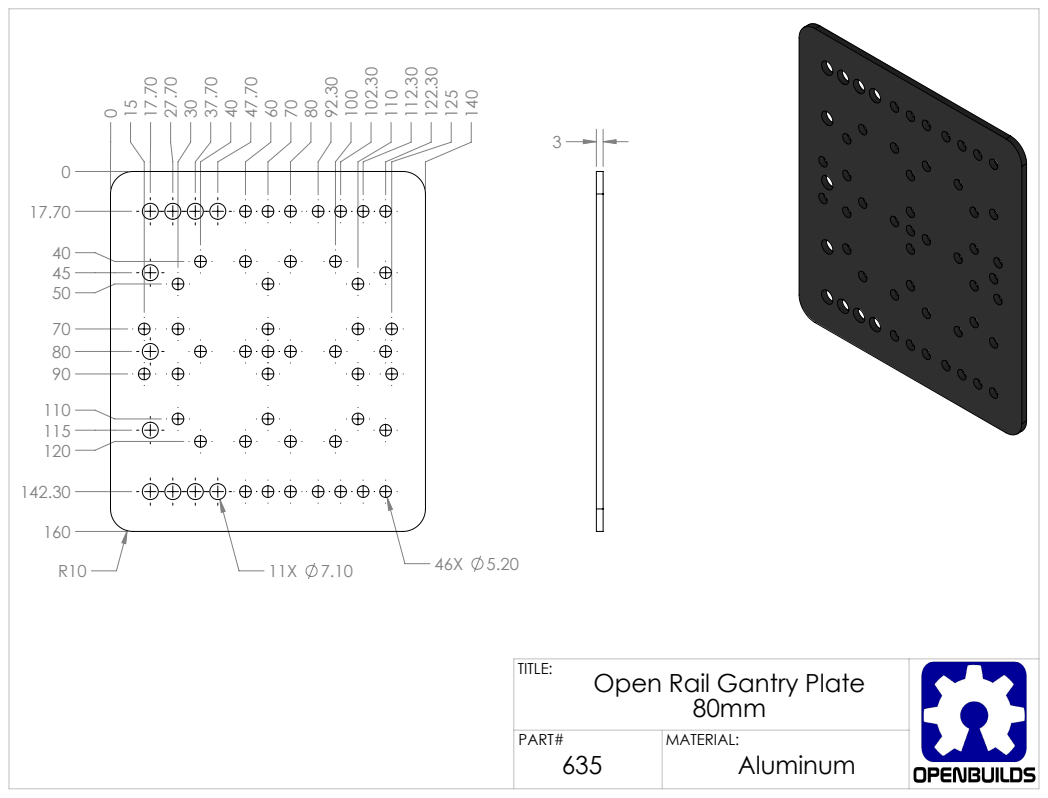
[picture p288: page 1]

TITLE: Open Rail Gantry Plate 80mm

PART# 635 | MATERIAL: Aluminum
