tabdallah/capstone/2_Mechanical/1_Solidworks_Model/Open_Source_Files/OpenBuilds Library/PDF Drawings/Router Spindle Mount.PDF

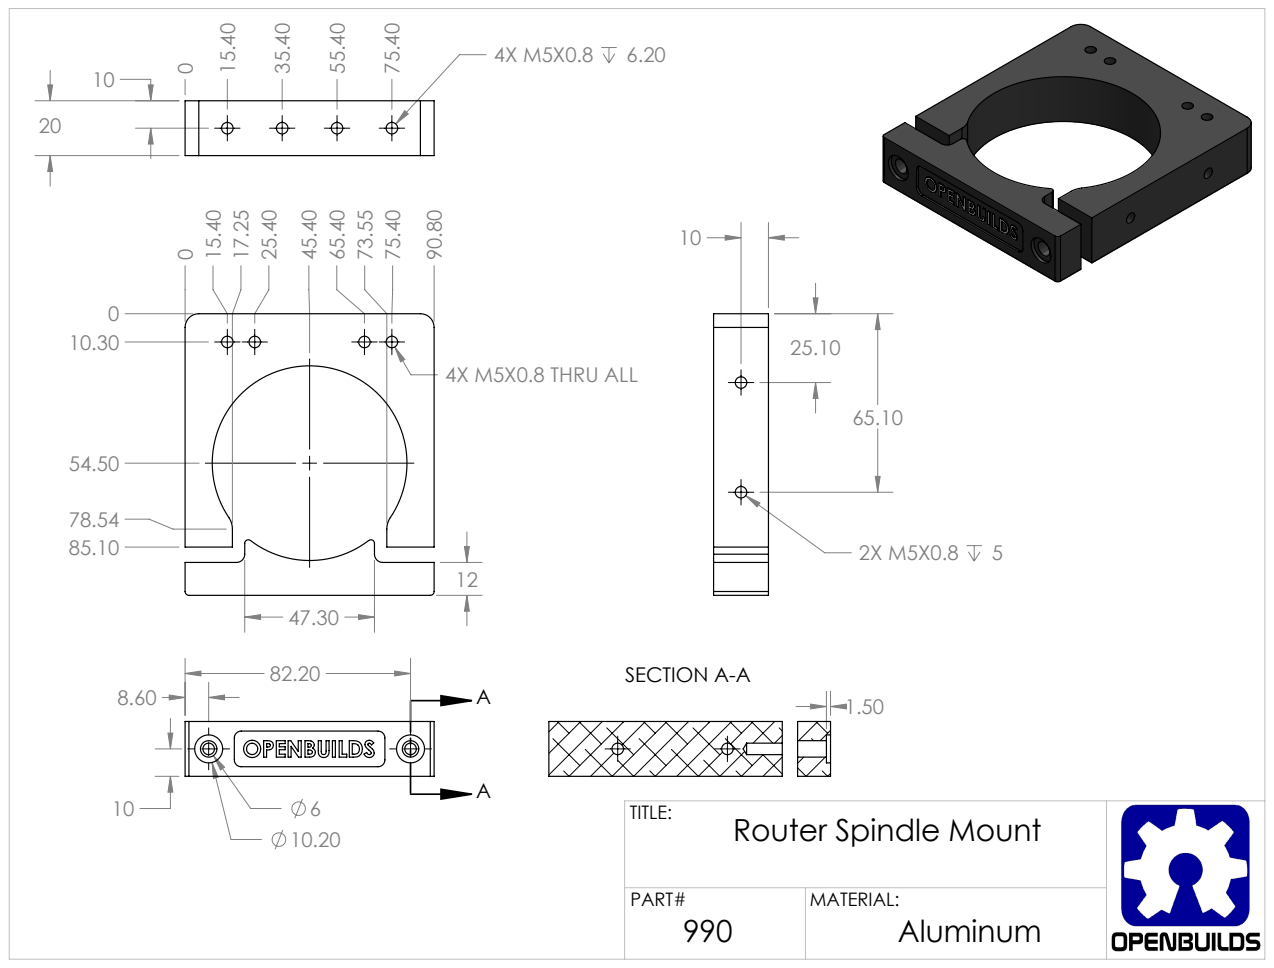
[picture p289: page 1]
4X M5X0.8 THRU ALL; SECTION A-A

TITLE: Router Spindle Mount

PART# 990 | MATERIAL: Aluminum
