tabdallah/capstone/2_Mechanical/1_Solidworks_Model/Open_Source_Files/OpenBuilds Library/PDF Drawings/Smooth Idler Pulley Wheel.PDF

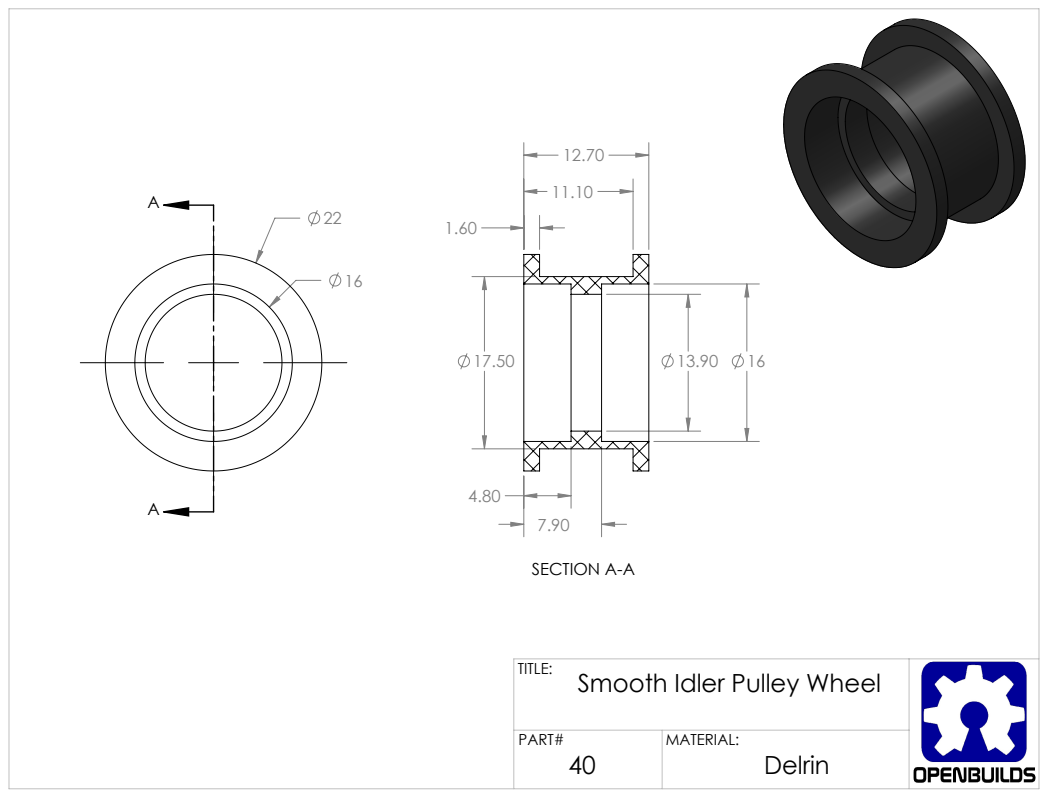
[picture p290: page 1]
SECTION A-A

TITLE: Smooth Idler Pulley Wheel

PART# 40 | MATERIAL: Delrin
