tabdallah/capstone/2_Mechanical/1_Solidworks_Model/Open_Source_Files/OpenBuilds Library/PDF Drawings/Solid V Wheel.PDF

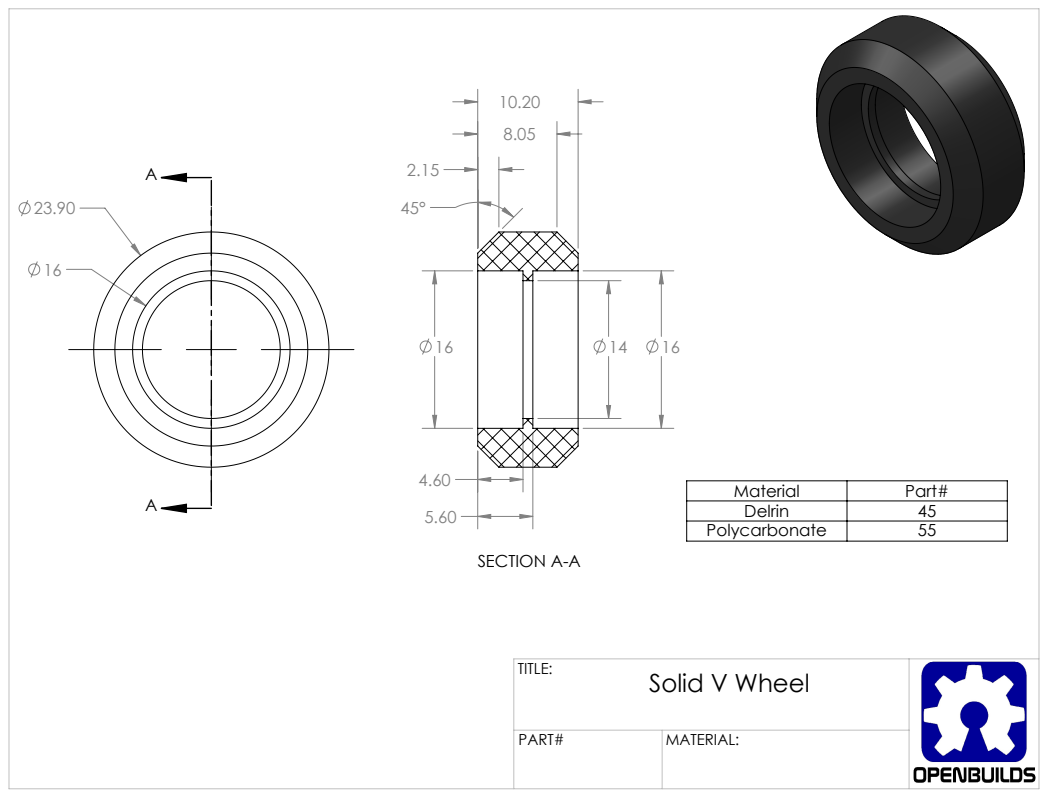
[picture p291: page 1]
SECTION A-A

Material | Part#
Delrin | 45
Polycarbonate | 55

TITLE: Solid V Wheel

PART# | MATERIAL:
