tabdallah/capstone/2_Mechanical/1_Solidworks_Model/Open_Source_Files/OpenBuilds Library/PDF Drawings/Threaded Rod Plate Nema 17.PDF

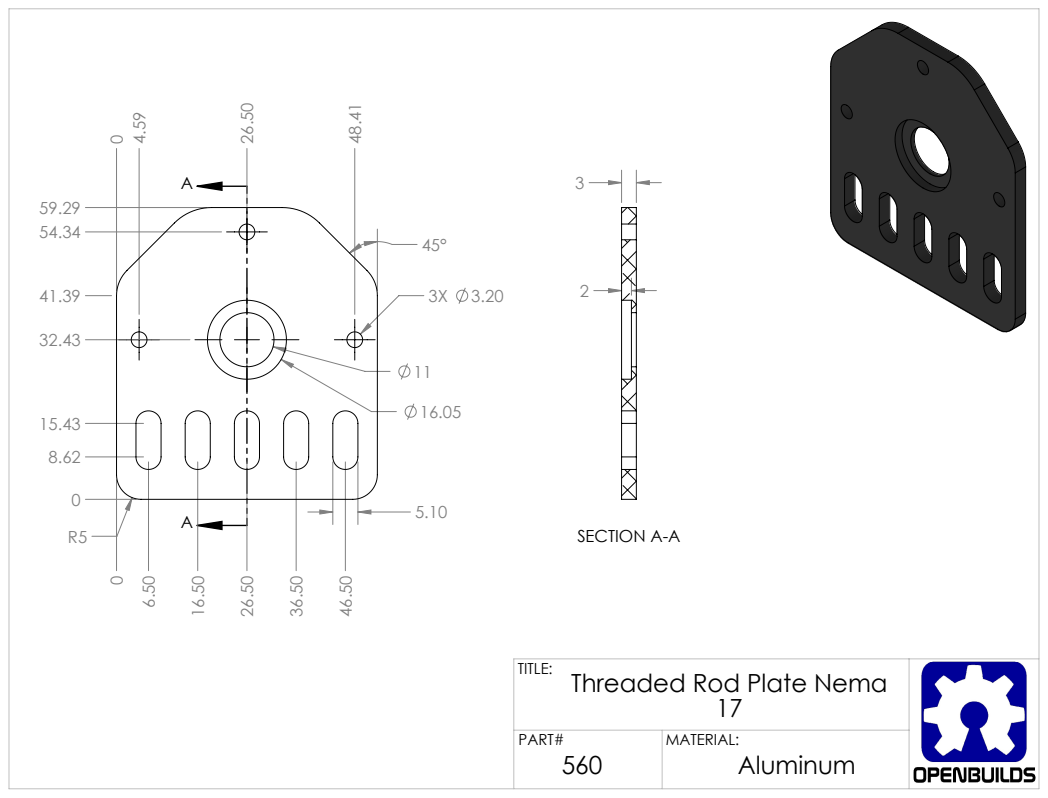
[picture p292: page 1]
SECTION A-A

TITLE: Threaded Rod Plate Nema 17

PART# 560 | MATERIAL: Aluminum
