tabdallah/capstone/2_Mechanical/1_Solidworks_Model/Open_Source_Files/OpenBuilds Library/PDF Drawings/Threaded Rod Plate Nema 23.PDF

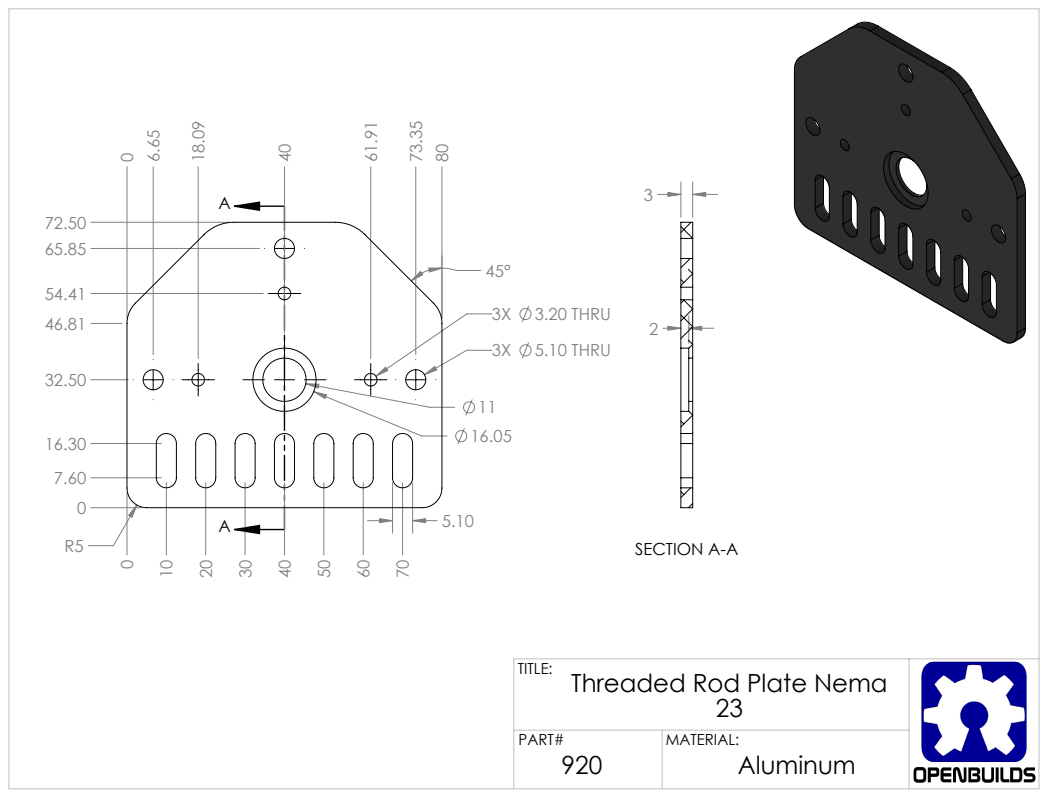
[picture p293: page 1]
3X 3.20 THRU; 3X 5.10 THRU; SECTION A-A

TITLE: Threaded Rod Plate Nema 23

PART# 920 | MATERIAL: Aluminum
