tabdallah/capstone/2_Mechanical/1_Solidworks_Model/Open_Source_Files/OpenBuilds Library/PDF Drawings/V Wheel.PDF

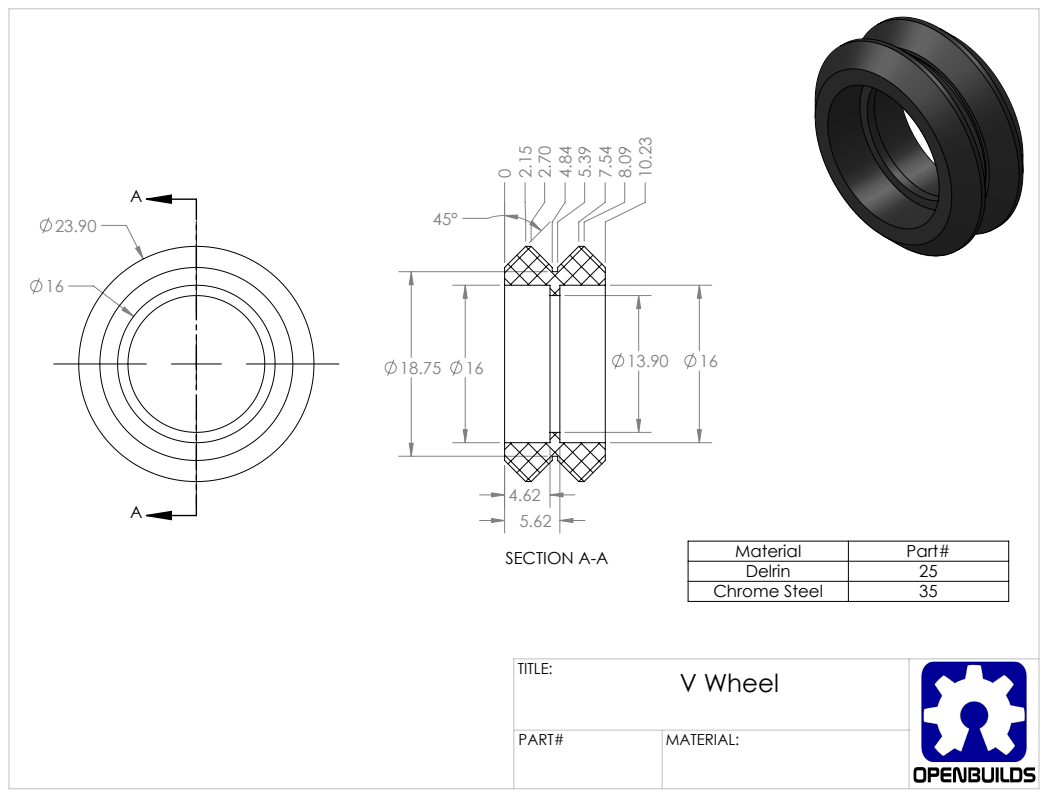
[picture p294: page 1]
SECTION A-A; Material; Part#

Delrin | 25
Chrome Steel | 35

TITLE: V Wheel

PART# | MATERIAL:
