tabdallah/capstone/2_Mechanical/1_Solidworks_Model/Open_Source_Files/OpenBuilds Library/PDF Drawings/V-Slot 20x20 Linear Rail.PDF

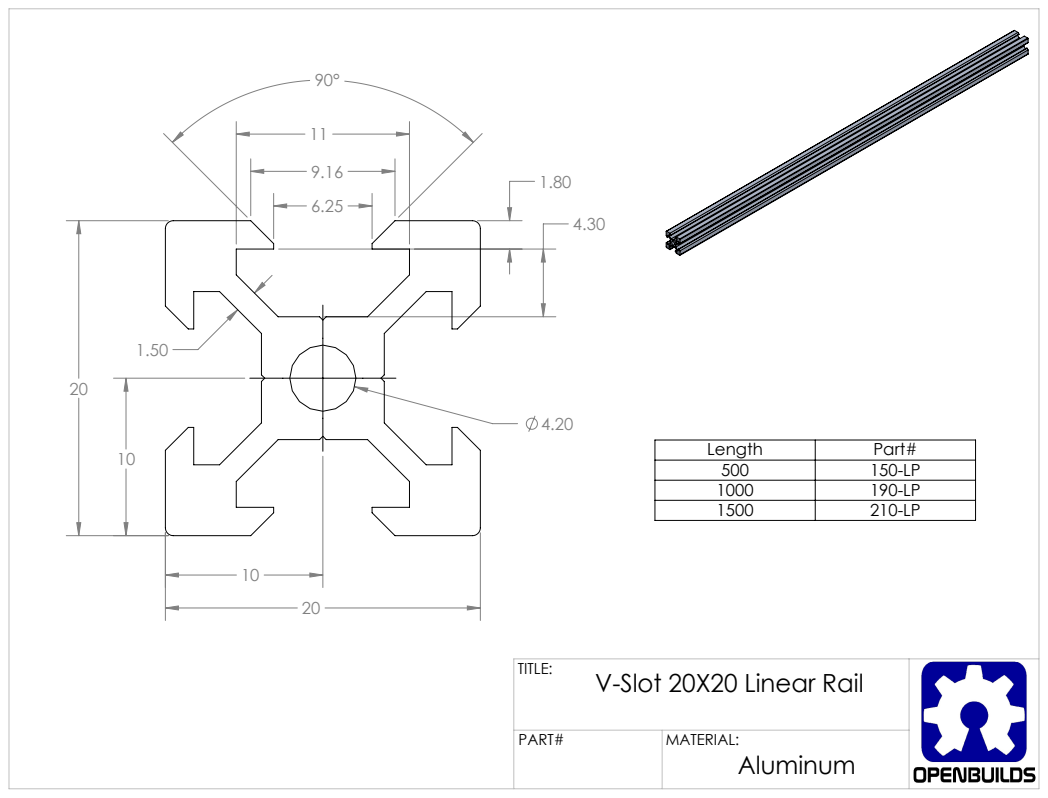
[picture p295: page 1]

Length | Part#
500 | 150-LP
1000 | 190-LP
1500 | 210-LP

TITLE: V-Slot 20X20 Linear Rail

PART# | MATERIAL: Aluminum
