tabdallah/capstone/2_Mechanical/1_Solidworks_Model/Open_Source_Files/OpenBuilds Library/PDF Drawings/V-Slot 20x40 Linear Rail.PDF

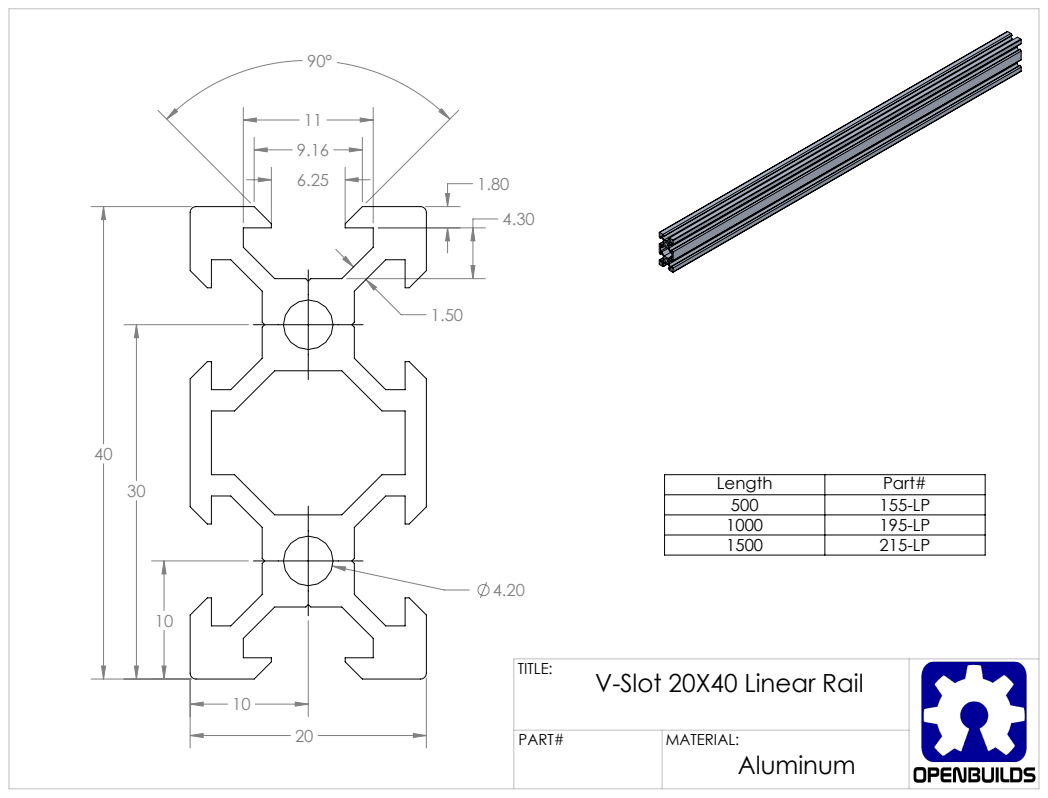
[picture p296: page 1]

Length | Part#
500 | 155-LP
1000 | 195-LP
1500 | 215-LP

TITLE: V-Slot 20X40 Linear Rail

PART# | MATERIAL: Aluminum
