tabdallah/capstone/2_Mechanical/1_Solidworks_Model/Open_Source_Files/OpenBuilds Library/PDF Drawings/V-Slot 20x60 Linear Rail.PDF

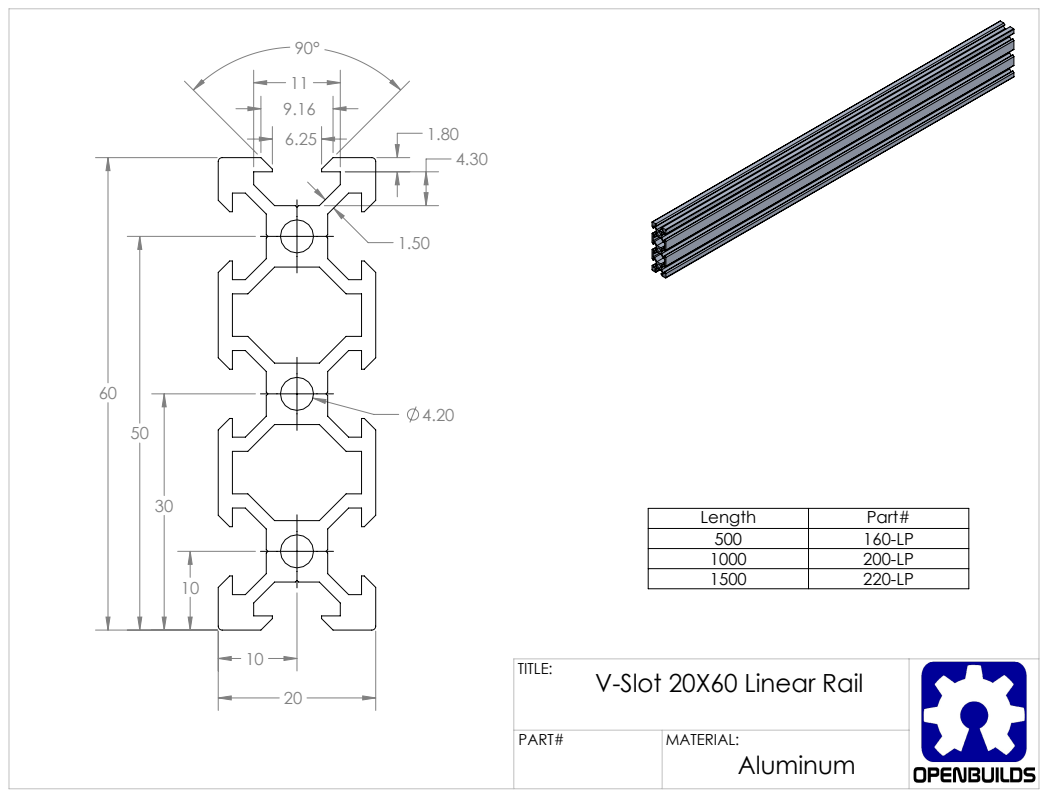
[picture p297: page 1]

Length | Part#
500 | 160-LP
1000 | 200-LP
1500 | 220-LP

TITLE: V-Slot 20X60 Linear Rail

PART# | MATERIAL: Aluminum
