tabdallah/capstone/2_Mechanical/1_Solidworks_Model/Open_Source_Files/OpenBuilds Library/PDF Drawings/V-Slot 20x80 Linear Rail.PDF

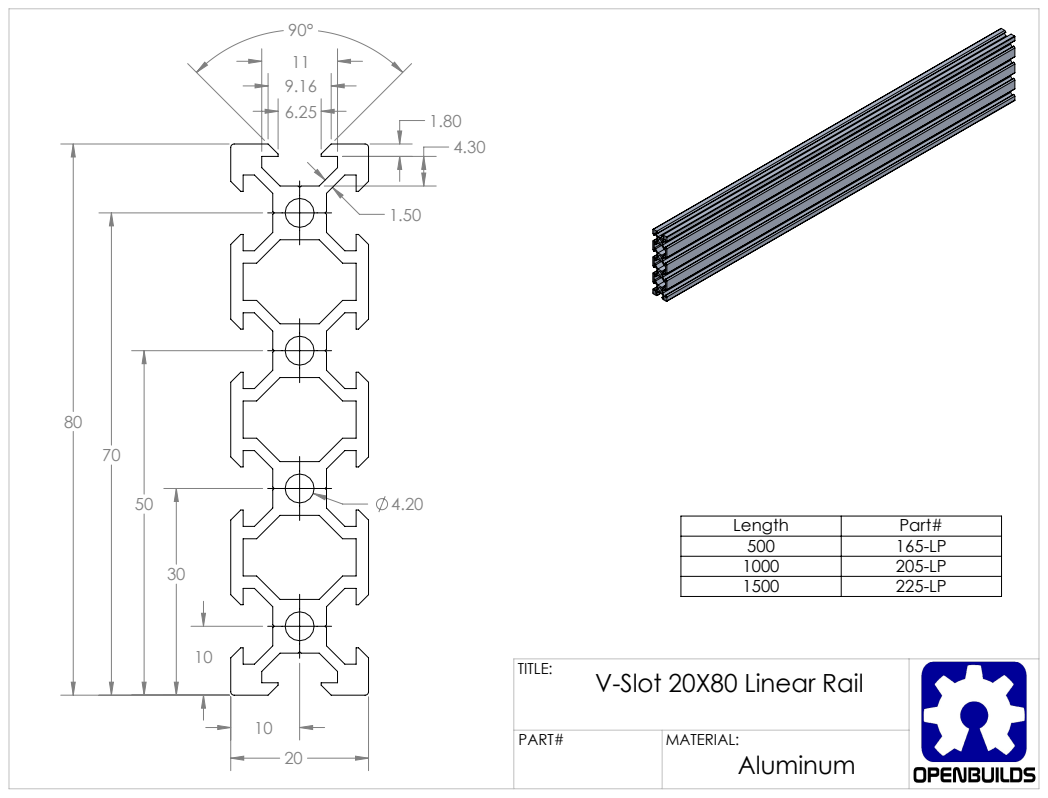
[picture p298: page 1]

Length | Part#
500 | 165-LP
1000 | 205-LP
1500 | 225-LP

TITLE: V-Slot 20X80 Linear Rail

PART# | MATERIAL: Aluminum
