tabdallah/capstone/2_Mechanical/1_Solidworks_Model/Open_Source_Files/OpenBuilds Library/PDF Drawings/V-Slot 40x40 Linear Rail.PDF

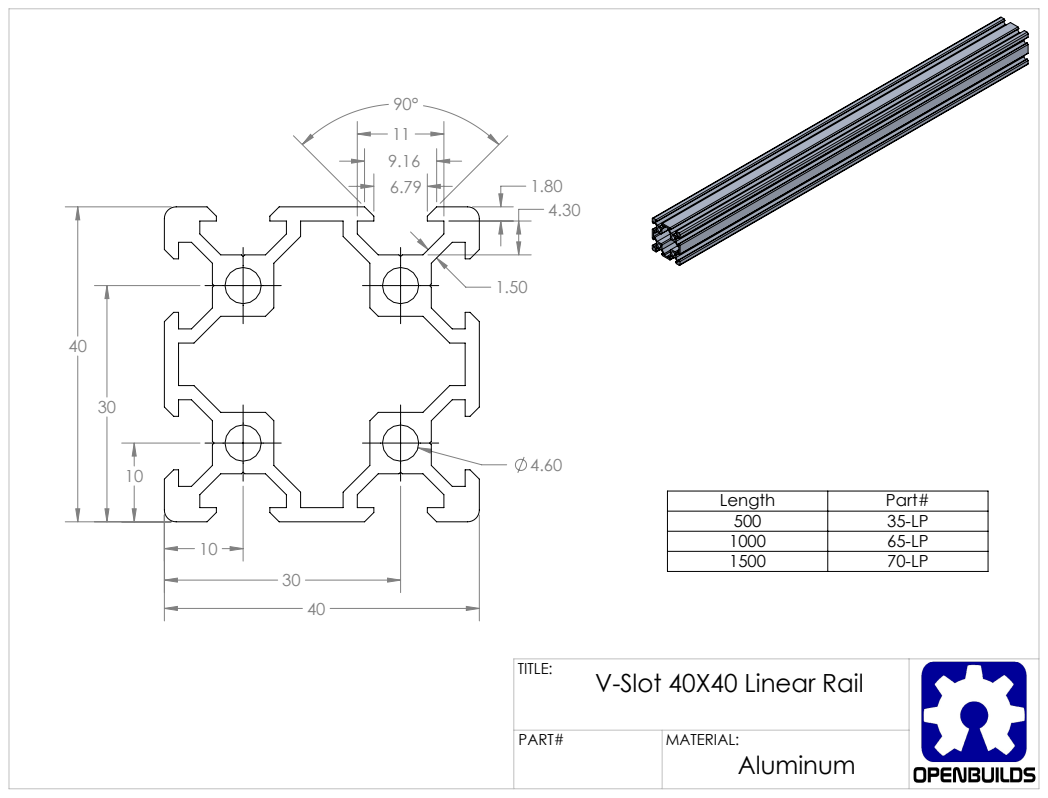
[picture p299: page 1]

Length | Part#
500 | 35-LP
1000 | 65-LP
1500 | 70-LP

TITLE: V-Slot 40X40 Linear Rail

PART# | MATERIAL: Aluminum
