tabdallah/capstone/2_Mechanical/1_Solidworks_Model/Open_Source_Files/OpenBuilds Library/PDF Drawings/V-Slot Gantry Plate 20-80mm.PDF

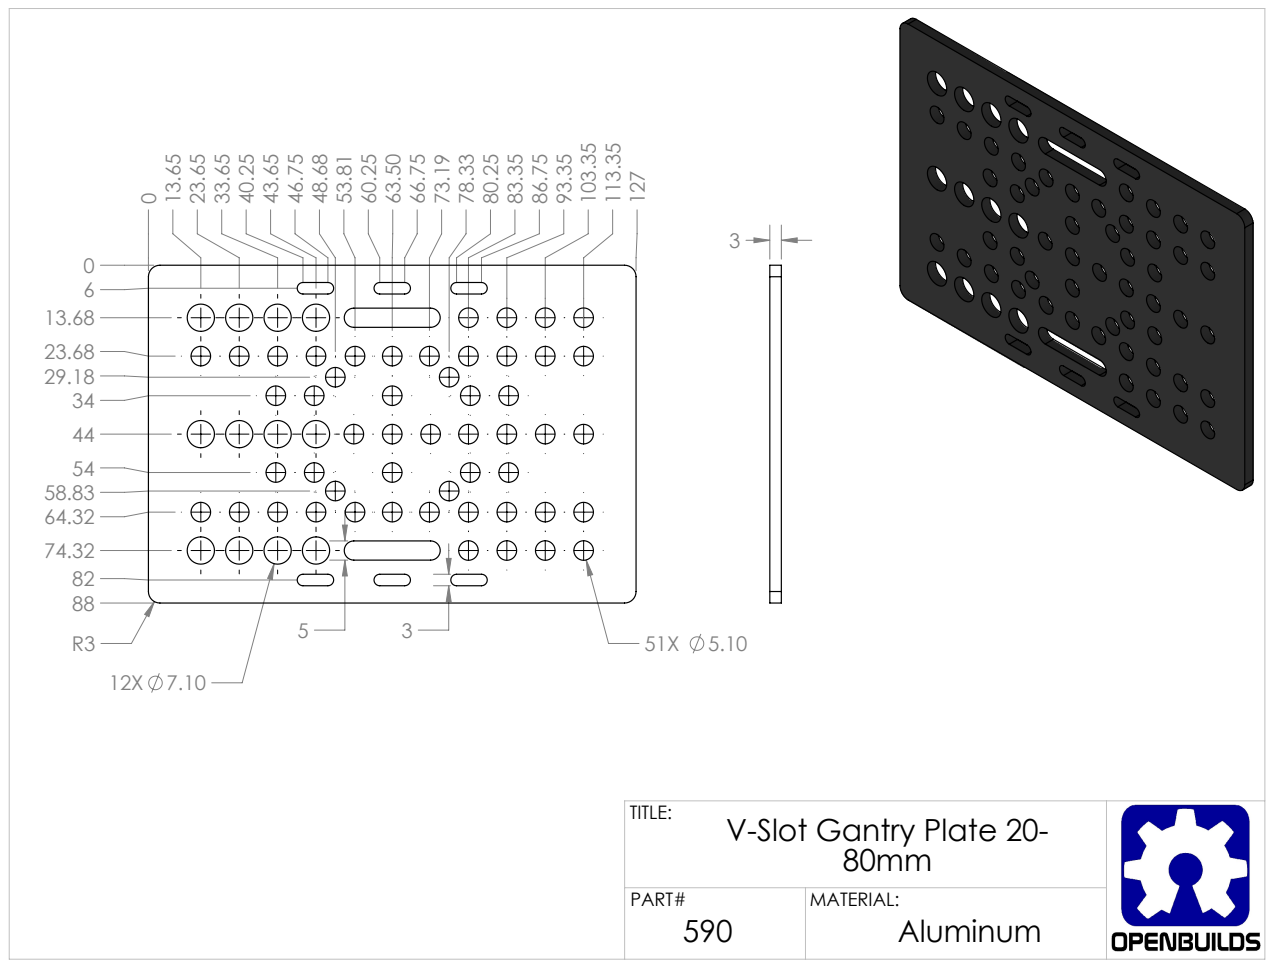
[picture p300: page 1]

TITLE: V-Slot Gantry Plate 20-80mm

PART# 590 | MATERIAL: Aluminum
