tabdallah/capstone/2_Mechanical/1_Solidworks_Model/Open_Source_Files/OpenBuilds Library/PDF Drawings/V-Slot Gantry Plate 20mm.PDF

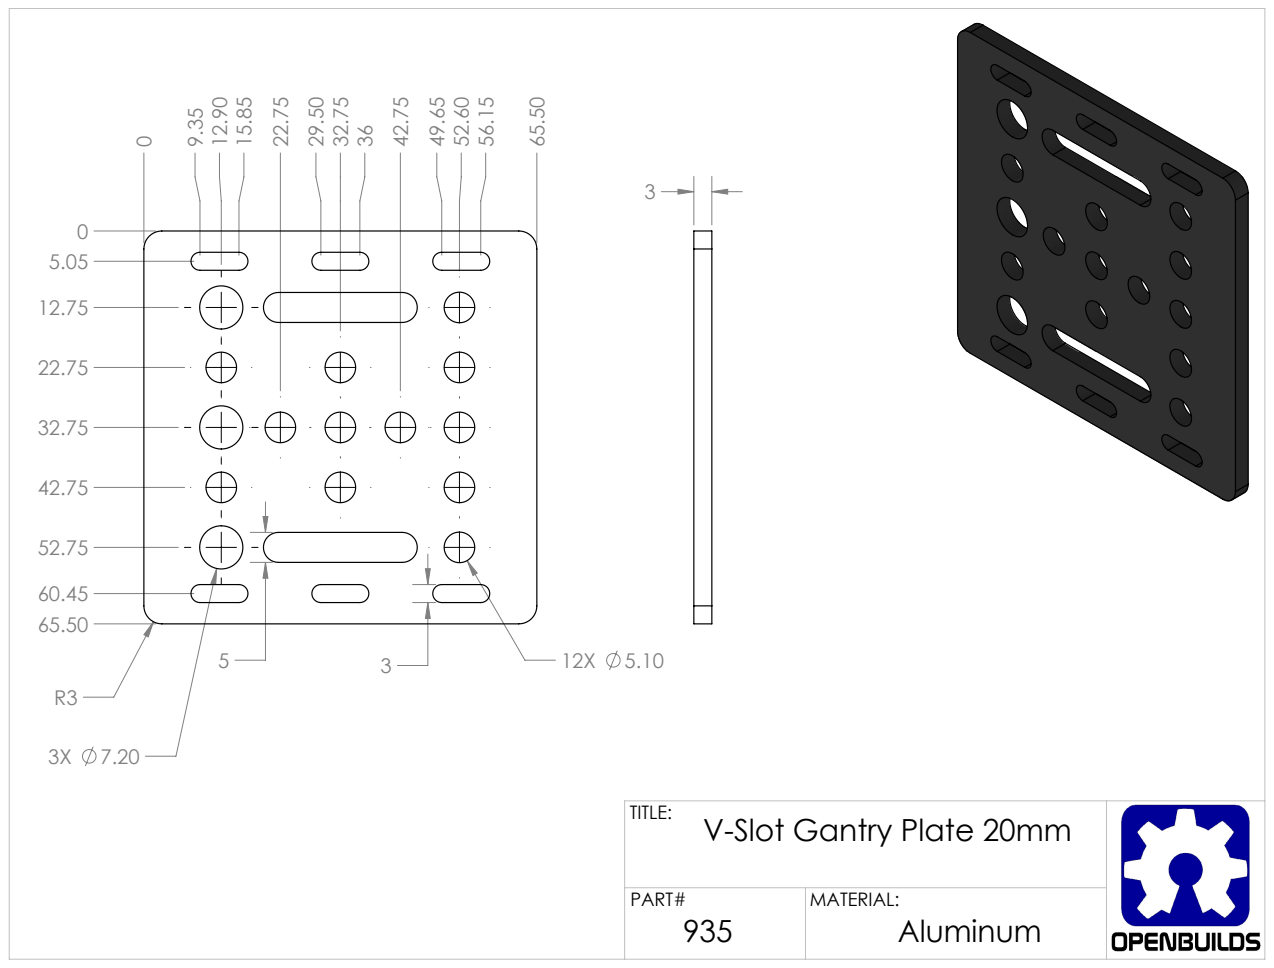
[picture p301: page 1]

TITLE: V-Slot Gantry Plate 20mm

PART# 935 | MATERIAL: Aluminum
