tabdallah/capstone/5_Master_Controller/2_Reference_Material/Elevator_CAN_Network.pdf

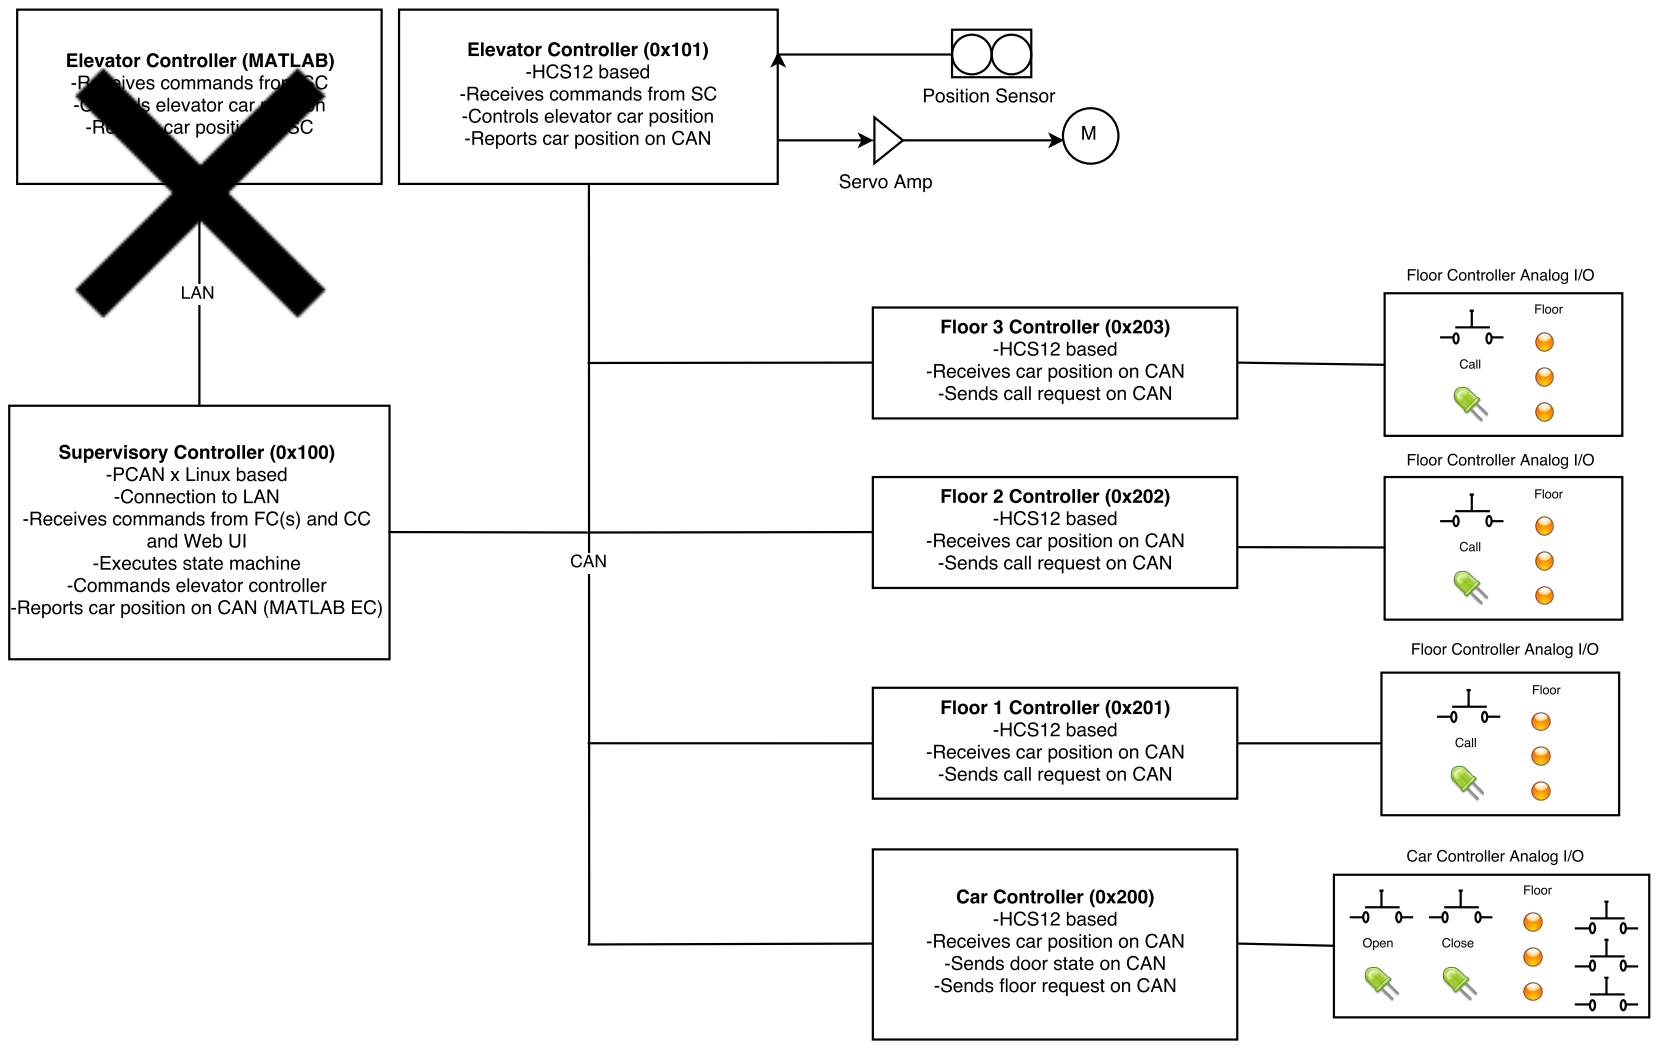
[picture p302: page 1]
