tabdallah/capstone/1_Planning/Project Schedule.pdf

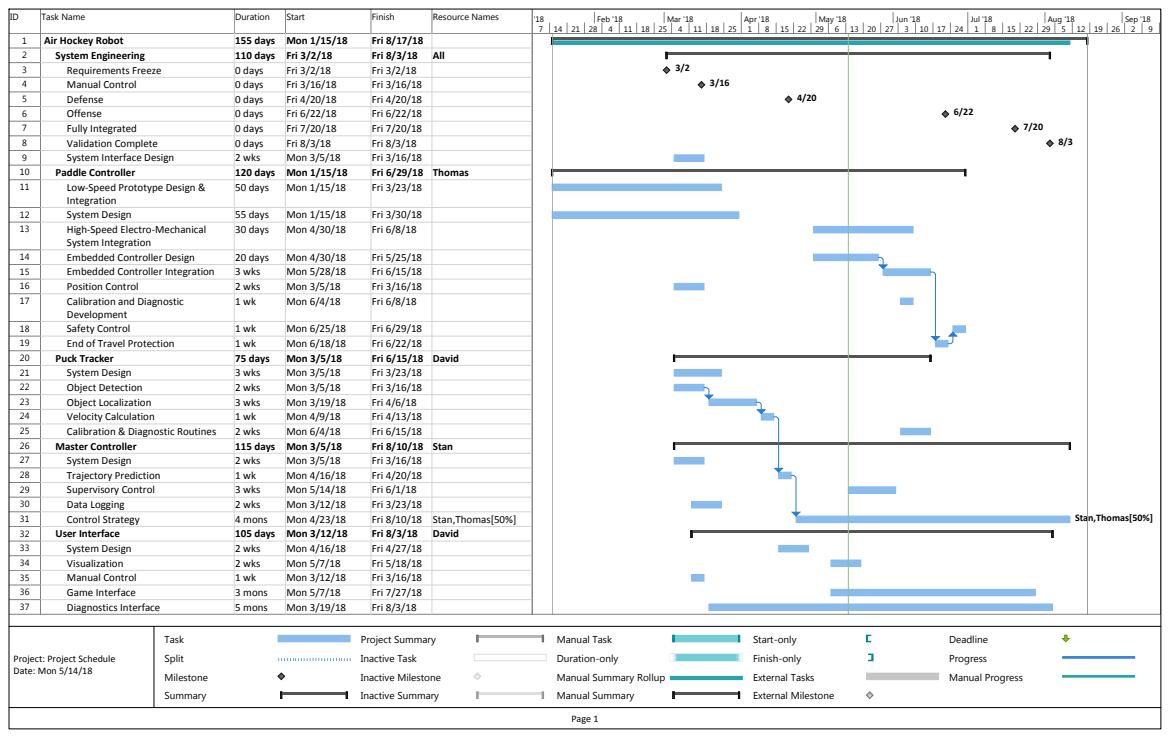
[picture p303: page 1]
Task Name; Duration; Start; Finish; Resource Names; Air Hockey Robot; 155 days; Mon 1/15/18; Fri 8/17/18; System Engineering; 110 days; Fri 3/2/18; Fri 8/3/18; All; Requirements Freeze; 0 days; Manual Control; Fri 3/16/18; Defense; Fri 4/20/18; Offense; Fri 6/22/18; Fully Integrated; Fri 7/20/18; Validation Complete; System Interface Design; 2 wks; Mon 3/5/18; Paddle Controller; 120 days; Fri 6/29/18; Thomas; Low‐Speed Prototype Design; Integration; 50 days; Fri 3/23/18; System Design; 55 days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

Manual Task
Duration-only
Manual Summary Rollup
Manual Summary

Project: Project Schedule
Date: Mon 5/14/18
