tabdallah/capstone/4_Paddle_Controller/CMLU-12C32_SCH_B.pdf

D

D

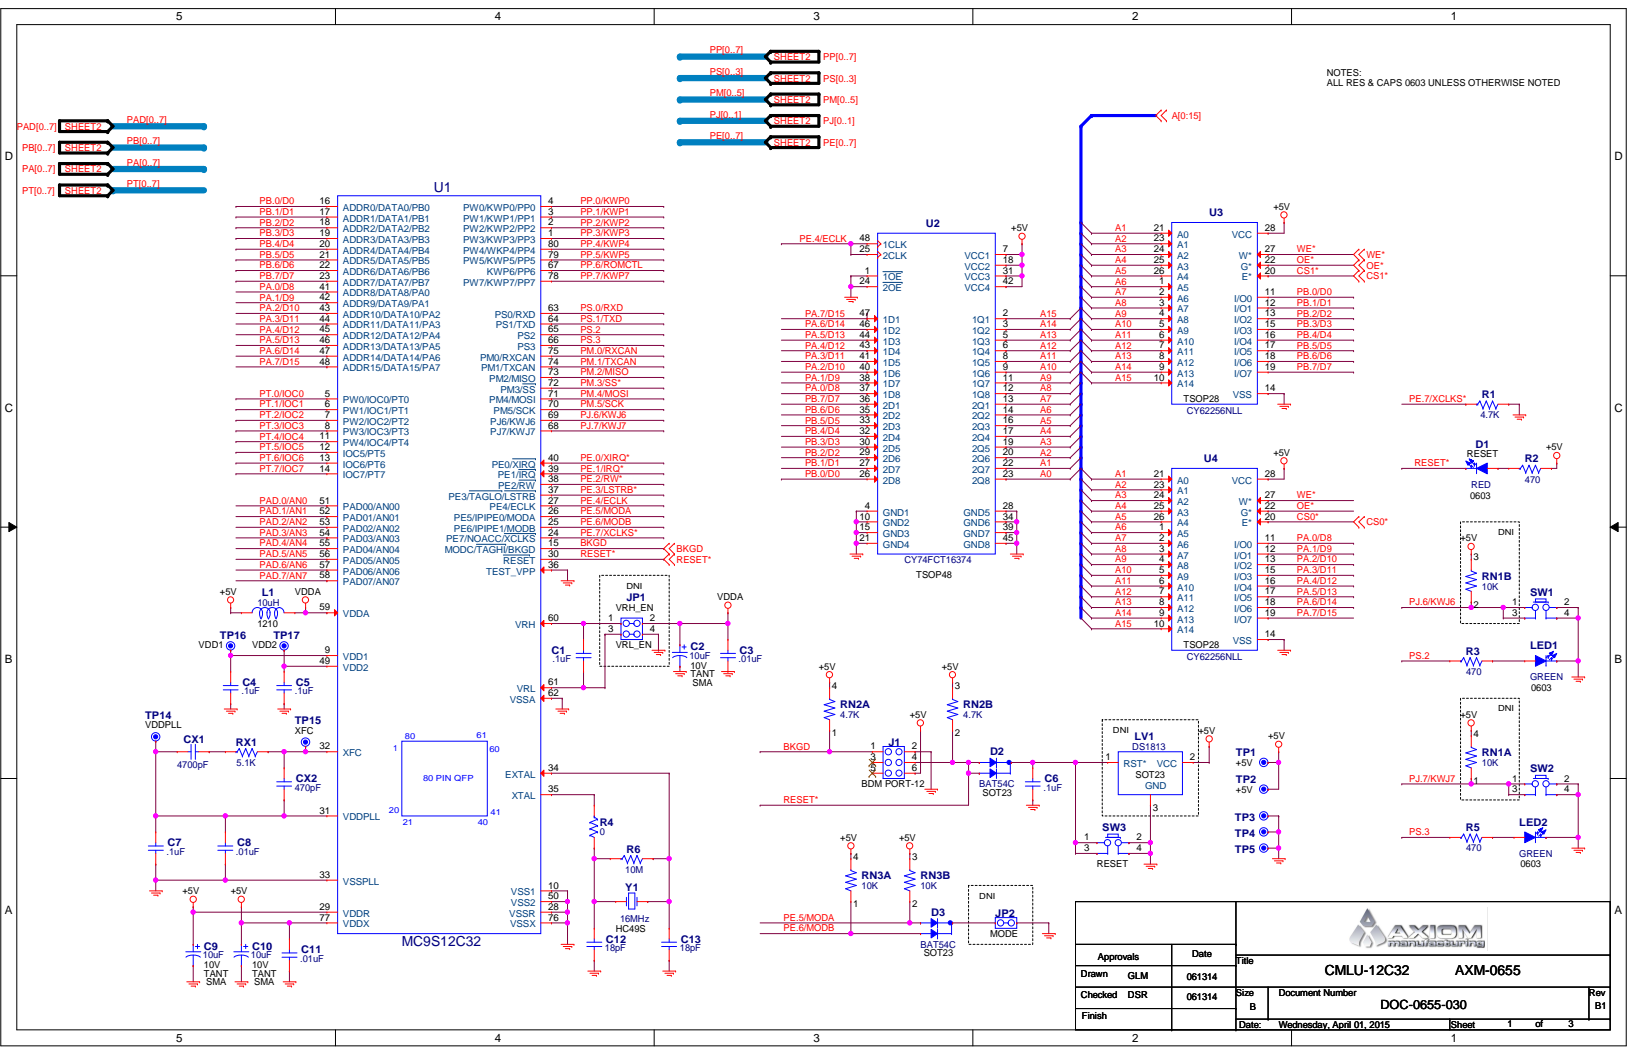
[picture p304: page 1]

NOTES:
ALL RES & CAPS 0603 UNLESS OTHERWISE NOTED

PJ7/KWJ7 68 PJ6/KWJ6 69 PM5/SCK 70 PM4/MOSI 71 PM3/SS 72 PM2/MISO 73 PM1/TXCAN 74 PM0/RXCAN 75

PE3/TAGLO/LSTRB 37 PE2/RW 38 PE1/IRQ 39 PE0/XIRQ 40

MODC/TAGHI/BKGD 15 PE7/NOACC/XCLKS 24 PE6/IPIPE1/MODB 25 PE5/IPIPE0/MODA 26 PE4/ECLK 27

D

D

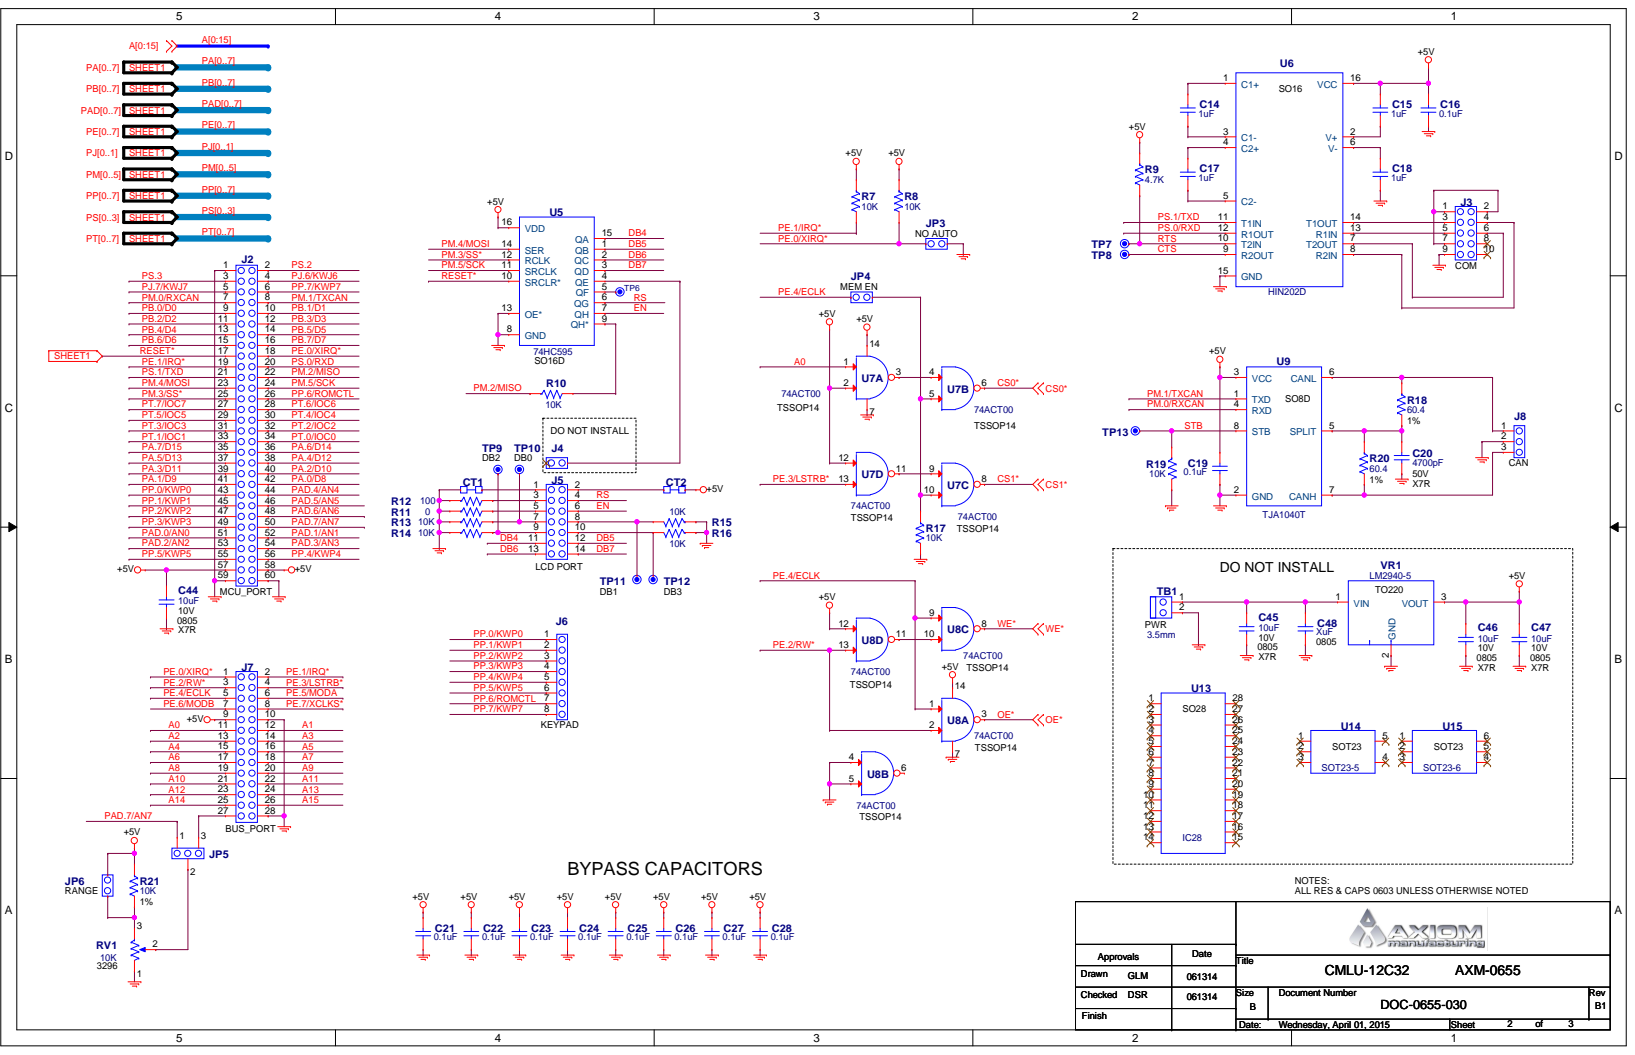
[picture p305: page 2]

NOTES:
ALL RES & CAPS 0603 UNLESS OTHERWISE NOTED

D

D

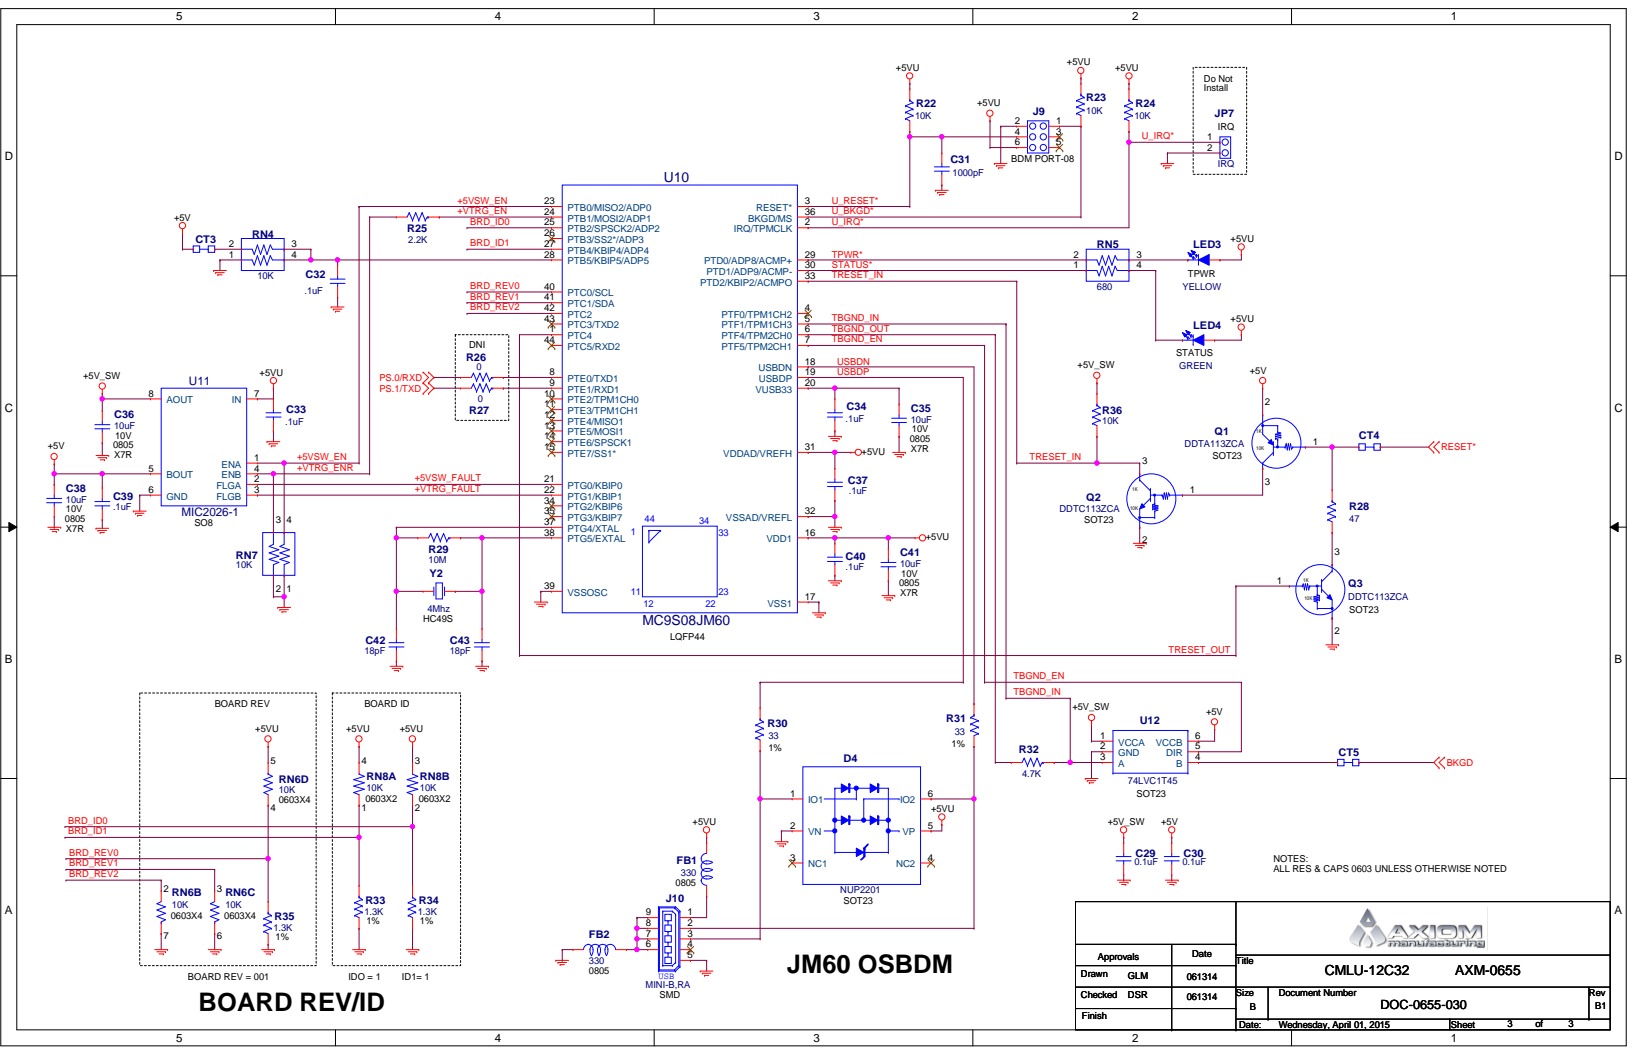
[picture p306: page 3]

TBGND_EN
TBGND_IN

NOTES:
ALL RES & CAPS 0603 UNLESS OTHERWISE NOTED
