tabdallah/capstone/(list of files, drawings)

Other design files:
4_Paddle_Controller/1_Electrical/goalLight_PCB/goalLight_PCB.PrjPCB
4_Paddle_Controller/1_Electrical/goalLight_PCB/layout/goalLight.PcbDoc
4_Paddle_Controller/1_Electrical/goalLight_PCB/parts/CD4017BE (Decade Counter)/AltiumDesigner.PcbLib
4_Paddle_Controller/1_Electrical/goalLight_PCB/parts/CD4017BE (Decade Counter)/AltiumDesigner.SchLib
4_Paddle_Controller/1_Electrical/goalLight_PCB/schematics/goalLight.SchDoc
4_Paddle_Controller/1_Electrical/uC_Interface_PCB/layout/uC_interface_pcb.PcbDoc
4_Paddle_Controller/1_Electrical/uC_Interface_PCB/schematics/1_Top_Sheet.SchDoc
4_Paddle_Controller/1_Electrical/uC_Interface_PCB/schematics/2_Encoder_Interface.SchDoc
4_Paddle_Controller/1_Electrical/uC_Interface_PCB/schematics/3a_Motor_Interface.SchDoc
4_Paddle_Controller/1_Electrical/uC_Interface_PCB/schematics/3b_Motor_Interface.SchDoc
4_Paddle_Controller/1_Electrical/uC_Interface_PCB/schematics/4_Light_Screen.SchDoc
4_Paddle_Controller/1_Electrical/uC_Interface_PCB/schematics/5_Limit_Switches.SchDoc
4_Paddle_Controller/1_Electrical/uC_Interface_PCB/uC_Interface_PCB.PrjPcb
7_Not_Capstone/Power_Electronics/PE_A2_Q4.ms14
