tabdallah/capstone/4_Paddle_Controller/2_Software/1_Source/ir.c

//;******************************************************************************
//; ir.c - Code to interface with the infrared sensors, also handles goal light logic
//; Name: Thomas Abdallah
//; Date: 2018-07-25
//;******************************************************************************
#include <stdlib.h>
#include <hidef.h>      /* common defines and macros */
#include "derivative.h"      /* derivative-specific definitions */
#include "ir.h"

// Define IR sensors
static ir_sensor_t ir_sensor_goal_human, ir_sensor_goal_robot, ir_sensor_centre;

//;**************************************************************
//;*                 ir_configure
//;**************************************************************
void ir_configure(void)
{
	ir_sensor_goal_human.output_filtered = ir_sensor_clear;
	ir_sensor_goal_human.filter_threshold = 5;
	ir_sensor_goal_robot.output_filtered = ir_sensor_clear;
	ir_sensor_goal_robot.filter_threshold = 5;
	ir_sensor_centre.output_filtered = ir_sensor_clear;
	ir_sensor_centre.filter_threshold = 10;

	CLEAR_BITS(IR_DDR, IR_SENSOR_1_PIN);
	CLEAR_BITS(IR_DDR, IR_SENSOR_2_PIN);
	CLEAR_BITS(IR_DDR, IR_SENSOR_3_PIN);
	CLEAR_BITS(IR_DDR, IR_SENSOR_4_PIN);
	CLEAR_BITS(IR_DDR, IR_SENSOR_5_PIN);
	CLEAR_BITS(IR_DDR, IR_SENSOR_6_PIN);

	ir_sensor_centre.port_pin = IR_SENSOR_1_PIN;
	ir_sensor_centre.port_pin_shift = IR_SENSOR_1_SHIFT;
	ir_sensor_goal_human.port_pin = IR_SENSOR_2_PIN;
	ir_sensor_goal_human.port_pin_shift = IR_SENSOR_2_SHIFT;
	ir_sensor_goal_robot.port_pin = IR_SENSOR_6_PIN;
	ir_sensor_goal_robot.port_pin_shift = IR_SENSOR_6_SHIFT;

	SET_BITS(GOAL_LIGHT_DDR, GOAL_LIGHT_HUMAN_PIN);
	SET_BITS(GOAL_LIGHT_PORT, GOAL_LIGHT_HUMAN_PIN);
	SET_BITS(GOAL_LIGHT_DDR, GOAL_LIGHT_ROBOT_PIN);
	SET_BITS(GOAL_LIGHT_PORT, GOAL_LIGHT_ROBOT_PIN);
}

//;**************************************************************
//;*                 ir_read
//;**************************************************************
static void ir_sensor_read(ir_sensor_t *ir_sensor)
{
	// Record raw sensor data
	ir_sensor->output_raw = (((IR_PORT & (ir_sensor->port_pin)) >> (ir_sensor->port_pin_shift)) & 0x0001);
	ir_sensor->samples[ir_sensor->sample_index] = ir_sensor->output_raw;	
	ir_sensor->sample_index ++;
	if (ir_sensor->sample_index >= IR_FILTER_KERNEL_SIZE) {
		ir_sensor->sample_index = 0;
	}
}

//;**************************************************************
//;*                 ir_sensor_filter
//;**************************************************************
static void ir_sensor_filter(ir_sensor_t *ir_sensor)
{
	unsigned char sample_count = 0;
	unsigned char i;

	// Only activate output if # of consecutive samples are all blocked
	for (i=0; i<IR_FILTER_KERNEL_SIZE; i++) {
		if (ir_sensor->samples[i] == ir_sensor_blocked) {
			sample_count ++;
		}
	}
	if (sample_count >= ir_sensor->filter_threshold) {
		ir_sensor->goal_light_timer = GOAL_LIGHT_TIMER;
		ir_sensor->output_filtered = ir_sensor_blocked;
		ir_sensor->latch_count = 250;
	} else {
		if (ir_sensor->latch_count > 0) {
			ir_sensor->output_filtered = ir_sensor_blocked;
			ir_sensor->latch_count --;
		} else {
			ir_sensor->output_filtered = ir_sensor_clear;
		}
		if (ir_sensor->goal_light_timer > 0) {
			ir_sensor->goal_light_timer --;
		}
	}	
}

//;**************************************************************
//;*                 ir_10kHz_task
//;**************************************************************
void ir_10kHz_task(void)
{
	ir_sensor_read(&ir_sensor_centre);
	ir_sensor_read(&ir_sensor_goal_human);
	ir_sensor_read(&ir_sensor_goal_robot);
}

//;**************************************************************
//;*                 ir_1kHz_task
//;**************************************************************
void ir_1kHz_task(void)
{
	// Avoid false-positives out of reset by doing nothing
	static unsigned int startup_counter = 1000;
	if (startup_counter > 0) {
		startup_counter --;
		return;
	}

	ir_sensor_filter(&ir_sensor_centre);
	ir_sensor_filter(&ir_sensor_goal_human);
	ir_sensor_filter(&ir_sensor_goal_robot);
	
	// Logic to turn on goal lights
	if (ir_sensor_goal_human.goal_light_timer > 0) {
		CLEAR_BITS(GOAL_LIGHT_PORT, GOAL_LIGHT_HUMAN_PIN);
	} else {
		SET_BITS(GOAL_LIGHT_PORT, GOAL_LIGHT_HUMAN_PIN);
	}

	// Robot side goal light doesn't go through schmidt trigger
	if (ir_sensor_goal_robot.goal_light_timer > 0) {
		SET_BITS(GOAL_LIGHT_PORT, GOAL_LIGHT_ROBOT_PIN);
	} else {
		CLEAR_BITS(GOAL_LIGHT_PORT, GOAL_LIGHT_ROBOT_PIN);
	}
}

//;**************************************************************
//;*                 ir_get_output
//;**************************************************************
ir_sensor_e ir_get_output(ir_sensor_name_e sensor)
{
	ir_sensor_e output;

	switch (sensor)
	{
		case ir_light_screen_centre_ice:
			output = ir_sensor_centre.output_filtered;
			break;
		case ir_goal_human:
			output = ir_sensor_goal_human.output_filtered;
			break;
		case ir_goal_robot:
			output = ir_sensor_goal_robot.output_filtered;
			break;
		default:
			output = ir_sensor_clear;
	}

	return output;
}
