tabdallah/capstone/4_Paddle_Controller/2_Software/1_Source/timer.h

//;******************************************************************************
//; timer.h
//; Name: Thomas Abdallah
//; Date: 2016-03-31
//;******************************************************************************

// Action values for OC function
#define OC_OFF		0x00
#define OC_TOGGLE	0x01
#define OC_GO_LO	0x02
#define OC_GO_HI	0x03

// Timer configuration parameters
#define TSCR1_INIT 0b10110000	// Turn on timer module and enable fast-clear and freeze in debug
#define TSCR2_INIT 0b10000010	// Set pre-scaler to 4 for finest resolution @50Hz PWM frequency, overflow interrupt enabled

// Define TCTL_1_2 as a single 16 bit register made up of TCTL1 and TCTL2 together
#define TCTL_1_2 (*(volatile word * const) &TCTL1)

#define TCNT_S 2000000			// Number of TCNT ticks for 1s with prescaler of 4
#define TCNT_mS 2000			// Number of TCNT ticks for 1mS with prescaler of 4
#define TCNT_uS 2 				// Number of TCNT ticks for 1uS with prescaler of 4
#define TNCT_OVF_FACTOR 65536l	// 2^16

// Function prototypes
void timer_configure(void);					// Configure the timer module at startup
void timer_delay_ms(unsigned char time);	// Delay by time ms using OC polling
void timer_delay_us(unsigned char time);	// Delay by time us using OC polling
void timer_delay_100us(unsigned char time);	// Delay by time 100us using OC polling
unsigned char timer_get_overflow(void);		// Returns current value of the TCNT overflow counter
