tabdallah/capstone/4_Paddle_Controller/1_Electrical/795_Motor_Bringup/Sources/derivative.h

/*
 * Note: This file is recreated by the project wizard whenever the MCU is
 *       changed and should not be edited by hand
 */

/* Include the derivative-specific header file */
#include <mc9s12c32.h>

#pragma LINK_INFO DERIVATIVE "mc9s12c32"
