tabdallah/capstone/(commit log)

2018-02-01 Adding risk analysis and motor lit review detail
2018-02-02 Adding first draft of mechanical design
    [120 Angle Tee Nut.SLDPRT, 135 Angle Tee Nut.SLDPRT, 2 Way Tee Nut.SLDPRT, 3 Way Tee Nut.SLDPRT, 4 Way Tee Nut.SLDPRT, 60 Angle Tee Nut.SLDPRT, 8mm Acme Anti Backlash Nut Block.SLDPRT, 8mm Acme Nut Block.SLDPRT]
2018-02-02 Adding puck tracker fps calcs
    [fps_calcs.xlsx]
2018-02-05 Updating mechanical model to use FIT0439 350rpm motor
    [91274A134_COATED ALLOY STEEL SOCKET HEAD CAP SCREW.SLDPRT, 92095A218_18-8 SS BUTTON-HEAD SOCKET CAP SCREW.SLDPRT, 92095A223_18-8 SS BUTTON-HEAD SOCKET CAP SCREW.SLDPRT, 94300A320_ZNC-PLTD STL AND IRON WING NUTS.SLDPRT, AHR_x_carriage.SLDPRT, AHR_x_carriage_belt.SLDPRT, AHR_x_carriage_pusher.SLDPRT, Ball Bearing 5 x 16 x 5.SLDPRT]
2018-02-08 Updated project proposal
    [91274A134_COATED ALLOY STEEL SOCKET HEAD CAP SCREW.SLDPRT, 92095A218_18-8 SS BUTTON-HEAD SOCKET CAP SCREW.SLDPRT, 92095A223_18-8 SS BUTTON-HEAD SOCKET CAP SCREW.SLDPRT, 94300A320_ZNC-PLTD STL AND IRON WING NUTS.SLDPRT, AHR_x_carriage.SLDPRT, AHR_x_carriage.stl, AHR_x_carriage_belt.SLDPRT, AHR_x_carriage_belt.stl]
2018-03-09 Added Design Matrixes for Communication and Programming Language selections
    [Decision_Matrices_Programming_and_Com.xlsx]
2018-03-09 Status report and decision matrix for puck tracker sensor
    [Decision_Matrices_Puck_Tracker_Sensor.xlsx]
2018-03-15 Paddle controller design documents and basic position control of X-Axis
    [91274A134_COATED ALLOY STEEL SOCKET HEAD CAP SCREW.SLDPRT, 92095A218_18-8 SS BUTTON-HEAD SOCKET CAP SCREW.SLDPRT, 92095A223_18-8 SS BUTTON-HEAD SOCKET CAP SCREW.SLDPRT, 94300A320_ZNC-PLTD STL AND IRON WING NUTS.SLDPRT, AHR_x_carriage.SLDPRT, AHR_x_carriage_belt.SLDPRT, AHR_x_carriage_pusher.SLDPRT, Aluminum Spacer .125in.SLDPRT]
2018-03-15 Position control updated to account for change in direction
    [Paddle_Controller_SW_Calcs.xlsx, Paddle_Controller_System_Sizing.xlsx, Speed_Calcs.xlsx]
2018-03-16 Better encoder direction tracking
    [Paddle_Controller_System_Sizing.xlsx]
2018-03-20 Refactoring code to make it easier to integrate X and Y axis control
    [Paddle_Controller_System_Sizing.xlsx]
2018-03-21 Functioning x and y axis position control
    [Paddle_Controller_System_Sizing.xlsx]
2018-03-22 Improved robustness for position control
    [Paddle_Controller_System_Sizing.xlsx]
2018-03-27 Adding limit switch design and more PC design documents
    [Idler Pulley Plate.SLDPRT, Open Rail 1000mm.SLDPRT, Paddle_Controller_Hardware_Options_Evaluation.xlsx, Paddle_Controller_IO_List.xlsx, Paddle_Controller_System_Sizing.xlsx, Robot_Assesmbly.SLDASM, V-Slot 20x20x1000 Linear Rail.SLDPRT, limit_switch.SLDPRT]
2018-03-27 Adding Axman schematic. X-Axis limit switch logic implemented.
2018-03-29 Adding CAN message layout and signal descriptions
    [System_Interface_Design.xlsx]
2018-03-29 Updated CAN message layouts
    [System_Interface_Design.xlsx]
2018-03-29 Adding separate messages for X and Y axis
    [System_Interface_Design.xlsx]
2018-03-29 Updated pos signals to be 8 bits
    [System_Interface_Design.xlsx]
2018-03-29 Updated pos signals to be 16 bits
    [System_Interface_Design.xlsx]
2018-03-29 Master Controller prototyping
    Basic text menu, CAN not tested yet
    [Shared_CAN_Protocol_Proposal.xlsx]
2018-03-29 renamed prototype file
2018-04-02 CAN status messages now work with 1mm accuracy on position. Overload detection for x-axis dc motor. ToDo - implement on y-axis
2018-04-03 Added Position Filter, improved logger and more
    Also removed command line argument, now UI position control code can be excluded using __debug__ variable: just run script with -O (python -O mc_controller.py)
2018-04-04 Y-Axis limit switches implemented. Logic for CAN Tx timing moved to the send functions. Handling CAN errors.
    [Paddle_Controller_System_Sizing.xlsx]
2018-04-07 Adding more receipts and excel sheet to track. Up to date PC code.
    [Receipts.xlsx]
2018-04-07 Changing to soft timing for 1kHz loop to ensure encoder IC gets top priority
    [Paddle_Controller_System_Sizing.xlsx]
2018-04-11 Adding econ project stuff
    [GT2 Timing Pulley 20 Tooth.SLDPRT, Project.xlsx, Receipts.xlsx, y-axis_motor_mount_left.SLDPRT]
2018-04-13 X-axis position logic now actually makes sense
    [Project.xlsx]
2018-04-17 Adding presentation and updating report and spreadsheet
    [Project.xlsx]
2018-04-17 Updated EAC part in report, excel, slides
    [Project.xlsx]
2018-04-19 Changing to 60 tooth pulley for x-axis
2018-04-19 Updating model to make pretty graphs for the presentation
    [Paddle_Controller_System_Sizing.xlsx]
2018-04-28 Adding critial regions as 1kHz task is no longer inside an ISR
    [x_axis.c, y_axis.c]
2018-05-10 Integrating defense code into the master controller, organized folders
    [Project.xlsx, Shared_CAN_Protocol_Proposal.xlsx]
2018-05-10 deleting duplicate things
    [Project.xlsx]
2018-05-23 flowcharts and weekly report I forgot to push
2018-05-23 fixed mistake in flowchart
2018-05-26 Added photos of Flowcharts and Communication with MC
2018-05-27 Started designing state machine flowchart for Master Controller
2018-06-01 Adding V2.0 mechanical design
    [Assembly_IR_LED.SLDASM, Assembly_IR_Sensor.SLDASM, Assembly_Limit_Switch.SLDASM, Assembly_Limit_Switch_Alt.SLDASM, Assembly_Motor_795.SLDASM, Assembly_Table.SLDASM, Assembly_X-Axis_Carriage.SLDASM, Assembly_X-Axis_Paddle.SLDASM]
2018-06-01 Adding paddle contgroller electrical design for high speed system
    [1_Top_Sheet.SchDoc, 2_Encoder_Interface.SchDoc, 3a_Motor_Interface.SchDoc, 3b_Motor_Interface.SchDoc, 4_Light_Screen.SchDoc, 5_Limit_Switches.SchDoc, uC_Interface_PCB.PrjPcb]
2018-06-05 Adding layout
    [1_Top_Sheet.SchDoc, 2_Encoder_Interface.SchDoc, 3a_Motor_Interface.SchDoc, 3b_Motor_Interface.SchDoc, 4_Light_Screen.SchDoc, 5_Limit_Switches.SchDoc, uC_Interface_PCB.PrjPcb, uC_interface_pcb.PcbDoc]
2018-06-08 Fixed major syntax issues
    [master_controller.py]
2018-06-11 status report and part of power electronics assignment
    [PE_A2_Q4.ms14]
2018-06-12 WIP, now app Quits properly, need to fix the logger
    [master_controller.py]
2018-06-12 Updated schematics and layout
    [1_Top_Sheet.SchDoc, 2_Encoder_Interface.SchDoc, 3a_Motor_Interface.SchDoc, 3b_Motor_Interface.SchDoc, 4_Light_Screen.SchDoc, 5_Limit_Switches.SchDoc, BOM_Digikey_uC_Interface_PCB.xlsx, Receipts.xlsx]
2018-06-15 first attempt at circuit
    [goalLight.PcbDoc, goalLight.SchDoc, goalLight_PCB.PrjPCB]
2018-06-19 Adding receipts and week 25 status report
    [tsal6200_mount.STL, tssp40_mount.STL]
2018-06-23 Finished goal light PCB
    [goalLight.PcbDoc, goalLight.SchDoc, goalLight_PCB.PrjPCB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]
2018-06-25 Edited CAN msgs for States and Goal scoring
    [System_Interface_Design.xlsx]
2018-06-25 Adding test plan
    [1_Top_Sheet.SchDoc, uC_Interface_PCB.PrjPcb]
2018-06-25 Updated CAN Protocol signals
    [System_Interface_Design.xlsx]
2018-06-25 Added PC State Machine, Updated CAN protocol
    [System_Interface_Design.xlsx]
2018-06-26 WIP Supervisory Control
    [System_Interface_Design.xlsx]
2018-06-27 Fixed visible errors, App starts, no obvious bugs
    [master_controller.py]
2018-06-27 Added latest CAN Protocol
    [System_Interface_Design.xlsx]
2018-06-29 All motors spinning
    [1_Top_Sheet.SchDoc, 2_Encoder_Interface.SchDoc, Assembly_Table.SLDASM, Paddle_Controller_System_Sizing.xlsx, X-Axis_Rod.SLDPRT, X-Axis_Rod_Extension.SLDDRW, X-Axis_Rod_Extension.SLDPRT]
2018-07-05 Added material links to Motors Paper
2018-07-11 Working y-axis code. Needs to be cleaned up a lot
2018-07-12 First implementation with state machine and error handling
    [can.c, can.h, dcm.c, dcm.h, state_machine.c, state_machine.h, x_axis.c, y_axis.c]
2018-07-13 Changed all motor control to operate in units of mm rather than encoder ticks. Updated V2 mechanical design for improved robustness and adding the connecting rod on the y-axis.
    [X-Axis_Paddle_Top.SLDPRT, X-Axis_Paddle_Top.STL, Y-Axis_Connecting_Rod_Mount.SLDPRT, Y-Axis_Connecting_Rod_Mount.STL, Y-Axis_Rod_Mount.SLDPRT, Y-Axis_Rod_Mount.STL, limit_switch_mount_top.SLDPRT, limit_switch_mount_top.STL]
2018-07-16 code used to demo at debrief
    [LB8UU_3D_Printed.SLDPRT, LB8UU_3D_Printed.STL, LBB8UU.SLDPRT]
2018-07-16 endstop control implemented, needs tuning at speeds higher than 25 percent
2018-07-16 more endstop control
2018-07-19 Added motor_control_logic.xml
    [motor_control_logic.xml]
2018-07-19 Added motor_control_logic.png
2018-07-19 Adding current motor control logic
    [motor_control_logic.xml]
2018-07-24 Adding updated y axis connecting rod mount
    [Assembly_Limit_Switch.SLDASM, Assembly_Limit_Switch_Alt.SLDASM, Assembly_Table.SLDASM, Assembly_X-Axis_Carriage.SLDASM, Assembly_X-Axis_Paddle.SLDASM, Assembly_Y-Axis_Connecting_Rod_Mount.SLDASM, X-Axis_Rod.SLDPRT, Y-Axis_Connecting_Rod_Bearing.SLDPRT]
2018-07-26 Adding IR sensor source files
2018-07-26 Adding goal light logic, temporarily disabling motors until new mounting brackets arrive
2018-07-31 fixed y-axis homing routine false-positive home switch presses
    [ir.c, ir.h, y_axis.c]
